juandiz/SCARMOV_1.0/docs/Imagenes/desarrollo/componentes/fsr.jpg

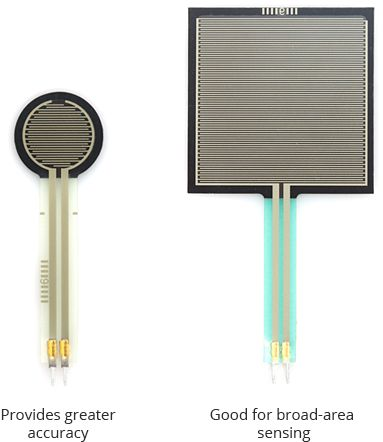
docs/Imagenes/desarrollo/componentes/fsr.jpg
