juandiz/SCARMOV_1.0/code/ArduinoControl_TFG/README.md

# SCARMOV
 Código del robot SCARA

 Este codigo ha sido redactado por: Juan Manuel Astorga Diz
 Es una adaptación a la plataforma de arduino del codigo escrito
 para un TFG anterior.

 La finalidad de este código es la de ser capaz de controlar el 
 robot SCARA a través de un socket que recibe paqueted UDP desde una GUI
 cliente que realiza los comandos de control con un paqute JSON.
