juandiz/SCARMOV_1.0/docs/Referencies/DC brushles motors.docx

DC brushles motors

https://www.youtube.com/watch?v=gNpoTPzEkco
