juandiz/SCARMOV_1.0/docs/Referencies/modelado.pdf

## Modelado de un motorDC

Félix Monasterio-Huelin & Alvaro Gutiérrez ´

29 de enero de 2021

## Índice

Índice | 1
Índice de Figuras | 2
1. Introduccion | 3
2. Modelado analítico de un motor DC | 3
2.2. Simplificación de las ecuaciones del Motor DC por el método de eliminación de la
2.3. Simplificación de las ecuaciones del Motor DC por el método de eliminación del polo
3. Modelado experimental de un motor DC | 9
3.2. Algoritmo para la obtención experimental del modelo simplificado (K, p) del motor . | 11
3.2.1. Primera Fase: Obtención del valor medio de velocidades angulares del régi-
3.2.4. Cuarta Fase: Identificación de la función no lineal del modelo del motor
3.4. Ejemplo de diseño de un controlador no lineal de posición angular de un motor DC
A. Etapa de potencia | 31
B. Tipos de PWM | 33
C. Modelo CVS de fricción de un motor DC | 36
D. Modelo de carga de un motor DC de un grado de libertad | 38
E. Obtención analítica del polo del motor con una entrada escalón bajo condiciones
iniciales nulas | 40
F. Obtención analítica del polo del motor con una entrada nula bajo condiciones iniciales
no nulas | 41
G. Obtención analítica del polo del motor con una señal de entrada cuadrada | 43

H. Discretización del polo del motor obtenido con una entrada escalón bajo condiciones
iniciales nulas | | 44
I. Discretización del polo del motor obtenido con una entrada nula bajo condiciones
iniciales no nulas | | 45
J. Discretización del polo del motor obtenido con una señal de entrada cuadrada | 46

## Índice de Figuras

2.1. MotorDC | | 3
2.2. Eje, Reductora y Carga del MotorDC | | 3
3.1. Esquema general para el modelado de un motor DC | | 9
3.2. Modelo no lineal de un motor DC | | 10
3.3. Sistema de control realimentado no lineal con controlador P-D | | 10
3.4. Modelo no lineal de motor DC | | 11
3.5. Número de pulsos en el eje de un motor DC real | | 11
3.6. Velocidad angular en el eje de un motor DC real | | 12
3.7. Velocidad angular en el eje de un motor DC real | | 20
3.8. Varianza y polo medio pSj en cada intervalo de tiempo | | 20
3.9. Valores de p y K obtenidos en las tres primeras fases | | 21
3.10. Respuestas del motor (explicación en el texto) | | 22
3.11. Polinomio de interpolación impar de grado (a) 17 y (b) 23 | | 22
3.12. Sistema de control realimentado no lineal con controlador proporcional | | | 23
3.13. Polinomio de interpolación (a) f

−1
y (b) f

−1
extendido | | 25
A.1. Puente en H | | 31
A.2. Zona Z
+ | 31
A.3. Zona Z
− | | 32
B.1. Ejemplo de señal PWM unipolar ideal | | 33
B.2. Ejemplo de señal PWM unipolar ideal | | 34
B.3. Ejemplo de señal PWM bipolar ideal | | 34
B.4. Secuencia lógica del puente en H con PWM bipolar ideal | | 35
C.1. Par de fricción dado por C.5 en función de ˙θm | | 36

## 1. Introduccion

El objetivo principal de este documento es obtener un modelo de un motor de corriente continua (motor DC) que sea útil para realizar el diseño e implementación de un sistema de control realimentado.
En la Sección 2 se describe el procedimiento para modelar un motor DC mediante las especificaciones del fabricante, en el caso en el que estén disponibles. Se estudian las ecuaciones electromecánicas de un motor DC hasta la obtención de su función de transferencia y su simplificación a un sistema dinámico de primer orden, y orden relativo la unidad. Al finalizar la sección, se mostrará un ejemplo de modelado de un motor DC comercial, a partir de las características que ofrece el fabricante.
En la Sección 3 se describe un procedimiento de modelado experimental de un motor DC, ya sea porque el fabricante no proporciona las especificaciones del motor, o porque se requiera comprobar el modelado analítico con respecto al funcionamiento en el laboratorio.
En el Apéndice A se hace una introducción a una etapa de potencia, basada en la técnica de Modulación de Anchura de Pulso (PWM, de sus siglas en inglés) (ver Apéndice B), necesaria para acondicionar la señal de control obtenida con un controlador digital a la señal de entrada física del motor DC.

## 2. Modelado analítico de un motor DC

### 2.1. Motor DC

En las Figuras 2.1 y 2.2 se representan esquemáticamente un motor DC, la Reductora y la Carga del motor.

Rm | Lm

Jm

Bm

um(t) | i(t) | eb(t)

θṁ(t)

τm(t)

Figura 2.1: MotorDC

Jm | Bm

r, η
JL
mL
τm | θṁ | τl

τL

θ˙L

Figura 2.2: Eje, Reductora y Carga del MotorDC

La ecuación eléctrica del motor tiene la forma,

um(t) = Rmi(t) + Lm

di(t)
dt + eb(t) | (2.1)

donde um(t) representa la tensión de entrada al motor, i(t) la corriente eléctrica del motor, eb(t) la fuerza contraelectromotriz, Rm la resistencia terminal y Lm la inductancia del rotor.
La ecuación mecánica del motor es

τm(t) = Jm

¨θm(t) + τl(t) + τf (t) | (2.2)

donde τm(t) representa el par motor, ¨θm(t) la aceleración angular del motor, Jm la inercia del rotor, τl(t) el par de la carga visto desde el eje del motor y τf (t) el par de fricción.
En el Apéndice C se presenta un modelo de fricción, que nos permite escribir la ecuación mecánica en la forma
τm(t) = Jm

¨θm(t) + Bm

˙θm(t) + τc(t) | (2.3)

donde ˙θm(t) es la velocidad angular del motor, Bm

˙θm(t) el par de fricción viscosa con Bm la constante de fricción viscosa (damping viscous constant),y τc(t) el par que incorpora la carga y la fricción, a excepción del par de fricción viscosa.
En lo que sigue consideraremos un motor DC que satisface las siguientes relaciones de acoplo electromecánico:

eb = kb

˙θm(t) | (2.4a)
τm = kmi(t) | (2.4b)

donde kb y km son constantes del motor, constante de la fuerza contraelectromotriz (back-EMF constant) y constante de par (torque constant) respectivamente. Cuando se expresan en el mismo sistema de unidades, kb = km.
Con estas ecuaciones y relaciones pueden obtenerse diversas funciones de transferencia del motor sin carga. Las más importantes son las que relacionan la velocidad angular ˙θm(t), la posición angular θm(t) y la corriente eléctrica i(t) con la tensión de entrada um(t). Las escribiremos como GΘ˙ m (s),
GΘm(s) y GI (s) respectivamente.
Para ello consideraremos las ecuaciones que solo incorporen la fricción viscosa,

um(t) = Rmi(t) + Lm

di(t)
dt + kb
˙θm(t) | (2.5a)

kmi(t) = Jm

¨θm(t) + Bm

˙θm(t) | (2.5b)

Puesto que ˙θm(t) = dθm(t) dt se cumple, bajo condiciones iniciales nulas, que

GΘ˙ m

(s) = sGΘm(s) | (2.6)

Aplicando la transformada de Laplace a las ecuaciones del motor bajo condiciones iniciales nulas, y eliminando la variable de la corriente eléctrica I(s) se obtiene la función de transferencia del motor:

GΘ˙ m

(s) = | km (Jms + Bm)(Lms + Rm) + kbkm
(2.7)

Se define la constante de velocidad del motor kn como la ganancia a bajas frecuencias del motor. Utilizando la expresión 2.8,

kn = GΘ˙ m

(0) = | km
BmRm + kbkm

(2.8)

No obstante, es habitual definir kn despreciando la constante de fricción viscosa, es decir, mediante

la relación kn =

1
kb

Para obtener GI (s) puede hacerse lo siguiente. Primero aplicar la Transformada de Laplace, bajo condiciones iniciales nulas, a la ecuación mecánica dada por 2.5b,

kmI(s) = (Jms + Bm)

˙θm(s) | (2.9)

donde ˙θm(s) = L−

{
˙θm(t)

}

Como ˙θm(s) = GΘ˙ m
(s)Um(s) e I(s) = GI (s)Um(s), se obtiene que
GI (s) = | Jms + Bm
(Jms + Bm)(Lms + Rm) + kbkm

(2.10)

A la corriente en régimen permanente, cuando la entrada al motor carga es la tensión nominal um(t) = UN (nominal voltage), se la denomina corriente del motor sin carga I0 (no-load current). Esta puede obtenerse aplicando el teorema del valor final a I(s) = GI (s)Um(s),

I0 = lim
s→0

sGI (s)

UN
s

= UN GI (0) = BmUN
BmRm + kbkm

(2.11)

Hay que tener en cuenta que se han despreciado todos los pares de fricción a excepción de la fricción viscosa, por lo que relación 2.11 es una expresión aproximada de I0.
Podemos comprobar que se cumple que

kmI0 = Bm

˙θmN | (2.12)

donde ˙θmN es la velocidad angular nominal del motor sin carga (no-load speed), que, normalmente, se escribe como n0. Este valor puede obtenerse aplicando el teorema del valor final a GΘ˙ m

(s)
dado por 2.8, cuando la entrada es la tensión nominal um(t) = UN ,

˙θmN = lim
s→0

sGΘ˙ m

(s)

UN
s

= UN GΘ˙ m

(0) = kmUN
BmRm + kbkm

(2.13)

Se denomina constante de tiempo eléctrica te (cuya unidad en el sistema internacional es de segundos s), a la siguiente relación:

te =

Lm
Rm

(2.14)

Esta relación se obtiene de eliminar el acoplo mecánico (kb = 0) en la ecuación eléctrica del motor dada por 2.5a. Entonces GI (s) dado por 2.10 tiene la forma 1
Lms + Rm

cuyo polo es −1/te.

Se denomina constante de tiempo mecánica tm, a la constante de tiempo obtenida suponiendo que la constante de tiempo eléctrica es despreciable, es decir, haciendo Lm = 0. Más adelante, en la subsección 2.2, se demuestra que queda definida por la siguiente expresión:

tm =

RmJm
RmBm + kbkm

(2.15)

Puede comprobarse que la función de transferencia de velocidad angular dada por 2.8 tiene dos polos reales (cuyas unidades en el sistema internacional son s

−1
) dados por la relación siguiente:

p1,2 = −

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
kmkb
JmLm

(2.16)

donde t

′
m =

Jm
Bm

, que algunos autores también denominan constante de tiempo mecánica, puesto que

se obtiene eliminando el acoplo eléctrico en las ecuaciones del motor. En este escrito se utilizará la definición dada por la relación 2.15 ya que es la que suelen utilizar los fabricantes.
Podemos entonces escribir la función de transferencia en la forma

GΘ˙ m

(s) = | K′ m
(s − p1)(s − p2)

(2.17)

donde p1 y p2 son los polos dados por la relación 2.16, y

K′ m = | km JmLm
(2.18)

Normalmente los motores DC cumplen que te ≪ tm, además de que p1 ≪ p2. Estos hechos sugieren dos métodos distintos de simplificación de las ecuaciones del motor: eliminar la constante de tiempo eléctrica te (dando lugar a la definición de constante de tiempo mecánica) (subsección 2.2) o eliminar el polo no dominante p1 (subsección 2.3). Los resultados serán distintos, aunque similares, pero ambos métodos reducen el orden de las funciones de transferencia del motor a la forma:

GΘ˙ m

(s) = K
s + p

(2.19)

donde K y p son constantes.
La ecuación diferencial simplificada que representa al motor será por lo tanto de segundo orden en θ(t) y de primer orden en ˙θ(t),

¨θm(t) + p

˙θm(t) = Kum(t) | (2.20)

Las constantes de tiempo eléctrica y mecánica definidas anteriormente son, aproximadamente la inversa de los polos exactos: te ≈ 1/|p1| y tm ≈ 1/|p2|, siendo p2 el polo dominante.
Por otro lado, siempre que se hace alguna simplificación de los modelos matemáticos debe impo-nerse la restricción de que la ganancia a bajas frecuencias coincida con la del modelo no simplificado, lo que permite calcular el parámetro K de la expresión 2.19.
Aplicando la transformada de Laplace inversa a la anterior función de transferencia 2.19, teniendo en cuenta condiciones iniciales nulas y una entrada escalón de amplitud A se obtiene la salida de velocidad angular del motor:
˙θm(t) = AK
p

(
1 − e

−pt)
, t ≥ 0 | (2.21)

Si las condiciones iniciales no son nulas sino [

˙θ(0−)], entonces para una entrada escalón de amplitud A,
˙θm(t) = AK
p

(
1 − e

−pt)
+ ˙θ(0−)e
−pt, t ≥ 0 | (2.22)

Si la entrada al motor es nula y las condiciones iniciales no son nulas se obtiene una salida que decae con el tiempo según la ecuación

˙θm(t) = ˙θ(0−)e

−pt, t ≥ 0 | (2.23)

La relación 2.23 permite obtener experimentalmente el polo dominante del motor. Y con este valor, puede obtenerse K experimentalmente a partir de la ecuación 2.21 o 2.22 si se conocen las condiciones iniciales.

### 2.2. Simplificación de las ecuaciones del Motor DC por el método de eliminación

de la constante eléctrica del motor

Las ecuaciones del motor DC pueden simplificarse teniendo en cuenta que la constante eléctrica del motor es mucho menor que la constante mecánica, lo que se traduce en despreciar el factor de la inductancia Lm en la ecuación eléctrica.
Siguiendo este método de simplificación la ecuación eléctrica dada por 2.5a quedaría en la forma:

um(t) = Rmi(t) + kb

˙θm(t) | (2.24)

Despejando la corriente eléctrica i(t) de la ecuación mecánica 2.5b y substituyendo en la ecuación anterior 2.24, se tiene

um(t) = RmJm
km

¨θm(t) + (
RmBm
km

+ kb

)
˙θm(t) | (2.25)

La ecuación del motor simplificada dada por 2.25 representa una ecuación diferencial de primer orden para la variable de velocidad angular y de segundo orden para la variable de posición angular. Aplicando la transformada de Laplace a esta ecuación se obtiene la función de transferencia de velocidad angular en relación a la entrada del motor:

GΘ˙ m

(s) = Θ˙ m(s)

Um(s)

=

km
RmJms + RmBm + kbkm

(2.26)

Podemos escribir la función de transferencia de velocidad angular en la forma siguiente:

GΘ˙ m

(s) = Km
s + pm

(2.27)

La ganancia a bajas frecuencias del motor es:

GΘ˙ m

(0) = | km RmBm + kbkm
(2.28)

Puede comprobarse que esta constante coincide con la del motor sin simplificar. Puede verse también que

Km = pmGΘ˙ m

(0) (2.29)

La función de transferencia del motor, simplificada por este método, tiene un polo de valor

s = −pm = −

RmBm + kbkm
| RmJm

= −

1
tm

(2.30)

donde tm es, por definición, la constante de tiempo mecánica.

### 2.3. Simplificación de las ecuaciones del Motor DC por el método de eliminación

del polo no dominante

La función de transferencia de velocidad angular del motor puede expresarse en la forma siguiente:

GΘ˙ m

(s) = | K′ m
(s + |p1|)(s + |p2|)

(2.31)

donde p1 y p2 son los polos dados por la relación 2.16. La ganancia a bajas frecuencias del motor es,

GΘ˙ m

(0) = K′
m
p1p2

(2.32)

Normalmente p1 ≪ p2 por lo que puede simplificarse el modelo matemático despreciando el polo no dominante. Siguiendo este método, la anterior función de transferencia quedará en la forma

GΘ˙ m

(s) = Km s + |p2|
(2.33)

Puesto que se debe cumplir la restricción de ganancia a bajas frecuencias,

Km = |p2|GΘ˙ m

(0) = K′
m
|p1|

(2.34)

Teniendo en cuenta la relación 2.18 se cumple que,
Km = | km
JmLm|p1|

(2.35)

El polo de la función de transferencia de velocidad angular simplificada por este método será, por diseño, el polo dominante −p2.

### 2.4. Estimación del coeficiente de fricción viscosa Bm

Los fabricantes no suelen dar la constante de fricción viscosa Bm, pero sí otras características que permiten estimarla.
Esto puede hacerse de dos formas, según se disponga de una u otra información,
1. Utilizando la ecuación de la constante de tiempo mecánica, tm, dada por 2.15,

Bm =

Jm
tm

−

| kbkm
Rm

(2.36)

2. Utilizando la ecuación de la corriente del motor sin carga, I0, dada por 2.12,
Bm = | kmI0 ˙θmN
(2.37)

Ambos métodos son aproximados, ya que en el estudio teórico solo se ha tenido en cuenta, del par de fricción, la fricción viscosa.

### 2.5. Ejemplo de modelado analítico de un motor DC

La Tabla 2.1 recoge las características de un motor comercial¹

Parámetro | Valor | Unidades
UN | 12 | V
Rm | 5, 3 | Ω
Lm | 580 | µH
Jm | 14 | g cm²
tm | 15 | ms
kb | 2, 3 | mV /rpm
km | 22 | mNm/A
I0 | 0,05 | A
n0 | 5100 | rpm

Tabla 2.1: Características del fabricante.

Con esta información puede calcularse la constante eléctrica del motor te utilizando la relación 2.14, obteniendo te = 109, 43µs. Como vemos te ≪ tm .
Será necesario expresar todos estos parámetros en las mismas unidades. Utilizaremos el SI de unidades como se muestra en la Tabla 2.2.
Parámetro | Valor | Unidades
Rm | 5, 3 | Ω
Lm | 5, 8 × 10−4 | H
Jm | 1, 4 × 10−6 | kg m²
tm | 1, 5 × 10−2 | s
te | 1, 1 × 10−4 | s
kb | 2, 2 × 10−2 | V s/rad
km | 2, 2 × 10−2 | Nm/A
I0 | 0,05 | A
n0 | 534,071 | rad/s

Tabla 2.2: Características de un motor DC en el Sistema Internacional de unidades.

Podemos observar que las constantes del par y de la fuerza contraelectromotriz coinciden, km = kb, cuando se expresan en el mismo sistema de unidades.
Puede ahora estimarse el coeficiente de fricción viscosa, Bm, con cualquiera de los métodos descritos en la Sección 2.4. Con el método de la constante de tiempo mecánica se obtiene el valor Bm = 2, 01×10−6 Nms, y con el método de la corriente del motor sin carga Bm = 2,06×10−6Nms. Puede comprobarse con las expresión 2.16, que los polos del motor, utilizando el valor de Bm obtenido por el método de la corriente del motor sin carga, son

p1 = −9025
p2 = −67, 53

El polo dominante es p2 que además cumple que |p2| ≪ |p1|.
Calculando Km con la expresión dada por 2.18, el modelo del motor con los dos polos tiene la forma

GΘ˙ m

(s) = | 27093596, 06
(s + 9025)(s + 67, 53) | (2.38)

Utilizando el método de simplificación de eliminación de la constante eléctrica del motor, se obtiene pm = −66, 67 utilizando la expresión 1/tm dada en 2.30.

1Se trata del motor 2842 − 012C de Minimotor.

Ambos modelos simplificados deberán cumplir la condición de que la ganancia a bajas frecuencias sea la misma. En ambos casos se obtendrá un modelo de la forma

GΘ˙ m

(s) = Km
s + pm

(2.39)

1. Modelo simplificado del motor por el método de eliminación de la constante de tiempo eléctrica.

GΘ˙ m

(s) = 2963, 8
s + 66, 67

(2.40)

2. Modelo simplificado del motor por el método de eliminación del polo no dominante.

GΘ˙ m

(s) = 3002, 1
s + 67, 53

(2.41)

## 3. Modelado experimental de un motor DC

### 3.1. Introducción al modelado experimental de un motor DC

Los motores DC suelen tener un comportamiento lineal en un rango predefinido de tensiones de entrada. Sin embargo, a bajas velocidades angulares la fricción produce no linealidades, además de que el motor sufre perturbaciones a su entrada y ruido a su salida, normalmente debidas, las primeras al efecto de la carga y la segunda al ruido en la medida de los sensores. También sufre el motor variaciones no lineales cuando se utiliza de forma continua, debido a efectos térmicos produciendo variaciones en la resistencia de la bobina. A tensiones elevadas puede haber una desmagnetización del hierro, lo que supone variaciones en las constantes del motor.
Por otro lado, si se realiza un control digital aparecen errores debidos a la longitud de palabra finita, es decir, errores en los conversores A/D (sensor de posición angular, por ejemplo) y errores numéricos en el cálculo de las señales de control. Además, la conversión D/A de la señal de control y de la señal continua de entrada al motor nunca puede ser una reconstrucción exacta de una señal muestreada, ya que requeriría un filtro paso bajo ideal, el cual no es realizable físicamente. Y por último, la etapa de potencia, es decir, la electrónica que acondiciona la señal de baja potencia de un microcontrolador a la potencia eléctrica del motor, suele añadir ruido a su salida. Si se utiliza como etapa de potencia un puente en H para la generación de una señal PWM puede ocurrir que la tensión de referencia no sea suficientemente estable, debido al conversor AC/DC. Como consecuencia,la tensión de entrada al motor no sería la deseada, sino que estaría afectada por un ruido difícil de modelar.
µC | D/A | ZOH | PWM | Motor DC | Encoder
V (t) | θṁ(t) | Nm(tk)

Figura 3.1: Esquema general para el modelado de un motor DC

Todos estos factores hacen difícil un modelado exacto de un motor DC. En lo que sigue llamaremos modelado del motor a lo que realmente sería un modelado del motor que incluya toda la electrónica que será utilizada en un sistema de control realimentado. En la Figura 3.1 se muestra un esquema de bloques con los elementos fundamentales de actuación de un motor DC. En ella, Nm(tk) representa el número de pulsos medido en el instante de tiempo tk en el eje del motor, que permitiría obtener la posición angular en radianes,

θm(tk) = 2πNm(tk)
q

(3.1)

donde q es el número de pulsos por vuelta (CPR, Cycles Per Revolution) del encoder incremental.

En esta sección se simplifica enormemente el problema de modelado. En primer lugar, se im-pondrá que el modelo matemático deseado se corresponda con el de un sistema lineal de primer orden en velocidad angular, de tal manera que el objetivo se reduzca a estimar dos parámetros del motor, K y p, donde K/p sea la ganancia a bajas frecuencias y p represente el único polo de un sistema de primer orden.
Para ello se harán medidas experimentales de la salida del motor Nj , para diferentes tensiones de entrada Vj , y en dos situaciones distintas: bajo condiciones iniciales nulas y bajo condiciones iniciales no nulas. La primera de ellas utilizando una señal de entrada escalón y la segunda con una señal nula a la entrada.
En los Apéndices E y F se realiza un estudio teórico para ambas situaciones y en los Apéndices H y I, se obtiene una discretización aproximada del polo, suponiendo que las señales de entrada al motor se generan mediante un microcontrolador y que la salida de posición angular se mide con un encoder incremental situado en el eje del motor. Estos estudios tienen como finalidad obtener expresiones del polo p reduciendo al mínimo los errores numéricos debidos a la longitud de palabra finita de un microcontrolador.
En la Sección 3.2 se propone un algoritmo de modelado sencillo, que da lugar al modelo lineal deseado junto con un elemento no lineal de ajuste de la señal de entrada. Este elemento no lineal puede no estar presente en el resultado del modelado si el motor se comporta de manera suficientemente lineal. Pero esto no siempre es así, como se verá en la Sección 3.3 con un ejemplo sobre un motor real.

f

K
s + p
V (t) | Veq(t) | θṁ(t)

Figura 3.2: Modelo no lineal de un motor DC

En la Figura 3.2 se muestra el esquema de bloques del modelo no lineal, donde V (t) representa la señal de entrada al motor, y Veq(t) la señal de entrada a la parte lineal del motor, de tal manera que Veq(t) = f(V (t)) siendo f la función no lineal resultante del modelado. En el algoritmo que se propone se identifica esta función no lineal f como un polinomio en V (t) realizando una interpolación polinómica de las medidas experimentales realizadas.
La idea del algoritmo de modelado es que permita diseñar controladores lineales suponiendo que el motor es lineal, y que se comporta como un sistema de primer orden en velocidad angular. Una vez hecho el diseño del controlador lineal, se implementaría introduciendo la corrección no lineal de la señal de control generada por el controlador.

+

⁻ | KP | f⁻¹ | f

K
s(s + p)
r(t) | e(t) | u(t) | ue(t) | u(t) | y(t)

Figura 3.3: Sistema de control realimentado no lineal con controlador P-D

En la Figura 3.3 se muestra un sistema de control realimentado no lineal con un controlador P-D de posición angular del motor (y(t) = θm(t)). La parte no lineal del controlador es la inversa de la parte no lineal del motor de tal manera que, si la cancelación es exacta, el motor se comporte como si fuese lineal. O dicho de otra forma, se ha linealizado el motor mediante la función inversa de la no linealidad del motor. En la Sección 3.4 se explica cómo obtener f

−1
, que satisfaga que
ue(t) = f

−1
(u(t)), y donde u(t) = Veq(t) y ue(t) = V (t), de acuerdo con la notación de la Figura 3.2.

### 3.2. Algoritmo para la obtención experimental del modelo simplificado (K, p) del

motor

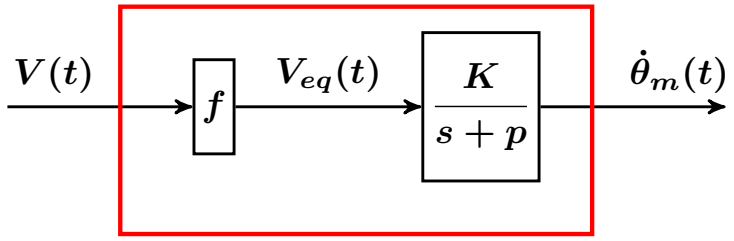
[picture p29: figure]
Veq(t)

Figura 3.4: Modelo no lineal de motor DC

Se propone, en esta Sección, un algoritmo para la obtención experimental del modelo simplificado de un motor. El objetivo es obtener los parámetros únicos (p, K) de la parte lineal del modelo, y la función no lineal f, como se muestra en la Figura 3.4.
En primer lugar, debe realizarse un conjunto de P ∗ Q experimentos: P repeticiones de Q experimentos con valores de entrada un escalón de diferente amplitud.
Las P repeticiones pueden realizarse como un único experimento con una señal de entrada cuadrada periódica, con un periodo cuya duración sea suficientemente larga como para que se haya alcanzado la velocidad angular de régimen permanente.

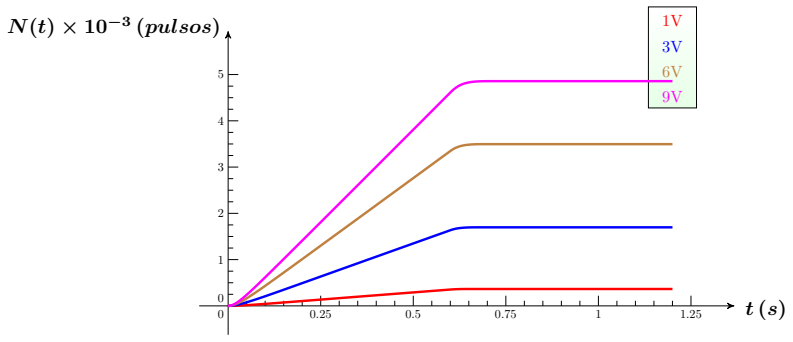
[picture p30: figure]
(pulsos)

Figura 3.5: Número de pulsos en el eje de un motor DC real

Lo primero que puede hacerse es obtener una única respuesta al escalón de amplitud Vj con j = 1, 2, · · · , Q, promediando, en cada instante de tiempo, las P repeticiones para cada Vj . De esta manera se realizaría un primer filtrado paso bajo de la respuesta del motor a una entrada cuadrada, suavizando el comportamiento del motor. Para poder hacer este promedio temporal se está suponiendo que todos los experimentos se han realizado con un periodo de muestreo idéntico. En la Figura 3.5 se muestran las curvas del número de pulsos Nj (t) promediadas de un motor DC real de P = 10 repeticiones, para cuatro valores distintos de tensión de entrada expresados en voltios, V ∈ {1, 3, 6, 9}, obtenidos con un encoder cuya resolución es q = 12, es decir, que tiene una precisión de ±30o
, y con un periodo de muestreo T = 1ms. La señal cuadrada está formada por un escalón de amplitud Vj y de duración 0,6s, y una bajada de duración 0,6s que comienza tras finalizar el escalón de subida.

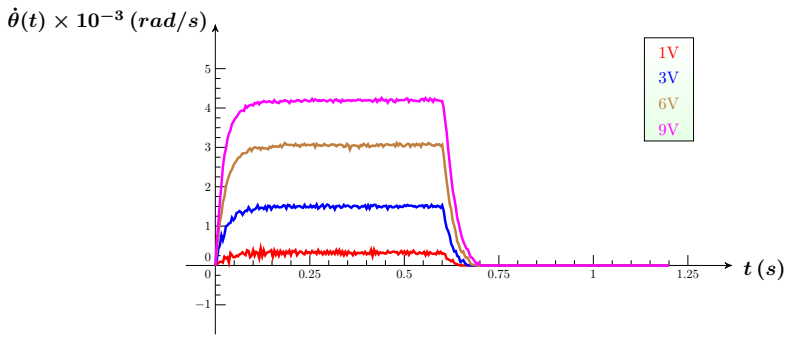
[picture p31: figure]
(rad/s)

Figura 3.6: Velocidad angular en el eje de un motor DC real

En la Figura 3.6 se muestran las curvas de velocidad angular ˙θj (t) promediadas de un motor DC real para los cuatro valores de tensión de entrada de la Figura 3.5. La velocidad angular se ha obtenido utilizando la primera aproximación de Euler de la derivada,

˙θj (tk) = 2π (Nj (tk) − Nj (tk−1)) qT

(3.2)

donde q es el número de pulsos por vuelta (CPR, Cycles Per Revolution) de un encoder incremental, T es el periodo de muestreo expresado en segundos, y Nj (tk) es el número de pulsos obtenidos con el encoder. Puesto que las condiciones iniciales de cada una de las P repeticiones han sido nulas, ˙θj (0) = 0.
Hecho esto, se tendrán Q ficheros de datos asociados a un conjunto de valores de entrada,
V ∈ {V1, V2, · · · , VQ} | (3.3)

El algoritmo que se propone consta de cuatro fases que se describen detalladamente en las siguientes subsecciones:

Primera Fase. Obtención del valor medio de velocidades angulares del régimen permanente.

En la Subsección 3.2.1 se calcula, con los datos experimentales, un conjunto de valores medios de velocidad angular,
{
˙θ1(∞),

˙θ2(∞), · · · ,

˙θQ(∞)

}
(3.4)

Segunda Fase. Cálculo del polo medio de varianza mínima.

En la Subsección 3.2.2 se calcula, con los datos experimentales, un conjunto de valores medios de los polos,
{p1, p2, · · · , pQ} | (3.5)

Tercera Fase. Cálculo de K y de la tensión de entrada equivalente.

En la Subsección 3.2.3 se calcula el conjunto de valores Kj a partir de los vectores 3.4 y 3.5,

{K1, K2, · · · , KQ} | (3.6)

Puesto que lo que interesa es obtener un modelo del motor cuya parte lineal tenga los parámetros (K, p) únicos, es necesario obtener la tensión de entrada equivalente que satisfaga las relaciones de proporcionalidad de la ganancia a bajas frecuencias,

˙θj (∞)

Veq,j

=

˙θk(∞)

Veq,k

(3.7)

para cualquier j, k ∈ {1, 2, · · · , Q}.

En la Figura 3.6 puede apreciarse a simple vista que la proporción entre velocidades angulares del régimen permanente y tensiones no es exacta. Esto significa que el motor DC no se comporta de manera lineal en cuanto a la ganancia a bajas frecuencias K/p.

Se obtendría en esta fase un vector de tensiones de entrada equivalentes,

{Veq,1, Veq,2, · · · , Veq,Q} | (3.8)

En la Subsección 3.2.3 se obtiene una expresión de K/p utilizando la técnica de optimización del error cuadrático, donde el error viene dado por ej = Veq,j − Vj . A partir de este valor se propone una fórmula para el cálculo del polo único p, y del valor único de K.

Cuarta Fase. Identificación de la función no lineal del modelo del motor mediante la técnica de interpolación polinómica.

En la Subsección 3.2.4 se obtiene la parte no lineal f del modelo del motor DC, de tal manera que tenga la siguiente forma polinómica,

Veq(t) = a1V (t) + a3V

3
(t) + · · · + a2Q−1V

2Q−1
(t) (3.9)
3.2.1. Primera Fase: Obtención del valor medio de velocidades angulares del régimen permanente

Sobre el experimento promedio se obtendría un valor medio de las últimas muestras de las que pueda garantizarse que el motor se encuentra en su régimen permanente.
Si se supone que la discretización del tiempo es uniforme, T, y el escalón del experimento promedio tuviese una duración Tf = (Nf − 1)T, se escogerían los valores de las últimas N muestras. Esta media sería ˙θ(∞),

˙θ(∞) =

∑

N

i=1

˙θNf −N+i

N

(3.10)

Por lo tanto, en esta Primera Fase deberá seleccionarse un valor de N adecuado.
Esto mismo se haría para los Q valores de la entrada escalón V ∈ {V1, V2, · · · , VQ}. Se obtendrá entonces, un conjunto de valores medios de velocidad angular,
{
˙θ1(∞),

˙θ2(∞), · · · ,

˙θQ(∞)

}
(3.11)

Si el motor se comportase linealmente, los valores ˙θj (∞), con j = 1, 2, · · · , Q, serían proporcio-nales, en el sentido de que
˙θj (∞)
˙θk(∞)

=

Vj
Vk

(3.12)

para cualquier j, k ∈ {1, 2, · · · , Q}.

### 3.2.2. Segunda Fase: Cálculo del polo medio de varianza mínima

Mientras que para el cálculo de ˙θ(∞) se utilizan los valores finales de respuesta del motor a una entrada escalón, para el cálculo del polo deberá estudiarse el comportamiento del motor en el régimen transitorio.

Esta fase se realiza para cada uno de los Q experimentos utilizando el valor ˙θj (∞) obtenido en la Primera Fase. De esta forma se obtiene un vector de Q polos,

{p1, p2, · · · , pQ} | (3.13)

La expresión del polo que puede utilizarse para el transitorio de subida de una señal cuadrada es la expresión dada por H.3 obtenida en el Apéndice H bajo condiciones iniciales nulas,

pSj (k) = Nj (k) − Nj (k − 1)

T

(
q

˙θj (∞)

2π

kT − Nj (k)

) | (3.14)

donde Nj (k) representa el número de pulsos medido en el instante de tiempo tk = kT en el eje del motor y q es el número de pulsos por vuelta (CPR, Cycles Per Revolution) del encoder incremental. El estudio de todo el régimen transitorio del tramo de subida conduciría a errores debido a que el comportamiento del motor a bajas velocidades está muy condicionado por los pares de fricción que no se están considerando en el modelo matemático. Por lo tanto, debe descubrirse el intervalo de tiempo que permita obtener un valor del polo que más se ajuste a los datos experimentales.
El método que se propone para el tramo de subida utilizando la expresión 3.14, es calcular el polo medio para un conjunto de intervalos de tiempo [tI , tF ], cuyo instante inicial tI y anchura tF − tI sean variables, y elegir el valor del polo medio cuya varianza sea la menor de las varianzas de cada intervalo seleccionado. De esta manera se obtendría pSj . Posteriormente se indica un método sencillo para la creación de los intervalos.
Por otro lado, la expresión del polo que puede utilizarse para el transitorio de bajada de una señal cuadrada es la dada por la expresión de valores extremos J.6 del Apéndice J,

pBj =

q

˙θj (∞)

2π
Nj (kf ) − Nj (k0)

(3.15)

donde kfT es cualquier instante de tiempo en el cual el motor se encuentra parado.
También puede utilizarse la expresión dada por I.2 obtenida en el Apéndice I bajo condiciones iniciales no nulas, aunque es más complicada que la de valores extremos. Sin embargo, la utilización de la expresión J.1 del Apéndice J es problemática, debido a que exige que ˙θj (∞)t0 = θ(∞), lo cual puede no ocurrir en un estudio experimental, dando lugar a errores innecesarios.
Una vez calculados pSj y pBj se obtendrá un único valor pj como una combinación lineal de los anteriores,
pj = α pSj + (1 − α)pBj | (3.16)

donde α ∈ [0, 1].

Creación de intervalos El método que se propone para el tramo de subida utilizando la expresión 3.14, es calcular el polo medio para un conjunto de intervalos de tiempo,

[tI , tF ] | (3.17)

cuyo instante inicial tI y anchura tF −tI sean variables, y elegir el valor del polo medio cuya varianza sea la menor de las varianzas de cada intervalo seleccionado.
Para que este método tenga sentido debe elegirse una anchura de intervalo mínima ∆t, es decir que tF ≥ tI + ∆t.
Una forma sencilla de crear los intervalos consiste en elegir cuatro valores, tI mínimo y máximo y tF mínimo y máximo. Es decir,
tI ∈ [tIm, tIM ] | (3.18a)
tF ∈ [tFm, tFM ] | (3.18b)

Si se supone que la discretización del tiempo es uniforme, el algoritmo puede programarse utilizando dos bucles para la creación del intervalo [tI , tF ], y otro bucle más para el cálculo del polo medio y de la varianza asociada a este intervalo. Conviene, en este caso, expresar los intervalos en función de un índice temporal tal que t = kT, entonces el intervalo será [kI , kF ].
Una posible selección de kFM puede ser asignándole el valor Nr = Nf −N utilizado en la Primera Fase para calcular ˙θ(∞). Puede reducirse el número de intervalos que se inspeccionarán si se hace la siguiente elección:
kIM = Nr − n∆k | (3.19a)
kFm = kI + ∆k | (3.19b)
kFM = kI + n∆k | (3.19c)

donde n es un número entero positivo y kI ∈ {kIm, kIm + 1, · · · , kIM }. El número de intervalos inspeccionados será

NInterv = ((n − 1)∆k + 1) (Nr − kIm − n∆k + 1) | (3.20)

Esta expresión se obtiene del siguiente razonamiento. El primer bucle, el de kI , tiene una longitud fija NI y el segundo bucle, el de kF , tiene una longitud fija NF dados por,

NI = kIM − kIm + 1 = Nr − kIm − n∆k + 1 | (3.21a)
NF = kFM − kFm + 1 = (n − 1)∆k + 1 | (3.21b)

Por lo tanto NInterv =

∑

NI

i=1

NF . Teniendo en cuenta que ∑

NI

i=1

1 = NI se obtiene la expresión 3.20.

Por otro lado, una vez concluido el proceso de optimización, se tendrá un vector de polos medios y varianzas para cada intervalo y se buscará el valor mínimo. Puede interesar conocer el intervalo óptimo o intervalo de varianza mínima. Si este intervalo ocupa la posición q-ésima en el vector de varianzas, el intervalo óptimo será [kI (q), kF (q)],

kI (q) = kIm + NI (q) − 1 | (3.22a)

kF (q) = kI (q) + ∆k − 2 + q −

NI∑

(q)−1

i=1

NF | (3.22b)

donde el valor de NI (q) debe cumplir la condición de que

NI∑

(q)−1

i=1

NF < q ≤

N

∑I (q)

i=1

NF | (3.23)

Puesto que

N

∑I (q)

i=1

NF = ((n − 1)∆k + 1) NI (q) y

NI∑

(q)−1

i=1

NF = ((n − 1)∆k + 1) (NI (q) − 1),

entonces

NI (q) − 1 <

q
(n − 1)∆k + 1
≤ NI (q) | (3.24)

Teniendo en cuenta que NI (q) debe ser un número entero positivo, se deberá cumplir que NI (q) = ⌈(
q

(n − 1)∆k + 1)⌉

(3.25)

donde ⌈x⌉ es la función techo de x, es decir, el primer número entero mayor o igual que x.

### 3.2.3. Tercera Fase: cálculo de K y de la tensión de entrada equivalente

El cálculo de K para cada experimento se realiza con la fórmula

Kj =

pj

˙θj (∞)

Vj

j ∈ {1, 2, · · · , Q} | (3.26)

obteniendo el vector
{K1, K2, · · · , KQ} | (3.27)

El problema que surge con (Kj , pj ) es que existiría un modelo de motor para cada entrada al motor.
El objetivo de esta fase es obtener un único modelo lineal junto con una corrección no lineal de la entrada al motor, de tal forma que se conserven las proporciones dadas por 3.12.
Para ello se selecciona, en primer lugar, un polo común a cualquier entrada al motor. Sea p este polo, entonces,

Kej =

p

˙θj (∞)

Vj

j ∈ {1, 2, · · · , Q} | (3.28)

Los valores de Kej serán, en general, distintos para cada j, obteniéndose un vector
{
Ke1, Ke2, · · · , KeQ

}
| (3.29)

A partir de este vector puede obtenerse un valor K común a todas las entradas. La consecuencia es que aparecerá una discrepancia en el valor de ˙θj (∞), si el comportamiento del motor no fuese suficientemente lineal,

˙θj (∞) ̸=

KVj
p
j ∈ {1, 2, · · · , Q} | (3.30)

Para corregir esta discrepancia es suficiente obtener una entrada equivalente de valor

Veq,j =

KejVj

K

j ∈ {1, 2, · · · , Q} | (3.31)

y por lo tanto un vector

{Veq,1, Veq,2, · · · , Veq,Q} | (3.32)

Entonces
˙θj (∞)

Veq,j

=

K
p
j ∈ {1, 2, · · · , Q} | (3.33)

Con esta nueva entrada Veq,j se conservarían las proporciones dadas por 3.12 para el mismo valor de p y K. Sustituyendo 3.26 y 3.28 en 3.31, Veq,j puede escribirse en la forma,

Veq,j =

KjVj
pj

p
K

(3.34)

Posteriormente se propone un método de optimización para el cálculo de K y p.
Con esta idea puede hacerse un diseño de controladores lineales suponiendo que el modelo del motor es (K, p). Y una vez implementado el controlador, la señal de control u(t) = Veq(t) generada por el controlador deberá ser corregida a la señal de entrada al motor ue(t) = V (t).
En la Cuarta Fase final del algoritmo se obtendrá una única función f tal que Veq(t) = f(V (t)) que satisfaga la condición de que Veq,j = f(Vj ) para todo j ∈ {1, 2, · · · , Q}. En la Sección 3.4, se detalla cómo obtener la relación no lineal u(t) versus ue(t). Concretamente, se obtiene la función inversa de f, es decir, ue(t) = f
(u(t)).

Propuesta para la estimación de los parámetros p y K del motor supuestos en la Tercera Fase En la Tercera Fase se ha supuesto la elección de p y K únicos, pero no se ha dicho cómo hacerlo. Un cálculo óptimo sería aquél para el cual las tensiones equivalentes Veq,j se encuentren lo más cerca posible de las tensiones Vj , ya que de esta forma la influencia de la parte no lineal sería mínima.
Por lo tanto, debe minimizarse el error ej = Veq,j − Vj para todo j ∈ {1, 2, · · · , Q},

ej =

KjVj
pj

p
K

− Vj =

(
Kj
pj

p
K

− 1

)
Vj | (3.35)

Este error será mínimo si es mínima la diferencia entre ganancias a bajas frecuencias.
Una solución a este problema de optimización consiste en minimizar el error cuadrático, definido como

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
(3.36)

Escribiremos ej en la forma siguiente,

ej = αj

p
K
− Vj | (3.37)

donde

αj =

KjVj
pj
= ˙θj (∞) | (3.38)

Derivando J con respecto a p/K, se obtiene

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
− Vj

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
αjVj | (3.39)

Igualando a cero esta derivada, despejando K/p y teniendo en cuenta que αj = ˙θj (∞), se obtiene la expresión,

K
p

=

∑

Q

j=1

(
˙θj (∞)

)2
∑

Q

j=1

˙θj (∞)Vj

=

∑

Q

j=1

˙θj (∞)Vj

Kj
pj
∑

Q

j=1

˙θj (∞)Vj

(3.40)

Se propone calcular 1/p suponiendo que el motor es lineal, es decir, haciendo Kj = K en la relación dada por 3.40, por lo que se obtiene la siguiente expresión:

1
p

=

∑

Q

j=1

˙θj (∞)Vj

1
pj
∑

Q

j=1

˙θj (∞)Vj

(3.41)

De esta manera K quedaría en la forma

K =

∑

Q

j=1

(
˙θj (∞)

)2
∑

Q

j=1

˙θj (∞)Vj

pj

=

∑

Q

j=1

˙θj (∞)Vj

pj

Kj
∑

Q

j=1

˙θj (∞)Vj

pj

(3.42)

que también se puede escribir como,

1
K

=

∑

Q

j=1

(
˙θj (∞)

)2 1

Kj
∑

Q

j=1

(
˙θj (∞)

)2

(3.43)

Como puede observarse, los valores de K o 1/K, 1/p y K/p son medias ponderadas de los vectores {Kj} o {1/Kj}, {1/pj} y {Kj/pj} respectivamente. El valor de K o de p puede obtenerse de cualquier otra forma a partir del vector {Kj} o {pj} respectivamente, dando resultados similares. No haremos aquí un estudio que permita optimizar esta selección de K o p.

3.2.4. Cuarta Fase: Identificación de la función no lineal del modelo del motor mediante la técnica de interpolación polinómica

La parte no lineal del modelo del motor será una función no lineal, f, tal que

Veq(t) = f(V (t)) | (3.44)

Aquí se propone que la función no lineal f sea un polinomio de grado N = 2Q,

f(x) = a1x + a2x

2 + · · · + aN x

N | (3.45)

donde ai con i = 1, 2, · · · , N, son N constantes del modelo que deben ser identificadas.
Si la no linealidad del motor es independiente del signo de su entrada, el polinomio f(x) será simétrico con respecto al origen, es decir, que f(−x) = −f(x). Este hecho permite reducir el grado del polinomio a N − 1, y el número de coeficientes a N/2, de tal manera que el polinomio tendría la forma,

f(x) = a1x + a3x

3 + a5x

5 + · · · + a2Q−1x | 2Q−1 (3.46)

Para la identificación de los parámetros constantes ai

, se utilizarán los Q experimentos realizados, de tal manera que se cumpla la relación dada por 3.33 para cada uno de ellos. Es decir, que f(Vj ) = Veq,j para todo j ∈ {1, 2, · · · , Q}, o lo que es lo mismo, se va a aplicar un método de interpolación polinómica. Por lo tanto se obtendrían Q ecuaciones lineales con N = 2Q incógnitas,

Veq,j = a1Vj + a2V

2
j + · · · + aN V
N j | (3.47)

Si se impone la condición de simetría, se tendrían otras Q ecuaciones lineales de la forma,

−Veq,j = −a1Vj + a2V

2
j − a3V

3
j + · · · − aN−1V

N−1
j | + aN V N
| j (3.48)

De esta manera, se tendrían 2Q ecuaciones lineales con 2Q incógnitas. Este sistema de ecuaciones lineales puede representarse en forma matricial, donde la matriz de la relación es una matriz de Vandermonde, por lo que es invertible.
No obstante, puede demostrarse que debido a la simetría en el origen, este sistema de ecuaciones lineales puede reducirse a otro de Q ecuaciones lineales con Q incógnitas, donde el polinomio resultante sería de grado 2Q − 1, con la forma dada por 3.46. La demostración es sencilla, ya que si se suman para cada j las ecuaciones 3.47 y 3.48, se obtendría un sistema de ecuaciones lineales de coeficientes pares igualados a cero, y puesto que los coeficientes ai deben ser únicos, la única solución posible es que sean nulos, es decir, a2 = a4 = · · · = a2Q = 0.
Ahora, restando las ecuaciones 3.47 y 3.48 y dividiendo por dos, se obtendría un sistema de Q ecuaciones lineales con Q incógnitas,

Veq,j = a1Vj + a3V

j + · · · + a2Q−1V

2Q−1 j | (3.49)

Este sistema de ecuaciones puede ser representado en forma matricial

Veq = Va | (3.50)

donde

Veq =

Veq,1

Veq,2

Veq,Q

(3.51a)

a =

a1
a3

a2Q−1

(3.51b)

V =

V1 V

3
1
- · · V

2Q−1
1
V2 V

3
2
- · · V

2Q−1
2
VQ V

3
Q · · · V

2Q−1
Q

(3.51c)

El vector de parámetros a se obtendría invirtiendo la matriz V,

a = V

−1Veq | (3.52)

Teniendo en cuenta la expresión de Veq,j dada por 3.31, se obtiene el valor de Kej ,

Kej = K

(
a1 + a3V

2
j + · · · + a2Q−1V

2Q−2
j

)
(3.53)

Esta expresión indica claramente que el valor de K del motor depende de la entrada Vj si el comportamiento del motor no es suficientemente lineal. Podemos definir, entonces, un valor de Keq(t), de la siguiente forma,

Keq(t) = K

(
a1 + a3V

2
(t) + · · · + a2Q−1V

2Q−2
(t)

)
(3.54)

cumpliéndose que
Veq(t) = Keq(t)
K
V (t) | (3.55)

El problema de utilizar esta técnica de interpolación es que se produce el llamado fenómeno de Runge, que consiste en que para valores elevados de Q el polinomio puede oscilar mucho entre puntos de datos consecutivos. En la práctica conviene evitar este problema utilizando otras técnicas de interpolación, como por ejemplo, obteniendo polinomios por partes (curvas “spline”).

### 3.3. Ejemplo de modelado experimental de un motor DC

En esta Sección se obtiene el modelo de un motor real aplicando el algoritmo detallado en la Sección 3.2.
Los experimentos realizados han consistido en la obtención del número de pulsos proporcionado por un encoder situado en el eje del motor de q = 12 pulsos/vuelta, cuando la entrada es una señal cuadrada periódica de P = 10 y Q = 9 experimentos. La duración del escalón de subida de tensión Vj con j = 1, · · · , Q, ha sido de 0,6s y la del escalón nulo también de 0,6s. El periodo de muestreo ha sido de T = 1ms.
Las tensiones de entrada Vj voltios han sido las siguientes:
V ∈ {1, 2, 3, 4, 5, 6, 7, 8, 9} | (3.56)

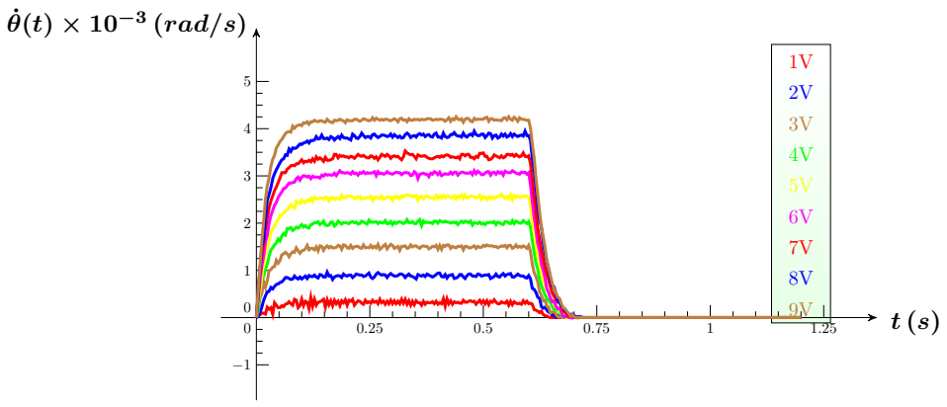
[picture p32: figure]
(rad/s)

Figura 3.7: Velocidad angular en el eje de un motor DC real

En primer lugar se ha obtenido el promedio temporal de los P experimentos, obteniendo Q ficheros de datos. En la Figura 3.7 se muestran las curvas de velocidad angular ˙θj (tk) con tk ∈ {0, 10−3

, · · · , 1200 × 10−3}, calculados a partir de los datos medidos promediados utilizando la expresión 3.2.
Para el cálculo de la velocidad angular en régimen permanente, ˙θj (∞) se ha aplicado la fórmula dada por 3.10, donde Nf = 601 y N = 200 que se corresponde con tf = 0,6s y tr = 0,4s (Nr = Nf − N = 401). Es decir, se ha calculado el valor medio de los últimos 0,2s del escalón. Para el cálculo de pSj en el transitorio de subida se ha utilizado la fórmula dada por 3.14 con intervalos variables, como se describe en la Subsección 3.2.2, con kIm = 2 (tIm = 0,001s), ∆k = 60 y n = 2. Se ha escogido el valor pSj del intervalo de varianza mínima.

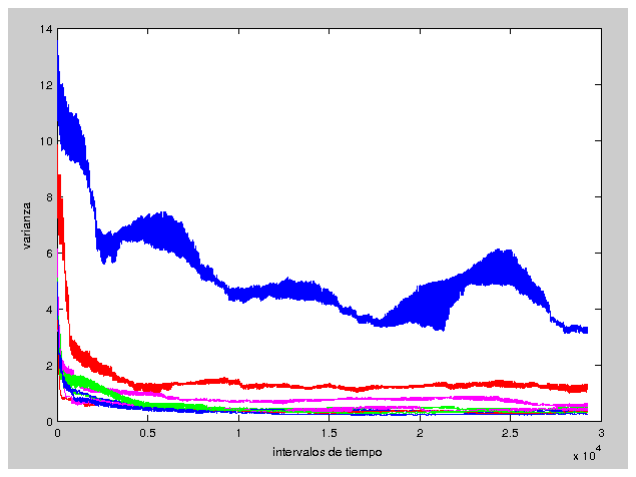
[picture p33: figure]
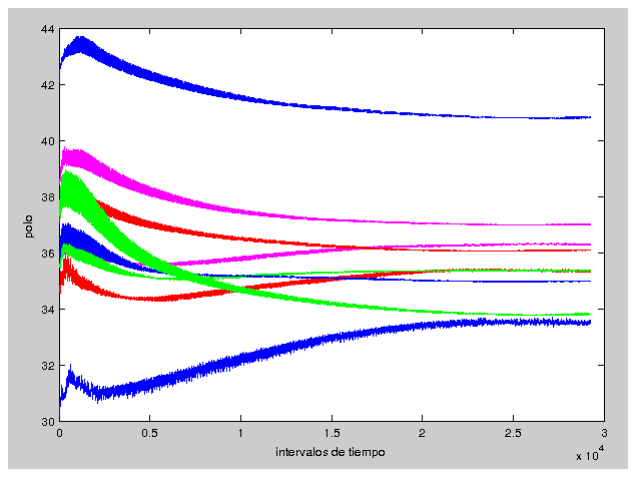
[picture p34: figure]

(a) Varianza | (b) Polo

Figura 3.8: Varianza y polo medio pSj en cada intervalo de tiempo

En la Figura 3.8 se representan las curvas de varianza y del polo medio en función del intervalo [kI , kF ] (eje de abcisas), donde la numeración de los intervalos se ha obtenido de manera consecutiva mediante dos bucles,

kIM=Nr-n*Deltak;
for kI=kIm:kIM
kFm=kI+Deltak;
kFM=kI+n*Deltak;
for kF=kFm:kFM
end

end

Las curvas de la Figura 3.8 pretenden ser simplemente indicativas por lo que no se ha puesto leyenda.
Para el cálculo de pBj en el transitorio de bajada se ha utilizado la fórmula dada por 3.15 donde kf = 1201 y k0 = 601.
Finalmente, se ha obtenido pj como una media de pSj y pBj , es decir, utilizando la fórmula 3.16 con α = 0,5.
A partir de este valor de pj se obtiene Kj aplicando la fórmula dada por 3.26.
Para el cálculo de p y K se ha seguido el método descrito en la Subsección 3.2.3, lo que permite también obtener la tensión equivalente V eqj utilizando la fórmula 3.34. El error cuadrático dado por 3.36 ha sido J = 0,2297. En la Tablas 3.1 y 3.2 y en la Figura 3.9 se muestran los valores obtenidos.
Vj | V eqj
1 | 0,66687
2 | 1,8264
3 | 3,0756
4 | 4,1367
5 | 5,2546
6 | 6,2972
7 | 7,015
8 | 7,9544
9 | 8,6279

Tabla 3.1: Valores de V eqj obtenidos en la tercera fase

p | 35,9154
K | 17461

Tabla 3.2: Valores de p y K obtenidos en la tercera fase

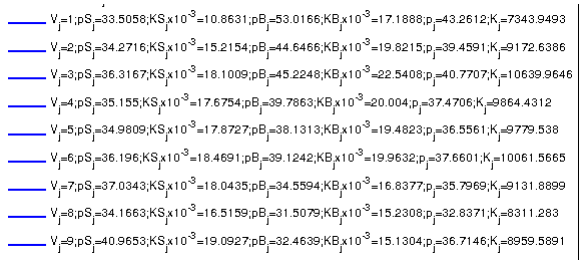
[picture p35: figure]

Figura 3.9: Valores de p y K obtenidos en las tres primeras fases

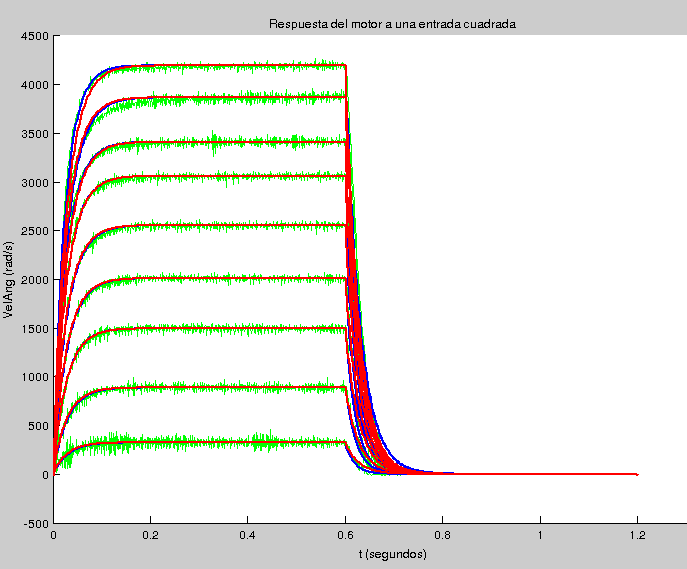
[picture p36: figure]

Figura 3.10: Respuestas del motor (explicación en el texto)

En la Figura 3.10 se representan en azul las respuestas de la parte lineal del motor a las señales de entrada cuadrada, donde se ha utilizado pSj para el escalón de subida, y pBj para el escalón de bajada. Las respuestas a las señales de entrada cuadrada con p = 35,9154 y K = 17461 se representan en color rojo. Todas ellas están superpuestas a las velocidades angulares medidas (color verde), que están representadas también en la Figura 3.7.

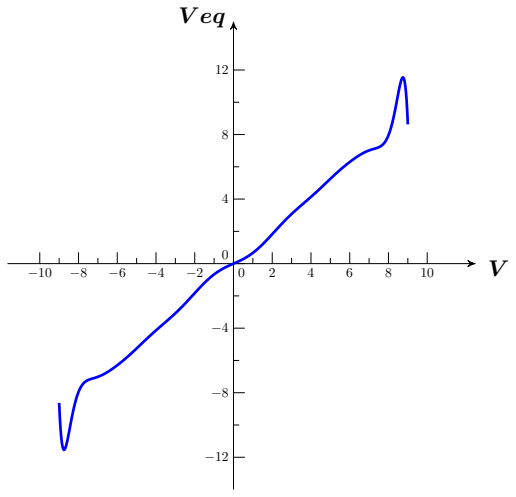
[picture p37: figure]
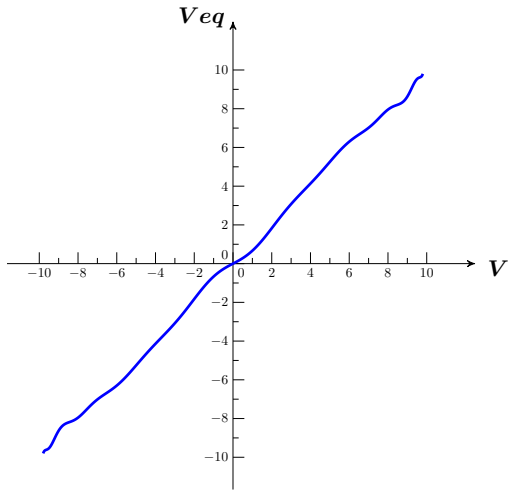
[picture p38: figure]

(a) (b)

Figura 3.11: Polinomio de interpolación impar de grado (a) 17 y (b) 23.

En la Figura 3.11a se muestra la curva de interpolación polinómica Veq-V siguiendo el método explicado en la Subsección 3.2.4, obteniendo los valores de los coeficientes del polinomio impar de grado 2Q − 1 siguientes,

a =

a1
a3

a2Q−1

= 10−20

52597393240172765184,000000 16027040554921168896,000000 −2073926822836621056,000000 142493094320705376,000000
−5684644001475050,000000
136226263708353,671875
−1933315989656,758789
14934202272,293077
−48181879,170126

(3.57)

En la Ecuación 3.57 los coeficientes del polinomio están multiplicados por 10²⁰ porque la precisión de estos valores es muy importante para evitar errores numéricos en la interpolación.
Puede apreciarse que para valores entre 8 y 9 voltios la curva oscila excesivamente. Para suavizar el polinomio se ha hecho un estudio empírico, que consiste en añadir puntos Vj > 9 que satisfagan la condición de que Vj = V eqj . De esta manera la función de error cuadrático J de la tercera fase no se ve alterada, permitiendo mantener los mismos valores de p y K obtenidos en la tercera fase. En la Figura 3.11b se muestra la curva de interpolación extendida, añadiendo los puntos {9,4; 9,6; 9,8}, cuyos coeficientes son

a =

a1
a3

a2Q′−1

= 10−20

52350607024243171328,000000 16410636174885726208,000000 −2238536983581650944,000000 173117348095936288,000000
−8670950267083310,000000
304718139112955,312500
−7736148426674,490234
139933770581,362793
−1731851185,361269
13761981,282901
−62750,253940
124,193751

(3.58)

donde Q′ = Q + 3.

### 3.4. Ejemplo de diseño de un controlador no lineal de posición angular de un motor

DC mediante linealización por inversión de la entrada equivalente

En esta Sección se explica una técnica de cómo se puede abordar el diseño de un controlador cuando se conoce el modelo no lineal del sistema que se quiere controlar. La idea es invertir la parte no lineal del modelo, como se muestra en la Figura 3.12 para el ejemplo del motor modelado en la Sección 3.3.

+− | KP | f⁻¹ | f

K
s(s + p)
r(t) | e(t) | u(t) | ue(t) | u(t) | y(t)

Figura 3.12: Sistema de control realimentado no lineal con controlador proporcional

Para el cálculo de f

−1
se seguirá el mismo procedimiento que el seguido en la Cuarta Fase del algoritmo de modelado de la Sección 3.2, es decir, se hará una interpolación polinómica con los datos experimentales. La única diferencia es que ahora la entrada debe ser Veq,j y la salida debe ser Vj . Con los datos experimentales se tendrá un sistema de Q ecuaciones lineales con Q incógnitas,

Vj = b1Veq,j + b2V

3
eq,j + · · · + bQV

2Q−1
eq,j | (3.59)

Este sistema de ecuaciones puede ser representado en forma matricial

V = Veqb | (3.60)

donde

V =

V1
V2
VQ

(3.61a)

b =

b1
b2
bQ

(3.61b)

Veq =

Veq,1 V

3
eq,1
- · · V

2Q−1
eq,1
Veq,2 V

3
eq,2
- · · V

2Q−1
eq,2

Veq,Q V

3
eq,Q · · · V

2Q−1
eq,Q

(3.61c)

El vector de parámetros b se obtendría invirtiendo la matriz Veq,

b = V

−1
eq V | (3.62)

Utilizando la notación de la Figura 3.12,

ue(t) = b1u(t) + b2u

3
(t) + · · · + bQu

2Q−1
(t) (3.63)

Para el cálculo de b se utilizarán los datos del motor estudiado en la Sección 3.3, donde se obtuvo la relación entre V y V eq necesarias, recogida en la Tabla 3.1.
Los valores de los parámetros del polinomio f

−1
son los siguientes,

b =

b1
b2
bQ

= 10−20

160847196028152414208,000000 −26347922032274841600,000000 4322322265093997568,000000 −363554628276008320,000000 17239993144634128,000000
−477930909965441,125000
7651637860447,907227
−65284920745,084717
229031063,402778

(3.64)

En la Figura 3.13a se muestra la curva del polinomio invertido f

−1
. Puede observarse que para valores elevados de V eq = u se produce una oscilación excesiva, como ocurre con la curva de f de la Figura 3.11a.

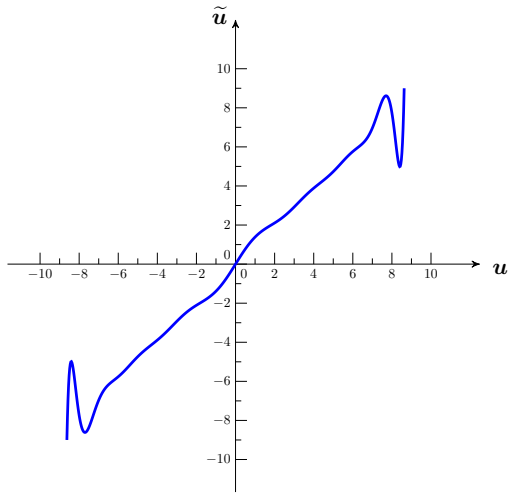
[picture p39: figure]
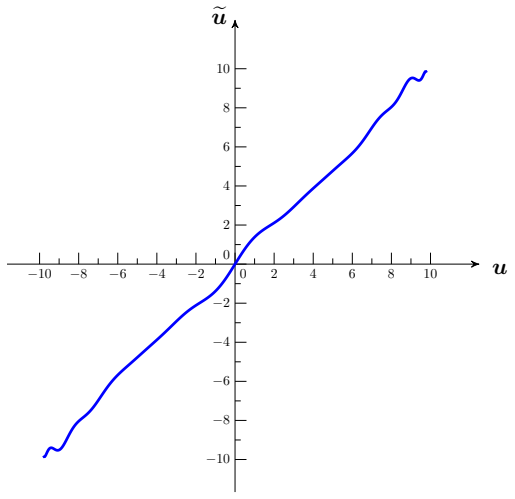
[picture p40: figure]

(a) (b)

Figura 3.13: Polinomio de interpolación (a) f

−1
y (b) f

−1
extendido

Para suavizar f

−1 puede ampliarse el polinomio, como se hizo en la sección de modelado, obteniendo el vector b siguiente,

b =

b1
b2
bQ′

= 10−20

161420208519579402240,000000 −27972980731616759808,000000 5147272154662284288,000000 −523422280457548608,000000 32724482599262236,000000
−1328367048308069,750000
35901555312352,882812
−649115490056,463867
7733802412,063457
−58137308,617381
249474,432325
−465,230157

(3.65)

donde Q′ = Q + 3.
En la Figura 3.13b se muestra la curva resultante de f

−1
extendido.

### 3.5. Programas Matlab para el modelado de un motor DC

En esta sección se explican los programas Matlab del algoritmo de modelado de un motor DC descrito en la Sección 3.2. A este documento se adjunta el código de cada programa en el fichero comprimido simulaboModeladoEjemploAlumnos.tgz. Este documento debe leerse en compañía de cada uno de los programas mencionados aquí, ya que se hace constante referencia a ellos. Cada programa tiene unos comentarios iniciales que explican el significado de las variables principales de entrada y salida, y sin estos comentarios, lo que se dice en este documento estaría incompleto.
En lo que sigue se supone que se han obtenido datos experimentales de la salida de un motor DC real cuando la entrada es una señal cuadrada de amplitud Vj , j ∈ {1, 2, · · · , Q}, y que estos datos están almacenados en Q ficheros de texto de dos columnas: la primera representa el número de muestra k, y la segunda el número de pulsos Nj (k) obtenido con un encoder situado en el eje del motor. La primera fila de cada fichero representa la condición inicial, con el número de muestra k = 0, y puesto que se supone que la condición inicial es nula, el número de pulsos Nj (0) = 0. Para interpretar correctamente estos ficheros es necesario saber cuál es el periodo de muestreo uniforme T en segundos utilizado en los experimentos, la resolución del encoder, CP R, en pulsos/vuelta y los parámetros de la señal cuadrada: la duración del escalón de subida t1 en segundos, la duración del escalón de bajada t2 en segundos y la amplitud del escalón de subida Vj en voltios.

Por ejemplo, si t1 = t2 = 0,6 segundos y T = 1 milisegundo, cada fichero tendrá 1201 datos. El valor de CP R es necesario para calcular la posición angular θj (k) en radianes del motor y la velocidad angular del motor, ˙θj (k) en rad/s, a partir del número de pulsos. Puesto que se supone que las condiciones iniciales son nulas, θj (0) = ˙θj (0) = 0.
El cálculo en radianes de θj (k) se realiza con la siguiente expresión,

θj (k) = 2πNj (k)
q
, | k ≥ 0 | (3.66)

donde q = CP R.
En los programas desarrollados se calcula la velocidad angular ˙θj (k) en rad/s utilizando la primera aproximación de Euler de la derivada,

˙θj (k) = 2π (Nj (k) − Nj (k − 1)) q

, | k ≥ 1 | (3.67)

### 3.5.1. ModeladoMotorDCVelAngPoloBucleB.m

El programa ModeladoMotorDCVelAngPoloBucleB.m es el programa principal, cuya función es ejecutar todos los programas necesarios para realizar el modelado experimental del motor DC. Estos programas se encuentran en el fichero comprimido simulaboModeladoEjemploAlumnos.tgz.
En primer lugar deben definirse las constantes necesarias, así como los nombres de los ficheros que deberán escribirse y leerse a lo largo de todo el proceso. Esto debe hacerse manualmente como se explica a continuación. Una vez hecho, puede ejecutarse el programa ModeladoMotorDCVelAngPoloBucleB.m en el entorno de Matlab. Su cabecera es la siguiente:

[pM, KM, Gzero,J,VeqV, a,b]=ModeladoMotorDCVelAngPoloBucleB

donde V eqV es el vector de tensiones equivalentes (Sección 3.2.3), J es el valor de la función de error que permite obtener la ganancia a bajas frecuencias óptima, a, b son los vectores de parámetros del polinomio de interpolación de la función no lineal f y f

−1
respectivamente, y

G(s) = KM
s + pM

(3.68a)

Gzero = G(0) = KM
pM

(3.68b)

es decir, pM y KM son los parámetros estimados de la función de transferencia de la parte lineal del modelo del motor DC.
Los ejemplos que se citen en esta sección, se corresponden con el ejemplo de modelado de la Sección 3.3.
Los programas requieren que se definan algunas constantes cuyos nombres de las variables deben respetarse. Por ejemplo:

%%%%%%%%%%%%%%%%%%%%%%%
TensionVector=[1 2 3 4 5 6 7 8 9]; TensionVectorL=length(TensionVector); DuracionSubida=0.6;% segundos
Periodo=0.001;% en segundos
CPR=12;% pulsos/vuelta
z1=0.5;% ponderación de los polos de subida y bajada
opCurvas=[1 1 1];% se explica en ModeladoMotorDCCurvasB.m

A su vez, deben definirse los nombres y ubicaciones de algunos ficheros. Debe haber cuatro tipos de ficheros. En el ejemplo que se pone a continuación tienen extensiones distintas: “.mean”, “.resumen”, “.polo” y “.poli”. A continuación se explica cada uno de ellos.

Lo que debe respetarse son los nombres de las variables de cada uno de ellos: ”NomFicheroLecturaMean”, “NomFicheroEscrituraResumen”, “NomFicheroEscrituraPolo” y “NomFicheroEscritura-Poli”. Las variables ”NomFicheroLecturaMean” y “NomFicheroEscrituraPolo” tienen la estructura de un vector de celdas (“cell array”) ya que hay Q ficheros de nombres distintos.

%%%%%%%%%%%%%%%%%%%%%%%%%%%%%%%%%%%%%%%%%%%%%%%%%%%%%%%%%%
%%% ejemplo NOMBRE DE FICHEROS:
%% - con extensiones .mean, .resumen, .polo y .poli,
que se leen o se escriben en el subdirectorio ./PololuModeladoDat (que se encuentra en el fichero: simulaboModeladoMotorDC.tar.gz) %% - ficheros de datos:
% ./PololuModeladoDat/trapXV_0ms600ms600ms_T1ms_ST.mean,
donde X es la tensión en {1,2,...,9} %% - restantes ficheros:
% ./PololuModeladoDat/MotorDCPololu.V_0ms600ms600ms_T1ms_ST.XV.polo, donde X es la tensión en {1,2,...,9} % ./PololuModeladoDat/MotorDCPololu.V_0ms600ms600ms_T1ms_ST.resumen % ./PololuModeladoDat/MotorDCPololu.V_0ms600ms600ms_T1ms_ST.poli %%%%%%%%%%%%%%%%%%%%%%%%%%%%%%%%%%%%%%%%%%%%%%%%%%%%%%%%% PrefNomMeanA=’./PololuModeladoDat/trap’; PrefNomMeanB=’0ms600ms600ms_T1ms_ST.mean’; PrefNomFicheroEscritura=’./PololuModeladoDat/MotorDCPololu’; PrefNomFichero2=strcat(PrefNomFicheroEscritura,’.’,PrefNomMeanB); NomFicheroEscrituraResumen=strcat(PrefNomFichero2,’.resumen’); NomFicheroEscrituraPoli=strcat(PrefNomFichero2,’.poli’); NomFicheroLecturaResumen=NomFicheroEscrituraResumen;
for i=1:TensionVectorL
Tension=TensionVector(i);
NTension=num2str(Tension); NomFicheroEscrituraPolo{i}=strcat(PrefNomFichero2,’.’,NTension,’V.polo’); NomFicheroLecturaMean{i}=strcat(PrefNomMeanA,NTension,’V_’,PrefNomMeanB); end
NomFicheroLecturaPolo=NomFicheroEscrituraPolo;

El Programa principal ModeladoMotorDCVelAngPoloBucleB.m ejecuta los siguientes programas, y en el orden indicado. Todos los programas tienen un comentario inicial que explica su funcionamiento. Solo el programa ModeladoMotorDCVelAngPoloB.m requiere que se introduzcan manualmente valores numéricos para el cálculo de los polos de subida y de bajada.

1. Función LecturaExperimentoMultiV.m Lee, en un bucle de longitud TensionVectorL=Q, cada uno de los ficheros de datos de los experimentos asociados a la variable de tipo celda (“cell array”) “NomFicheroLecturaMean”, creando el vector “Tiempo” (número de pulso, índice temporal k) y el vector de celdas (“cell array”) “Pulsos” (valor del pulso, N(k)). Se supone que el vector “Tiempo” es el mismo para los Q ficheros de datos, por lo que no es necesario que sea un vector de celdas.

[Tiempo,Pulsos{i}]=LecturaExperimentoMultiV(TensionVector(i), NomFicheroLecturaMean{i},Periodo);

2. Programa ModeladoMotorDCVelAngPoloB.m. Este programa se ejecuta en un bucle de longitud TensionVectorL=Q.

ModeladoMotorDCVelAngPoloB(i,TensionVector(i),CPR,Periodo,Tiempo,Pulsos{i}, NomFicheroEscrituraResumen,NomFicheroEscrituraPolo{i});

El programa ModeladoMotorDCVelAngPoloB.m requiere que se introduzcan manualmente los valores extremos de los intervalos temporales para el cálculo del polo de varianza mínima de subida, y para el cálculo del polo de bajada, tal y como se describe en la Sección 3.2.2. Un ejemplo es el siguiente:

%%%%%%%%%%%%%%%%%%%%%%%%%%%%%%%%%%
IniS=1;% inicial subida
InfS=601;% final subida
InfB=1201;% subida + bajada
kTs=401;% frontera régimen permanente subida DeltatS=60;
DnS=2;%>=2
%%%%%%%%%%%%%%%%%%%%%%%%%%%%%%%%%%

Al ejecutar en un bucle el programa ModeladoMotorDCVelAngPoloB.m se crea y actualiza el fichero asociado a la variable “NomFicheroEscrituraResumen” y Q ficheros asociados a la variable de tipo celda “NomFicheroEscrituraPolo”. El formato de cada uno de estos ficheros se explica en los comentarios iniciales de este programa.

El programa principal ModeladoMotorDCVelAngPoloBucleB.m lee el fichero asociado a la variable “NomFicheroLecturaResumen” (que normalmente coincidirá con el fichero asociado a la variable “NomFicheroEscrituraResumen”) ya que utiliza la información creada en el bucle del programa ModeladoMotorDCVelAngPoloB.m para calcular los valores de “pM”,“KM”, “Gzero”, “J” y “VeqV”.

3. Función InterpolacionPolinomioSimetrico.m. Calcula el vector de parámetros, a, del polinomio de interpolación f de la tensión equivalente y de la tensión experimental, tal y como se explica en la Sección 3.2.4. Permite también obtener el vector de los parámetros, b, de la función inversa f

−1
, necesarios para la implementación del controlador, según se explica en la Sección 3.3.

Para obtener los vectores de parámetros “a” y “b” se ejecutarían las siguientes instrucciones:

[a,aR]=InterpolacionPolinomioSimetrico(VeqVP,TensionVectorP);%f [b,bR]=InterpolacionPolinomioSimetrico(TensionVectorP,VeqVP);%f^{-1}

Los vectores “VeqVP” y “TensionVectorP” deben coincidir con los los vectores “VeqV” y “TensionVector” salvo que se pretenda obtener un polinomio de interpolación extendido, como se ha hecho en el ejemplo de modelado de la sección 3 y de diseño del controlador de la Sección 3.3. Por ejemplo, deben definirse los vectores “VeqVP” y “TensionVectorP” antes de ejecutar la función InterpolacionPolinomioSimetrico.m:

%%%%%%%%%%%%%%%%%%%%%%%%%%%%%%
TensionVectorP=TensionVector;
VeqVP=VeqV;
%%%%%%%%%%%%%%%
%% Si se hace con un polinomio extendido: por ejemplo, %V9=[9.4 9.6 9.8]
%TensionVectorP=[TensionVectorP V9];
%VeqVP=[VeqVP V9];

Los resultados de la función InterpolacionPolinomioSimetrico.m se guardan en el fichero “NomFicheroEscrituraPoli”, operación que se realiza en el mismo programa principal ModeladoMotorDCVelAngPoloBucleB.m. El formato de este fichero se explica en los comentarios iniciales de este programa.

4. Programa ModeladoMotorDCCurvasB.m. Crea, como máximo, tres tipos de figuras, según se indique en la variable “opCurvas”. Por ejemplo, si “opCurvas=[1 0 1]” solo se crearán las figuras de tipo “a” y de tipo “c”. En los comentarios iniciales del programa ModeladoMotorDCCurvasB.m se explica cada uno de estos tipos.

El programa ModeladoMotorDCCurvasB.m tiene la siguiente cabecera:

ModeladoMotorDCCurvasB(opCurvas,DuracionSubida,TensionVector, NomFicheroLecturaPolo,Tiempo,PulsosRad,PS,PB,KS,KB, PSB,KSB,VeqV,pM,KM,a,b,TensionVectorP,VeqVP)

Este programa tiene una primera instrucción, que puede comentarse si se considera conveniente, que cierra todas las figuras abiertas,

delete(findall(0,’Type’,’figure’)) % cierra todas las figuras

El programa ModeladoMotorDCCurvasB.m ejecuta, como máximo, tres programas, depen-diendo del valor de “opCurvas”: ModeladoMotorDCCurvasPolo.m, ModeladoMotorDC-CurvasVelAng.m y ModeladoMotorDCCurvasPoli.m. El primero de ellos lee datos del conjunto de ficheros asociado a la variable de tipo celda “NomFicheroLecturaPolo”, que normalmente coincidirá con el conjunto de ficheros asociados a la variable de tipo celda “NomFicheroEscrituraPolo”.

La cabecera del programa ModeladoMotorDCCurvasPolo.m es la siguiente:

ModeladoMotorDCCurvasPolo(TensionVector,NomFicheroLecturaPolo)

La cabecera del programa ModeladoMotorDCCurvasVelAng.m es la siguiente:

ModeladoMotorDCCurvasVelAng(DuracionSubida,TensionVector,Tiempo, PulsosRad,PS,PB,KS,KB,PSB,KSB,VeqV,pM,KM)

La cabecera del programa ModeladoMotorDCCurvasPoli.m es la siguiente:

ModeladoMotorDCCurvasPoli(a,b,TensionVectorP,VeqVP)

# Apéndices

## A. Etapa de potencia

En la Figura A.1 se representa un esquema de la etapa de potencia de un motor DC cuyo objetivo es la generación de una señal modulada en anchura de pulso (señal PWM en lo sucesivo, um(t)) que se corrresponda con la señal de control discreta uk generada por un sistema de control digital.

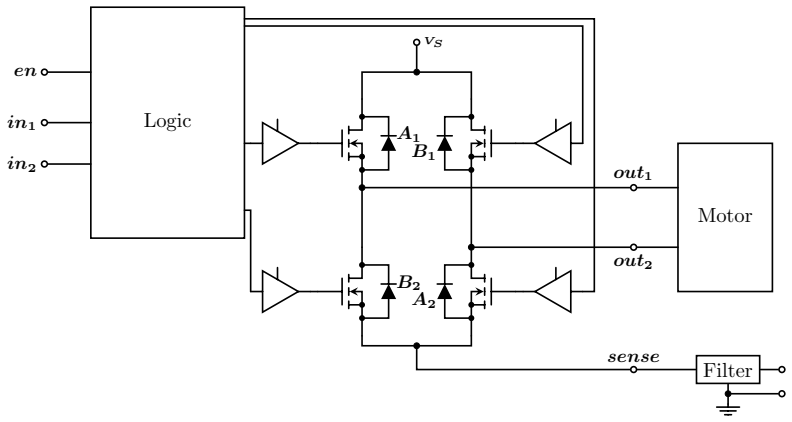
[picture p41: figure]
Filter; Logic; Motor; out1; out2; sense

Figura A.1: Puente en H

La implementación hardware consiste en un puente en H de dispositivos MOSFET.
El puente en H tiene dos cargas importantes: la del motor DC cuyas ecuaciones se recogen en la Sección 2.1 y la de un filtro paso bajo cuya finalidad es servir de sensor de la corriente eléctrica en el motor. En este escrito no se estudia este filtro. La carga del motor es fundamentalmente inductiva. Llamaremos Zona Z⁺ al periodo de tiempo en que los MOSFET,s A1 y A2 se encuentren en su región óhmica y los MOSFET,s B1 y B2 se encuentren en su región de corte, y Zona Z− al periodo de tiempo en que los MOSFET,s B1 y B2 se encuentren en su región óhmica y los MOSFET,s A1 y A2 se encuentren en su región de corte.
En las Figuras A.2 y A.3 se representan las corrientes que circulan por el puente en H cuando los

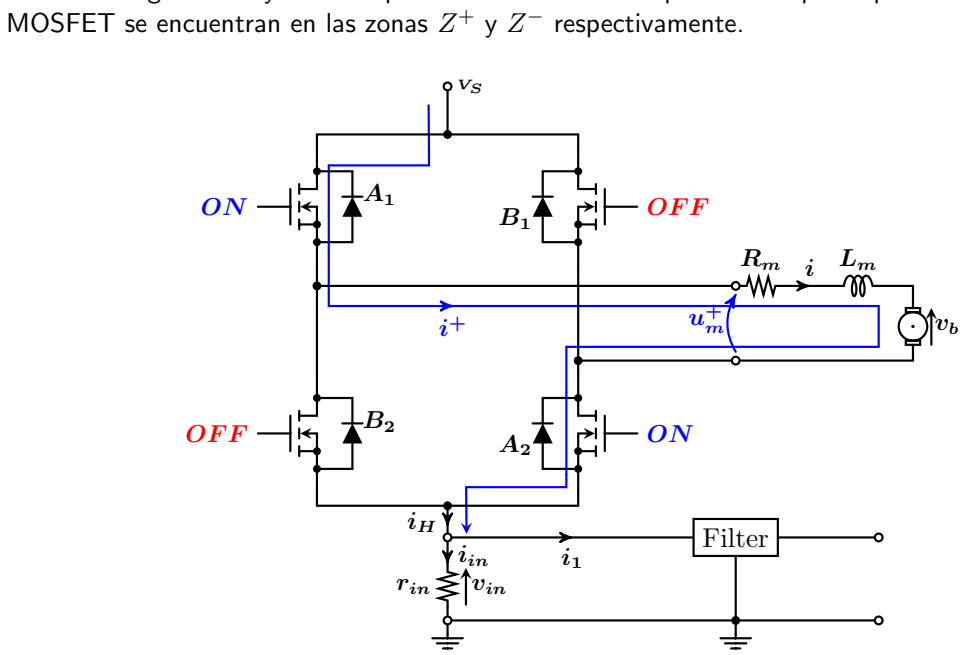
[picture p42: figure]
MOSFET se encuentran en las zonas Z; − respectivamente.; Filter; iin; rin; vin

Figura A.2: Zona Z

+

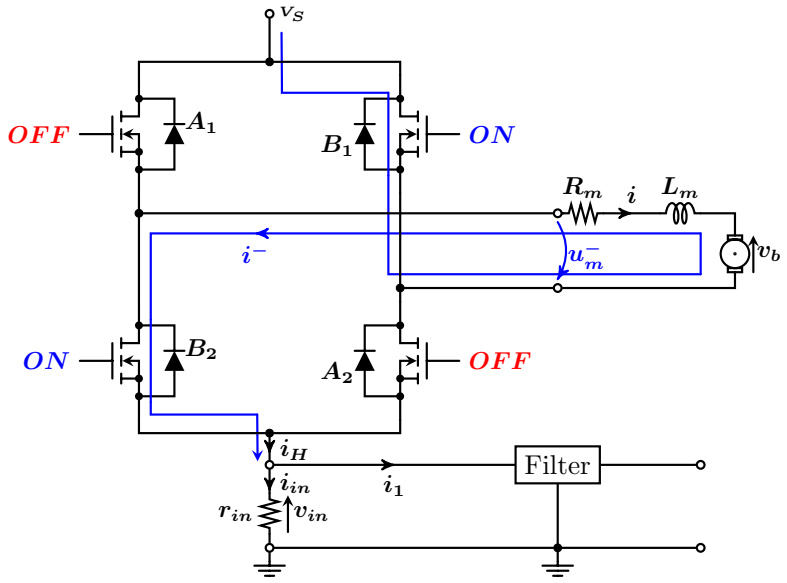
[picture p43: figure]
Filter; iin; rin; vin

Figura A.3: Zona Z

−

Llamaremos Zona Z1 al periodo de tiempo en que los MOSFET,s A1 y B1 se encuentren en su región óhmica y los MOSFET,s A2 y B2 se encuentren en su región de corte, y Zona Z2 al periodo de tiempo en que los MOSFET,s A2 y B2 se encuentren en su región óhmica y los MOSFET,s A1 y B1 se encuentren en su región de corte.
La zona Z1 es preferible a la zona Z2 cuando haya una resistencia para la medida de la corriente, ya que se reducen las pérdidas en ella. No obstante, en ambos casos se logra un cortocircuito entre las bornas del motor, ya que ellas se encuentran, idealmente, a la misma tensión. Hay que tener en cuenta que aunque la tensión sea nula a la entrada del motor, puede circular corriente eléctrica, ya que se trata de un sistema dinámico con condiciones iniciales no nulas.
Lo que nunca se debe hacer es cortocircuitar la fuente de alimentación. Esto puede ocurrir cuando todos los MOSFET,s estén simultáneamente en la región óhmica. Como consecuencia, si se realiza una PWM que exija conmutar de las zonas Z⁺ a Z− o al revés, se corre el riesgo de que se produzca esta situación. En este caso debe introducirse un tiempo muerto intermedio, definido como la situación en que todos los MOSFET,s se encuentren en corte. Este tiempo muerto debe ser lo más pequeño posible para que no produzca un excesivo rizado en la corriente eléctrica. Por esta razón llamaremos Zona Z0 al periodo de tiempo en que todos los MOSFET,s se encuentren en corte. La PWM que consideraremos en este escrito, consiste en la conmutación periódica entre algunas de estas zonas. En la Sección siguiente se verán dos tipos de PWM con formas de conmutación distintas.
La parte lógica del puente en H se encarga de generar las señales adecuadas a los MOSFET con el fin de que se encuentren en la región óhmica o en la región de corte, o lo que es lo mismo, de la lógica de conmutación entre zonas. Sus entradas principales son dos señales in1 e in2 que repesentan las señales PWM de baja potencia generadas, normalmente, por un microcontrolador.

## B. Tipos de PWM

Para la generación de la señal PWM es necesario conocer el periodo de modulación constante Tm y la anchura del pulso γkTm, donde γk ∈ [0, 1]. La anchura del pulso se calcula a partir de la señal generada por el controlador uk, de tal manera que la entrada al motor o señal PWM, um(t), satisfaga ciertas condiciones. En lo que sigue solo se contempla el caso en que el promedio temporal de la señal um(t) coincida con la señal de control uk en cada periodo de modulación, es decir, que se satisfaga la relación siguiente:

uk =

1
Tm

∫ (k+1)Tm

kTm

| um(t)dt | (B.1)

Aplicando este criterio se obtiene la anchura del pulso γkTm en cada periodo de modulación Tm. Este criterio solamente garantiza que las señales um(t) y uk coinciden a bajas frecuencias, es decir, en el régimen permanente. Normalmente, en la práctica, la señal de control uk se mantendrá constante durante un periodo de muestreo T, donde T = NTm, siendo N una constante. Por lo tanto, se producirá una secuencia de N pulsos idénticos en la señal um(t). Si N es suficientemente elevado el criterio del promedio, dado por B.1, será una buena aproximación de la reconstrucción analógica de la señal muestreada uk, ya que la señal PWM será aproximadamente una señal periódica de periodo Tm, y la PWM funcionará como una aproximación causal de un filtro paso bajo ideal.
Para cualquier tipo de modulación PWM que se considere se producirá una señal discontinua en los instantes de tiempo kTm, y un paso por cero en los instantes de tiempo Tk excepto en los casos en que γk = 0 o γk = 1,
Tk = (γk + k)Tm, | k ∈ {0, 1, 2, · · · } | (B.2)

La anchura del pulso en cada periodo de modulación es γkTm = Tk − kTm.
En este documento se van a considerar dos tipos de PWM, según sea la forma de generar la señal PWM, um(t).
1. PWM de tres niveles o PWM unipolar.

En la Figura B.1 se muestra un ejemplo de señal PWM, um(t), con PWM unipolar, donde la señal generada por el controlador es uk. Esta clase de PWM es de tres niveles {Um, 0, −Um}. La señal um(t) es positiva o nula cuando uk ≥ 0, y es negativa o nula cuando uk ≤ 0.

Aplicando la expresión dada por B.1 se obtiene la ecuación que permite obtener la anchura del pulso γkTm,

|uk| = γkUm | (B.3)

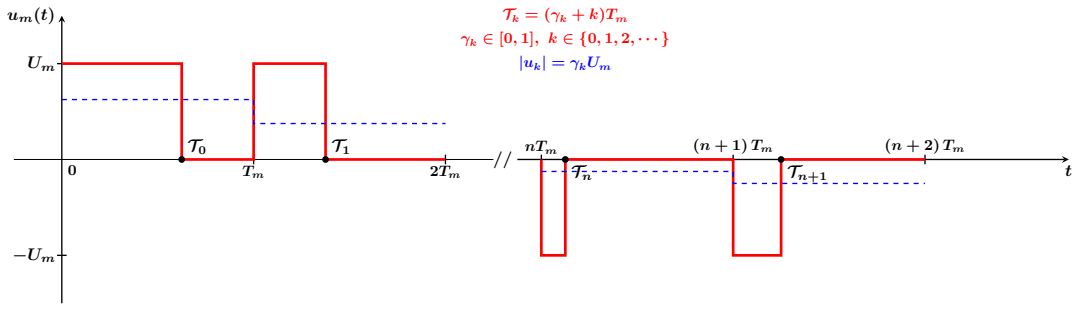
[picture p44: figure]
nTm; |uk| = γkUm

Figura B.1: Ejemplo de señal PWM unipolar ideal

En la Figura B.2 se muestra la secuencia lógica de conmutación de este tipo de PWM ideal. Las zonas Z1 y Z2 se han subdividido cada una de ellas en dos zonas, zonas Z

+
1

y Z

−
1

según
que se haya dado inmediatamente antes la situación de las zonas Z⁺ y Z−, respectivamente, y zonas Z

+
2

y Z

−
2

según que se haya dado inmediatamente antes la situación de las zonas Z⁺

y Z−, respectivamente. La zona Z

+
2

solo opera cuando se realiza una conmutación de Z⁺ a Z−, y la zona Z

−
2

solo opera cuando se realiza una conmutación de Z− a Z⁺.

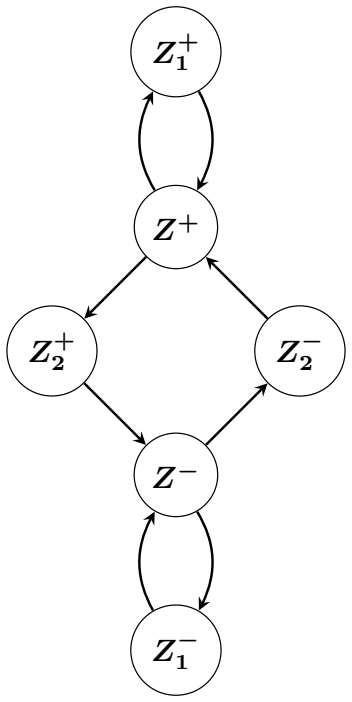
[picture p45: figure]

Figura B.2: Ejemplo de señal PWM unipolar ideal

2. PWM de dos niveles o PWM bipolar.

En la Figura B.3 se muestra un ejemplo de señal PWM con PWM bipolar, donde la señal generada por el controlador es uk. Esta clase de PWM es de dos niveles {Um, −Um}.

Aplicando la expresión dada por B.1 se obtiene la ecuación que permite obtener la anchura del pulso γkTm,

uk = (2γk − 1)Um | (B.4)

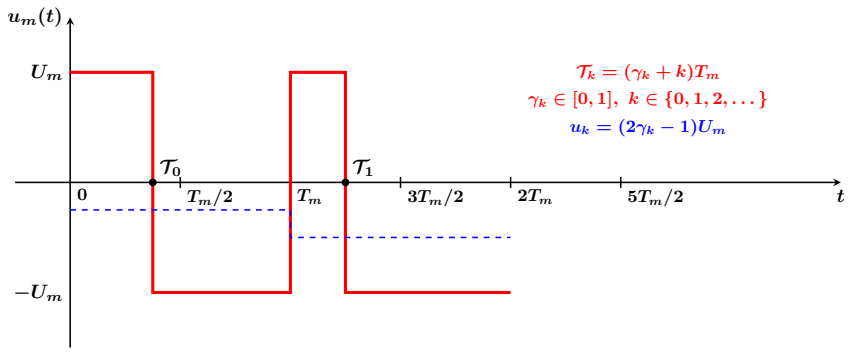
[picture p46: figure]

Figura B.3: Ejemplo de señal PWM bipolar ideal

En la Figura B.4 se muestra la secuencia lógica de conmutación de este tipo de PWM ideal.

Z⁺ | Z⁻

Figura B.4: Secuencia lógica del puente en H con PWM bipolar ideal

## C. Modelo CVS de fricción de un motor DC

El modelo clásico de fricción o modelo CVS (Coulomb plus Viscous plus Static friction) consta de tres componentes, el par de fricción seca o fricción de Coulomb τfC, el par de fricción viscosa τfV y el par de fricción estática τfS (stiction o static friction),

τf (t) = τfC(t) + τfV (t) + τfS(t) | (C.1)

donde

τfV (t) = Bm

˙θm(t) | (C.2a)
τfC(t) = τC sgn ( ˙θm(t)) | (C.2b)

τfS(t) =

kmi(t) − τl(t), | km|i(t)| ≤ τS,

˙θm(t) = ¨θm(t) = 0
τS sgn (i(t)) − τl(t) − Jm | ¨θm(t), km|i(t)| > τS,

˙θm(t) = 0,

¨θm(t) ̸= 0
0, | ˙θm(t) ̸= 0

(C.2c)

Los parámetros (B, τC, τS) representan las constantes de fricción viscosa, de Coulomb y estática respectivamente.
La función signo, sgn x, para cualquier función x, se define como

sgn x =

1, | x > 0
0, | x = 0
−1, x < 0

(C.3)

Cuando x ̸= 0, la función signo puede escribirse en la forma

sgn x =

x
|x|

(C.4)

Un modelo de fricción, también clásico, incluye el efecto de Stribeck que se produce a velocidades angulares cercanas al cero. Incluyendo este efecto, el par de fricción τf (t) suele representarse en la forma,

τf (t) = τfC(t) + τfV (t) + ( τ

′
fS(t) − τfC(t)

)
e

−

˙θm(t)

˙θSt

δSt

(C.5)

donde ahora τ

′
fS(t) = τS sgn (i(t)) − τl(t) − Jm

¨θm(t), y donde ˙θSt es la velocidad angular de Stribeck y δSt la constante de Stribeck. El factor exponencial de la derecha es despreciable cuando las velocidades angulares superan un cierto valor pequeño.

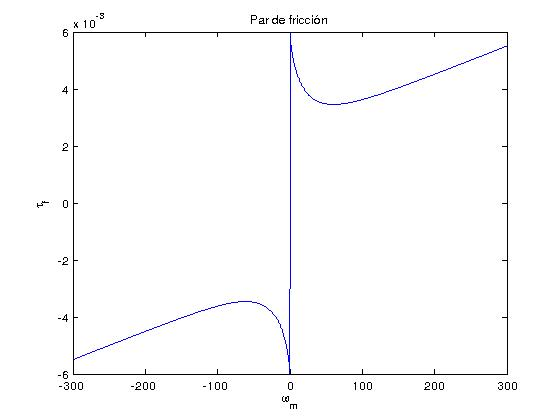
[picture p47: figure]

Figura C.1: Par de fricción dado por C.5 en función de ˙θm

En la Figura C.1 se muestra la curva del par de fricción τf en función de ˙θm, dado por la función C.5. Esta curva se ha obtenido con valores arbitrarios, concretamente con τS = 0,006; Bm = 0,00001; τC = 0,0025; ˙θSt = 20rpm; δSt = 0,75. Se ha supuesto también que τl = ¨θm = 0 y que sgn (i) = sgn ( ˙θm). Puede observarse que se ha elegido τS > τC como suele ser el caso en los motores reales.
El modelo CVS, es decir, sin considerar el efecto de Stribeck, puede simularse aproximadamente con la ecuación,
τf (t) = τfC(t) + τfV (t) + ( τ

′
fS(t) − τfC(t)

)
e

−α|

˙θm(t)|
(C.6)

donde α sea un valor muy elevado.
El par de fricción estática actúa cuando el eje del motor está inmóvil o cuando hay un cambio en el sentido de giro del eje del motor (cuando la aceleración angular ¨θm(t) ̸= 0). Como vemos, lo que hace el par de fricción estática τfS en la situación de arranque del motor, es impedir el movimiento del eje del motor hasta que la corriente eléctrica supere un valor constante. La variación temporal se debe a la variación de la corriente eléctrica i(t), es decir que en el arranque, i(t) ̸= 0, y puede calcularse a partir de la ecuación eléctrica del motor.
En esta situación de fricción estática la ecuación eléctrica toma la forma

um(t) = Rmi(t) + Lm

di(t)
dt | | (C.7)

Si se hace um(t) = Ua, donde Ua es una constante, la corriente eléctrica tenderá en régimen permanente a un valor Ua/Rm. Si este valor es menor que τS/km el motor permanecerá inmóvil. Esto significa que habrá una tensión de arranque (break-away voltage o starting voltage) a partir de la cual el motor comenzará a moverse, pero permanecerá inmóvil por debajo de ella. Este fenómeno puede apreciarse introduciendo al motor una tensión en forma de rampa de pequeña pendiente. Se producirá entonces un retardo temporal en la velocidad angular del motor, que durará hasta que la corriente eléctrica alcance un determinado valor.
Llamaremos τc(t) a
τc(t) = τfS(t) + τfC(t) + τl(t) | (C.8)

Con esta definición la ecuación mecánica del motor queda representada en la forma

kmi(t) = Jm

d

2
θm(t)
dt²

+ Bm

dθm(t)
dt | + τc(t) | (C.9)

## D. Modelo de carga de un motor DC de un grado de libertad

Consideremos que la carga está unida al eje del motor a través de un mecanismo reductor de factor de reducción r ∈ (0, 1) y rendimiento η ∈ (0, 1) (o expresado en tanto por ciento). Entonces la velocidad angular θL(t) y el par de la carga τL(t) a la salida del reductor estarán relacionados con θm(t) y τl(t) en el eje del motor (o entrada del reductor) según las siguientes expresiones:

θL(t) = rθm(t) | (D.1a)
τL(t) = η
r
τl(t) | (D.1b)

Consideremos que la carga es un cuerpo rígido cuya ecuación dinámica puede ser expresada en la forma

τL(t) = JL

d

2
θL(t)
dt²
+ τg(t) | (D.2)

donde JL es el momento de inercia de la carga y τg(t) es una función no lineal dependiente de la posición angular θL(t) que representa los efectos gravitacionales²
Podemos expresar esta ecuación en términos de θm(t) y τl(t),

τl(t) = r

2JL
η

d

2
θm(t)
dt²

+

r
η
τg(t) | (D.3)

Introduciendo esta ecuación en la ecuación mecánica del motor dada por 2.2

kmi(t) = Jef f

d

2
θm(t)
dt²

+ Bm

dθm(t)
dt + τ

′
c
(t) (D.4)

donde Jef f se denomina momento de inercia eficaz,

Jef f = Jm +

r

2JL
η

(D.5a)

τ

′
c
(t) = τfS + τfC +

r
η
τg(t) | (D.5b)

A partir de estas expresiones puede rehacerse el modelado del motor sin carga. La constante de tiempo mecánica del motor con carga se modificará con respecto al motor sin carga, pero los parámetros Rm, Lm, Jm, kb, km, Bm, I0, n0, te seguirán siendo los mismos.
Podemos observar que el momento de inercia del motor se refleja a la entrada del reductor con un coeficiente que será tanto más pequeño cuanto menor sea el factor de reducción. Por ejemplo, un reductor que se adapta al motor estudiado en el ejemplo de la Sección 2.5, tiene un factor de

reducción r =

1
18, 2

con un rendimiento η = 73 % y una masa mr = 71×10−3kg. Puede comprobarse

que

r
η

= 0, 07527 y

r

2
η

= 0, 00414 por lo que el efecto inercial y gravitatorio de la carga visto desde

el eje del motor se reducen mucho. No obstante no debe despreciarse ninguno de ellos si se desea una gran precisión, además de que normalmente el momento de inercia del motor Jm suele ser muy pequeño.
Para el cálculo de JL puede hacerse la suposición aproximada de que la masa del reductor forma parte de ella. Por ejemplo, si la carga es un disco plano, el momento de inercia respecto de su eje

central viene dado por la ecuación I0 =

1
8

md²
, siendo d su diámetro y m su masa. Por lo tanto, puede hacerse la aproximación

JL =

1
8

(mdisco + mreductor)d

2

donde mreductor debe ser la masa de la parte rotatoria del reductor, es decir que no coincide con mr que es la masa total del reductor.

2En un sistema mecánico pueden aparecer también términos de Coriolis dependedientes de la velocidad angular. Si la carga es un sistema mecánico de varios grados de libertad el momento de inercia no será constante sino que dependerá de la posición angular.

En la práctica el cálculo de los parámetros de la carga no es sencillo y en muchas ocasiones no se dispone de los valores necesarios. Este hecho sugiere la necesidad de realizar estudios experimentales para el cálculo de los polos del motor con carga.
Una consecuencia de este estudio es que si se realizase un experimento para obtener el polo dominante podría estimarse el valor de Jef f , y de aquí, si se conociese el diámetro del disco, podría obtenerse una estimación de su masa, lo que puede resultar conveniente para conocer aproximadamente el valor del par debido a los efectos gravitacionales. Si el centro de masas de la carga se situase en el eje de rotación del motor, el efecto gravitacional será nulo. En la práctica esto no es así, pero puede suponerse en una primera aproximación nulo cuando la carga sea un disco o un cuerpo con simetría de revolución cuyo centro de masas cae en el eje del motor.
En el ejemplo de la Sección 2.5, con el reductor seleccionado anteriormente, se obtiene un valor de Jef f = 1,47 × 10−6Kg/m²
. Estos calculos se han realizado suponiendo que la carga es un disco de aluminio de anchura a = 1, 5mm y diámetro d = 7,5cm, y se ha calculado de manera arbitraria mreductor = 0,1mr ya que no se dispone de información. La densidad del aluminio es ρ = 2700Kg/m³
. La constante de tiempo mecánica eficaz es tmef f = 0,0158s, por lo que el polo del modelo simplificado con el método de eliminación de la constante eléctrica es pef f = −63, 38. Para el cálculo de tmef f se ha aplicado la expresión 2.15

tmef f =

RmJef f
RmBm + kbkm

(D.6)

## E. Obtención analítica del polo del motor con una entrada escalón bajo condiciones iniciales nulas

De acuerdo con el modelo simplificado del motor,

¨θm(t) + p

˙θm(t) = Ku(t) | (E.1)

donde θm(t) representa la posición angular del motor. La función de transferencia de posición angular es,

Gθm(s) = K
s(s + p)

(E.2)

Por lo tanto, la transformada de Laplace de la posición angular bajo condiciones iniciales nulas es,

Θm(s) = Gθm(s)U(s) | (E.3)

Supongamos que se hace un experiemento que consiste en aplicar al motor una tensión constante U, entonces

Θm(s) = KU
s

2(s + p)

(E.4)

Descomponiendo en fracciones simples,

Θm(s) = α1
s

+

α2
s

2

+

α3
s + p

(E.5)

donde

α1 = −

KU
p

2

(E.6a)

α2 =

KU
p

(E.6b)

α3 = −α1 | (E.6c)

Aplicando la transformada de Laplace inversa, podemos escribir θm(t) en la forma

θm(t) = KU
p

(
t −

1
p

(
1 − e

−pt)

)
(E.7)

Derivando con respecto al tiempo esta expresión se obtiene la velocidad angular,

˙θm(t) = KU
p

(
1 − e

−pt)
(E.8)

Podemos comprobar que el valor final de la velocidad angular es,

˙θm(∞) = KU
p

(E.9)

Sustituyendo E.8 y E.9 en E.7,

θm(t) = ˙θm(∞)t −

˙θm(t)

p

(E.10)

Despejando p de la relación E.10,

p =

˙θm(t)
˙θm(∞)t − θm(t)
, | t > 0 | (E.11)

## F. Obtención analítica del polo del motor con una entrada nula bajo condiciones iniciales no nulas

De acuerdo con el modelo simplificado del motor,

¨θm(t) + p

˙θm(t) = Ku(t) | (F.1)

La función de transferencia de posición angular es,

Gθm(s) = K
s(s + p)

(F.2)

Por lo tanto, la transformada de Laplace de la posición angular bajo condiciones iniciales no nulas es,

Θm(s) = Gθm(s)U(s) + θm(0−)s + ˙θm(0−) + pθm(0−)

s(s + p)

(F.3)

Supongamos que se hace un experimento que consiste en “apagar” bruscamente el motor cuando éste se encuentre con unas condiciones iniciales (θm(0−),

˙θm(0−)), entonces

Θm(s) = θm(0−)s + ˙θm(0−) + pθm(0−)

s(s + p)

(F.4)

Descomponiendo en fracciones simples,

Θm(s) = α1
s

+

α2
s + p

(F.5)

donde

α1 = θm(0−) +

˙θm(0−)

p

(F.6a)

α2 = −

˙θm(0−)

p

(F.6b)

Aplicando la transformada de Laplace inversa, podemos escribir θm(t) en la forma

θm(t) = θm(0−) +

˙θm(0−)

p

(
1 − e

−pt)
(F.7)

Derivando con respecto al tiempo esta expresión se obtiene la velocidad angular,

˙θm(t) = ˙θm(0−)e

−pt | (F.8)

Podemos comprobar que, si la condición inicial es el valor final de otro experimento, es decir, ˙θm(0−) = ˙θm,∞ =

KU
p

, se cumple, utilizando la expresión E.8, que ˙θm,∞ − ˙θm(t) coincide con la

relación F.8,

˙θm,∞ − ˙θm(t) = KU
p

e

−pt = ˙θm,∞e

−pt | (F.9)

Lo que esto significa, es que idealmente, las curvas de subida y de bajada de una señal cuadrada dan los mismos resultados. Sin embargo, debido a que los errores que se comenten en uno u otro experimento son distintos, ya que la subida se ve a afectada al comienzo por la fricción, y la bajada es al final, puede ocurrir que, en la práctica, el comportamiento sea distinto en una y otra situación. También podemos comprobar que el valor inical de la velocidad angular coincide con la condición inicial, y que el valor final es nulo,

˙θm(0⁺) = ˙θm(0−)

˙θm(∞) = 0

(F.10a)

(F.10b)

Este resultado es el esperado, ya que el motor es un sistema continuo que, al “apagarlo”, se termina deteniendo.
Sustituyendo F.8 en F.7,

θm(t) = θm(0−) + 1
p

(
˙θm(0−) − ˙θm(t)

)
(F.11)

Despejando p de la relación F.11,

p =

˙θm(0−) − ˙θm(t)
θm(t) − θm(0−)
, | t > 0
− | (F.12)

## G. Obtención analítica del polo del motor con una señal de entrada cuadrada

Supongamos que el experimento se ha realizado de tal manera que la condición inicial se haya obtenido aplicando una señal de entrada escalón al motor bajo condiciones iniciales nulas de duración suficiente como para que se haya alcanzado el régimen permanente, y que en el instante de tiempo t0 se “apaga” bruscamente el motor. Es decir, que se ha realizado un experimento con una señal cuadrada. Entonces se cumplirá la relación E.11 donde ˙θm(t0) = ˙θm,∞ siendo ˙θm,∞ el valor de la velocidad angular en el régimen permanente cuando la entrada ha sido una señal escalón. De aquí que las igualdades E.11 y F.12 deban coincidir en el caso ideal,

p =

˙θm,∞

˙θm,∞t0 − θm(t0)

=

˙θm,∞ − ˙θm(t)
θm(t) − θm(t0)

(G.1)

De la igualdad de la izquierda de G.1, se obtiene que

θm(t0) = ˙θm,∞t0 −

˙θm,∞

p

(G.2)

Sustituyendo esta relación en la expresión de la derecha de G.1, y simplificando, se obtiene que,

1 =

˙θm,∞ − ˙θm(t)

p

(
θm(t) − ˙θm,∞t0

)
+ ˙θm,∞

(G.3)

Despejando p de G.3,

p =

˙θm(t)

˙θm,∞t0 − θm(t)

, | t ≥ t0 | (G.4)

Sabemos que el motor se detiene cuando t → ∞, es decir que ˙θm(∞) = 0. Puesto que el polo debe tener un valor finito, necesariamente ˙θm,∞t0 − θm(∞) = 0. Como consecuencia, la posición angular final del motor vendrá dada por la expresión,

θm(∞) = ˙θm,∞t0 | (G.5)

Teniendo en cuenta la expresión G.4, se deberá cumplir que en t = t0,

˙θm(t0) = ˙θm,∞ y

p =

˙θm,∞

˙θm,∞t0 − θm(t0)

(G.6)

La expresión G.6 puede escribirse en la forma,

1
p

= t0 −

θm(t0)

˙θm,∞

=

(
1 −

θm(t0)
θm(∞)

)
t0 | (G.7)

donde se ha tenido en cuenta la relación G.5.
Supongamos que el motor se detiene en t ≥ tp, entonces θm(∞) = θm(tp). De aquí que la relación G.7 también pueda escribirse en la forma,

1
p

=

θm(tp) − θm(t0)

˙θm,∞

(G.8)

donde se ha tenido en cuenta la relación G.5.

## H. Discretización del polo del motor obtenido con una entrada escalón bajo condiciones iniciales nulas

Al realizar un experimento con un microcontrolador se obtiene una secuencia de valores discretos de la salida del motor, por lo que la aplicación de la relación E.11 puede dar lugar a valores del polo dependientes del tiempo discreto. Es decir, haciendo t = tk en la relación E.11,

p(tk) =

˙θm(tk)
˙θm(∞)tk − θm(tk)

(H.1)

donde k ∈ {0, 1, · · · } representa un índice temporal.
En general, los instantes de tiempo en los que se realizan las medidas no están uniformemente separados, pero si las medidas se hiciesen uniformemente en el tiempo con un periodo de muestreo constante T, entonces tk = kT.
Por otro lado, si solo se han realizado medidas de posición, no se conoce la velocidad angular, por lo que deberá hacerse alguna aproximación sobre su valor. Supongamos que se utiliza la primera aproximación de Euler de la derivada, es decir,

˙θm(tk) ≈

θm(tk) − θm(tk−1)

tk − tk−1

(H.2)

Hay que tener en cuenta que, para k = 0, no es posible obtener la velocidad angular a partir de esta expresión. Pero puesto que el experimento se está haciendo bajo condiciones iniciales nulas, ˙θm(t0) = ˙θm(0) = 0.
Supongamos también que las medidas de la posición angular no vienen dadas en radianes, sino por el número de pulsos de un encoder incremental situado en el eje del motor. Entonces, para k > 0,

p(tk) ≈

Nm(tk) − Nm(tk−1)

(tk − tk−1)

(
q

˙θm(∞)

2π

tk − Nm(tk)

) | (H.3)

donde Nm(tk) representa el número de pulsos medido en el instante de tiempo tk en el eje del motor y q es el número de pulsos por vuelta (CPR, Cycles Per Revolution) del encoder incremental.

## I. Discretización del polo del motor obtenido con una entrada nula bajo condiciones iniciales no nulas

En esta Sección se seguirá el mismo procedimiento que en la Sección H, pero para el caso estudiado en la Sección F donde el polo viene dado por la expresión F.12.
La aplicación de la relación F.12, haciendo t = tk, es

p(tk) =

˙θm(0−) − ˙θm(tk)
θm(tk) − θm(0−)

(I.1)

donde k ∈ {0, 1, · · · } representa un índice temporal.
Supongamos que solo se han realizado medidas con un encoder incremental situado en el eje del motor y que la velocidad angular se aproxima por la primera aproximación de Euler de la derivada. Entonces,

p(tk) ≈

q

˙θm(0)

2π

(tk − tk−1) − Nm(tk) + Nm(tk−1)
(tk − tk−1) (Nm(tk) − Nm(0)) | (I.2)

donde Nm(tk) representa el número de pulsos medido en el instante de tiempo tk en el eje del motor y q es el número de pulsos por vuelta (CPR, Cycles Per Revolution) del encoder incremental.
Si el valor de la velocidad angular inicial ˙θm(0) no se ha podido obtener como una medida sino como un cálculo a partir de la medida de posición angular de un encoder incremental, entonces se puede utilizar la primera aproximación de Euler de la derivada, pero será necesario conocer el valor θm(t−1). Este valor no será, en general, nulo, y dependerá de cómo se haya alcanzado el estado inicial.

## J. Discretización del polo del motor obtenido con una señal de entrada cuadrada

La expresión de p(tk) bajo el supuesto de que la señal de entrada es una señal cuadrada, es decir, a partir de la relación dada por G.4, viene dada por

p(tk) =

˙θm(tk)

˙θm,∞t0 − θm(tk)

, | tk ≥ t0 | (J.1)

Suponiendo que se realizan medidas con un encoder incremental, y se aproxima la velocidad angular por la primera aproximación de Euler de la derivada,

p(tk) = | Nm(tk) − Nm(tk−1)

(tk − tk−1)

(
q

˙θm,∞t0

2π

− Nm(tk)

) | tk ≥ t0 | (J.2)

donde q es el número de pulsos por vuelta (CPR, Cycles Per Revolution) del encoder incremental. Por último, la relación G.8 permite obtener un valor del polo con valores extremos de la respuesta a una señal cuadrada.
El promedio temporal de la velocidad angular de toda la trayectoria de bajada, utilizando la aproximación de Euler de la derivada, viene dado por

˙θ =

∑

kp

j=k0+1

(θ(j) − θ(j − 1))

T (kp − k0)

(J.3)

donde se ha hecho tp = kpT y t0 = k0T siendo tp el instante de tiempo en que el motor se detiene. Puesto que
∑

kp

j=k0+1

(θ(j) − θ(j − 1)) = θ(kp) − θ(k0) | (J.4)

la relación G.8 puede escribirse en la forma,

1
p

=

T (kp − k0)

˙θ

˙θm,∞

(J.5)

Si kf ≥ kp con el motor parado, conviene escribir la expresión J.5 en la forma

1
p

=

θ(kf ) − θ(k0)

˙θm,∞

(J.6)
