juandiz/SCARMOV_1.0/diseño_cad/boddy/acercamiento_tornillos.PNG

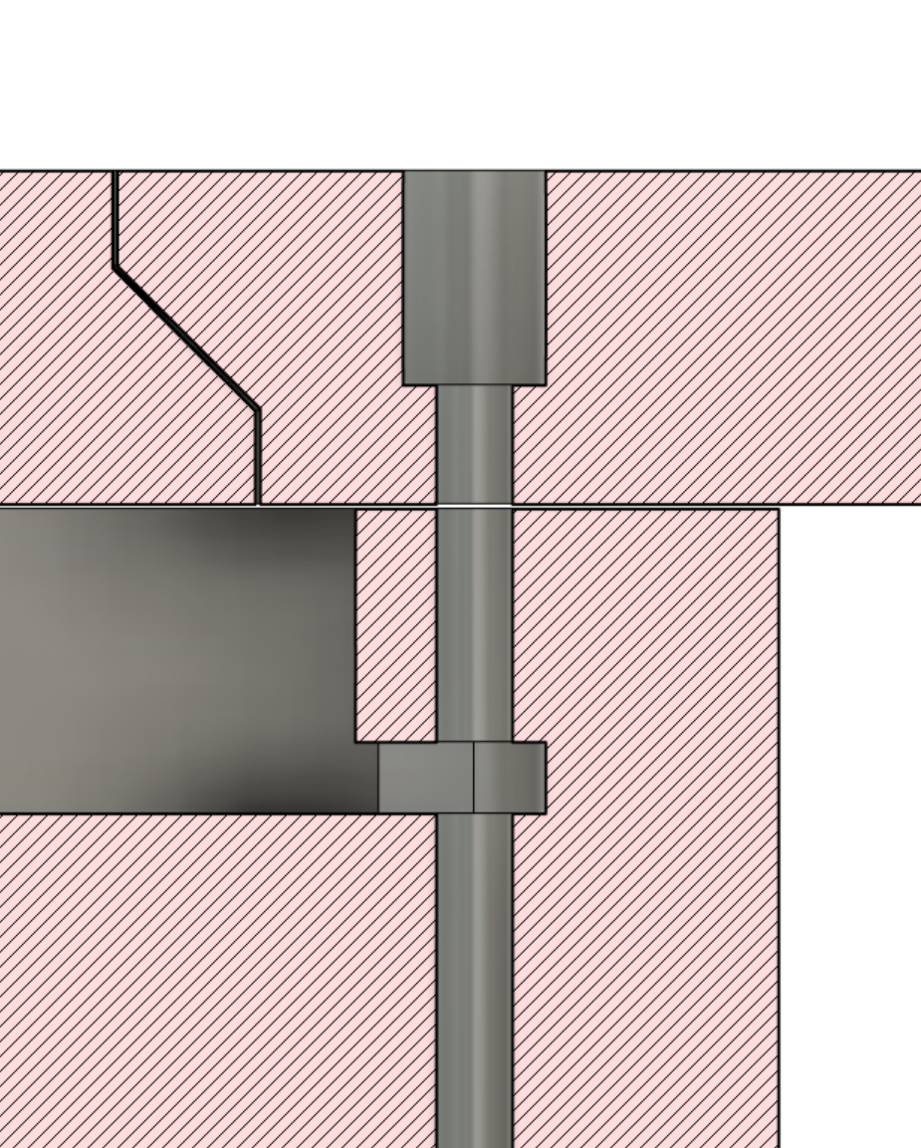
diseño_cad/boddy/acercamiento_tornillos.PNG
