juandiz/SCARMOV_1.0/diseño_cad/boddy/anexo versiones.PNG

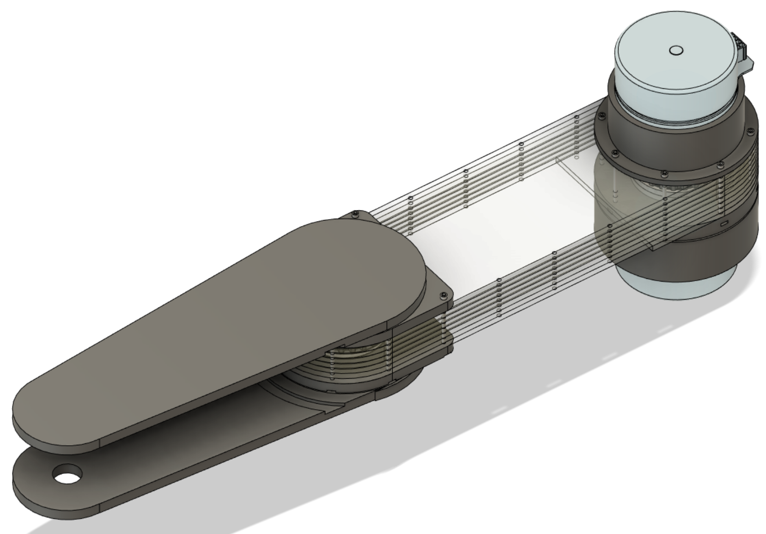
diseño_cad/boddy/anexo versiones.PNG
