juandiz/SCARMOV_1.0/diseño_cad/boddy/Anexo_v_corte_top.PNG

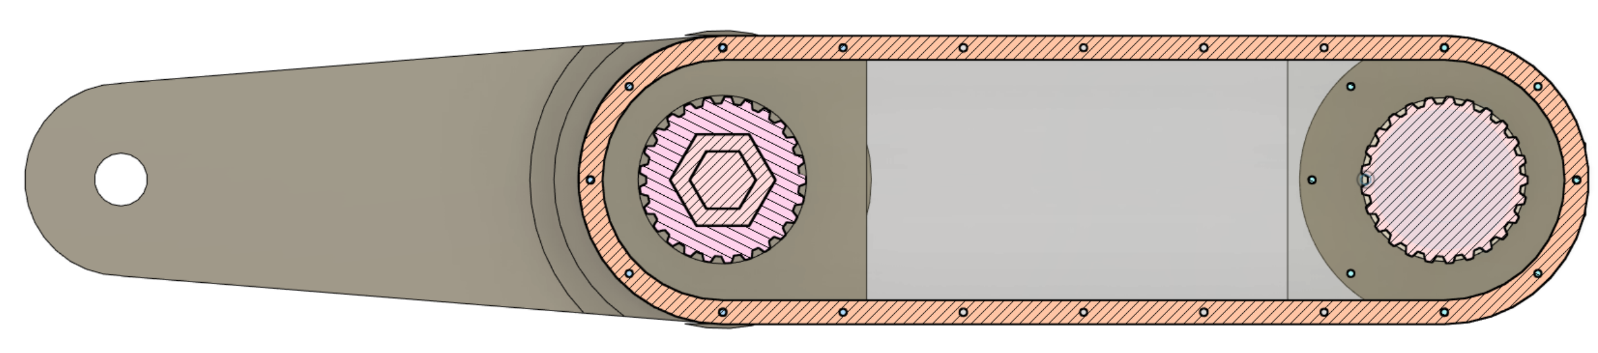
diseño_cad/boddy/Anexo_v_corte_top.PNG
