juandiz/SCARMOV_1.0/diseño_cad/boddy/corte V5.PNG

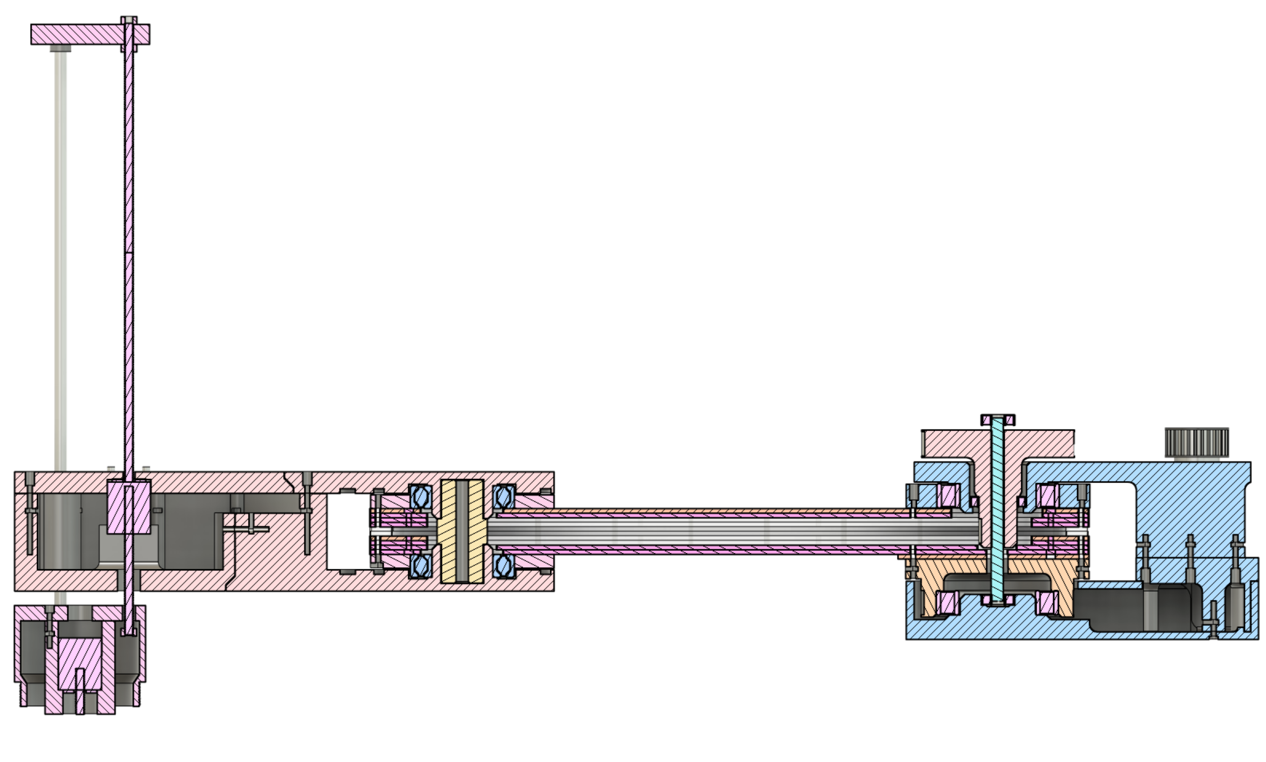
diseño_cad/boddy/corte V5.PNG
