juandiz/SCARMOV_1.0/diseño_cad/boddy/eslabon2_recorte_sistemaM3.png

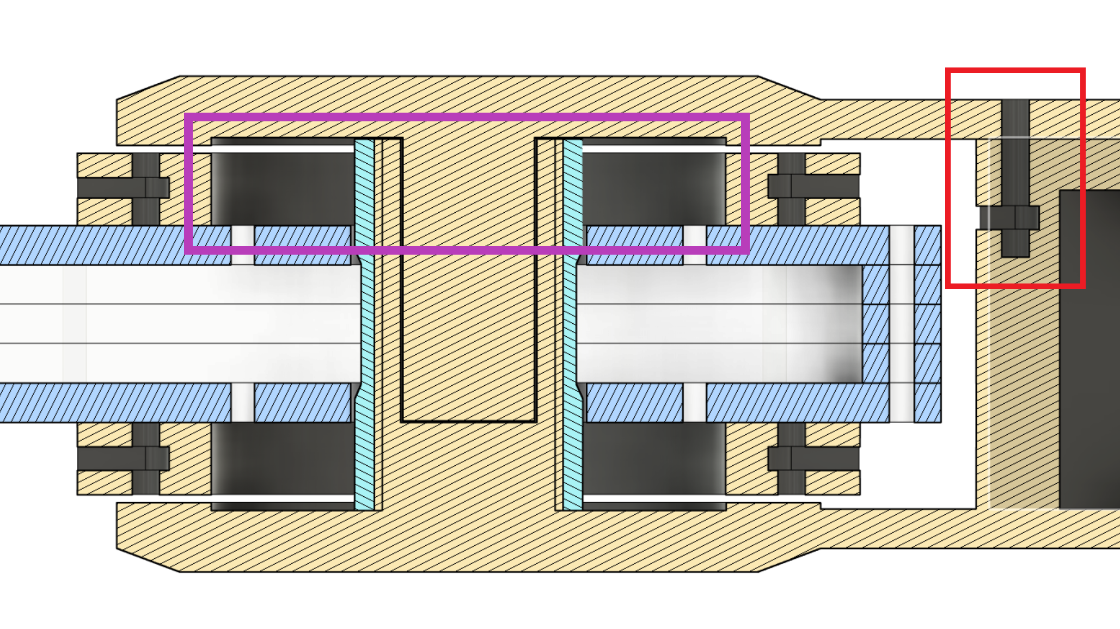
diseño_cad/boddy/eslabon2_recorte_sistemaM3.png
