juandiz/SCARMOV_1.0/diseño_cad/boddy/eslabon 2_V2.PNG

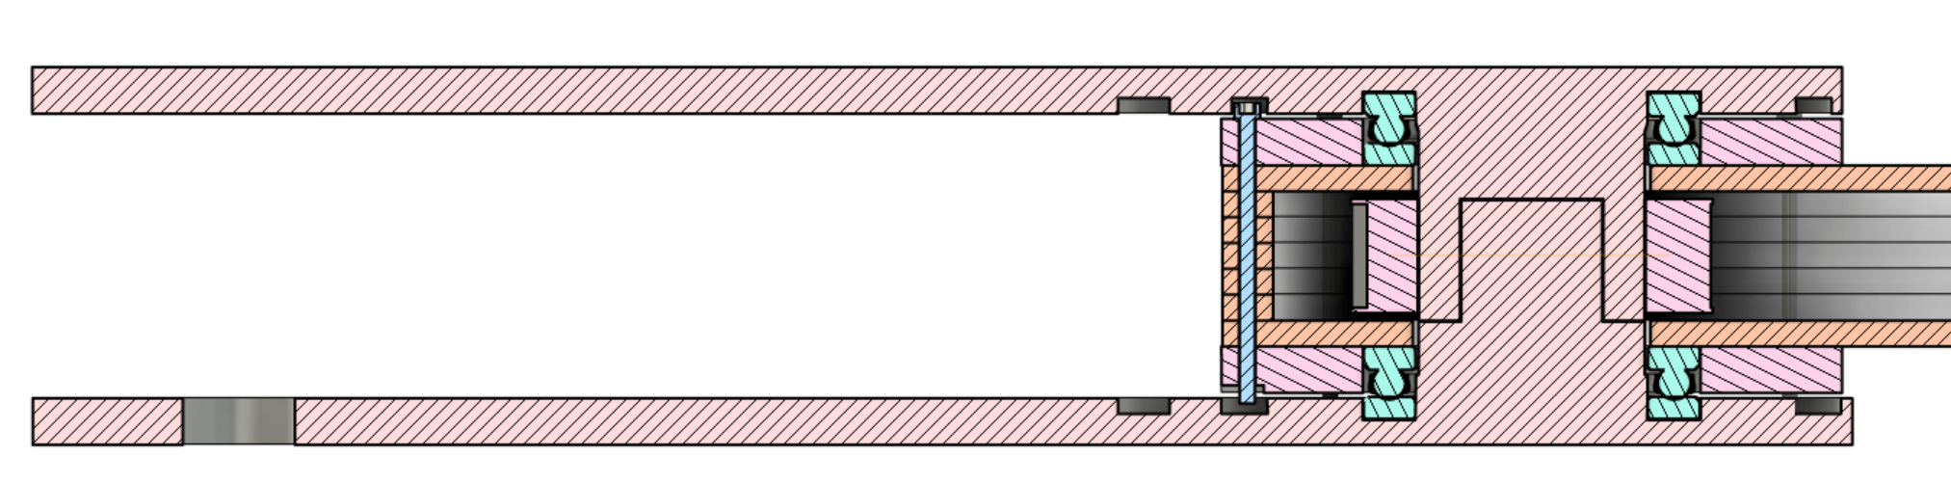
diseño_cad/boddy/eslabon 2_V2.PNG
