juandiz/SCARMOV_1.0/diseño_cad/boddy/tempsnip.png

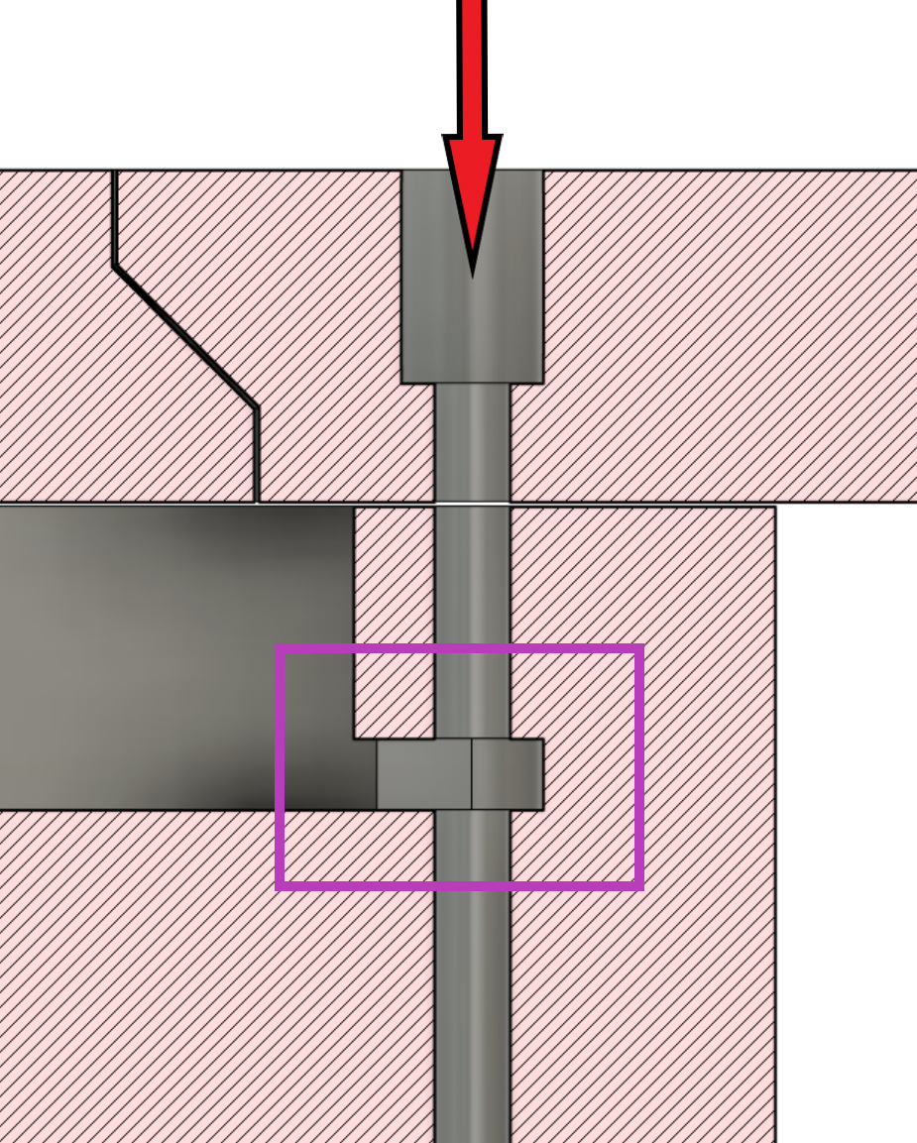
diseño_cad/boddy/tempsnip.png
