juandiz/SCARMOV_1.0/diseño_cad/boddy/v5.PNG

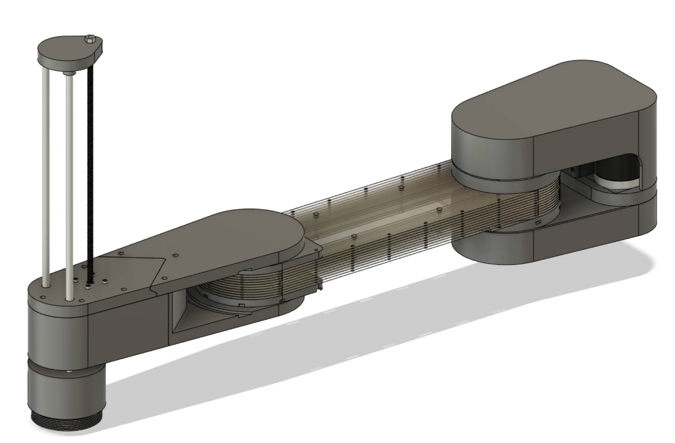
diseño_cad/boddy/v5.PNG
