juandiz/SCARMOV_1.0/diseño_cad/boddy/v5_CUT.PNG

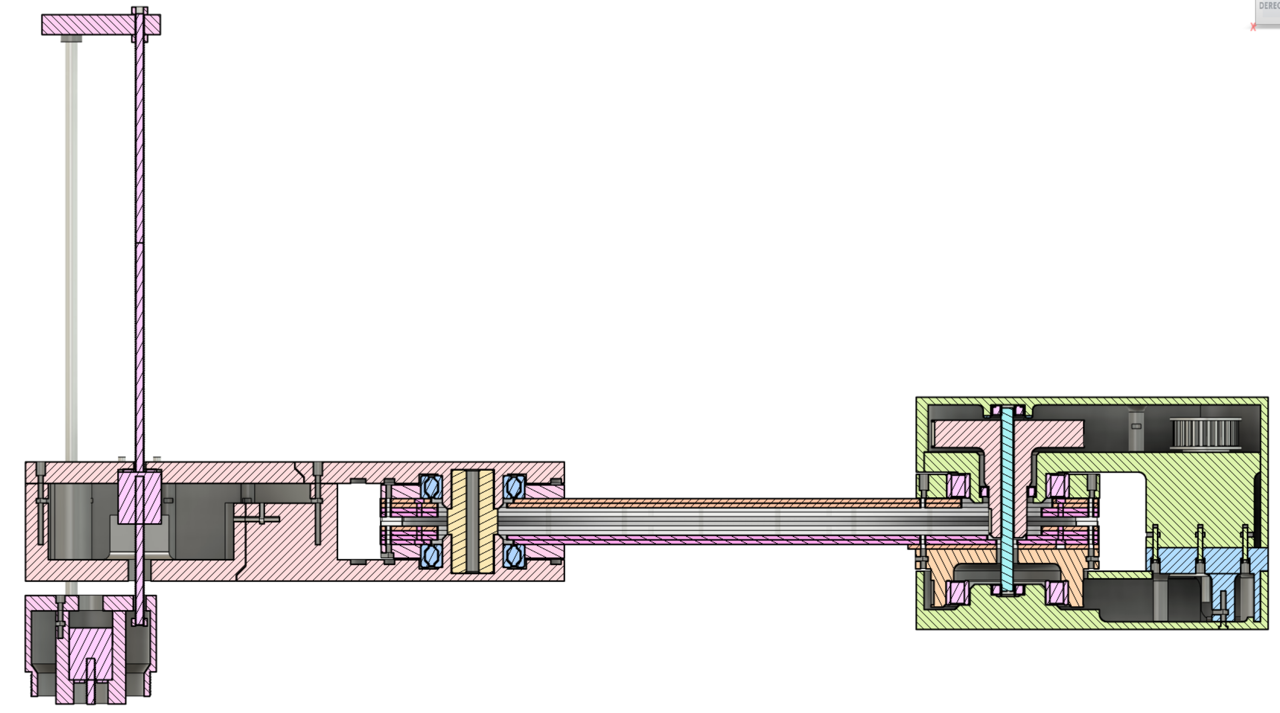
diseño_cad/boddy/v5_CUT.PNG
