juandiz/SCARMOV_1.0/diseño_cad/boddy/v5_IN1.PNG

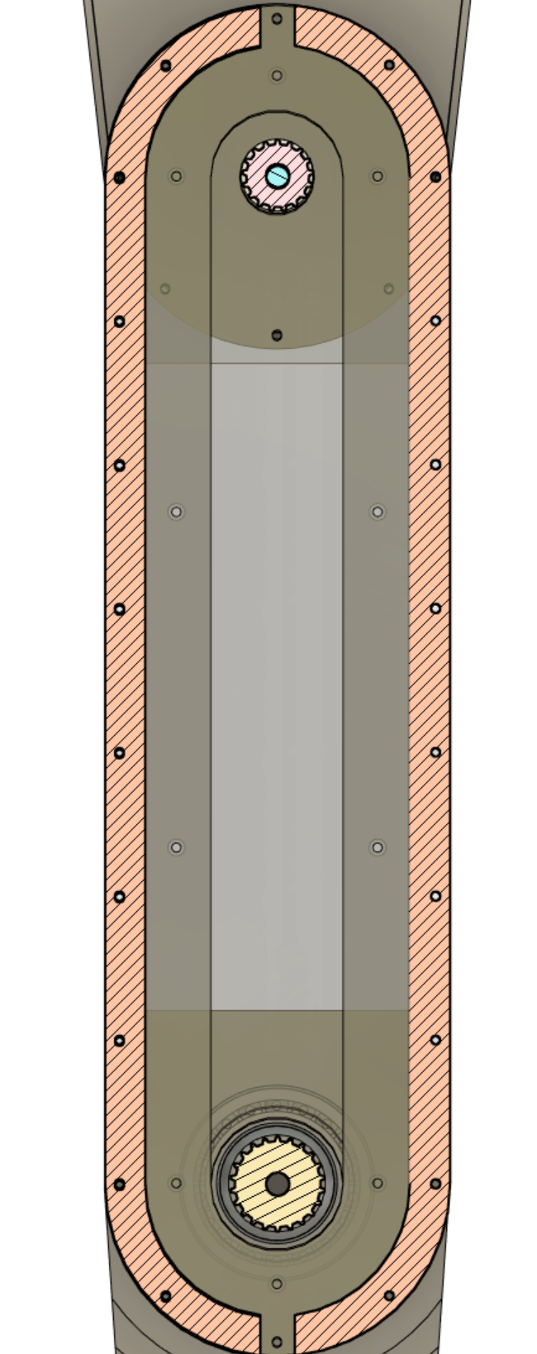
diseño_cad/boddy/v5_IN1.PNG
