juandiz/SCARMOV_1.0/diseño_cad/Complete_design/Base.png

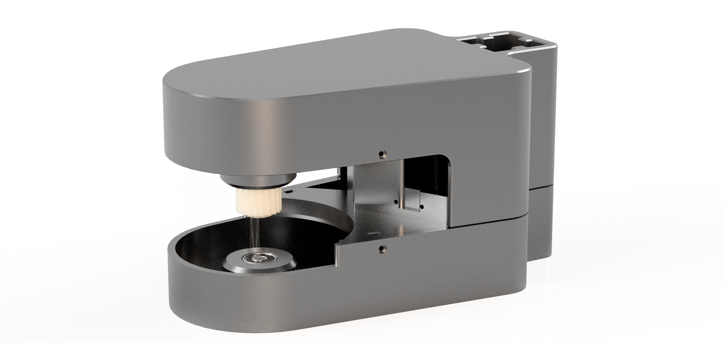
diseño_cad/Complete_design/Base.png
