juandiz/SCARMOV_1.0/diseño_cad/Complete_design/base/base_P1.png

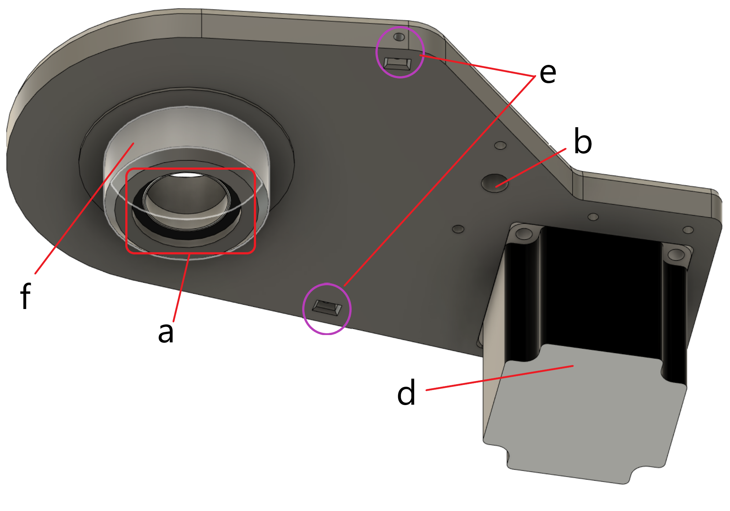
diseño_cad/Complete_design/base/base_P1.png
