juandiz/SCARMOV_1.0/diseño_cad/Complete_design/base/bot.png

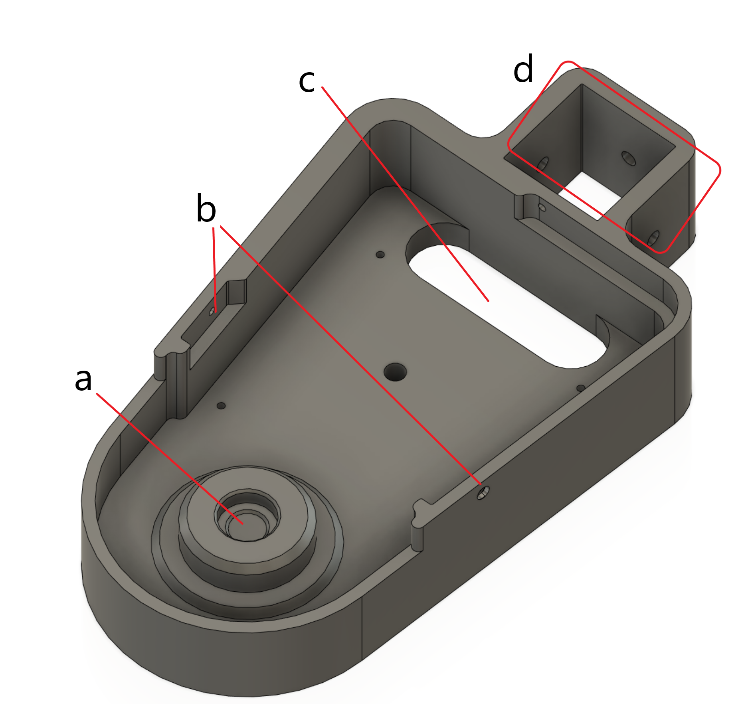
diseño_cad/Complete_design/base/bot.png
