juandiz/SCARMOV_1.0/diseño_cad/Complete_design/base/coste interno sistema pol2.PNG

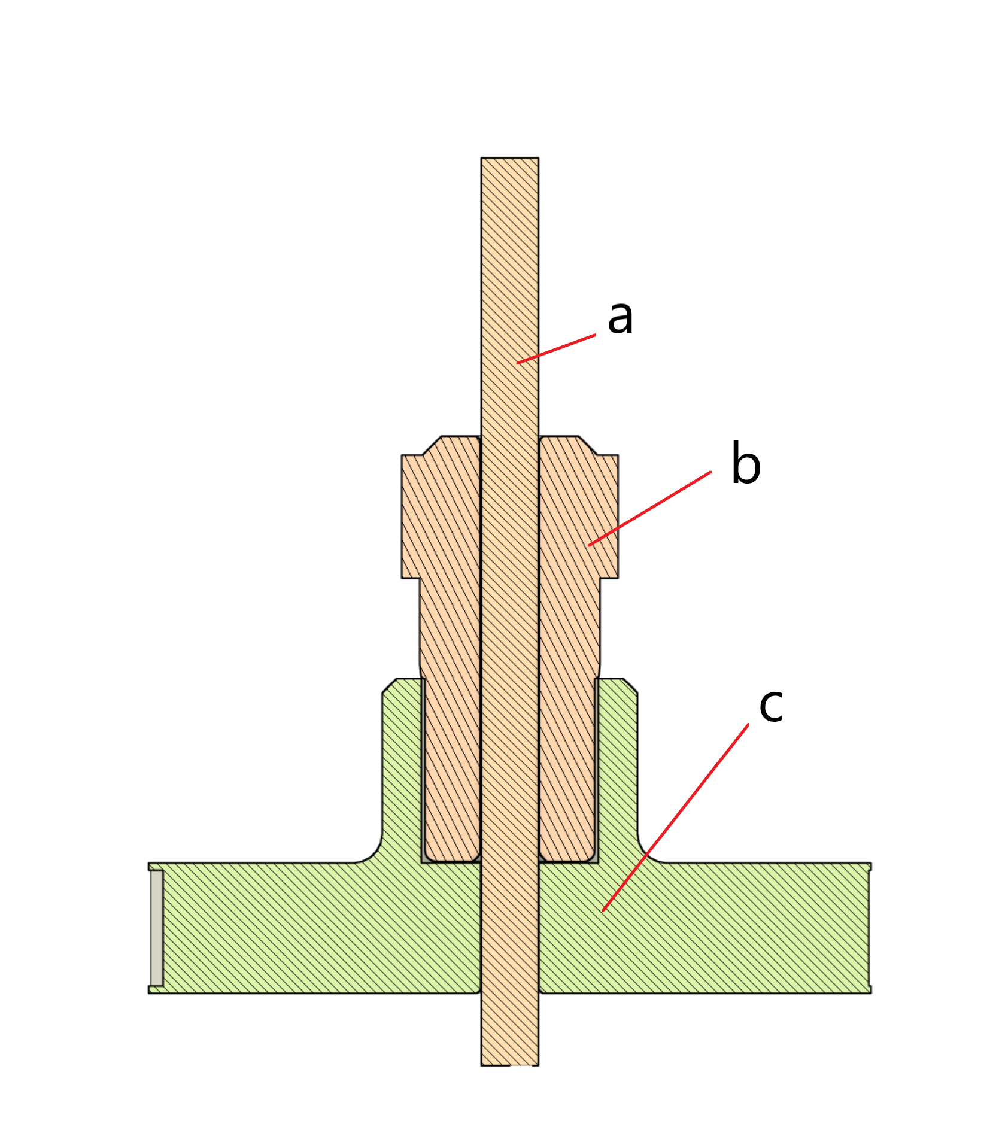
diseño_cad/Complete_design/base/coste interno sistema pol2.PNG
