juandiz/SCARMOV_1.0/diseño_cad/Complete_design/base/pulley_cut__.png

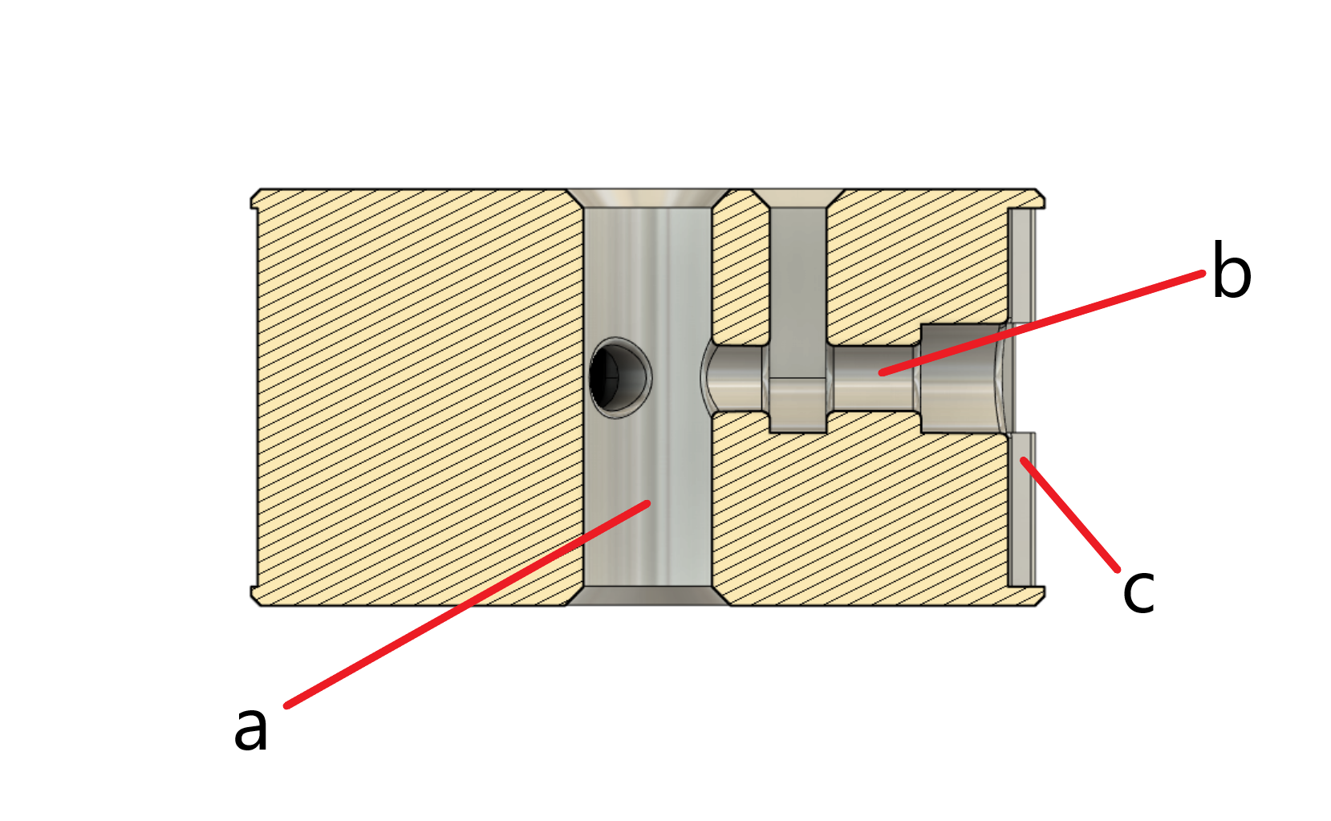
diseño_cad/Complete_design/base/pulley_cut__.png
