juandiz/SCARMOV_1.0/diseño_cad/Complete_design/base/pulley_top.png

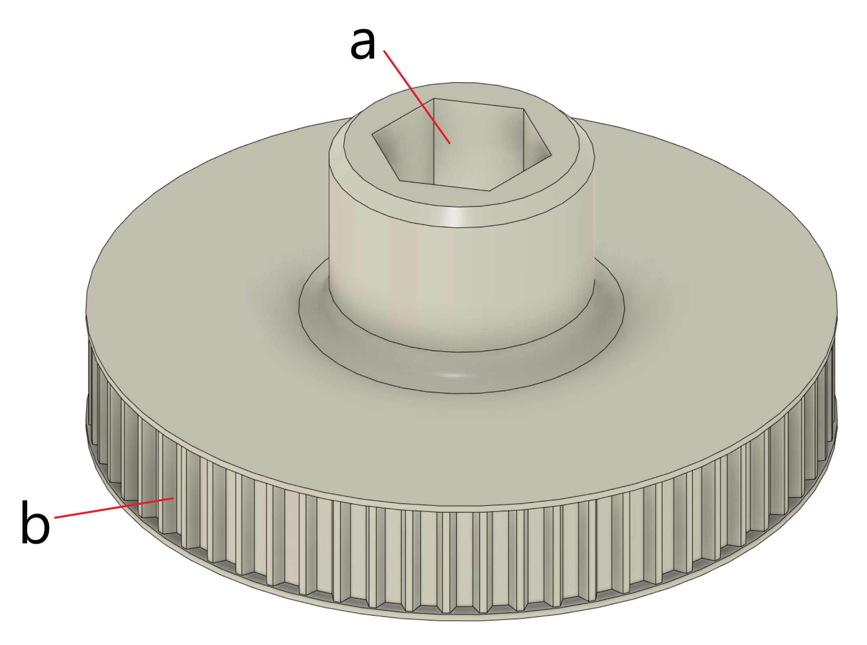
diseño_cad/Complete_design/base/pulley_top.png
