juandiz/SCARMOV_1.0/diseño_cad/Complete_design/base/sujecion_m1.png

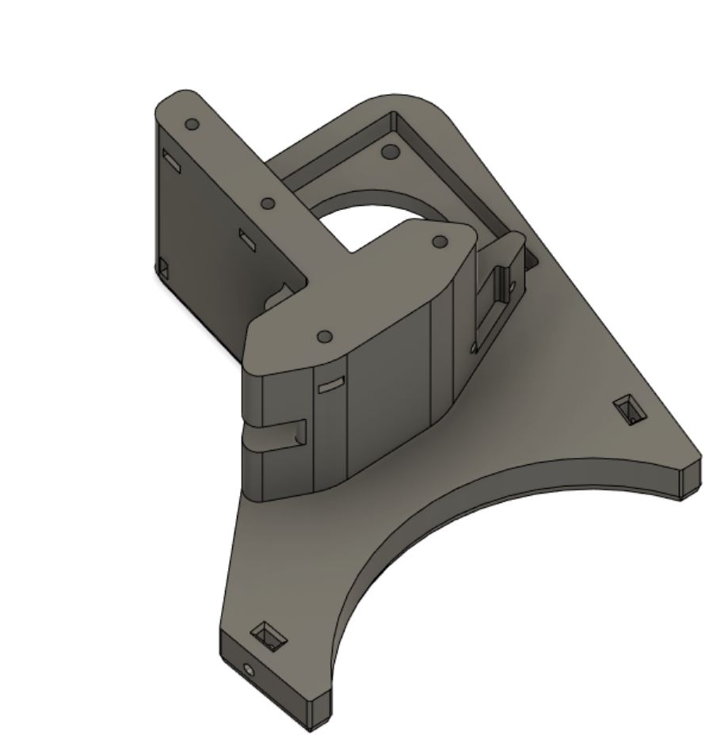
diseño_cad/Complete_design/base/sujecion_m1.png
