juandiz/SCARMOV_1.0/diseño_cad/Complete_design/base/tensor2cut.PNG

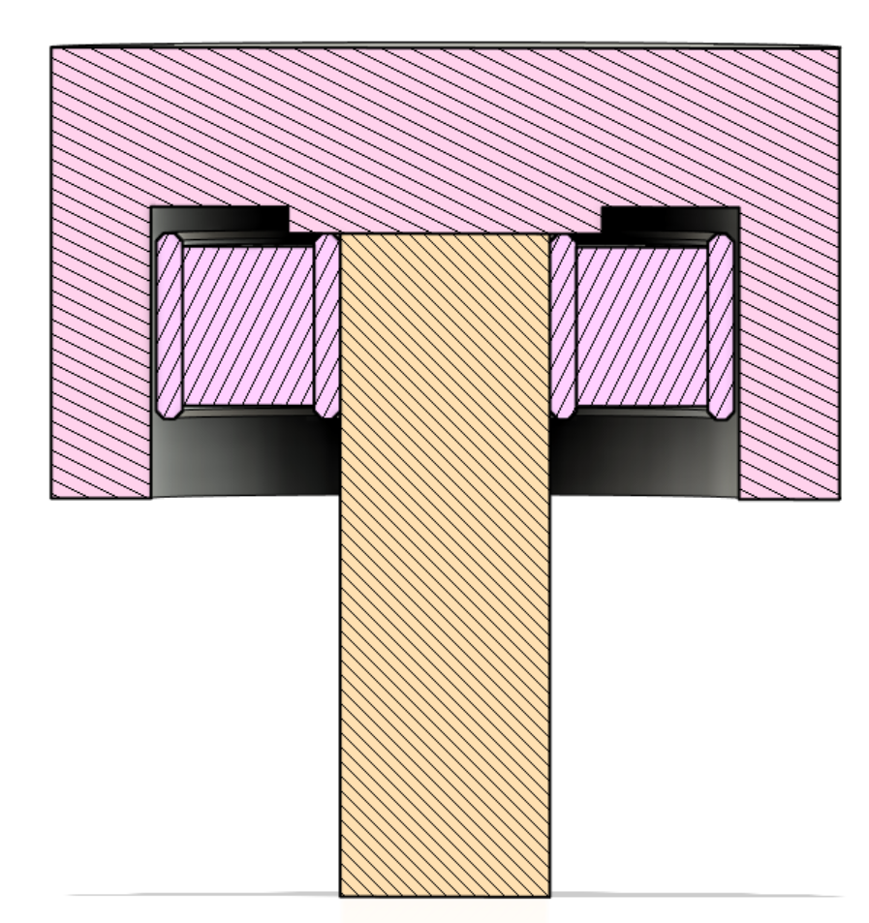
diseño_cad/Complete_design/base/tensor2cut.PNG
