juandiz/SCARMOV_1.0/diseño_cad/Complete_design/base/Top_bas2.PNG

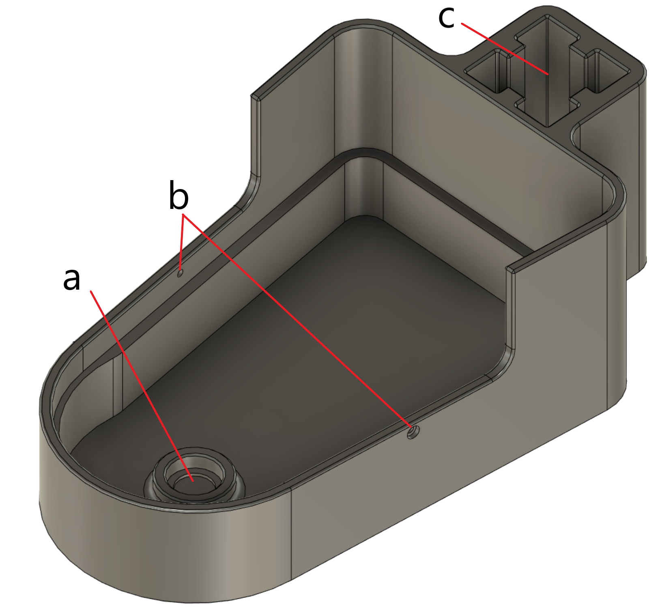
diseño_cad/Complete_design/base/Top_bas2.PNG
