juandiz/SCARMOV_1.0/diseño_cad/Complete_design/esb1/cuerpo2.PNG

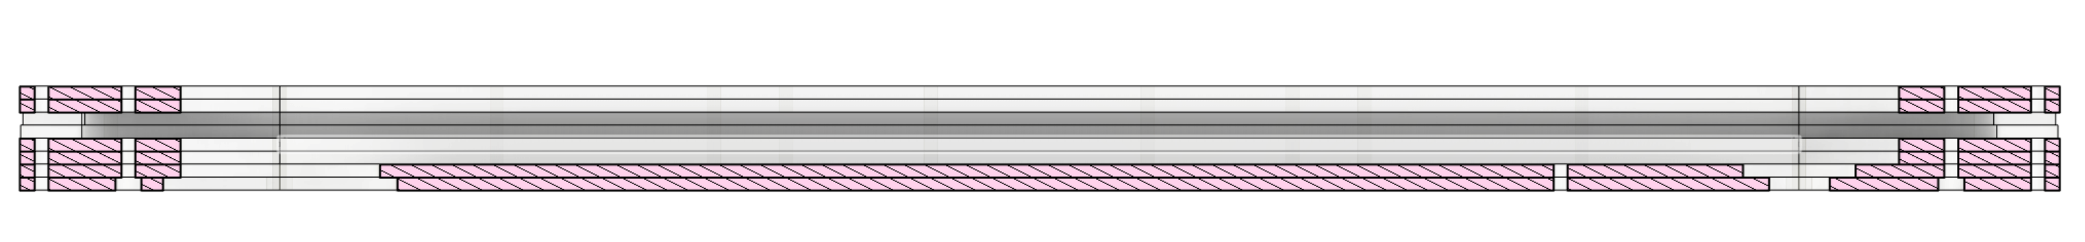
diseño_cad/Complete_design/esb1/cuerpo2.PNG
