juandiz/SCARMOV_1.0/diseño_cad/Complete_design/esb1/cuerpo_bot.PNG

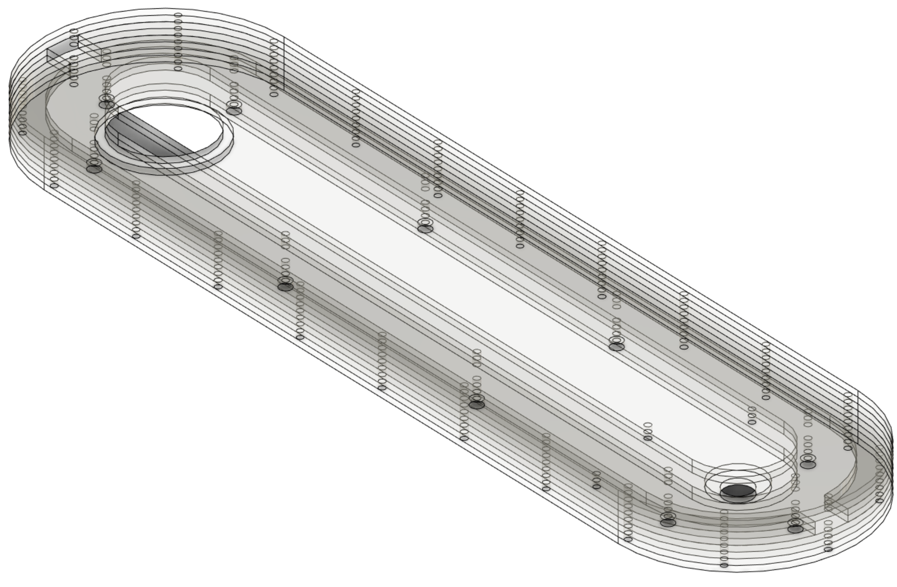
diseño_cad/Complete_design/esb1/cuerpo_bot.PNG
