juandiz/SCARMOV_1.0/diseño_cad/Complete_design/esb1/cuerpo_top2.PNG

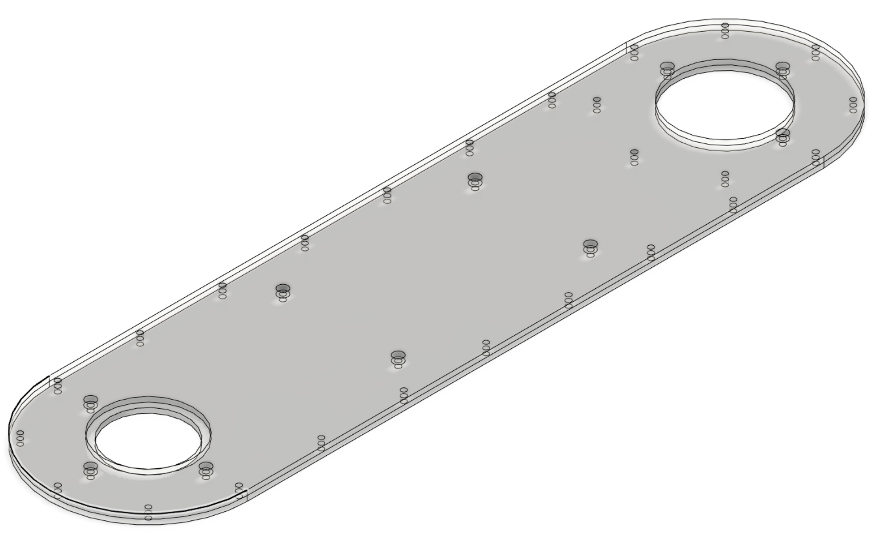
diseño_cad/Complete_design/esb1/cuerpo_top2.PNG
