juandiz/SCARMOV_1.0/diseño_cad/Complete_design/esb1/sujecion1_base_inf4.PNG

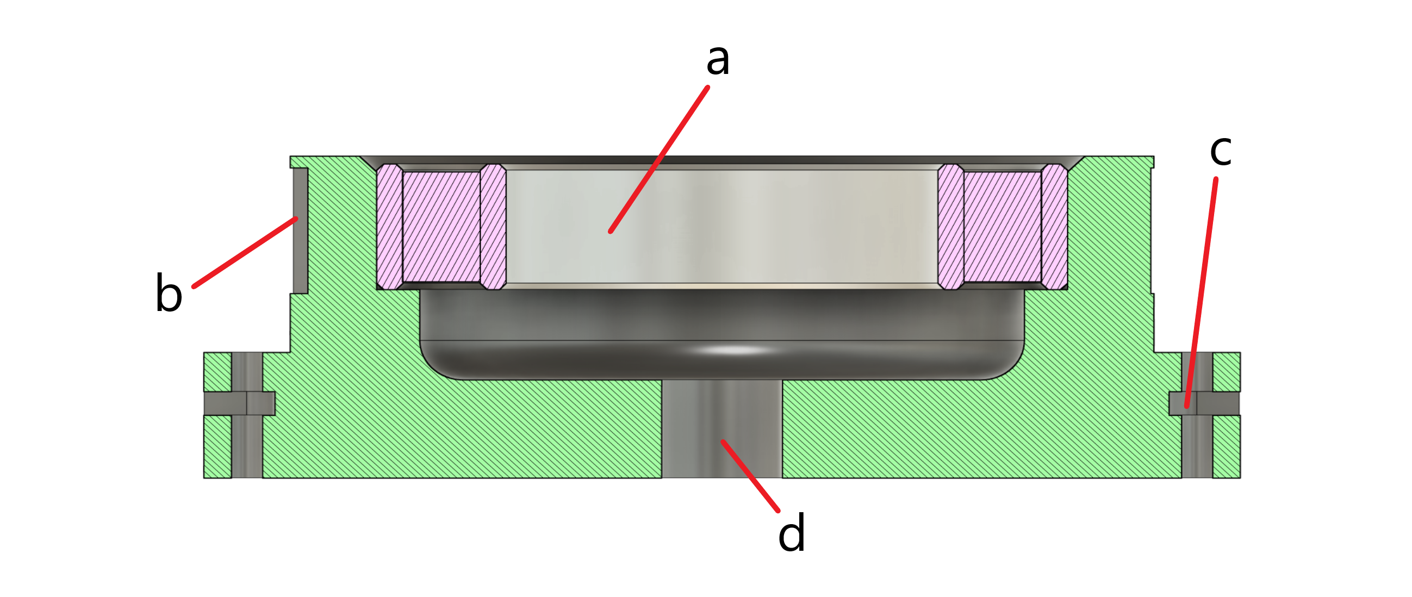
diseño_cad/Complete_design/esb1/sujecion1_base_inf4.PNG
