juandiz/SCARMOV_1.0/diseño_cad/Complete_design/esb1/sujecion2_cut.PNG

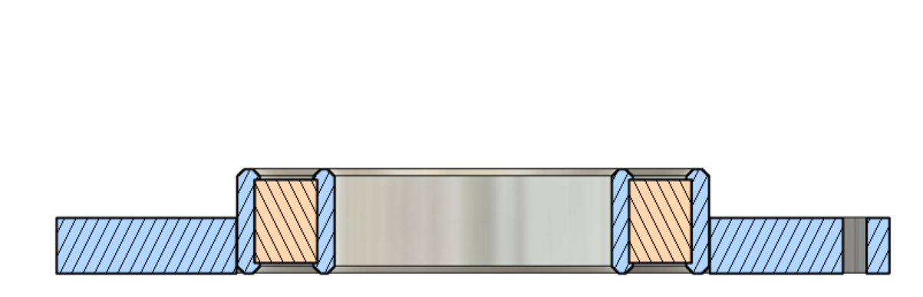
diseño_cad/Complete_design/esb1/sujecion2_cut.PNG
