juandiz/SCARMOV_1.0/diseño_cad/Complete_design/esb1/sujecion3_2.PNG

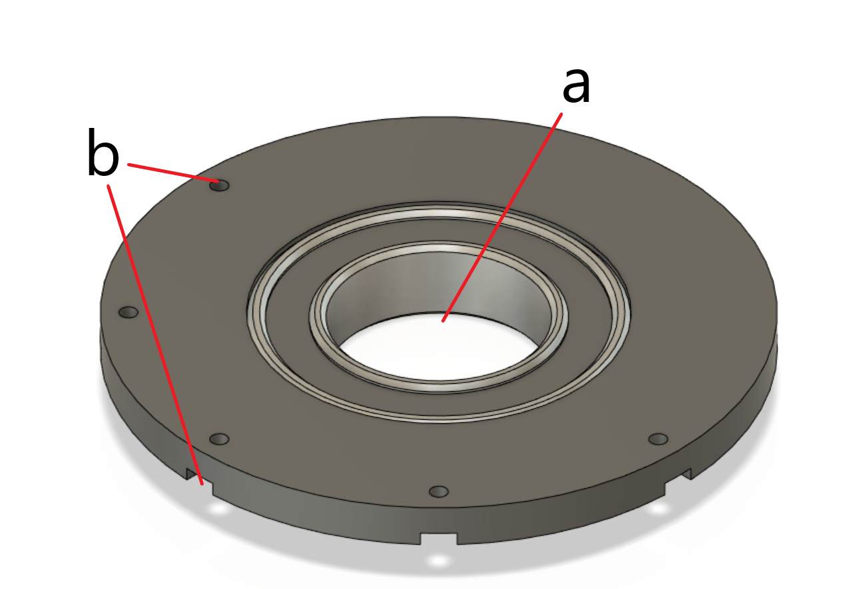
diseño_cad/Complete_design/esb1/sujecion3_2.PNG
