juandiz/SCARMOV_1.0/diseño_cad/Complete_design/esb1/sujecion3_cut.PNG

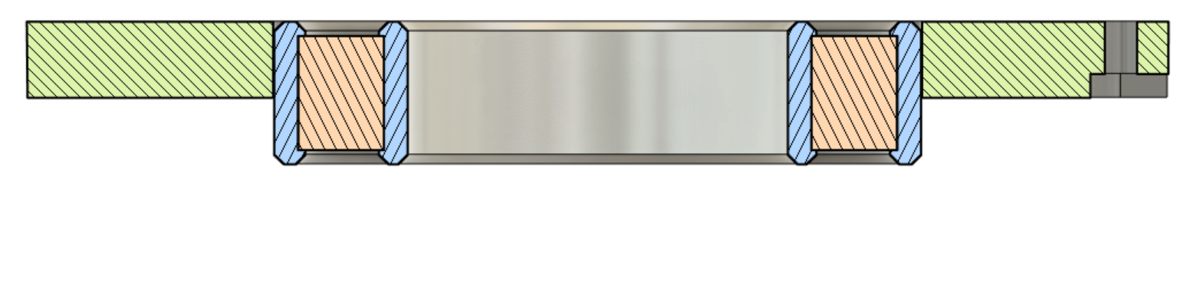
diseño_cad/Complete_design/esb1/sujecion3_cut.PNG
