juandiz/SCARMOV_1.0/diseño_cad/Complete_design/esb1/sujeción_1_base2.PNG

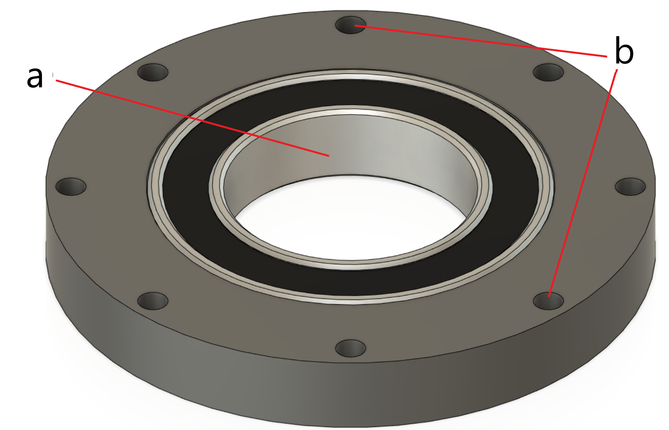
diseño_cad/Complete_design/esb1/sujeción_1_base2.PNG
