juandiz/SCARMOV_1.0/diseño_cad/Complete_design/esb1/sujeción_1_basec2.PNG

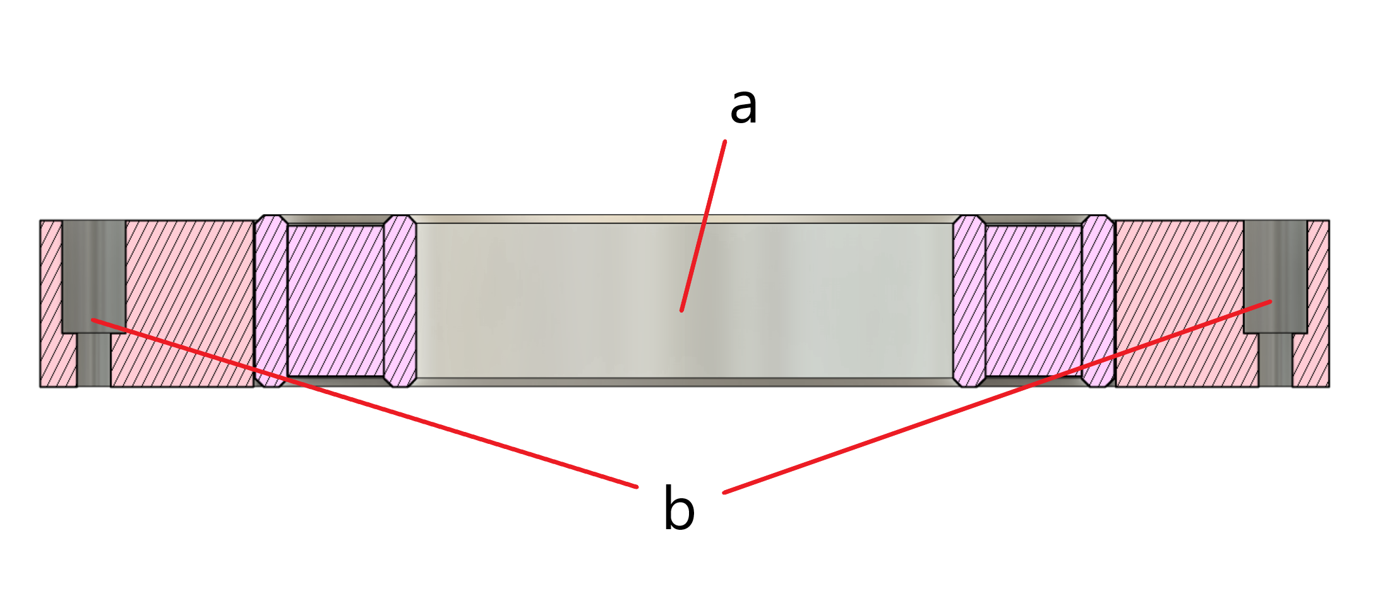
diseño_cad/Complete_design/esb1/sujeción_1_basec2.PNG
