juandiz/SCARMOV_1.0/diseño_cad/Complete_design/esb2/bot1_cut__.PNG

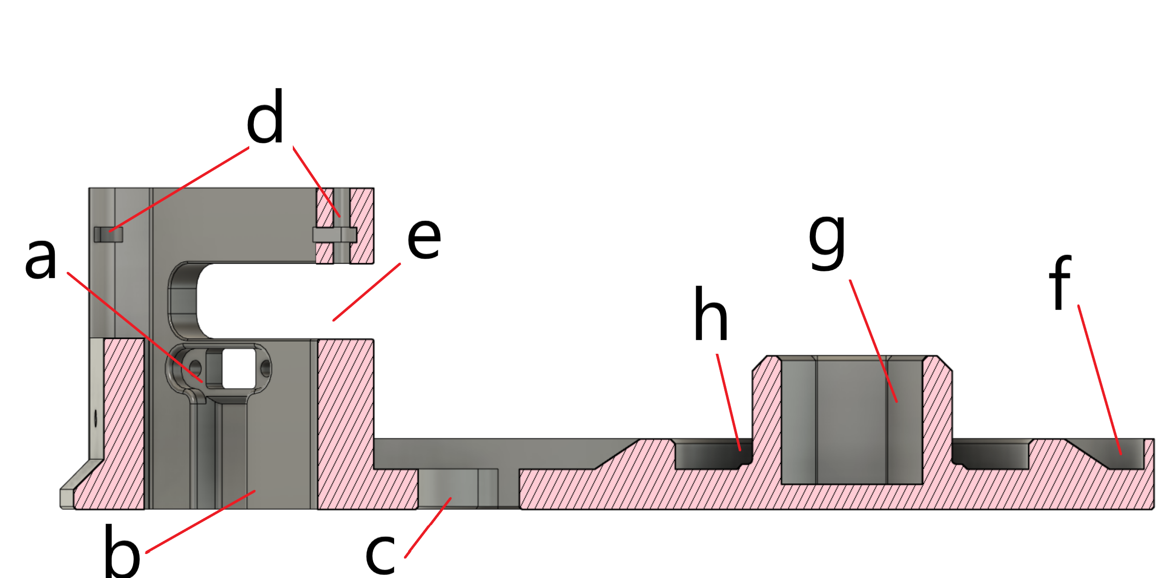
diseño_cad/Complete_design/esb2/bot1_cut__.PNG
