juandiz/SCARMOV_1.0/diseño_cad/Complete_design/esb2/Final_V10 v46.png

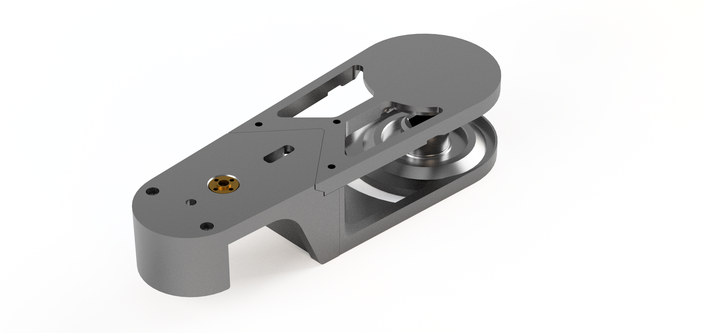
diseño_cad/Complete_design/esb2/Final_V10 v46.png
