juandiz/SCARMOV_1.0/diseño_cad/Complete_design/esb2/pull21cut.PNG

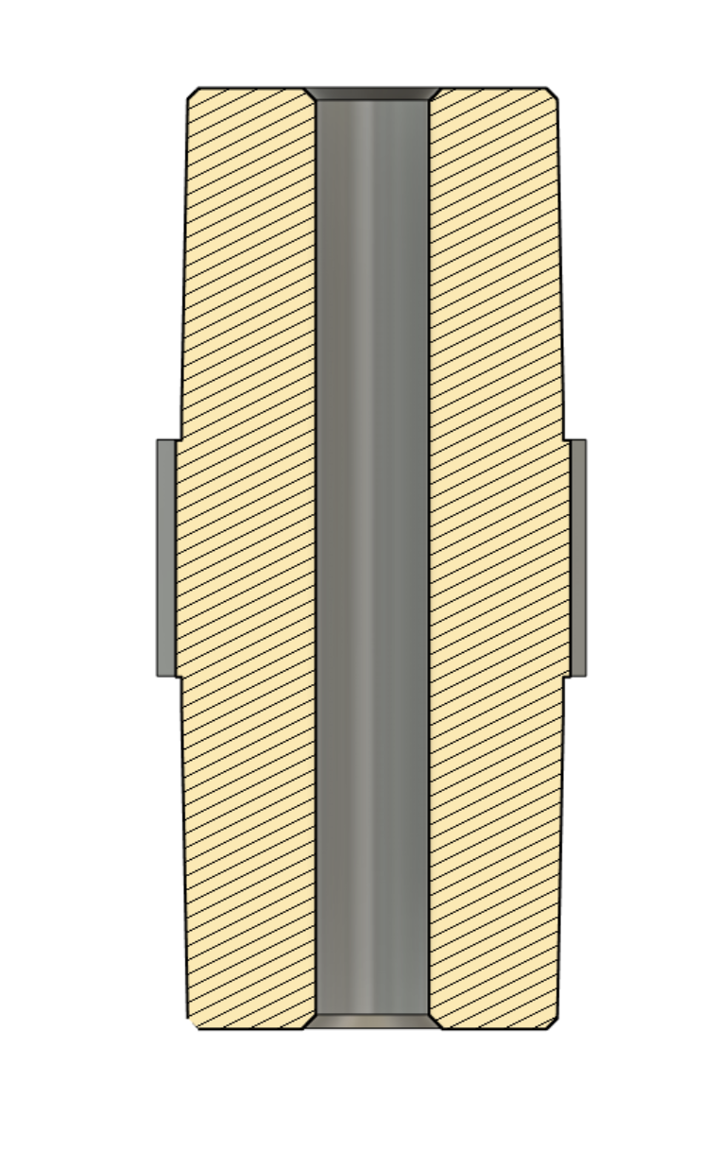
diseño_cad/Complete_design/esb2/pull21cut.PNG
