juandiz/SCARMOV_1.0/diseño_cad/Complete_design/esb2/sj3.PNG

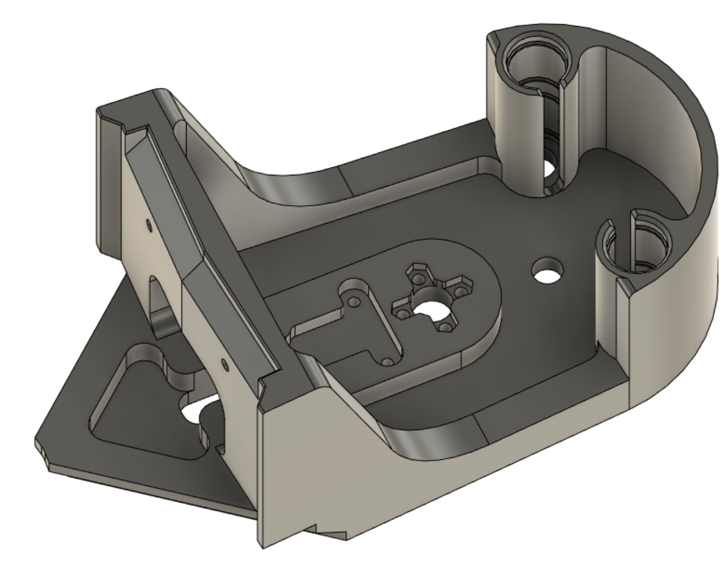
diseño_cad/Complete_design/esb2/sj3.PNG
