juandiz/SCARMOV_1.0/diseño_cad/Complete_design/esb2/top_cut_.PNG

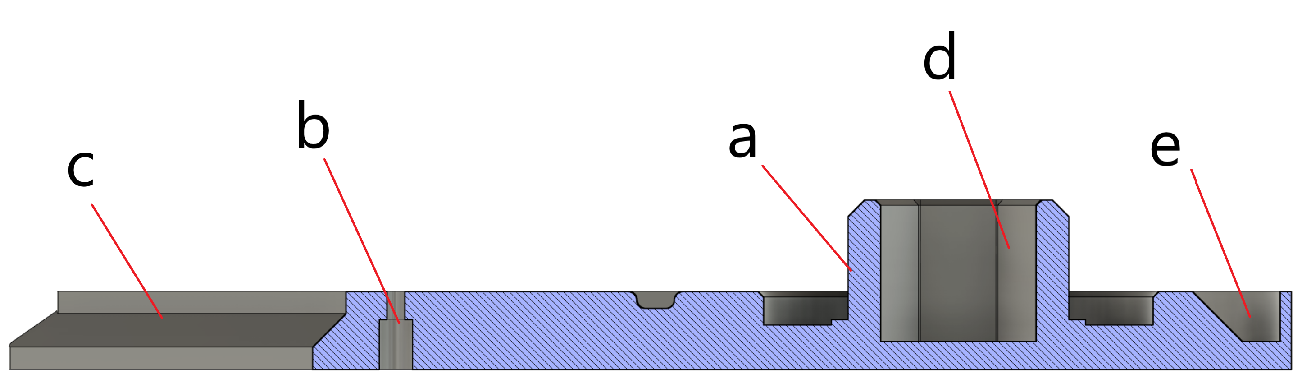
diseño_cad/Complete_design/esb2/top_cut_.PNG
