juandiz/SCARMOV_1.0/diseño_cad/Complete_design/esb3/grpr__.PNG

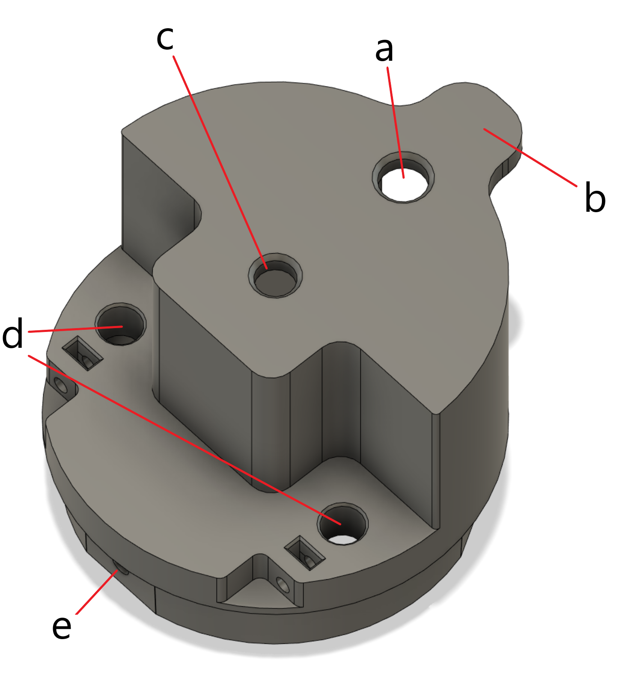
diseño_cad/Complete_design/esb3/grpr__.PNG
