juandiz/SCARMOV_1.0/diseño_cad/Complete_design/esb3/grpr_cut2.PNG

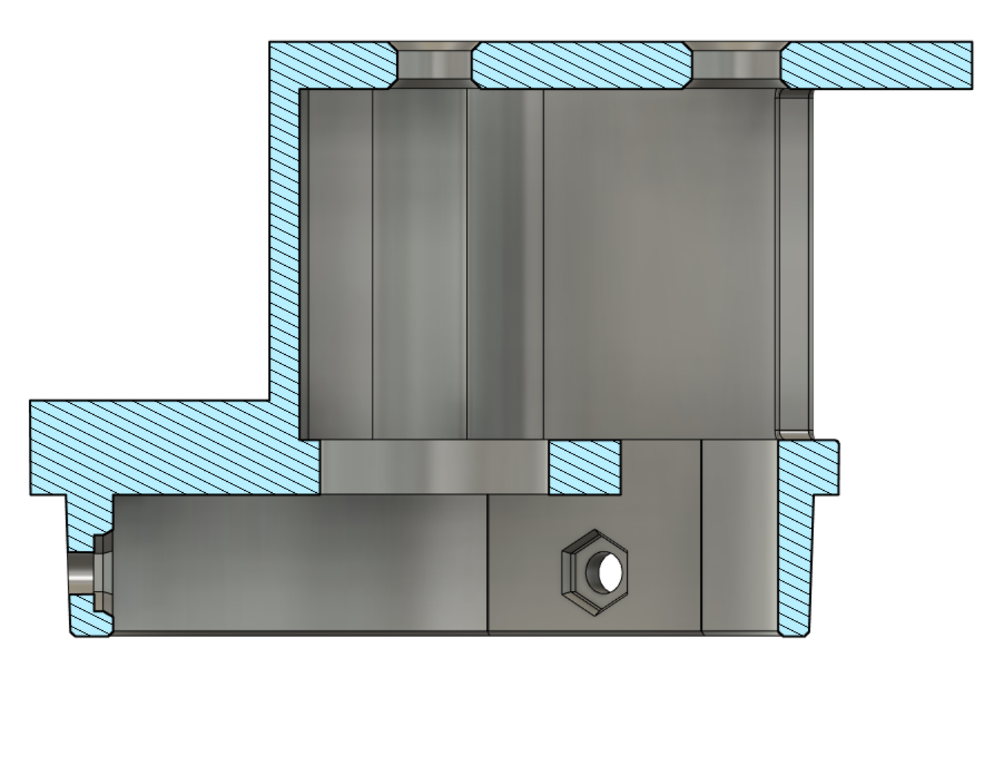
diseño_cad/Complete_design/esb3/grpr_cut2.PNG
