juandiz/SCARMOV_1.0/diseño_cad/Complete_design/esb3/top1.PNG

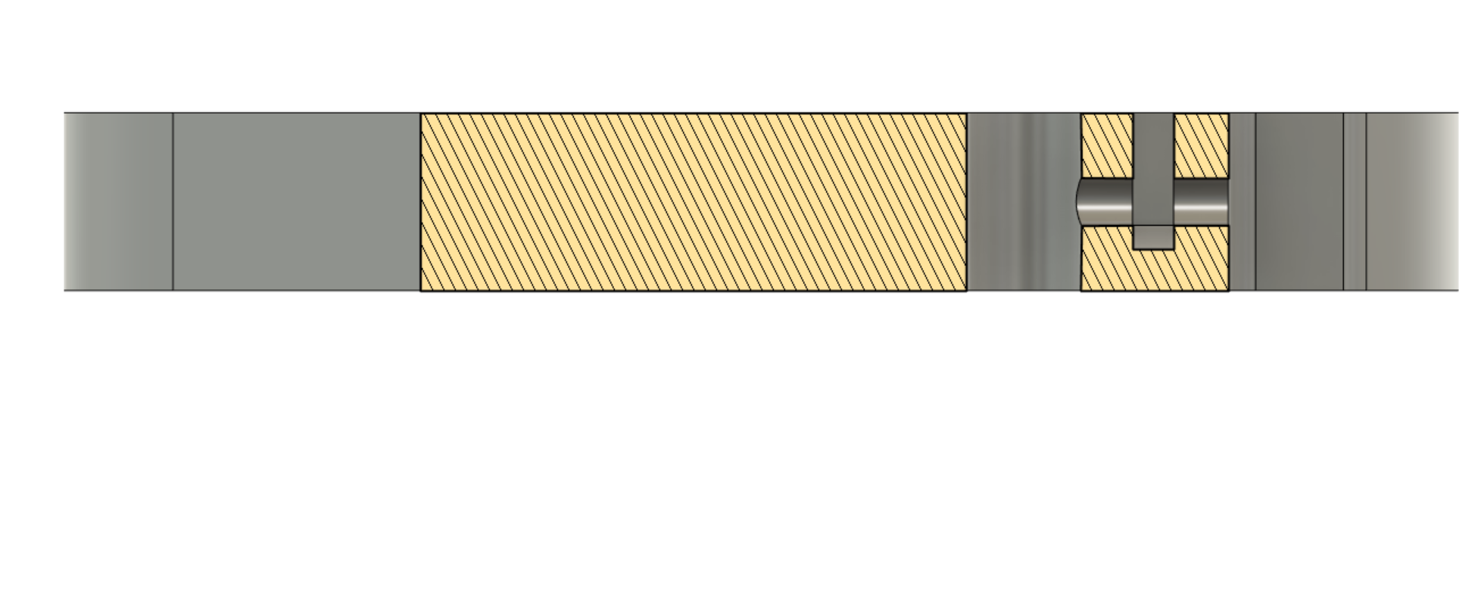
diseño_cad/Complete_design/esb3/top1.PNG
