juandiz/SCARMOV_1.0/diseño_cad/Complete_design/esb3/top2.PNG

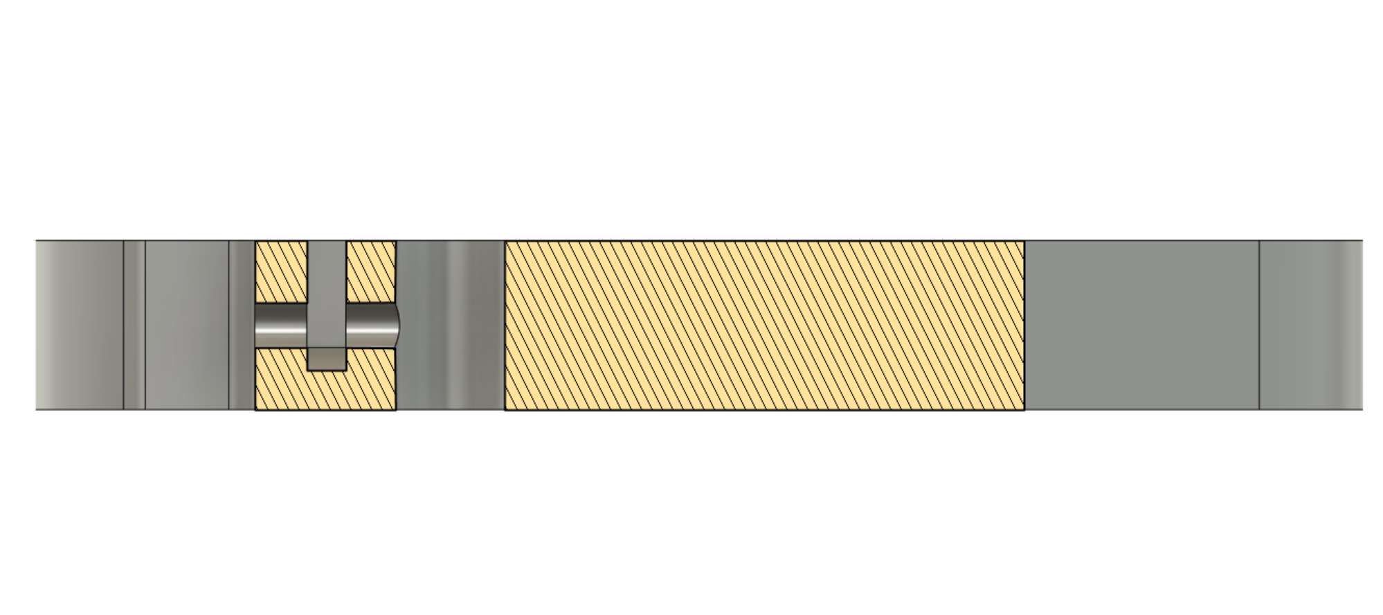
diseño_cad/Complete_design/esb3/top2.PNG
