juandiz/SCARMOV_1.0/diseño_cad/Complete_design/Final_V10__.png

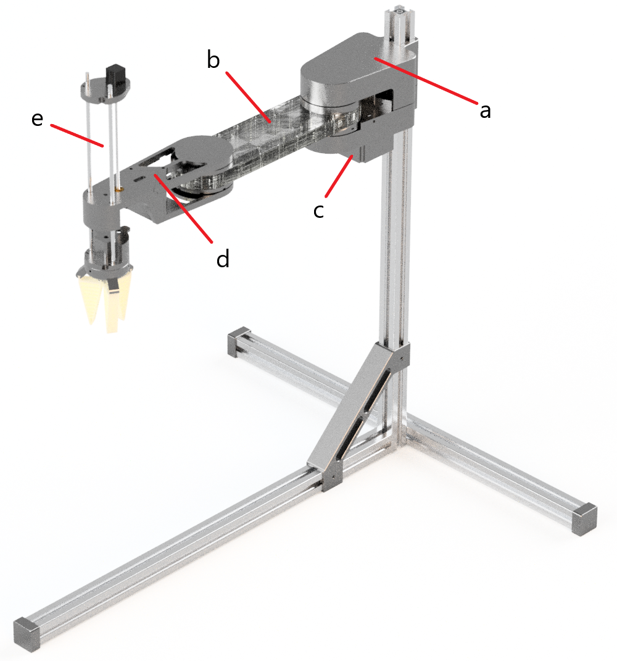
diseño_cad/Complete_design/Final_V10__.png
