juandiz/SCARMOV_1.0/diseño_cad/Complete_design/pcb/PCB_box v12.png

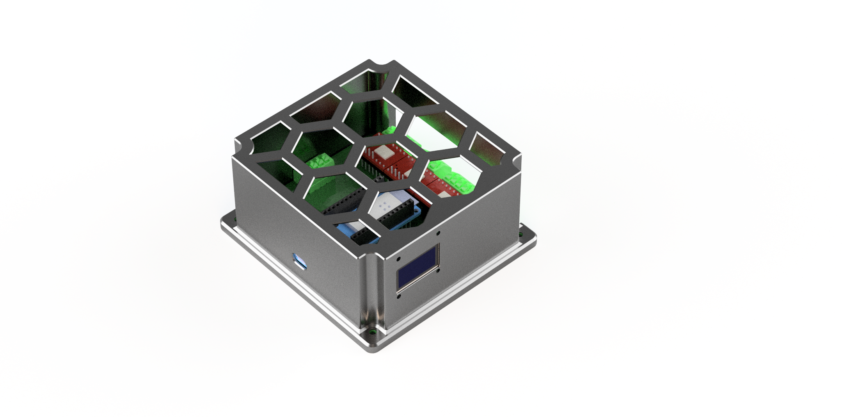
diseño_cad/Complete_design/pcb/PCB_box v12.png
