juandiz/SCARMOV_1.0/diseño_cad/complete_Impresion/1.jpeg

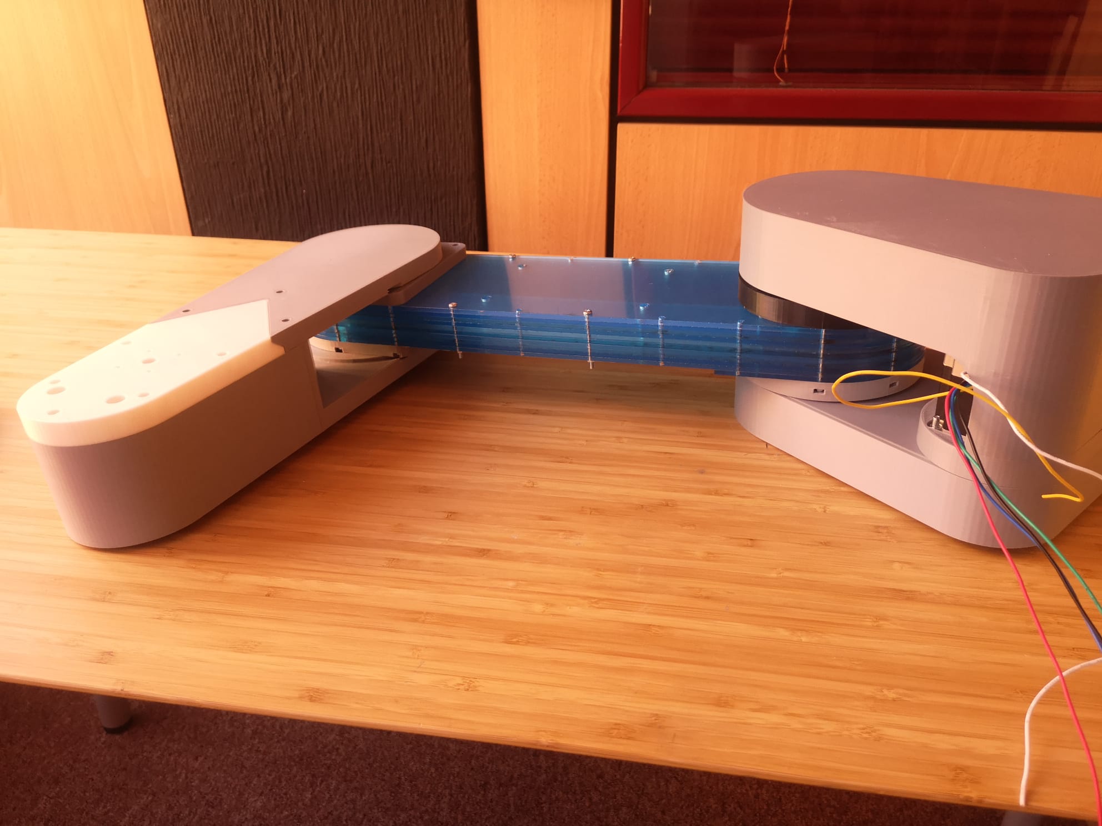
diseño_cad/complete_Impresion/1.jpeg
