juandiz/SCARMOV_1.0/diseño_cad/complete_Impresion/2.jpeg

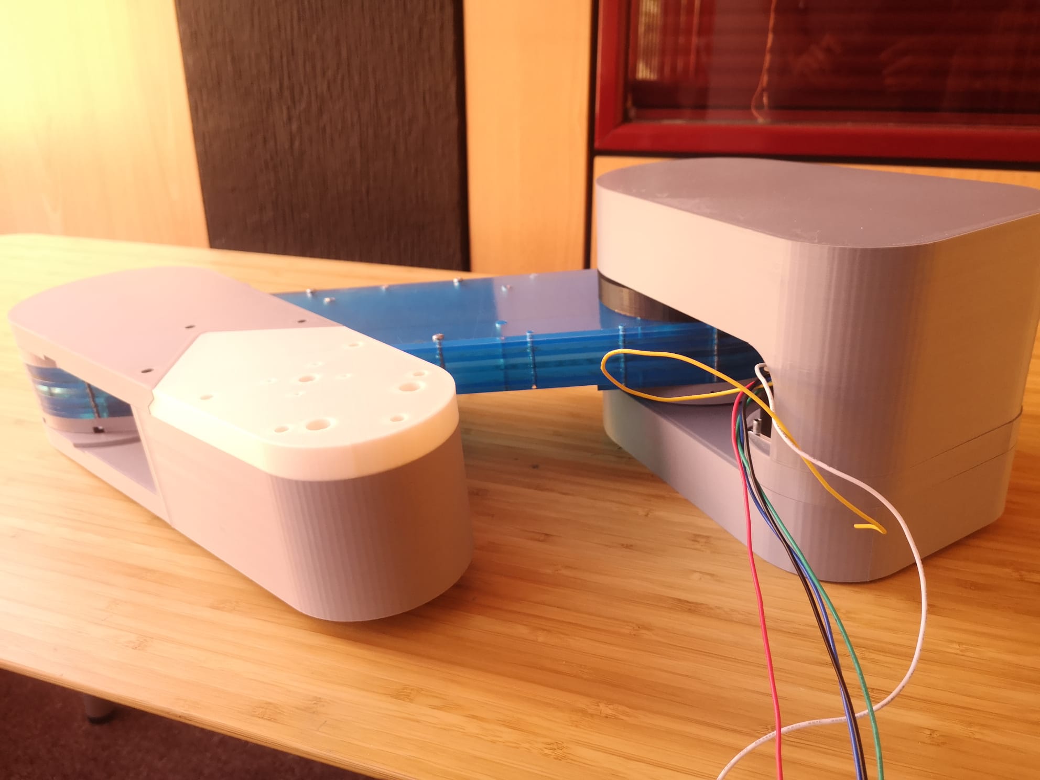
diseño_cad/complete_Impresion/2.jpeg
