juandiz/SCARMOV_1.0/diseño_cad/gripper/base_V7.PNG

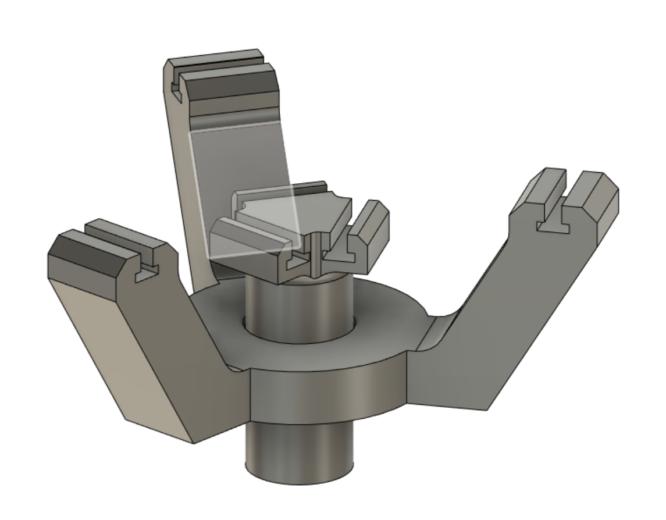
diseño_cad/gripper/base_V7.PNG
