juandiz/SCARMOV_1.0/diseño_cad/gripper/GRipper/support_motor.PNG

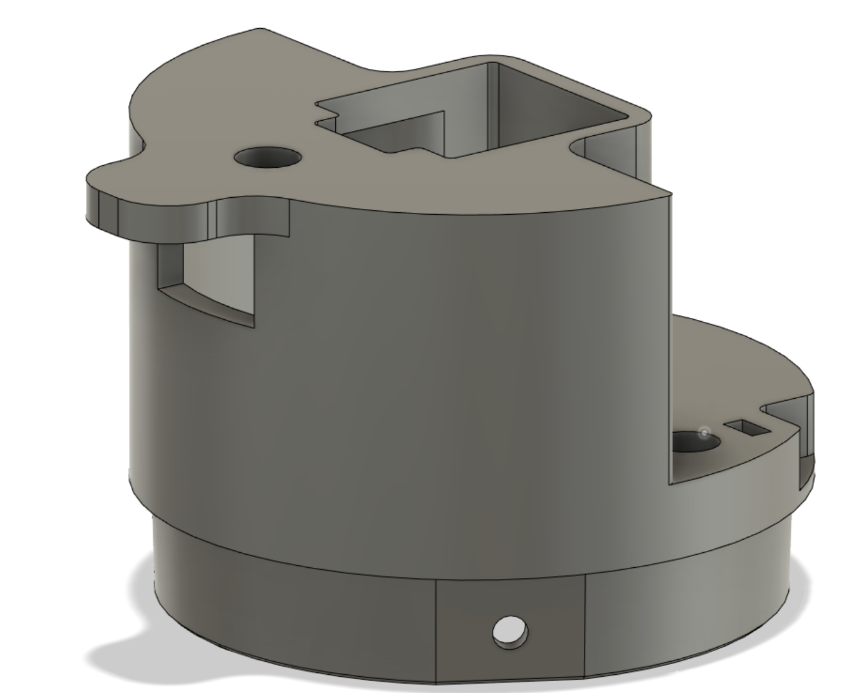
diseño_cad/gripper/GRipper/support_motor.PNG
