juandiz/SCARMOV_1.0/diseño_cad/gripper/GRipper/support_motor_Front.PNG

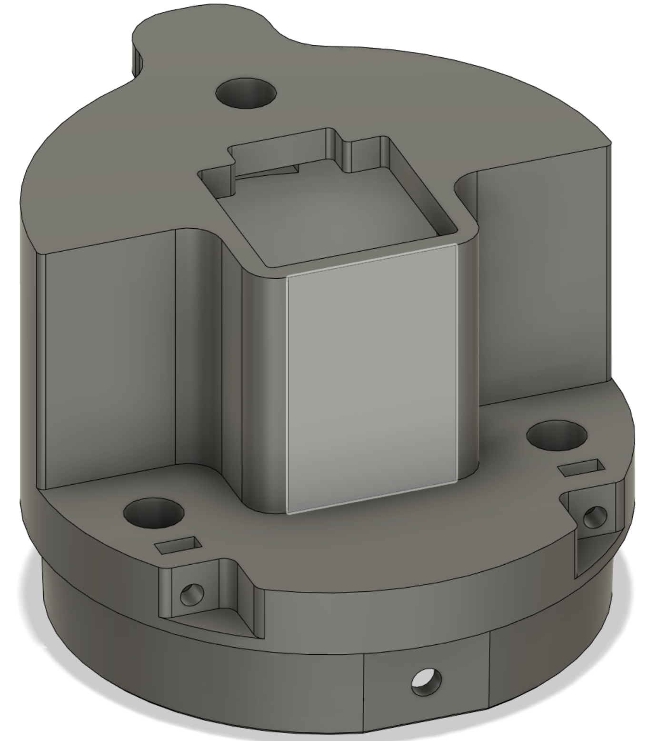
diseño_cad/gripper/GRipper/support_motor_Front.PNG
