juandiz/SCARMOV_1.0/diseño_cad/gripper/gripper_V3.PNG

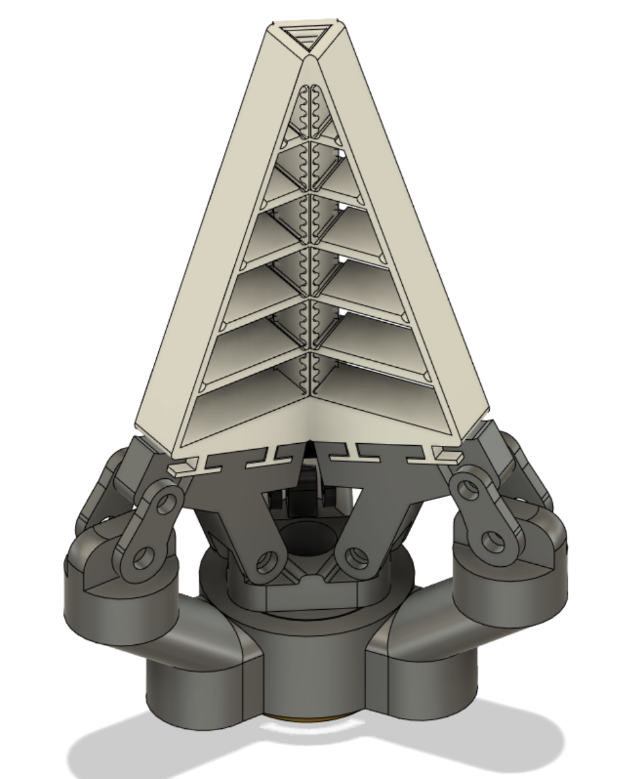
diseño_cad/gripper/gripper_V3.PNG
