juandiz/SCARMOV_1.0/diseño_cad/gripper/GripperV11/motor_suppor.PNG

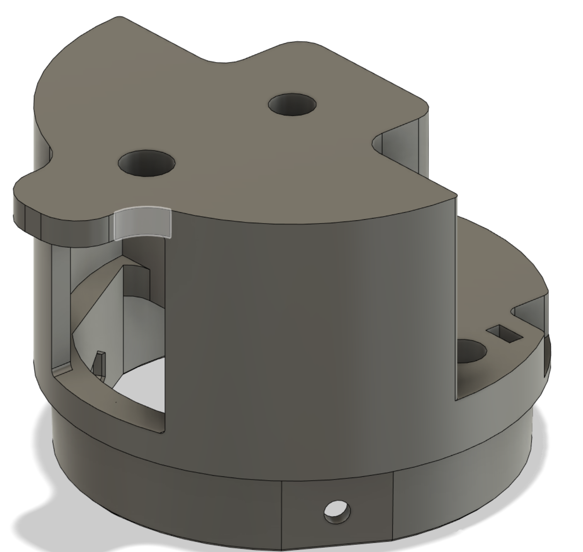
diseño_cad/gripper/GripperV11/motor_suppor.PNG
