juandiz/SCARMOV_1.0/diseño_cad/gripper/GripperV11/Picture2.png

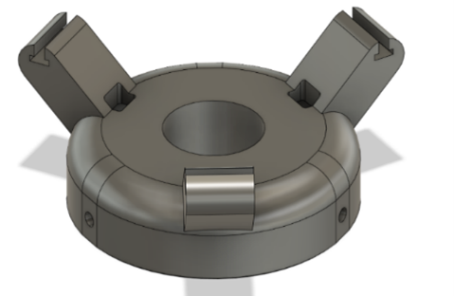
diseño_cad/gripper/GripperV11/Picture2.png
