juandiz/SCARMOV_1.0/diseño_cad/gripper/GripperV11/Picture2__.png

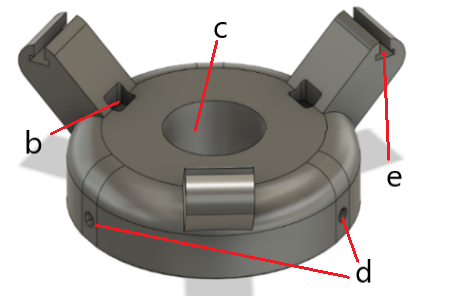
diseño_cad/gripper/GripperV11/Picture2__.png
