juandiz/SCARMOV_1.0/diseño_cad/gripper/GripperV11/pinza/cap_top.PNG

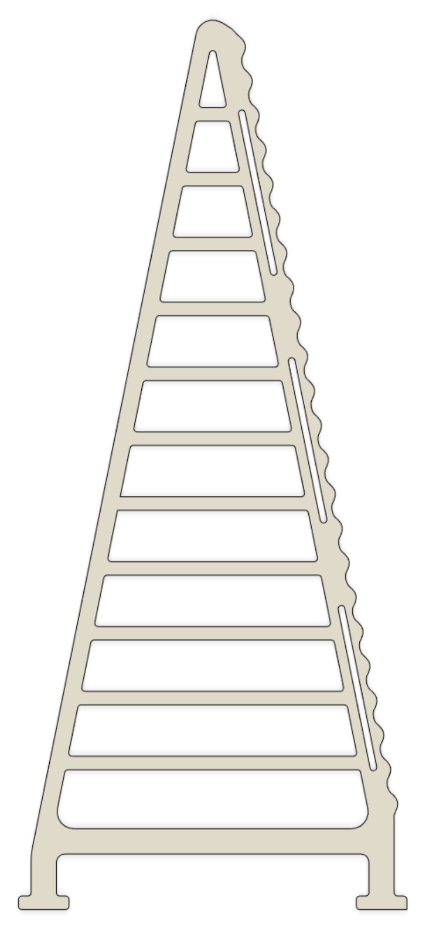
diseño_cad/gripper/GripperV11/pinza/cap_top.PNG
