juandiz/SCARMOV_1.0/diseño_cad/gripper/GripperV11/structure_.PNG

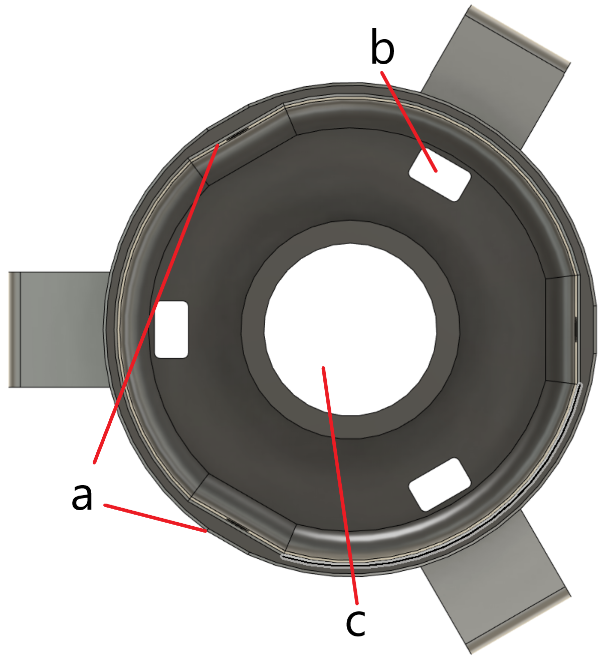
diseño_cad/gripper/GripperV11/structure_.PNG
