juandiz/SCARMOV_1.0/diseño_cad/gripper/GripperV11/structure_Top.PNG

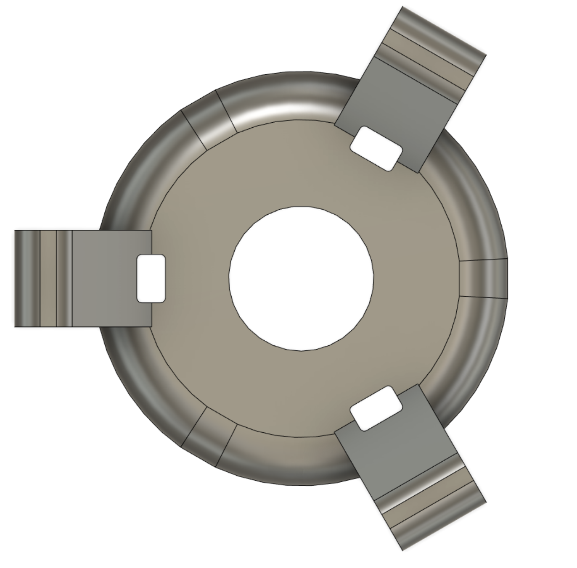
diseño_cad/gripper/GripperV11/structure_Top.PNG
