juandiz/SCARMOV_1.0/diseño_cad/gripper/pcb/Captura.PNG

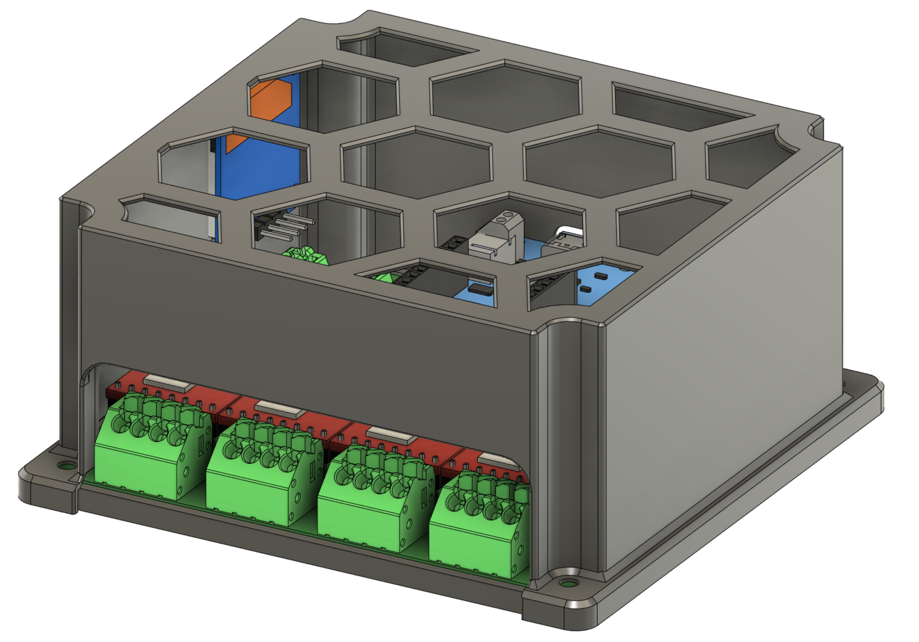
diseño_cad/gripper/pcb/Captura.PNG
