juandiz/SCARMOV_1.0/diseño_cad/gripper/pcb/PCB_BOX_DISPLAY.PNG

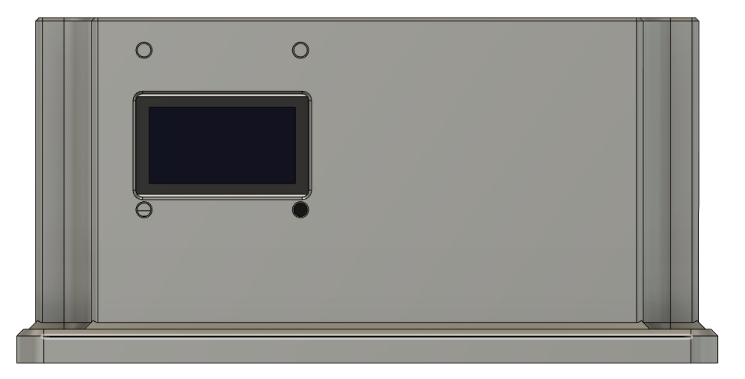
diseño_cad/gripper/pcb/PCB_BOX_DISPLAY.PNG
