juandiz/SCARMOV_1.0/diseño_cad/gripper/pcb/PCB_BOX_USB.PNG

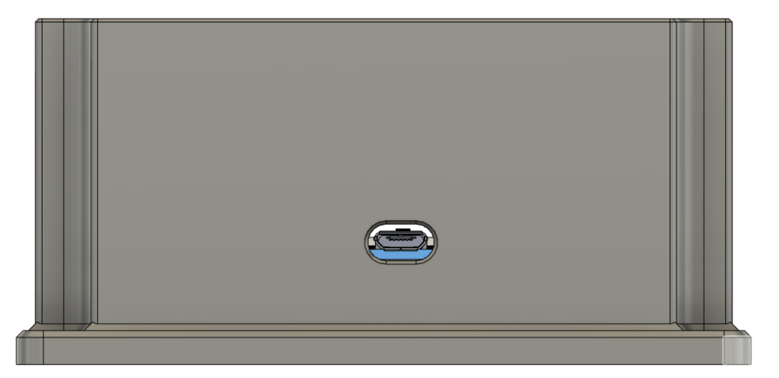
diseño_cad/gripper/pcb/PCB_BOX_USB.PNG
