juandiz/SCARMOV_1.0/diseño_cad/gripper/pcb/PCB_TOP.PNG

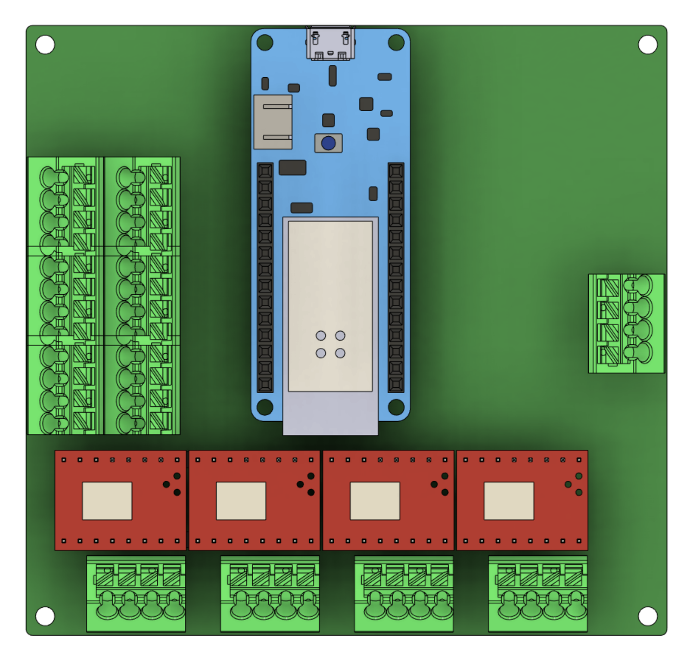
diseño_cad/gripper/pcb/PCB_TOP.PNG
