juandiz/SCARMOV_1.0/diseño_cad/gripper/pcb/PCB_VIEW.PNG

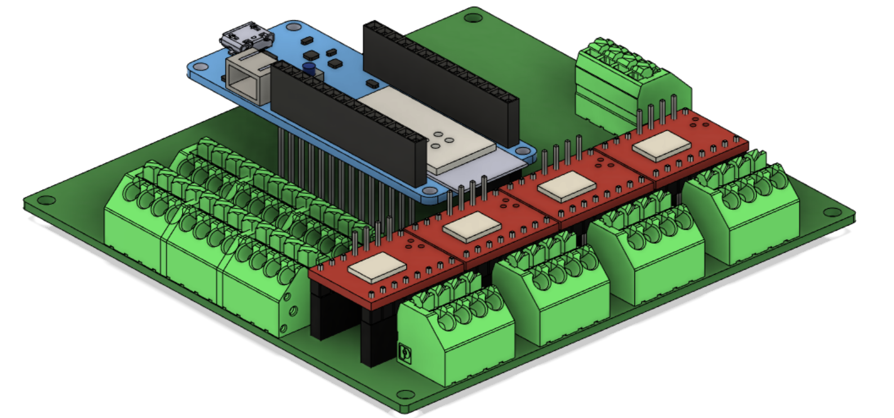
diseño_cad/gripper/pcb/PCB_VIEW.PNG
