juandiz/SCARMOV_1.0/diseño_cad/gripper/pinz_v3/2.PNG

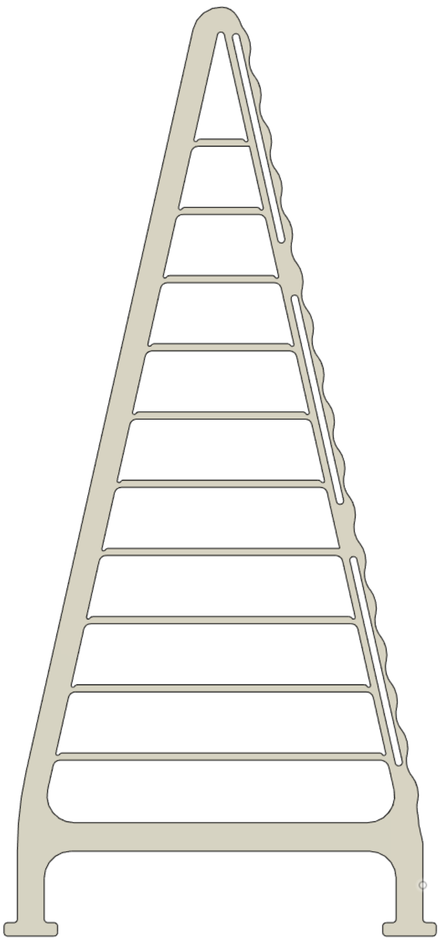
diseño_cad/gripper/pinz_v3/2.PNG
