juandiz/SCARMOV_1.0/diseño_cad/gripper/pinz_v3/cut.PNG

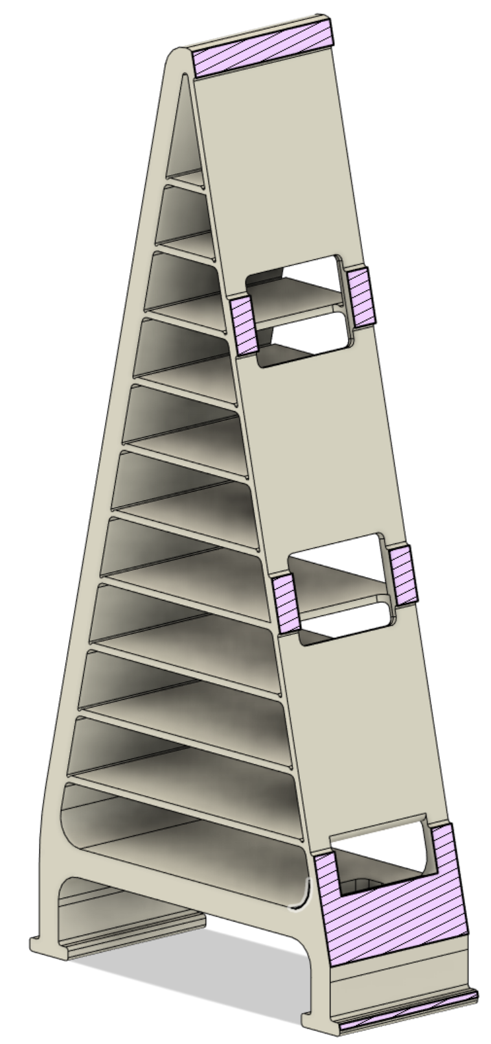
diseño_cad/gripper/pinz_v3/cut.PNG
