juandiz/SCARMOV_1.0/diseño_cad/gripper/pinza_2/2.PNG

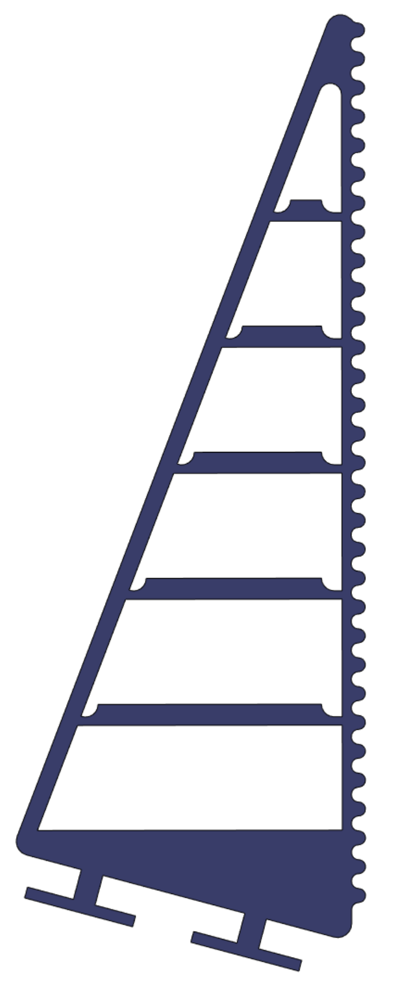
diseño_cad/gripper/pinza_2/2.PNG
