juandiz/SCARMOV_1.0/diseño_cad/gripper/pinza_2/Captura.PNG

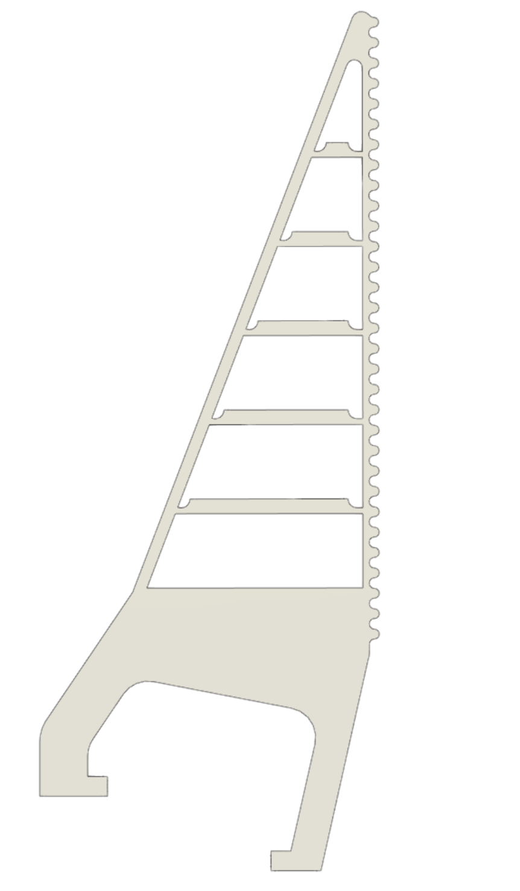
diseño_cad/gripper/pinza_2/Captura.PNG
