juandiz/SCARMOV_1.0/diseño_cad/gripper/Pinza_V1/2.PNG

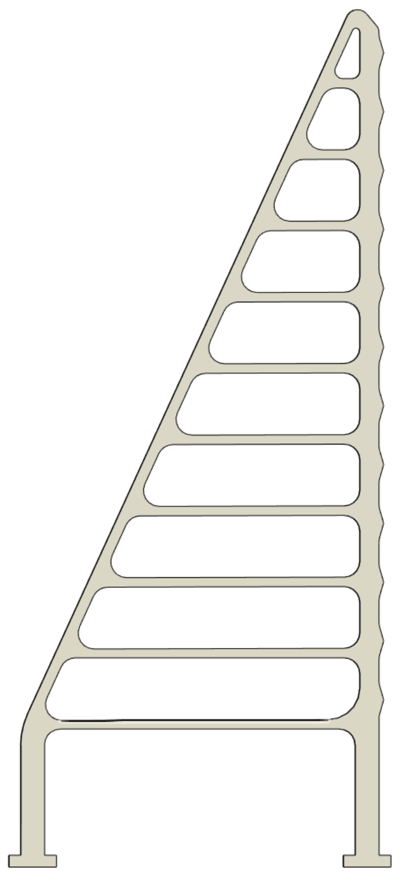
diseño_cad/gripper/Pinza_V1/2.PNG
