juandiz/SCARMOV_1.0/diseño_cad/gripper/V4.PNG

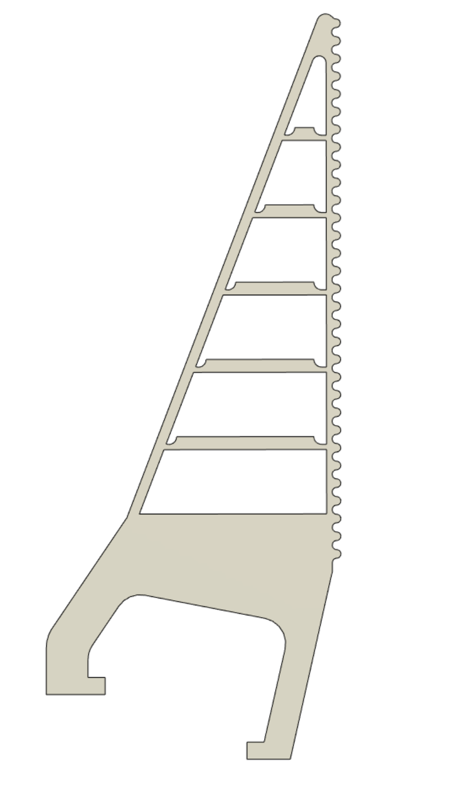
diseño_cad/gripper/V4.PNG
