juandiz/SCARMOV_1.0/diseño_cad/gripper/V8.PNG

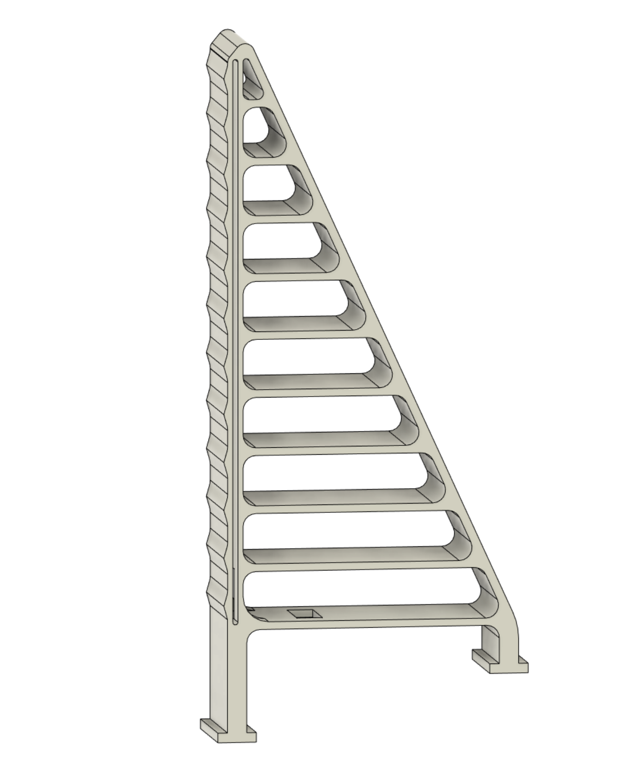
diseño_cad/gripper/V8.PNG
