juandiz/SCARMOV_1.0/diseño_cad/gripper/V9/base_V7.png

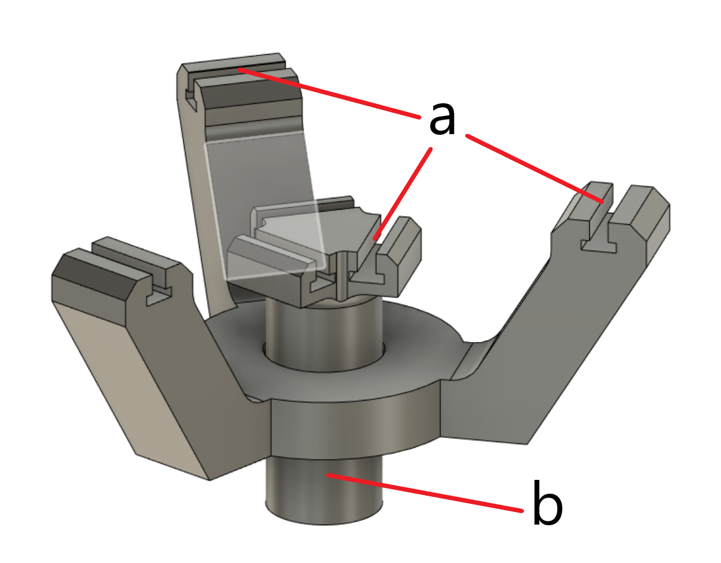
diseño_cad/gripper/V9/base_V7.png
