juandiz/SCARMOV_1.0/diseño_cad/gripper/V9/Captura.PNG

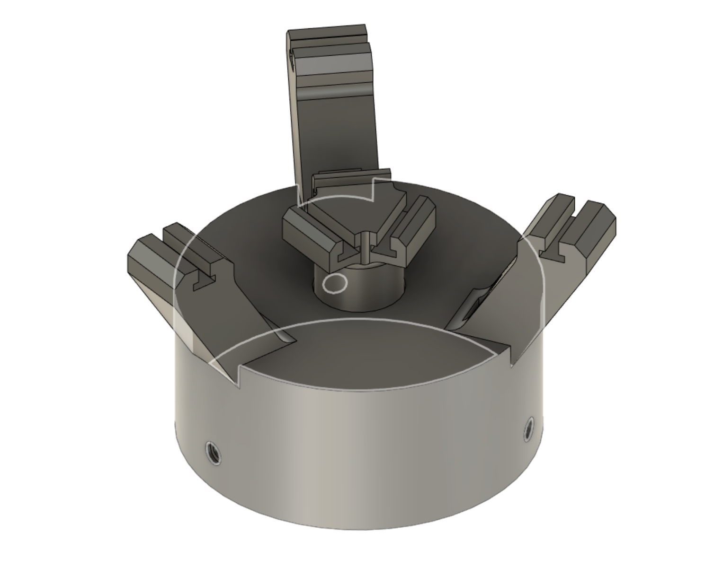
diseño_cad/gripper/V9/Captura.PNG
