juandiz/SCARMOV_1.0/diseño_cad/gripper/V_end.PNG

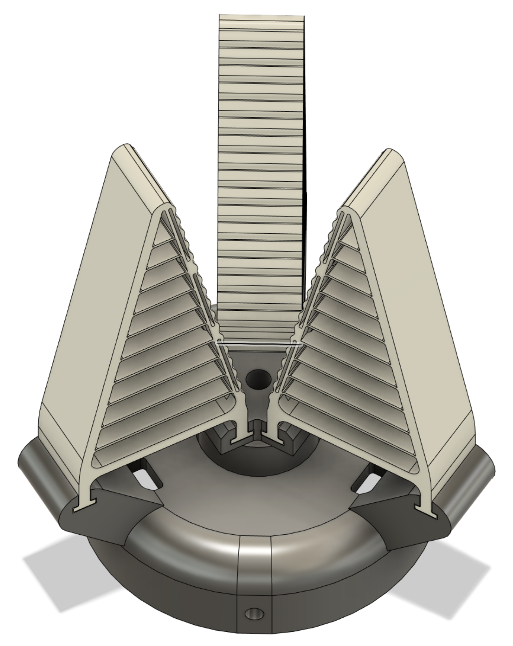
diseño_cad/gripper/V_end.PNG
