juandiz/SCARMOV_1.0/diseño_cad/V11/Complete_V12/1_base.PNG

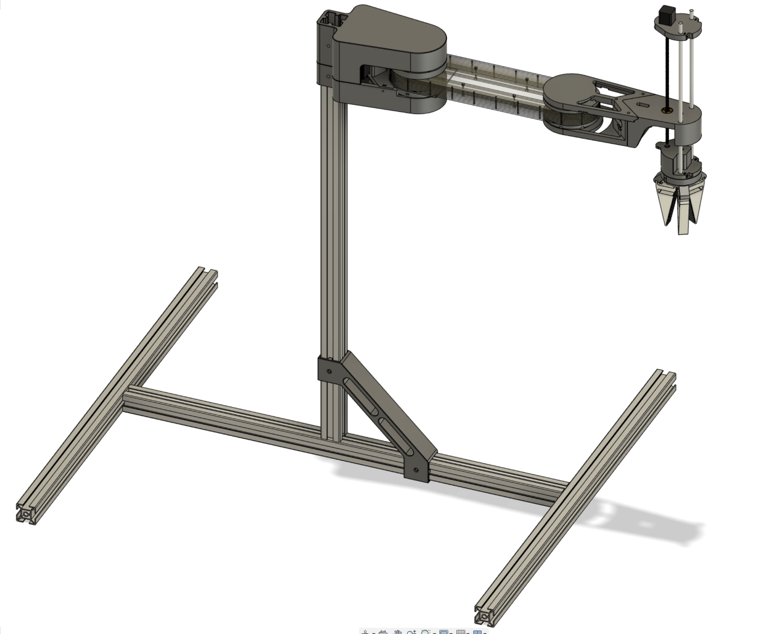
diseño_cad/V11/Complete_V12/1_base.PNG
