juandiz/SCARMOV_1.0/diseño_cad/V11/Eslb_2/Buttom_back.PNG

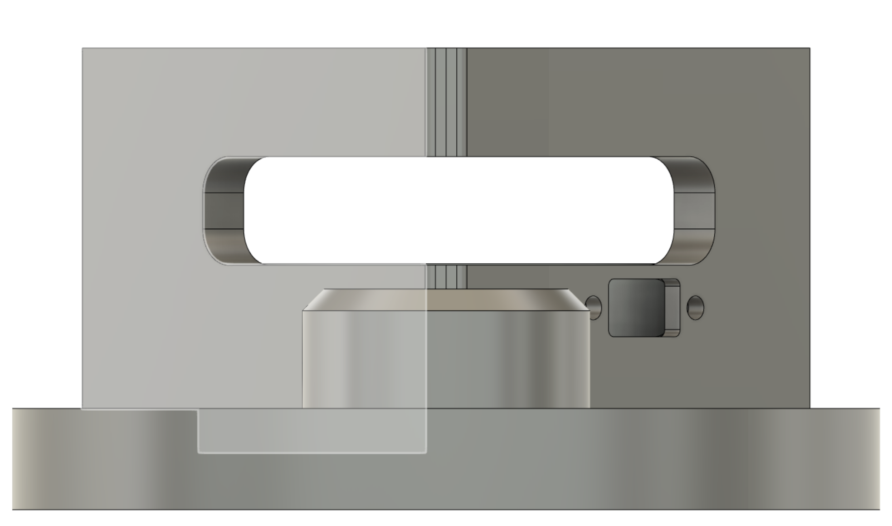
diseño_cad/V11/Eslb_2/Buttom_back.PNG
