juandiz/SCARMOV_1.0/docs/Fuentes/Critical-Points-within-a-Scalar-Field-left-3D-view-of-scalar-surface-right-overhead.png

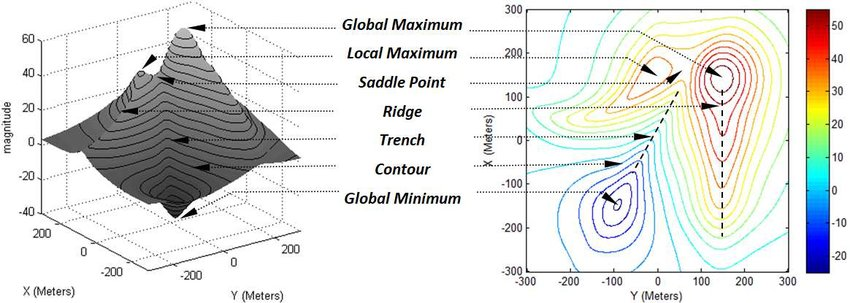
docs/Fuentes/Critical-Points-within-a-Scalar-Field-left-3D-view-of-scalar-surface-right-overhead.png
