juandiz/SCARMOV_1.0/docs/Imagenes/anexos/base.jpg

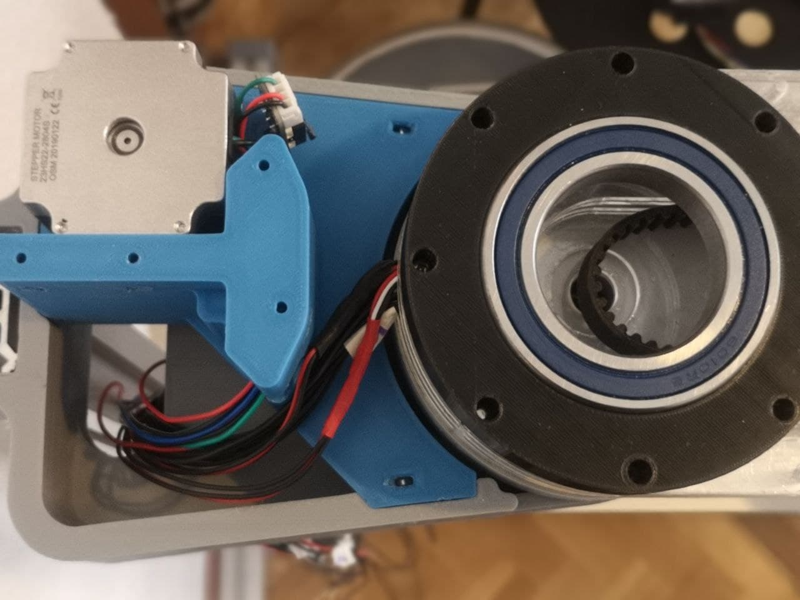
docs/Imagenes/anexos/base.jpg
