juandiz/SCARMOV_1.0/docs/Imagenes/anexos/polea1V5.jpg

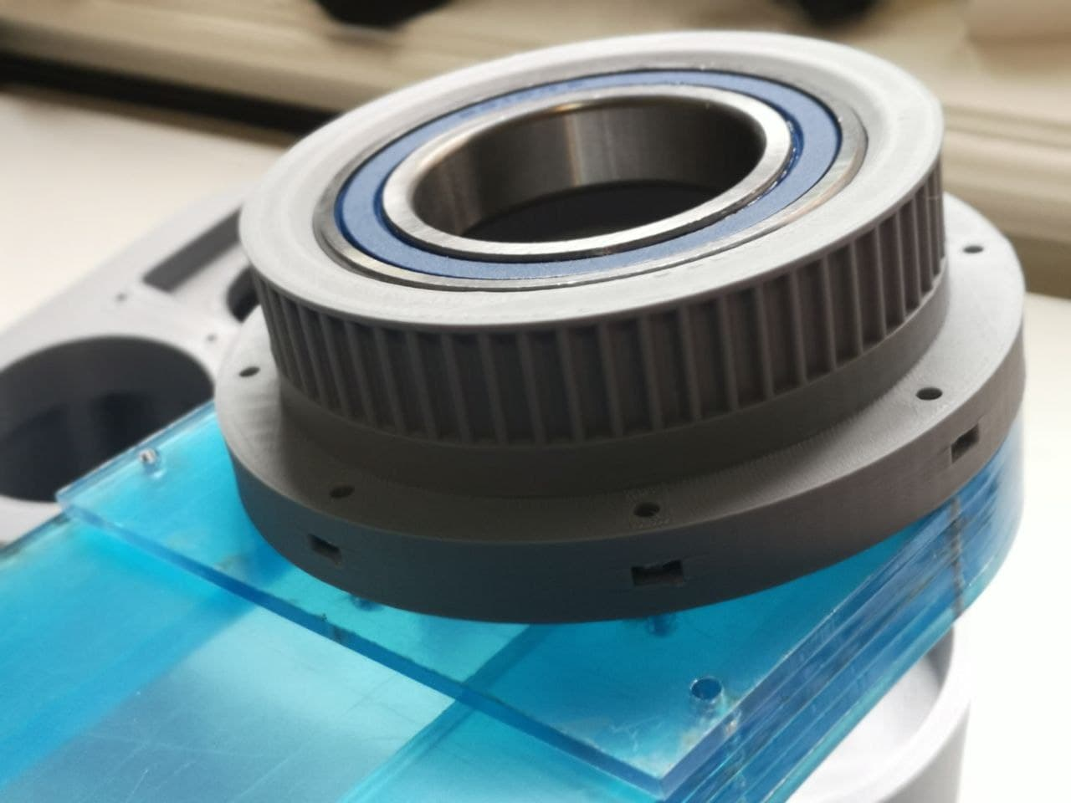
docs/Imagenes/anexos/polea1V5.jpg
