juandiz/SCARMOV_1.0/docs/Imagenes/anexos/top laser2.png

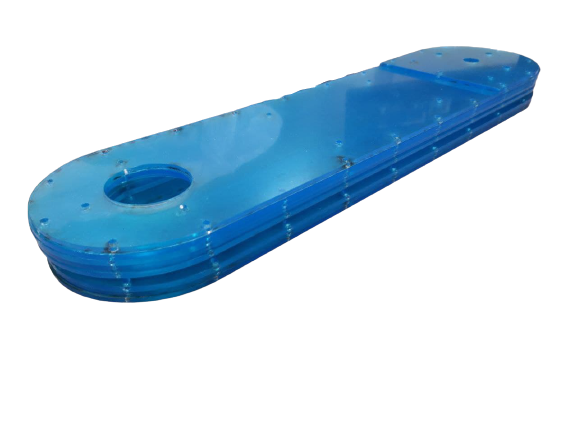
docs/Imagenes/anexos/top laser2.png
