juandiz/SCARMOV_1.0/docs/Imagenes/desarrollo/componentes/Pinout-MKRwifi1010_-.png

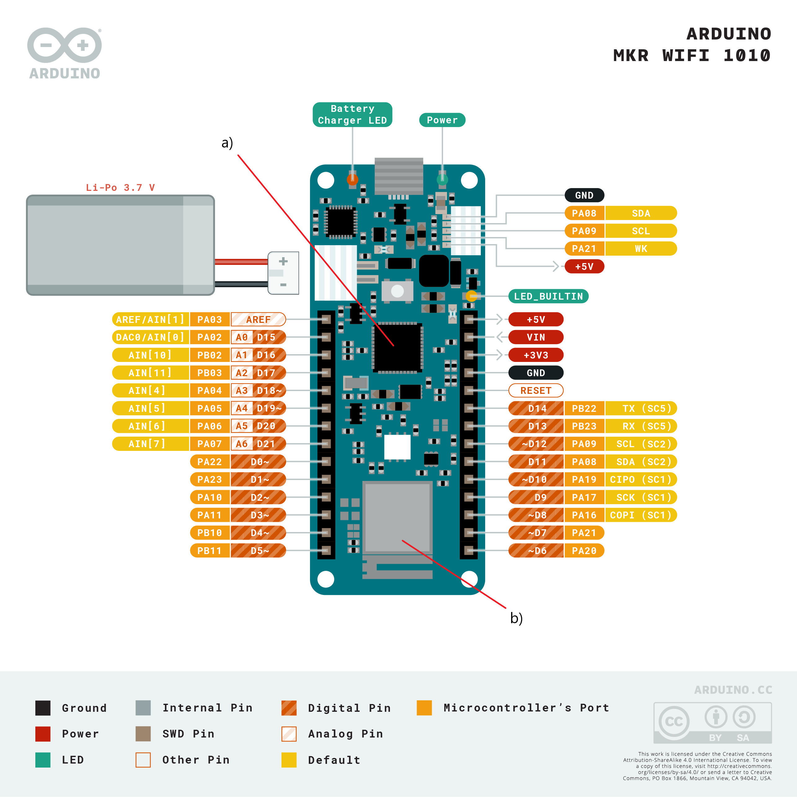
docs/Imagenes/desarrollo/componentes/Pinout-MKRwifi1010_-.png
