juandiz/SCARMOV_1.0/docs/Imagenes/desarrollo/marco teorico/Circuto LRC.PNG

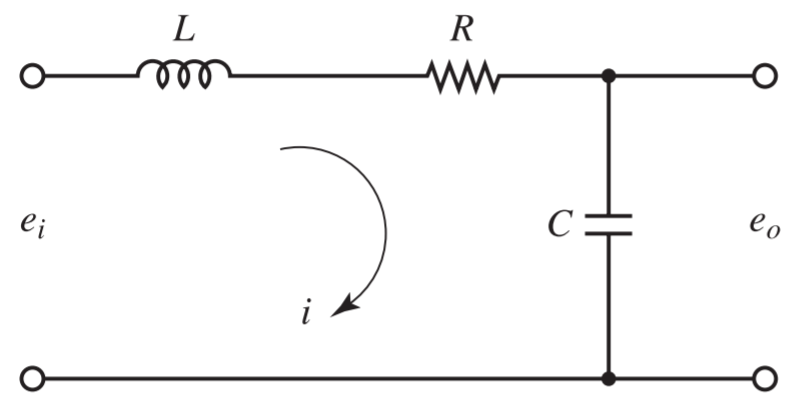
docs/Imagenes/desarrollo/marco teorico/Circuto LRC.PNG
