juandiz/SCARMOV_1.0/docs/Imagenes/desarrollo/marco teorico/current_volt.PNG

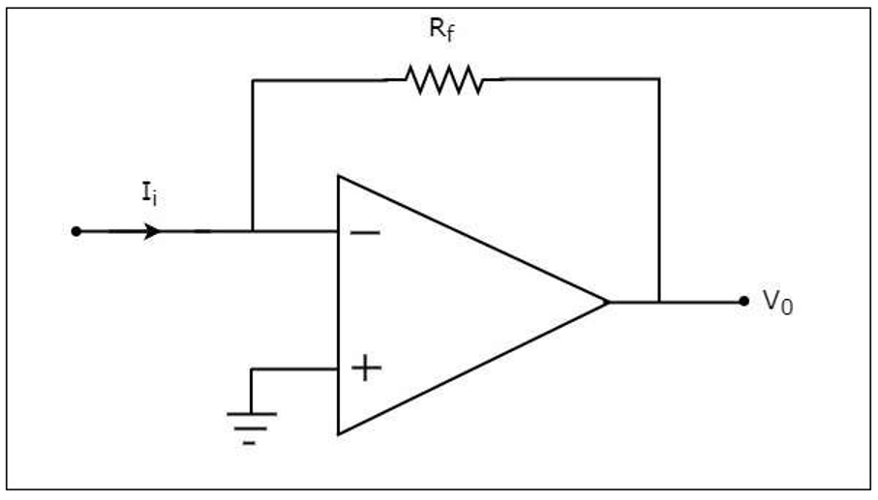
docs/Imagenes/desarrollo/marco teorico/current_volt.PNG
