juandiz/SCARMOV_1.0/docs/Imagenes/desarrollo/marco teorico/espaciosRobot.PNG

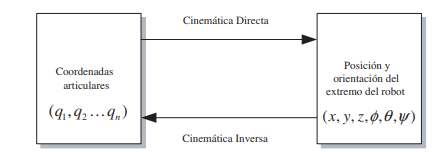
docs/Imagenes/desarrollo/marco teorico/espaciosRobot.PNG
