juandiz/SCARMOV_1.0/docs/Imagenes/desarrollo/marco teorico/FSR_modes.jpg

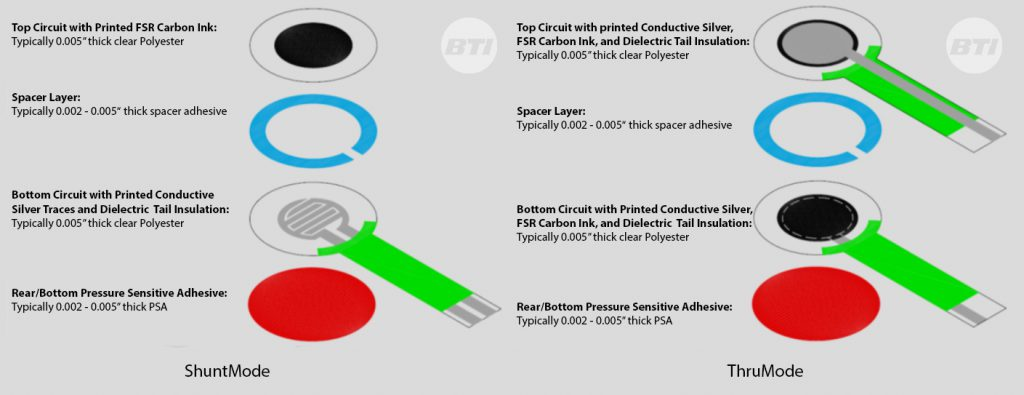
docs/Imagenes/desarrollo/marco teorico/FSR_modes.jpg
