juandiz/SCARMOV_1.0/docs/Imagenes/estado del arte/fin_ray.PNG

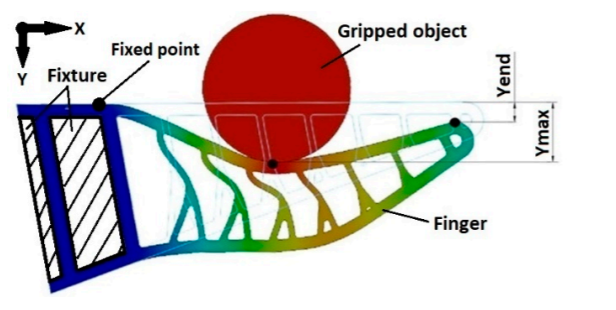
docs/Imagenes/estado del arte/fin_ray.PNG
