juandiz/SCARMOV_1.0/docs/Imagenes/results/NO_BG/tapaperfil-removebg-preview.png

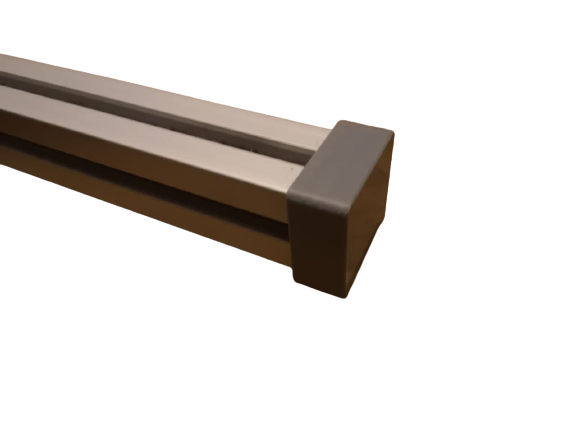
docs/Imagenes/results/NO_BG/tapaperfil-removebg-preview.png
