juandiz/SCARMOV_1.0/docs/Imagenes/results/tapaperfil.jpg

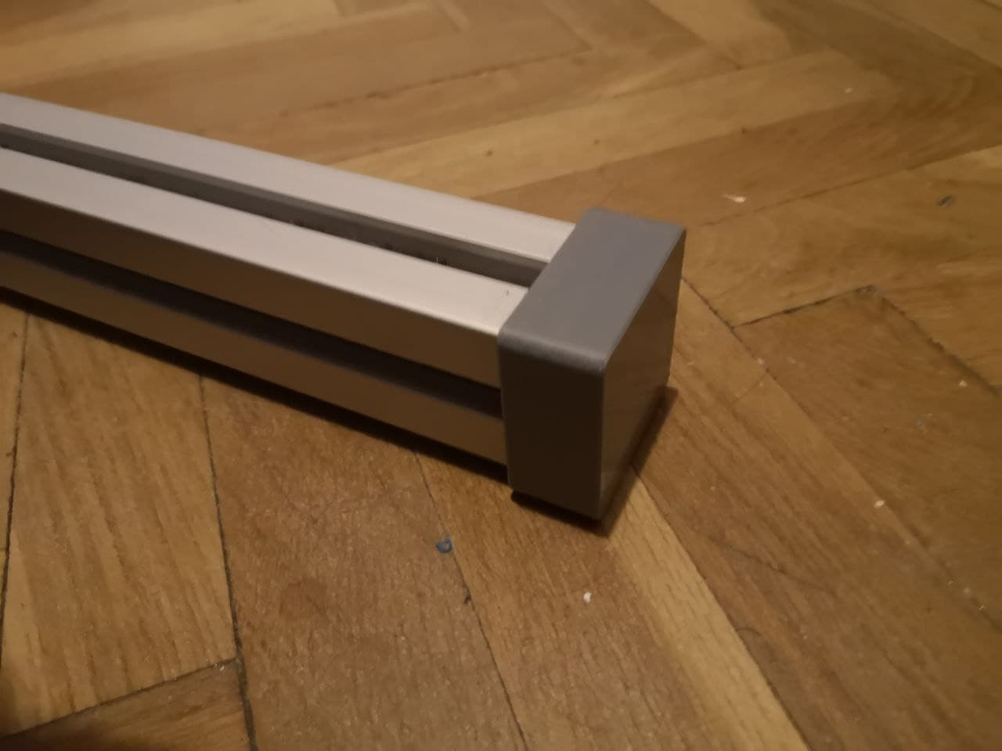
docs/Imagenes/results/tapaperfil.jpg
