juandiz/SCARMOV_1.0/docs/Imagenes/componentes/11LS13-0754N-150C-1000x1000.jpg

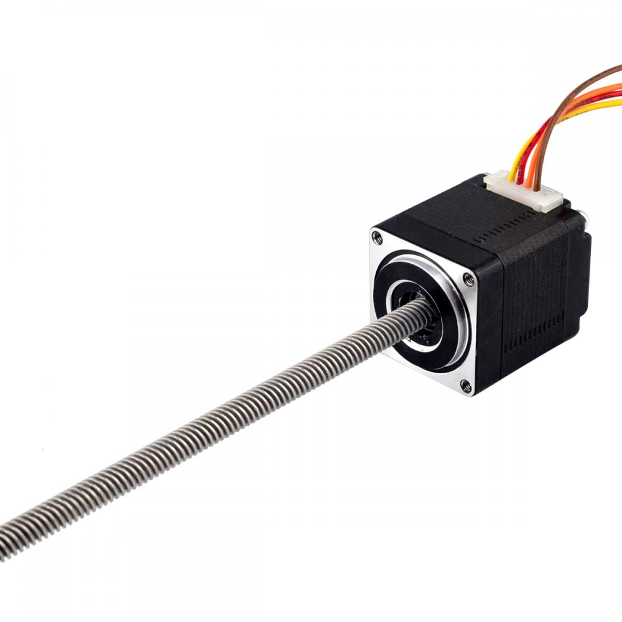
docs/Imagenes/componentes/11LS13-0754N-150C-1000x1000.jpg
