juandiz/SCARMOV_1.0/docs/Imagenes/componentes/51mauJyayAL._SL1000_.jpg

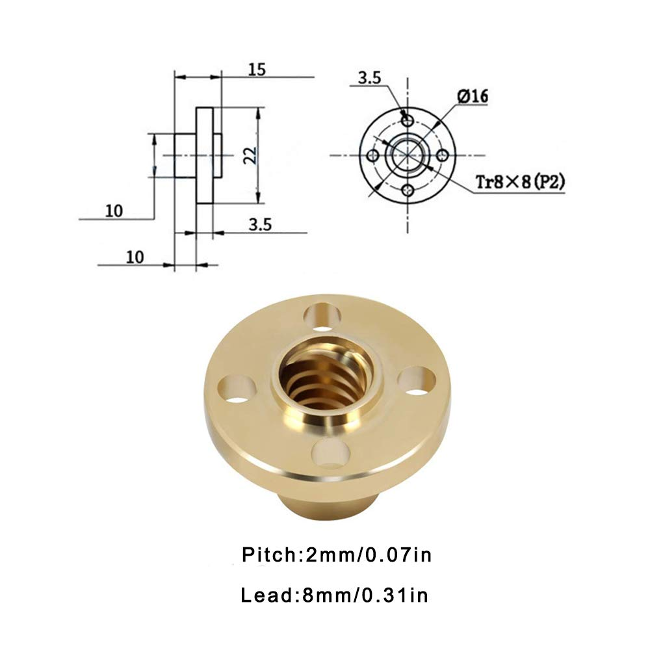
docs/Imagenes/componentes/51mauJyayAL._SL1000_.jpg
