juandiz/SCARMOV_1.0/docs/Imagenes/componentes/Captura.PNG

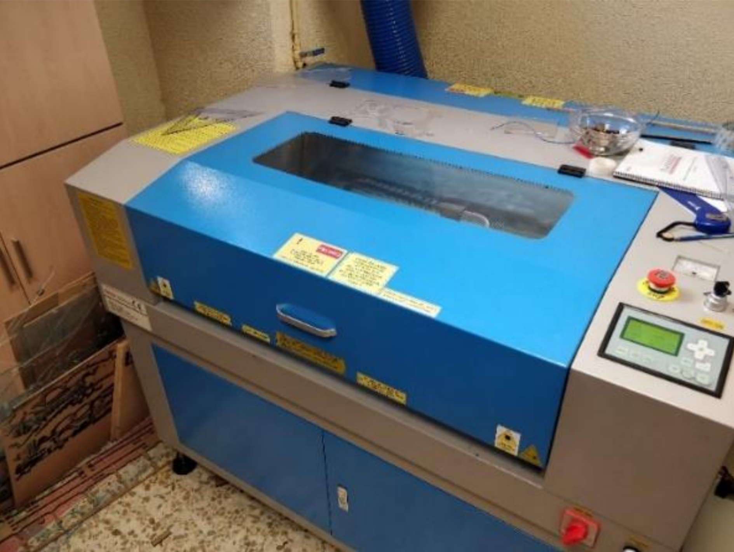
docs/Imagenes/componentes/Captura.PNG
