juandiz/SCARMOV_1.0/docs/Imagenes/componentes/cortadora laser.jpg

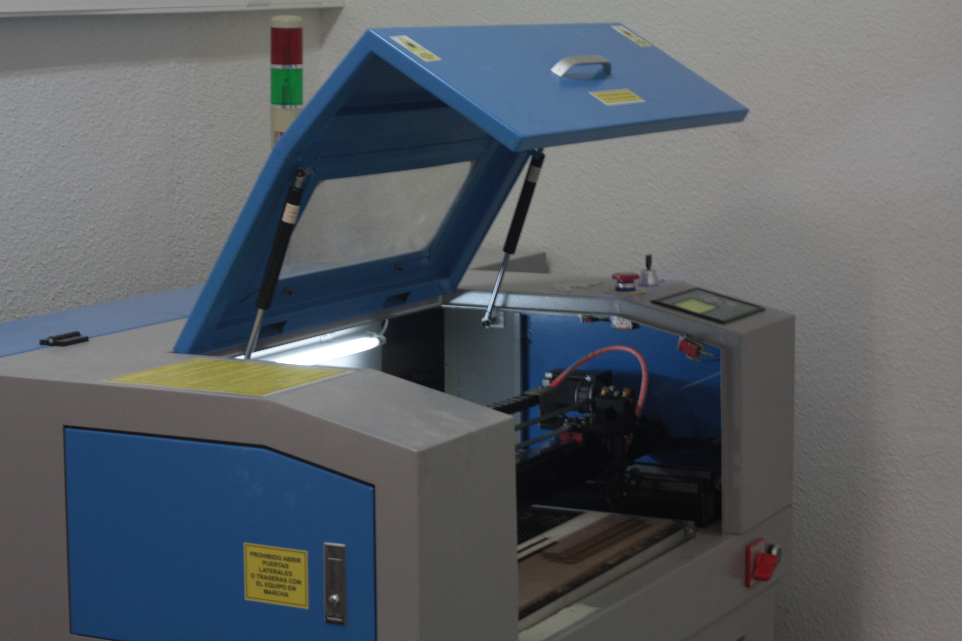
docs/Imagenes/componentes/cortadora laser.jpg
