juandiz/SCARMOV_1.0/docs/Imagenes/componentes/LI248972-02.png

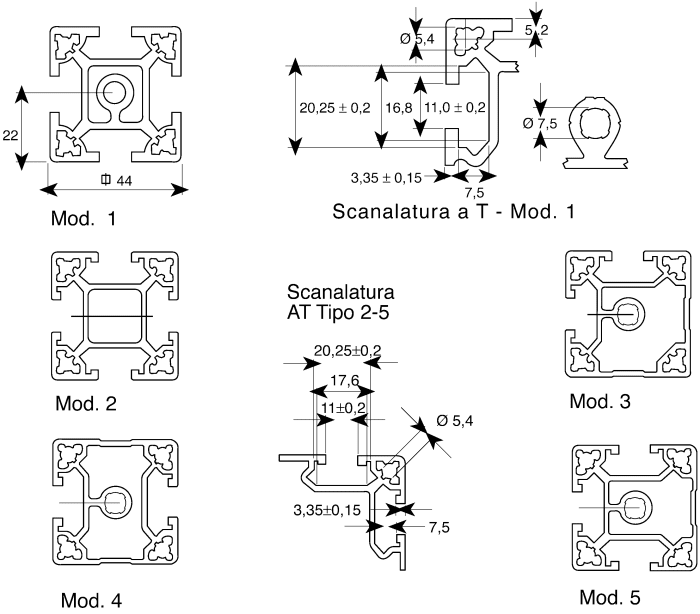
docs/Imagenes/componentes/LI248972-02.png
