juandiz/SCARMOV_1.0/docs/Imagenes/componentes/LI248972-02_perfil.jpg

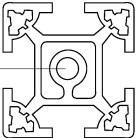
docs/Imagenes/componentes/LI248972-02_perfil.jpg
