juandiz/SCARMOV_1.0/docs/Imagenes/componentes/nema23_elec_embj.jpg

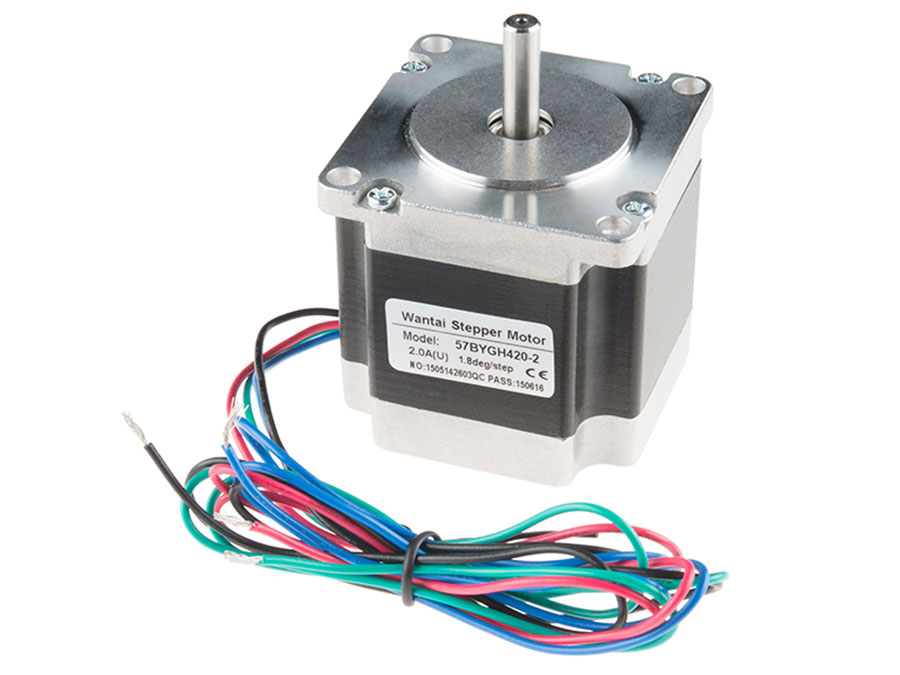
docs/Imagenes/componentes/nema23_elec_embj.jpg
