juandiz/SCARMOV_1.0/docs/Imagenes/componentes/nema-11-bipolar-18deg-95ncm-135ozin-067a-46v-28x28x45mm-4-wires-60-1000x1000.jpg

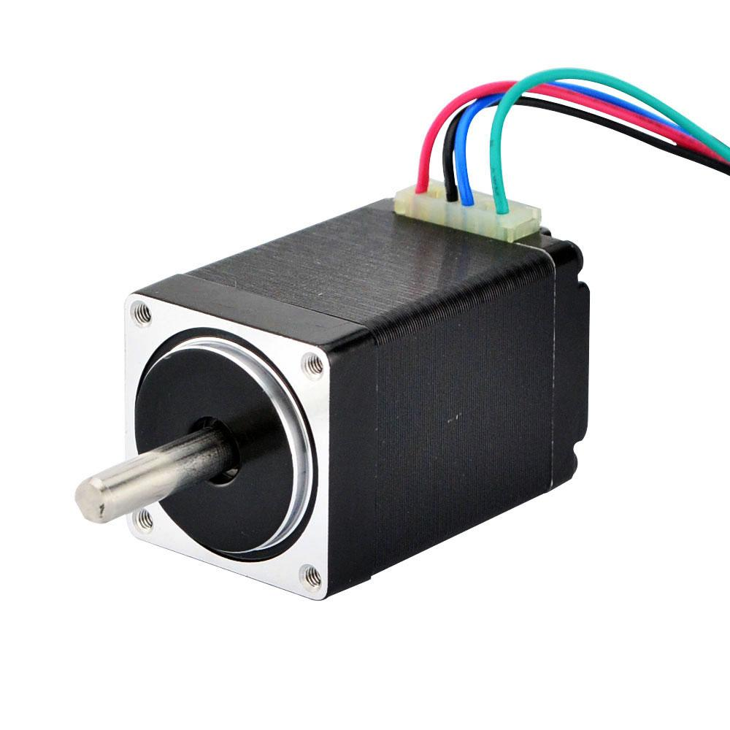
docs/Imagenes/componentes/nema-11-bipolar-18deg-95ncm-135ozin-067a-46v-28x28x45mm-4-wires-60-1000x1000.jpg
