juandiz/SCARMOV_1.0/docs/Imagenes/componentes/Picture1.png

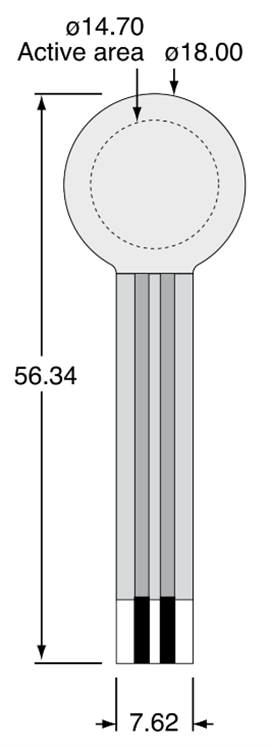
docs/Imagenes/componentes/Picture1.png
