juandiz/SCARMOV_1.0/docs/Imagenes/desarrollo/componentes/diagram_2.png

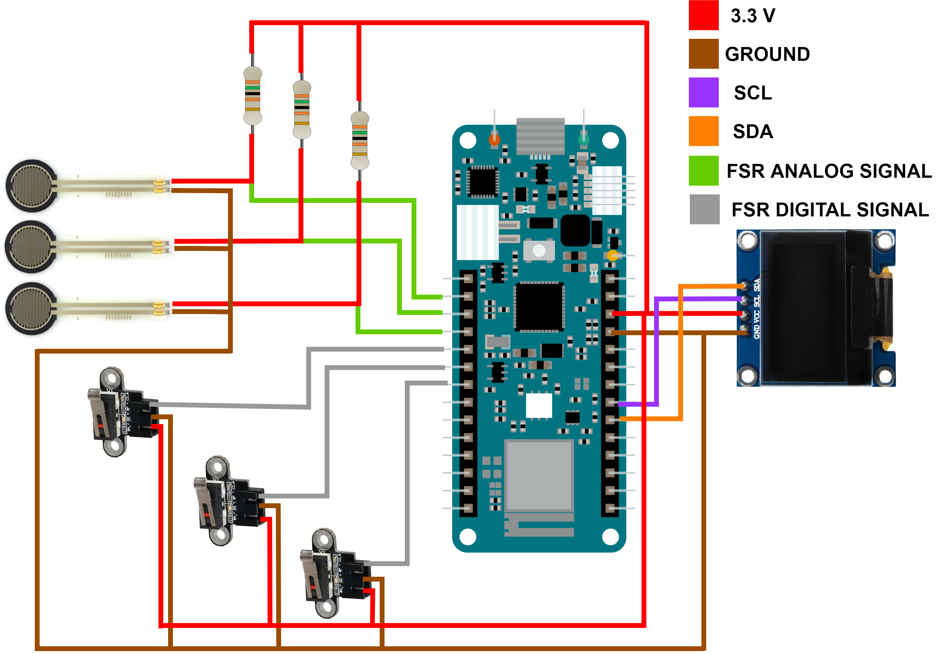
docs/Imagenes/desarrollo/componentes/diagram_2.png
