juandiz/SCARMOV_1.0/docs/Imagenes/desarrollo/componentes/esperimento_fsr.PNG

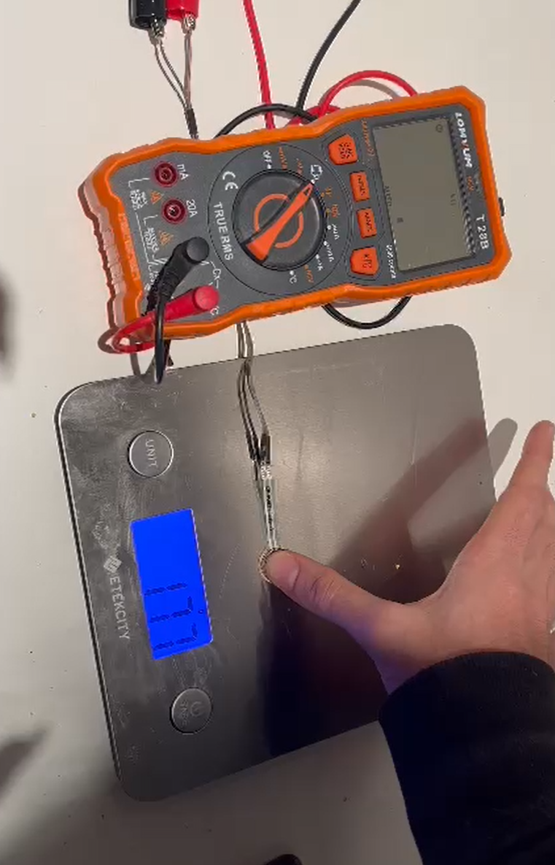
docs/Imagenes/desarrollo/componentes/esperimento_fsr.PNG
