juandiz/SCARMOV_1.0/docs/Imagenes/desarrollo/componentes/esperimento_fsr__.PNG

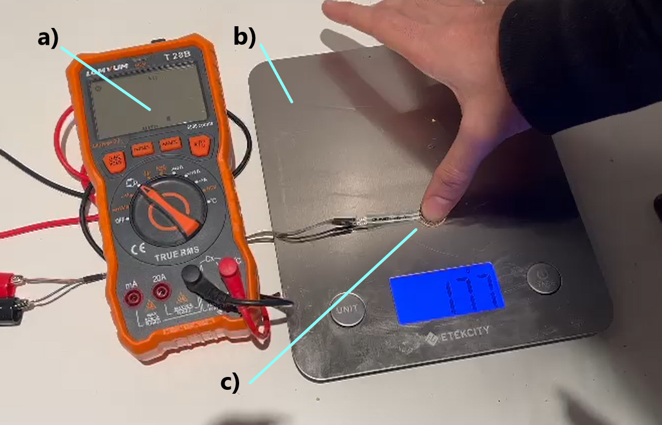
docs/Imagenes/desarrollo/componentes/esperimento_fsr__.PNG
