juandiz/SCARMOV_1.0/docs/Imagenes/desarrollo/componentes/fsr.png

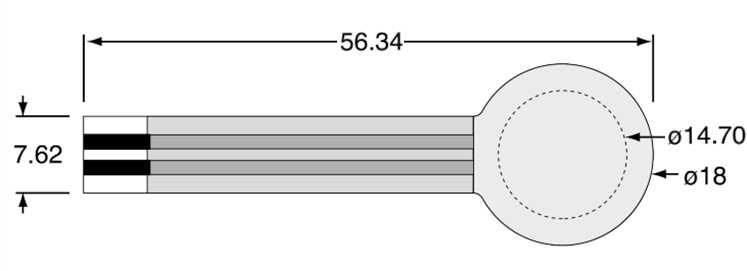
docs/Imagenes/desarrollo/componentes/fsr.png
