juandiz/SCARMOV_1.0/docs/Imagenes/desarrollo/componentes/FSR_t3.PNG

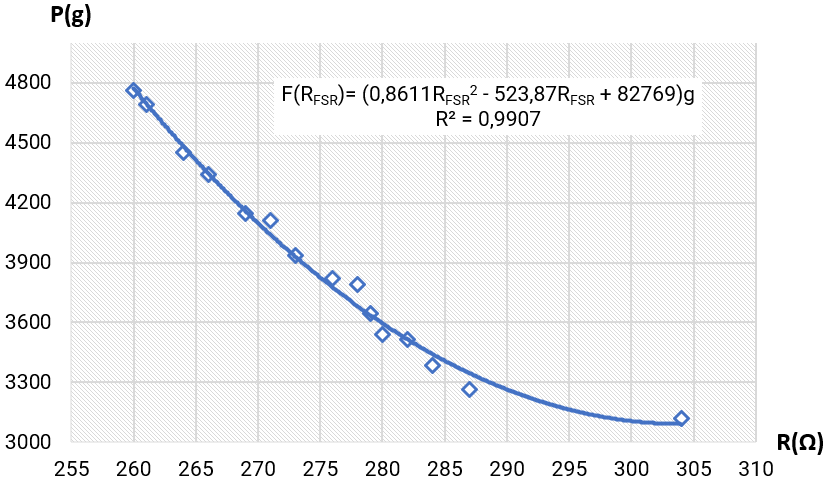
docs/Imagenes/desarrollo/componentes/FSR_t3.PNG
