juandiz/SCARMOV_1.0/docs/Imagenes/desarrollo/componentes/LS.PNG

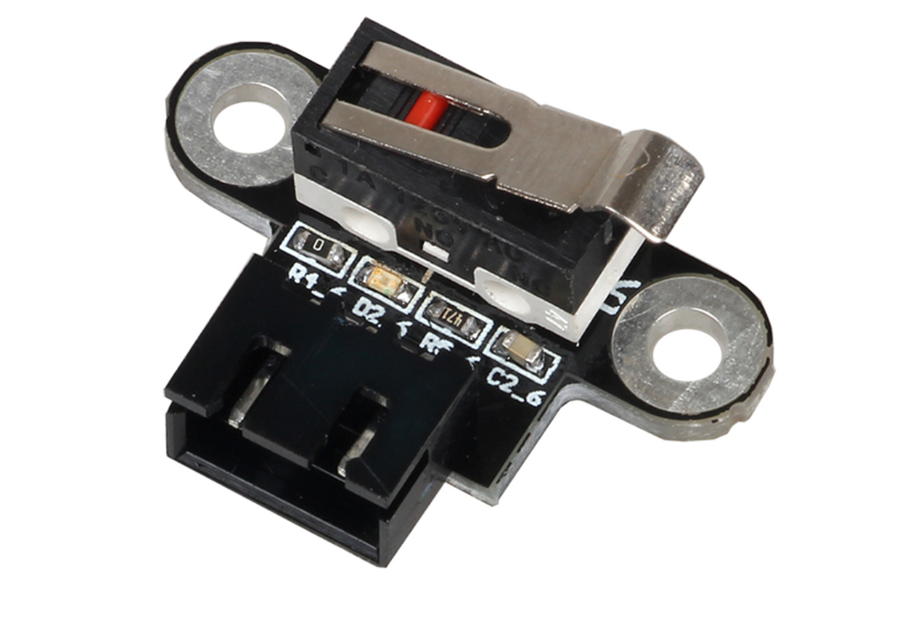
docs/Imagenes/desarrollo/componentes/LS.PNG
