juandiz/SCARMOV_1.0/docs/Imagenes/desarrollo/componentes/ls_2.PNG

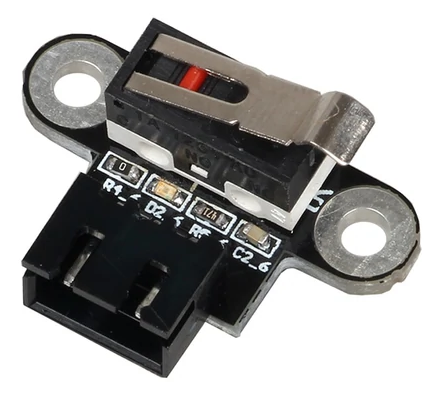
docs/Imagenes/desarrollo/componentes/ls_2.PNG
