juandiz/SCARMOV_1.0/docs/Imagenes/desarrollo/componentes/LS__.PNG

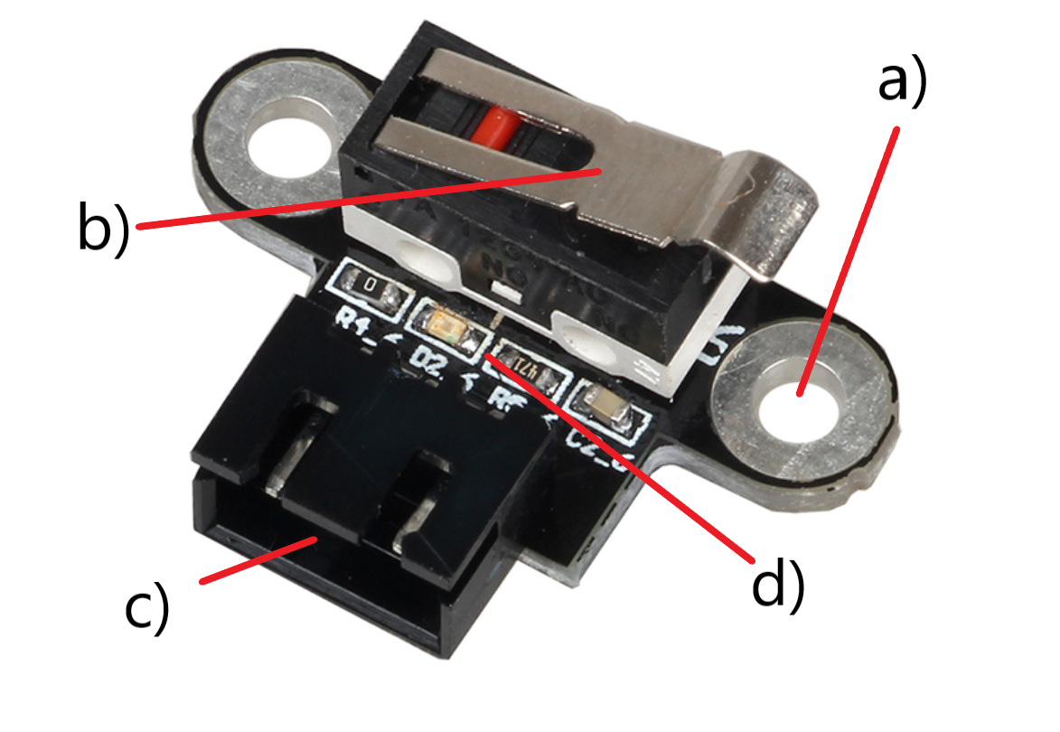
docs/Imagenes/desarrollo/componentes/LS__.PNG
