juandiz/SCARMOV_1.0/docs/Imagenes/desarrollo/componentes/nema_front.jpg

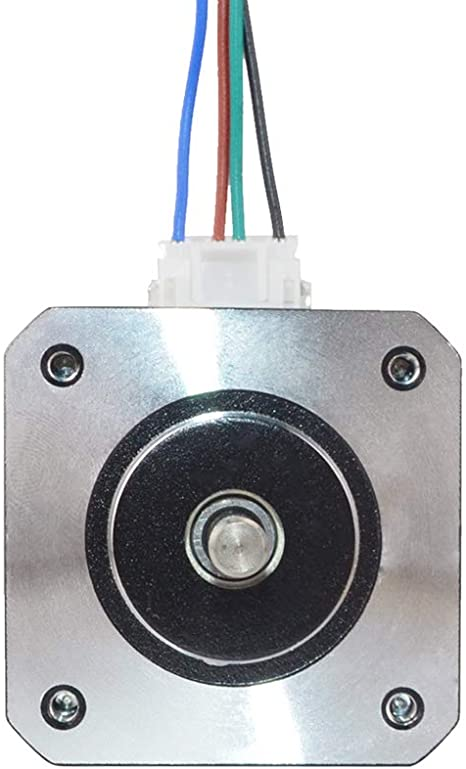
docs/Imagenes/desarrollo/componentes/nema_front.jpg
