juandiz/SCARMOV_1.0/docs/Imagenes/desarrollo/componentes/oled2.PNG

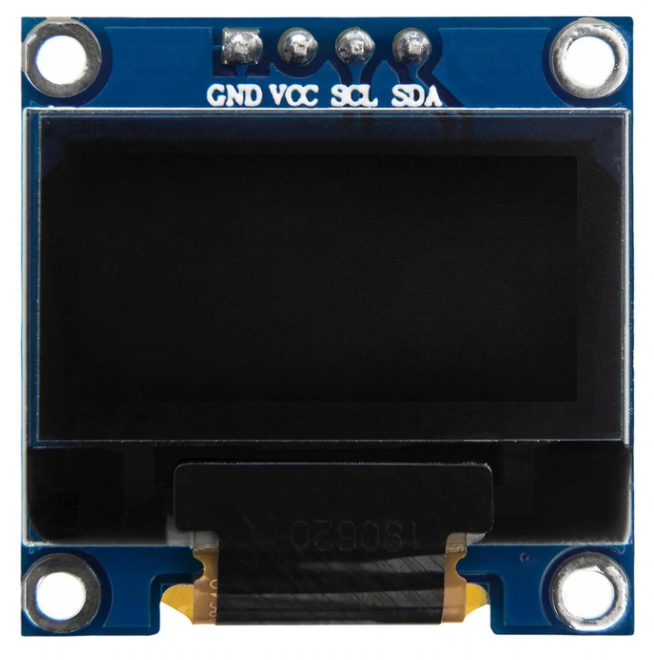
docs/Imagenes/desarrollo/componentes/oled2.PNG
