juandiz/SCARMOV_1.0/docs/Imagenes/desarrollo/componentes/oled.PNG

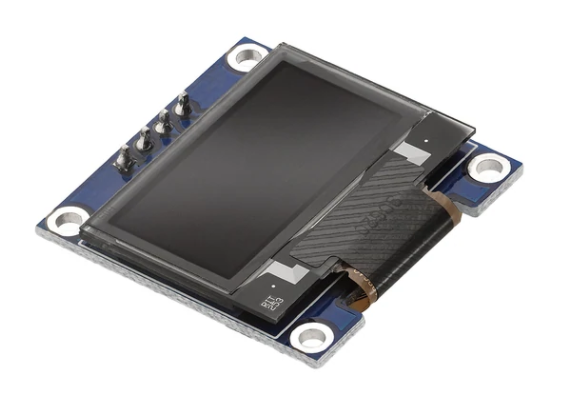
docs/Imagenes/desarrollo/componentes/oled.PNG
