juandiz/SCARMOV_1.0/docs/Imagenes/desarrollo/componentes/pcb_fusion.PNG

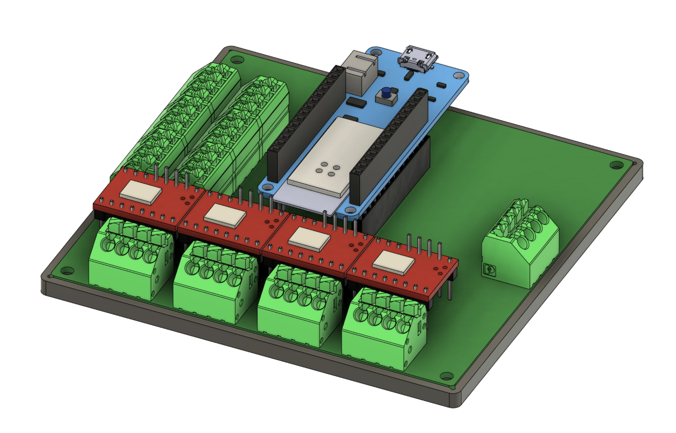
docs/Imagenes/desarrollo/componentes/pcb_fusion.PNG
