juandiz/SCARMOV_1.0/docs/Imagenes/desarrollo/componentes/r.png

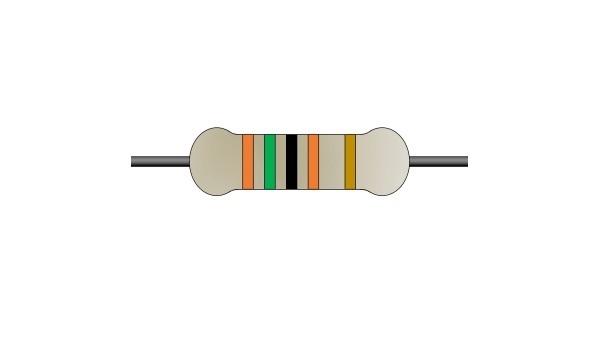
docs/Imagenes/desarrollo/componentes/r.png
