juandiz/SCARMOV_1.0/docs/Imagenes/desarrollo/componentes/ram_generator.PNG

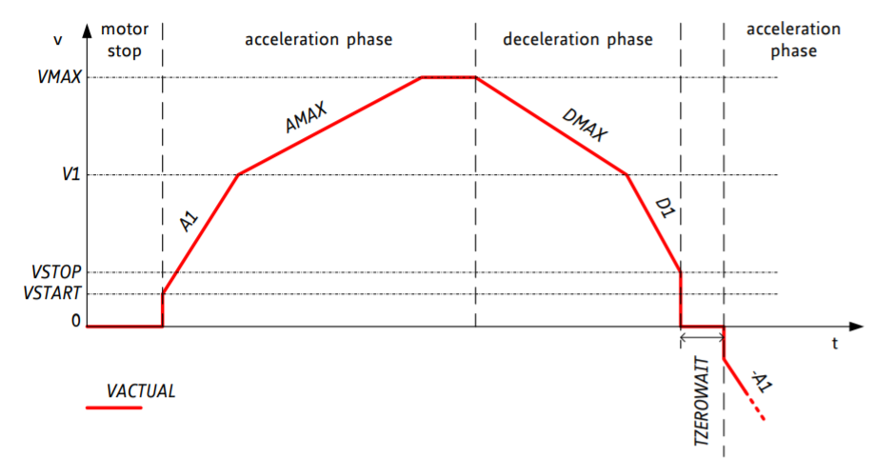
docs/Imagenes/desarrollo/componentes/ram_generator.PNG
