juandiz/SCARMOV_1.0/docs/Imagenes/desarrollo/componentes/TMC5160_silent2.png

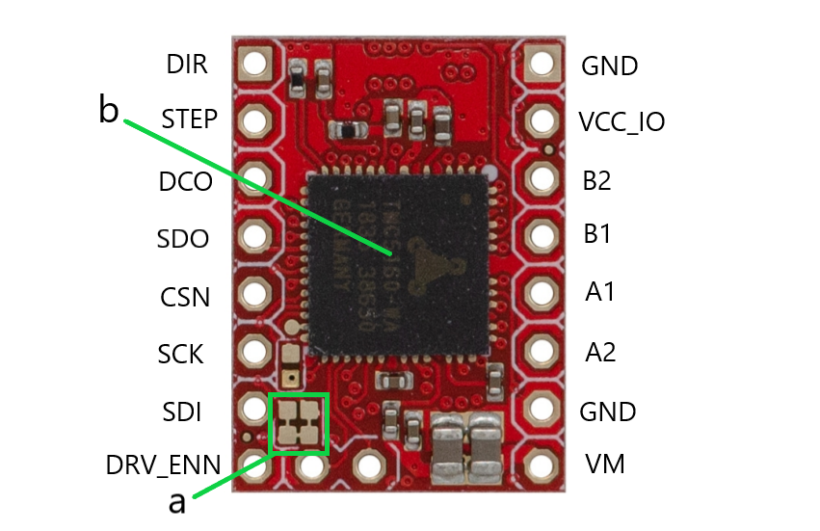
docs/Imagenes/desarrollo/componentes/TMC5160_silent2.png
