juandiz/SCARMOV_1.0/docs/Imagenes/desarrollo/componentes/TMC5160_silent2__.png

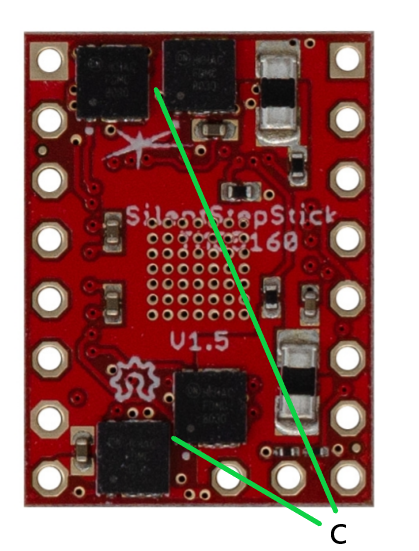
docs/Imagenes/desarrollo/componentes/TMC5160_silent2__.png
