juandiz/SCARMOV_1.0/docs/Imagenes/desarrollo/componentes/TMC5160_silent.PNG

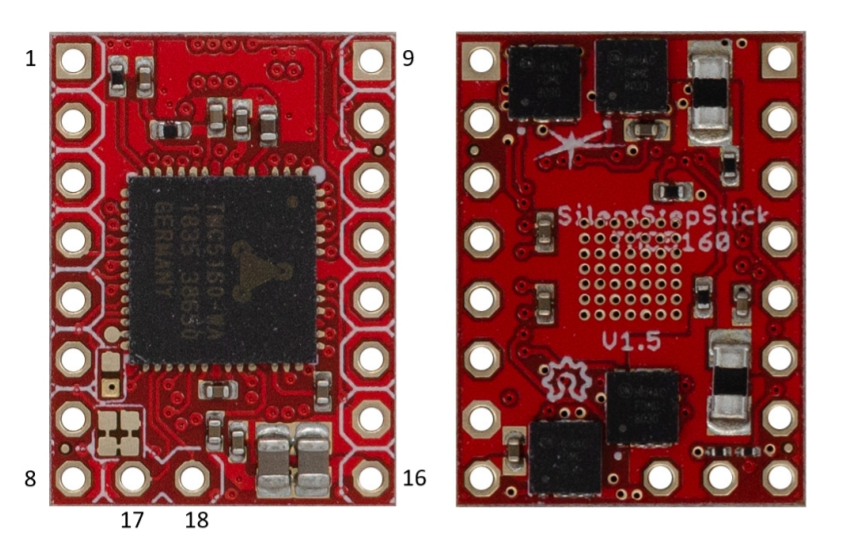
docs/Imagenes/desarrollo/componentes/TMC5160_silent.PNG
