juandiz/SCARMOV_1.0/docs/Imagenes/desarrollo/componentes/TMC5160_silent_spi.PNG

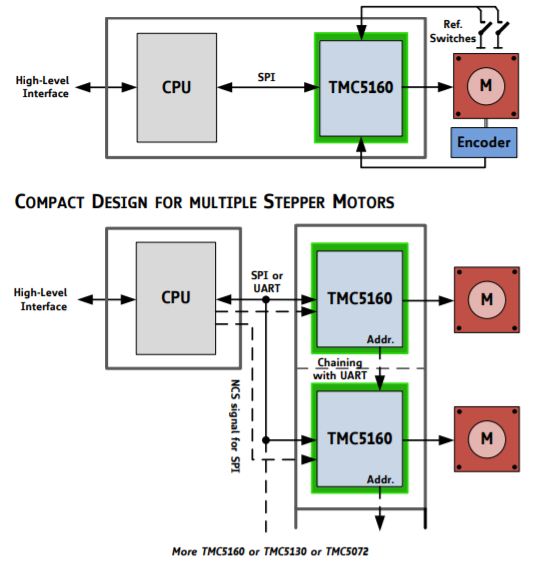
docs/Imagenes/desarrollo/componentes/TMC5160_silent_spi.PNG
