juandiz/SCARMOV_1.0/Desing/Base/Motor_bottom_support.stl

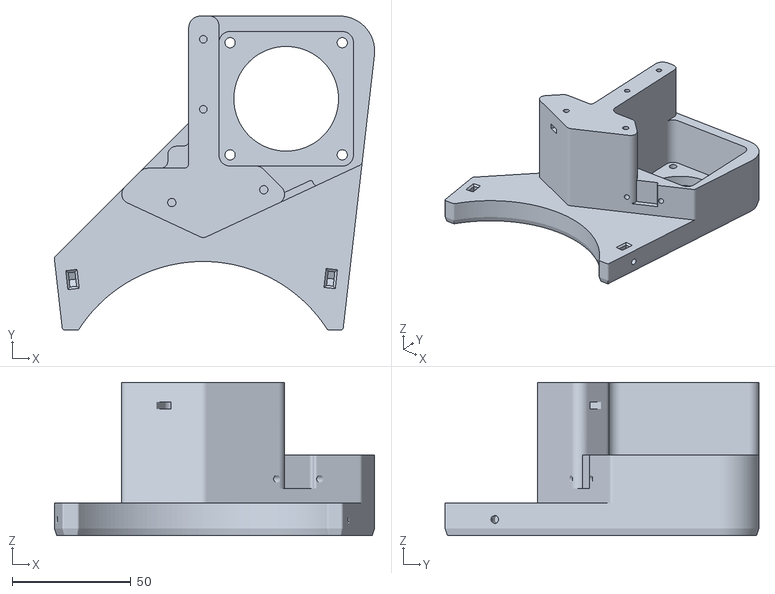
[picture p212: CAD file, 2022-04-22]
Desing/Base/Motor_bottom_support.stl
134.7 x 132.0 x 64.4
