juandiz/SCARMOV_1.0/Desing/bearing_holder/bottom.stl

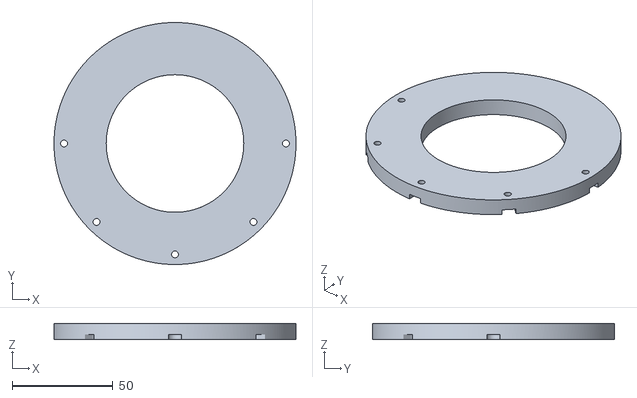
[picture p213: CAD file, 2022-04-22]
Desing/bearing_holder/bottom.stl
120.0 x 120.0 x 8.00
