juandiz/SCARMOV_1.0/Desing/BS/BS_BOT_MOT1.stl

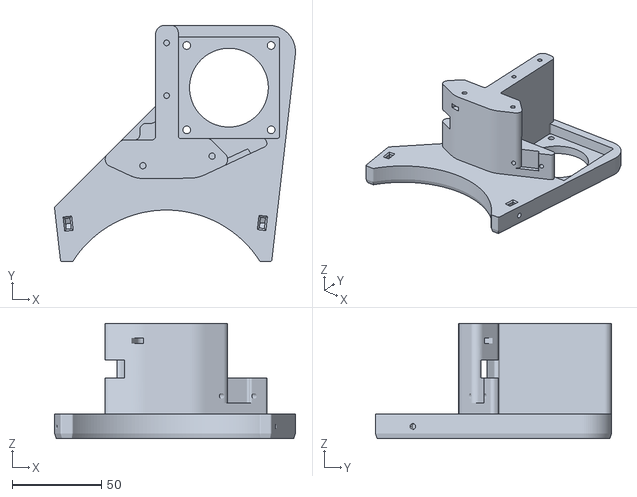
[picture p214: CAD file, 2022-04-22]
Desing/BS/BS_BOT_MOT1.stl
134.7 x 132.0 x 64.4
