juandiz/SCARMOV_1.0/Desing/Eslabon_2/TOP_pull.stl

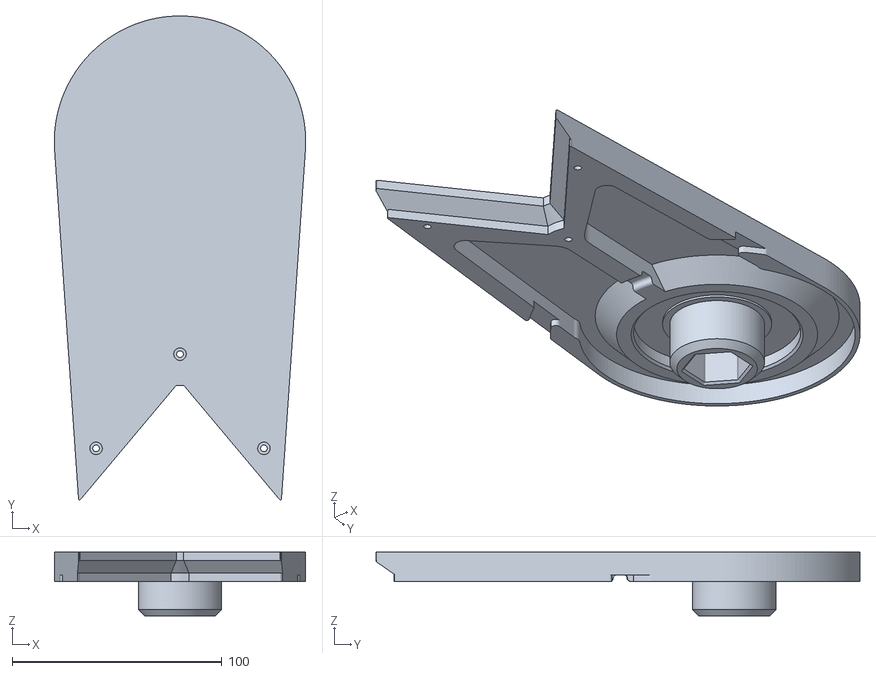
[picture p215: CAD file, 2022-04-22]
Desing/Eslabon_2/TOP_pull.stl
120.0 x 231.0 x 30.5
