juandiz/SCARMOV_1.0/Desing/Eslabon_3/Cover_Gripper.stl

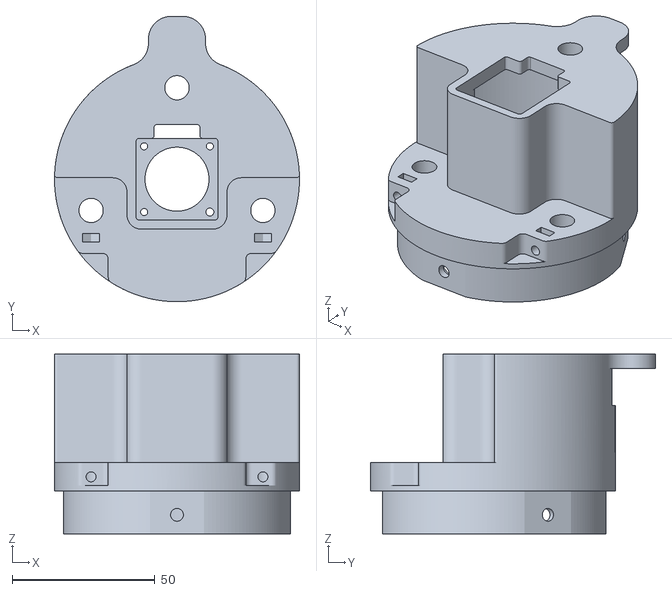
[picture p216: CAD file, 2022-04-22]
Desing/Eslabon_3/Cover_Gripper.stl
85.8 x 99.9 x 63.0
