juandiz/SCARMOV_1.0/Desing/EXTRA/LS_COVE.stl

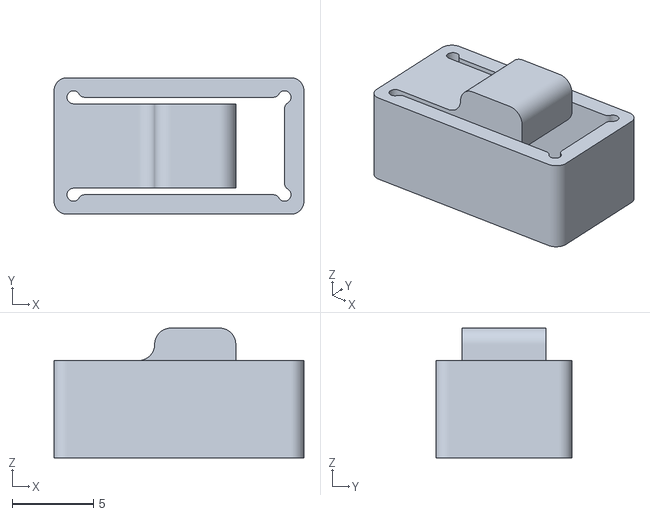
[picture p217: CAD file, 2022-04-22]
Desing/EXTRA/LS_COVE.stl
15.4 x 8.40 x 8.00
