juandiz/SCARMOV_1.0/Desing/Gripper/motor_holder.stl

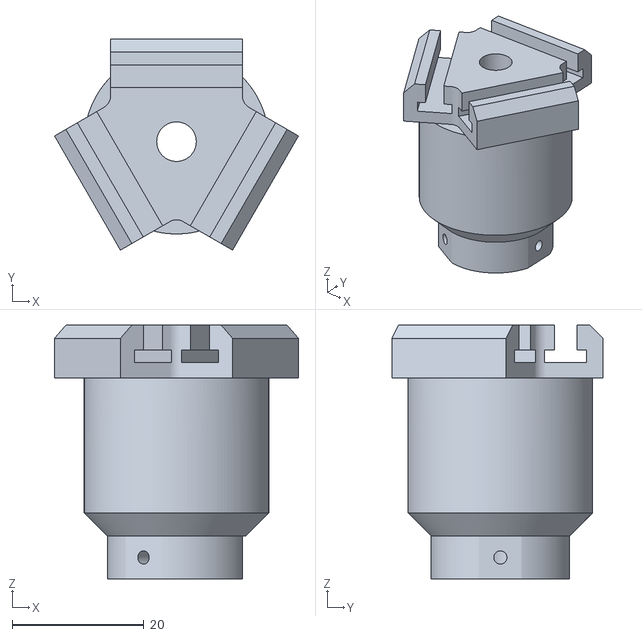
[picture p218: CAD file, 2022-04-22]
Desing/Gripper/motor_holder.stl
37.0 x 32.1 x 38.5
