juandiz/SCARMOV_1.0/Desing/PCB/step/arduino-mkr-1300-wan.step

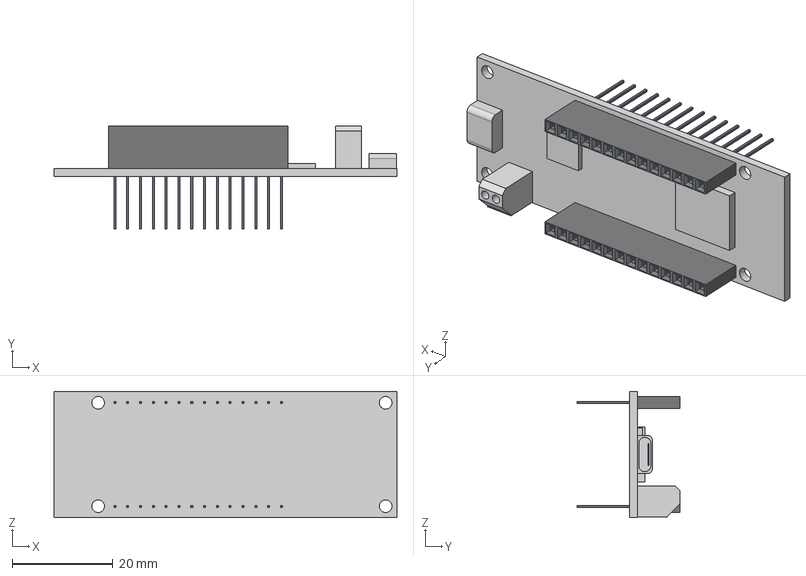
[picture p219: CAD file, 2022-04-22]
Desing/PCB/step/arduino-mkr-1300-wan.step
68.0 x 20.5 x 25.0 mm
pcb
14-pin-header x 2
