juandiz/SCARMOV_1.0/Desing/pcb_box/top.stl

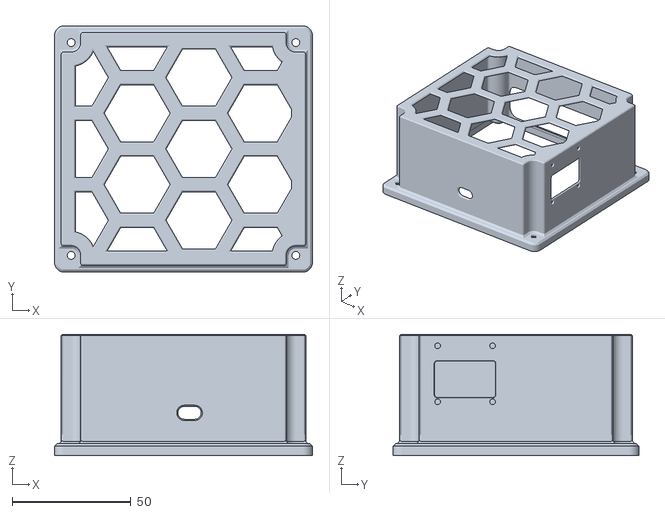
[picture p220: CAD file, 2022-04-22]
Desing/pcb_box/top.stl
108.5 x 103.5 x 51.0
