juandiz/SCARMOV_1.0/Desing/Pulleys/pulley_2.stl

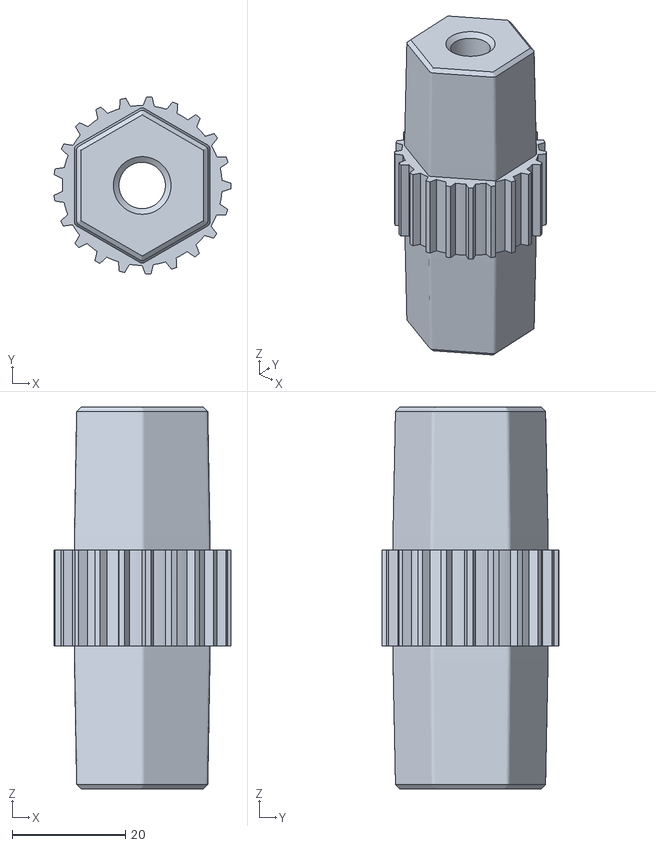
[picture p221: CAD file, 2022-04-22]
Desing/Pulleys/pulley_2.stl
31.3 x 31.4 x 67.6
