juandiz/SCARMOV_1.0/Desing/test/box.stl

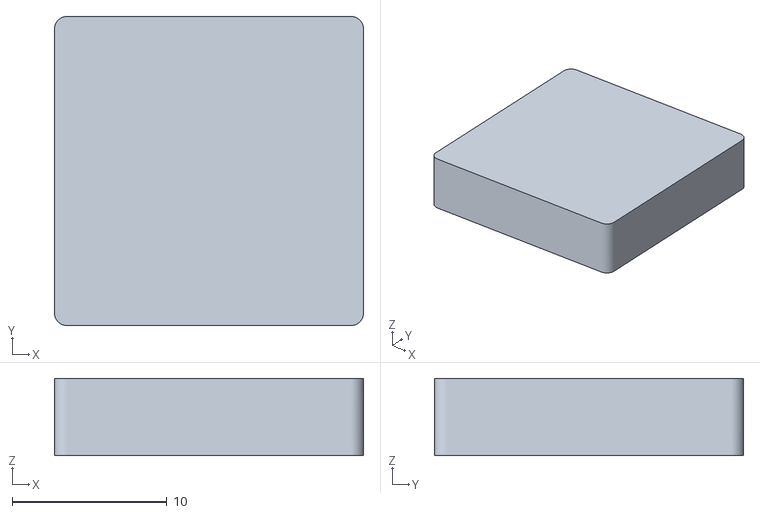
[picture p222: CAD file, 2022-04-22]
Desing/test/box.stl
20.0 x 20.0 x 5.00
