juandiz/SCARMOV_1.0/Desing/Base/escuadra_perfil_44x44.stl

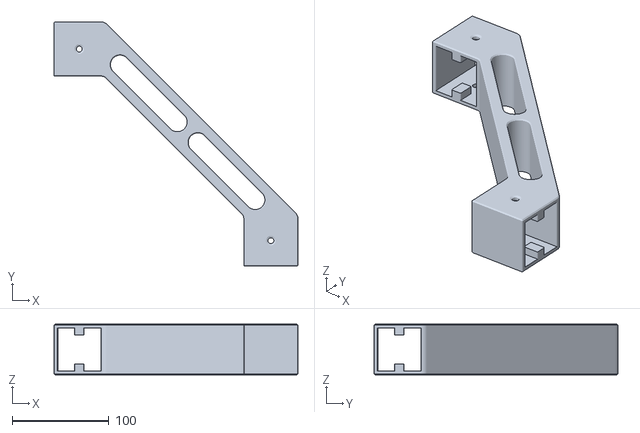
[picture p223: CAD file, 2022-04-22]
Desing/Base/escuadra_perfil_44x44.stl
252.4 x 252.4 x 52.4
