juandiz/SCARMOV_1.0/Desing/Eslabon_2/gripper_support.stl

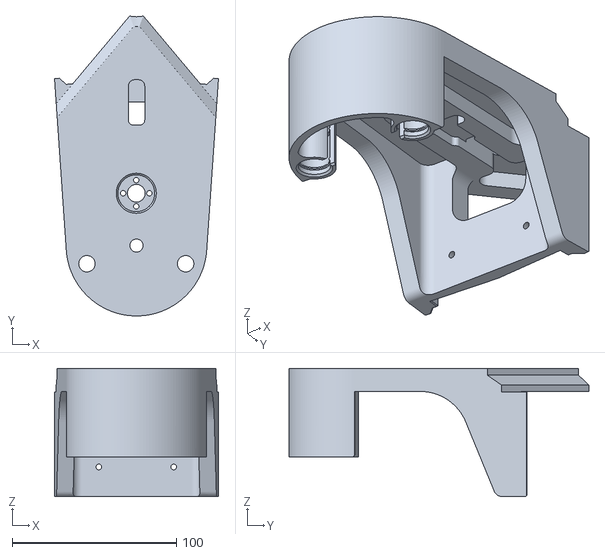
[picture p224: CAD file, 2022-04-22]
Desing/Eslabon_2/gripper_support.stl
99.9 x 182.7 x 78.0
