juandiz/SCARMOV_1.0/Desing/Gripper/gripper_structure.stl

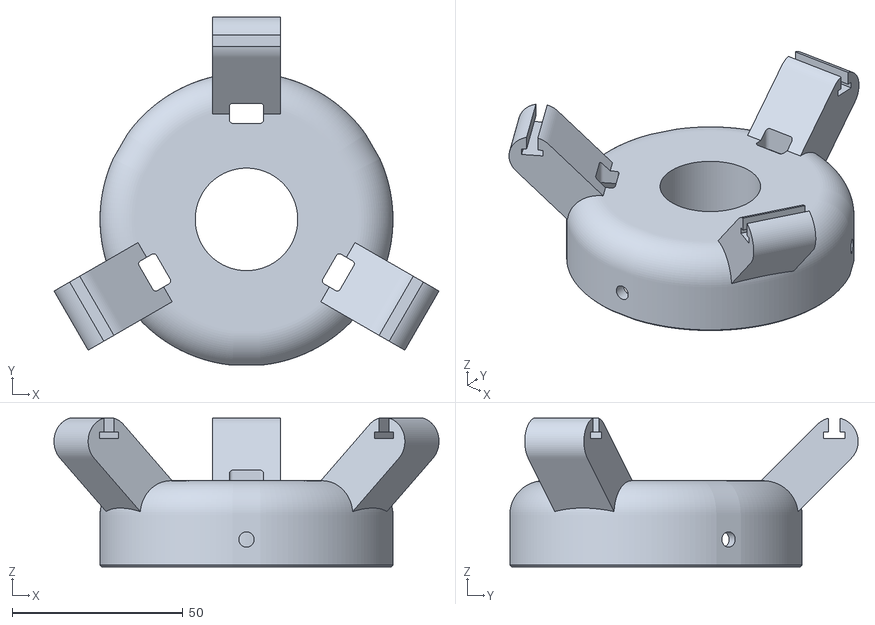
[picture p225: CAD file, 2022-04-22]
Desing/Gripper/gripper_structure.stl
112.7 x 102.0 x 43.5
