juandiz/SCARMOV_1.0/Desing/PCB/step/TMC 2130 v1.step

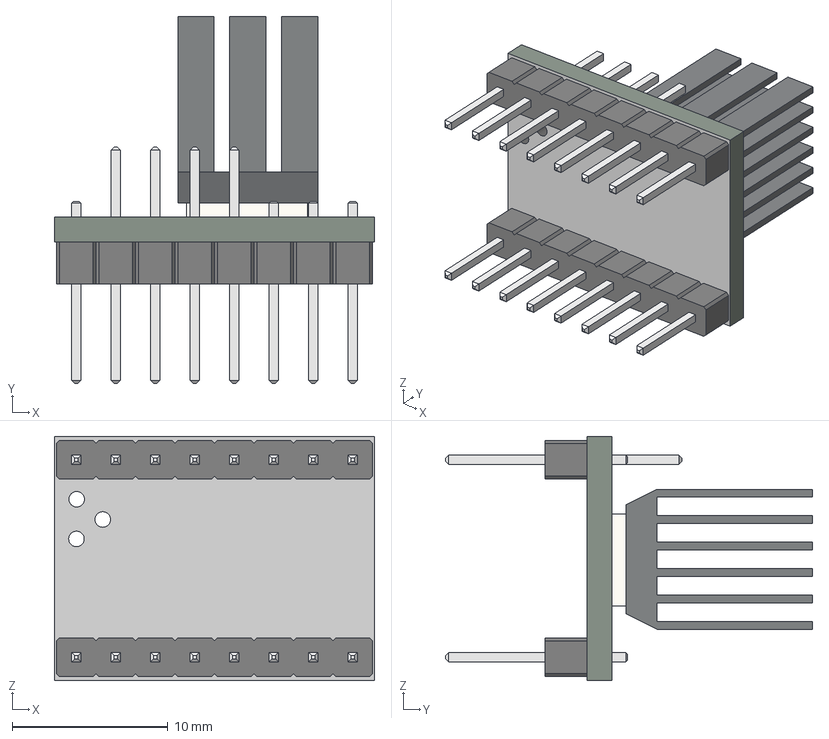
[picture p226: CAD file, 2022-04-22]
Desing/PCB/step/TMC 2130 v1.step
20.6 x 23.6 x 15.7 mm
