juandiz/SCARMOV_1.0/Desing/Pulleys/motor_pulley_M5.stl

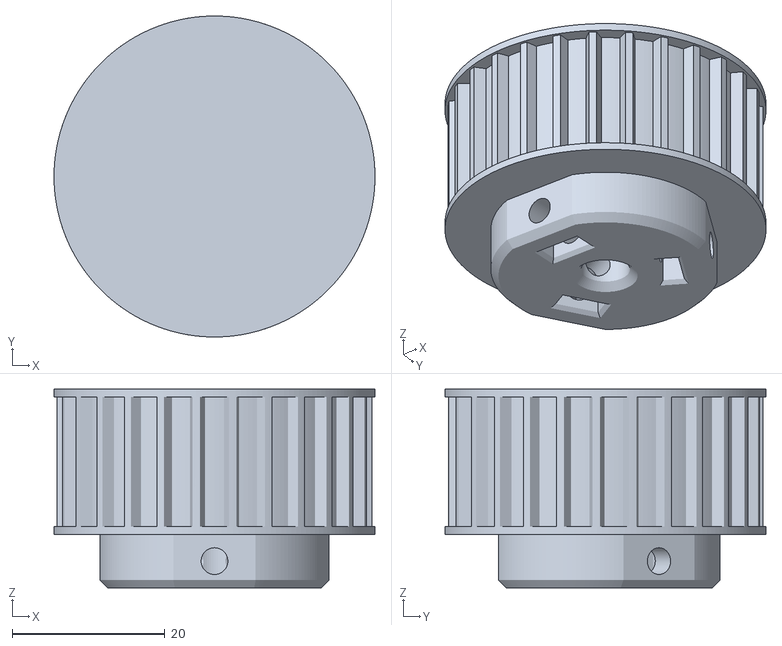
[picture p227: CAD file, 2022-04-22]
Desing/Pulleys/motor_pulley_M5.stl
42.0 x 42.0 x 26.0
