juandiz/SCARMOV_1.0/Desing/test/suppor_profile_test.stl

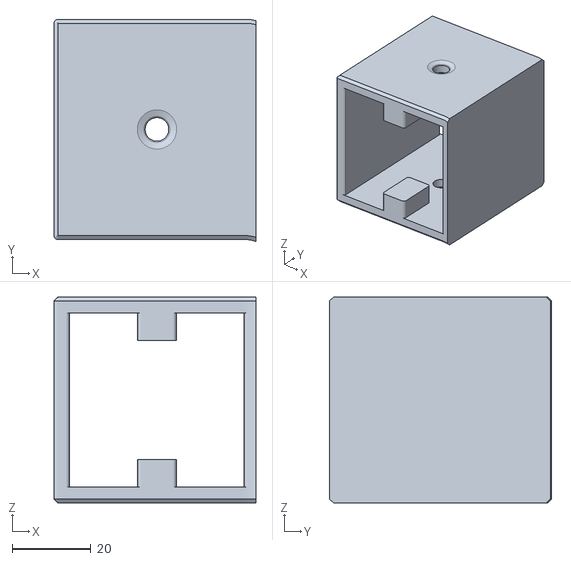
[picture p228: CAD file, 2022-04-22]
Desing/test/suppor_profile_test.stl
51.4 x 56.5 x 52.4
