juandiz/SCARMOV_1.0/Desing/Base/tapones_perfil.stl

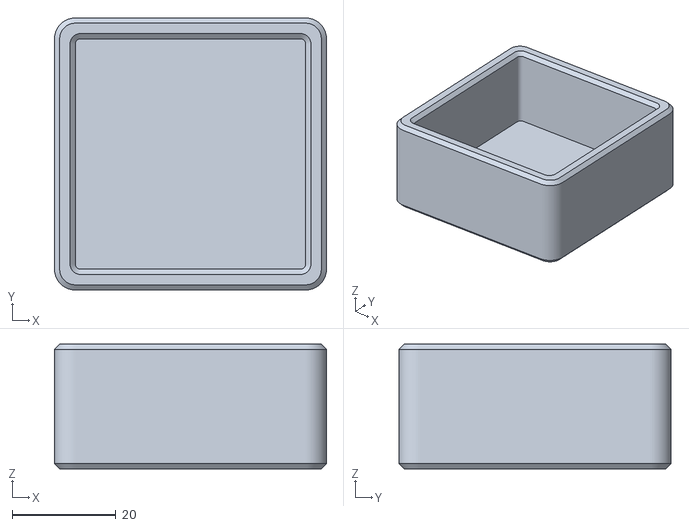
[picture p229: CAD file, 2022-04-22]
Desing/Base/tapones_perfil.stl
52.4 x 52.4 x 24.0
