juandiz/SCARMOV_1.0/Desing/Eslabon_2/BOTTOM_pull.stl

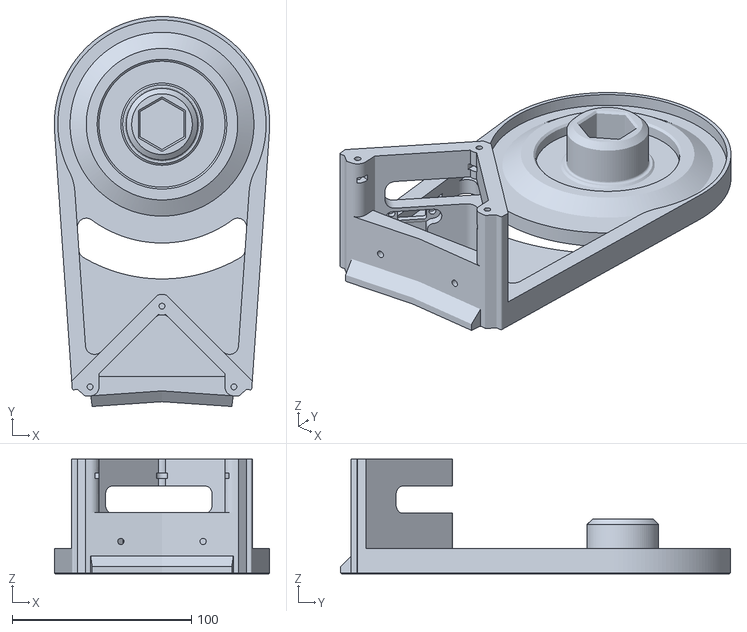
[picture p230: CAD file, 2022-04-22]
Desing/Eslabon_2/BOTTOM_pull.stl
120.0 x 217.3 x 63.8
