juandiz/SCARMOV_1.0/Desing/PCB/step/OLED 0.96_  V2.0.step

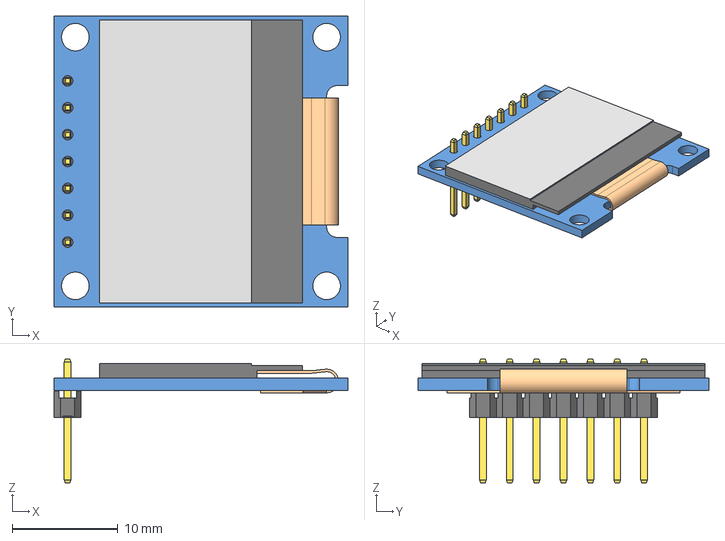
[picture p231: CAD file, 2022-04-22]
Desing/PCB/step/OLED 0.96_ V2.0.step
27.8 x 27.5 x 11.7 mm
LCD
Flex
