juandiz/SCARMOV_1.0/Desing/Base/Bottom.stl

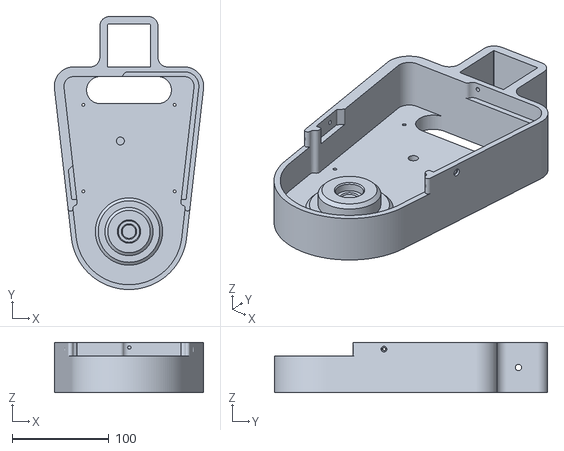
[picture p232: CAD file, 2022-04-22]
Desing/Base/Bottom.stl
154.7 x 282.6 x 52.1
