juandiz/SCARMOV_1.0/Desing/PCB/step/OLED 128x64.STP

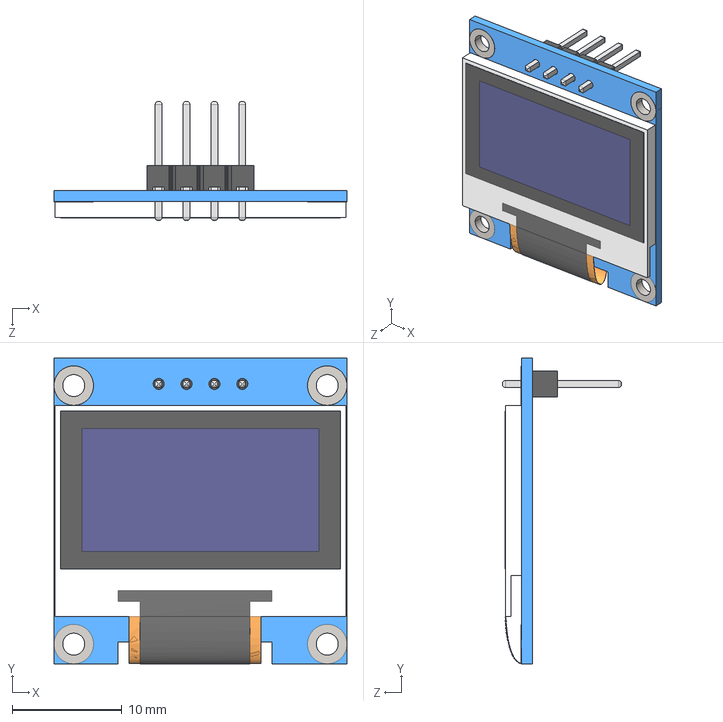
[picture p233: CAD file, 2022-04-22]
Desing/PCB/step/OLED 128x64.STP
26.7 x 27.9 x 10.8 mm
