juandiz/SCARMOV_1.0/Desing/PCB/step/Arduino MKR1000 Part.SLDPRT

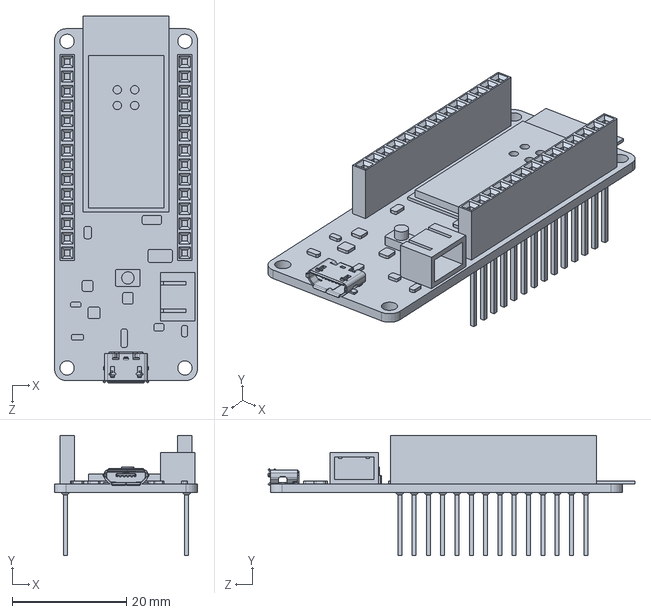
[picture p234: CAD file, 2022-04-22]
Desing/PCB/step/Arduino MKR1000 Part.SLDPRT
25.0 x 21.0 x 64.1 mm
