juandiz/SCARMOV_1.0/Desing/PCB/step/pxc_1985218_05_PTSA-1-5-4-3-5-Z_3D.stp

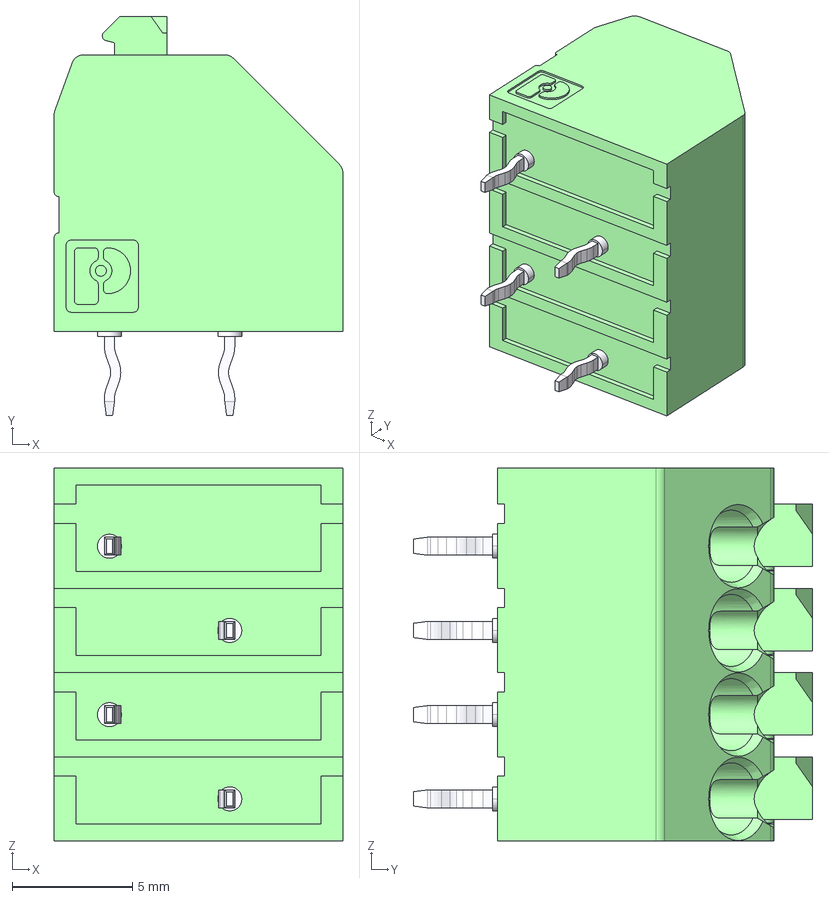
[picture p235: CAD file, 2022-04-22]
Desing/PCB/step/pxc_1985218_05_PTSA-1-5-4-3-5-Z_3D.stp
12.0 x 16.6 x 15.5 mm
