juandiz/SCARMOV_1.0/(list of files, cad)

Other CAD files:
Desing/bearing_holder/top.stl
