juandiz/SCARMOV_1.0/docs/Fuentes/Links/Inverse Kinematics_ how to move a robotic arm (and why this is harder than it seems) · Applied Go_files/lawofcosines.png

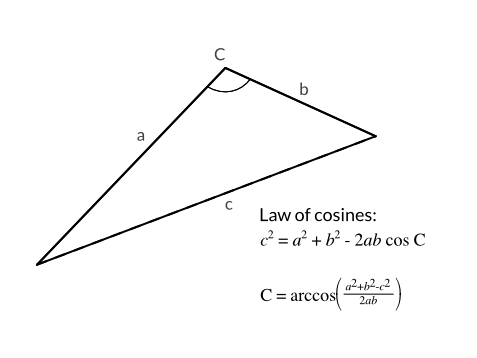
docs/Fuentes/Links/Inverse Kinematics_ how to move a robotic arm (and why this is harder than it seems) · Applied Go_files/lawofcosines.png
