juandiz/SCARMOV_1.0/docs/Imagenes/results/escuadra y montaje.jpg

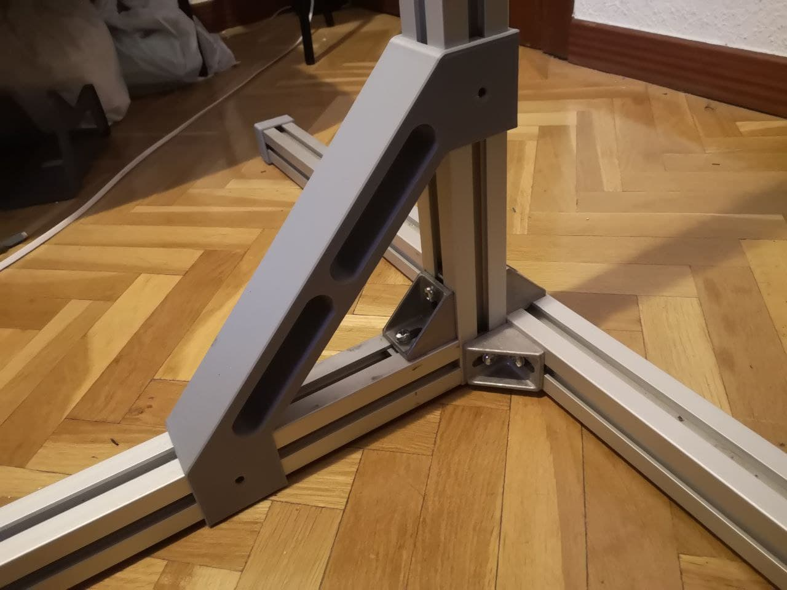
docs/Imagenes/results/escuadra y montaje.jpg
