juandiz/SCARMOV_1.0/docs/Imagenes/results/NO_BG/escuadra_y_montaje-removebg-preview.png

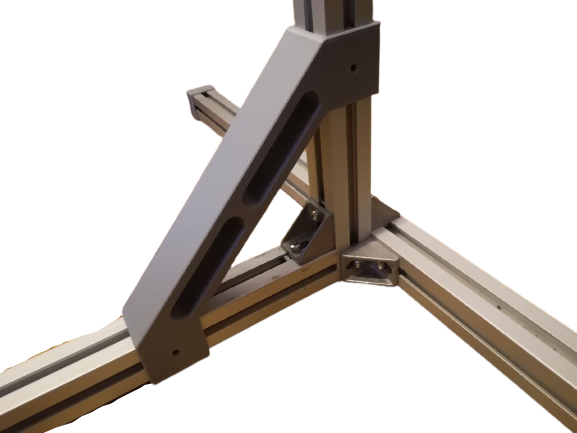
docs/Imagenes/results/NO_BG/escuadra_y_montaje-removebg-preview.png
