juandiz/SCARMOV_1.0/docs/Imagenes/desarrollo/componentes/FSR_result_exce.PNG

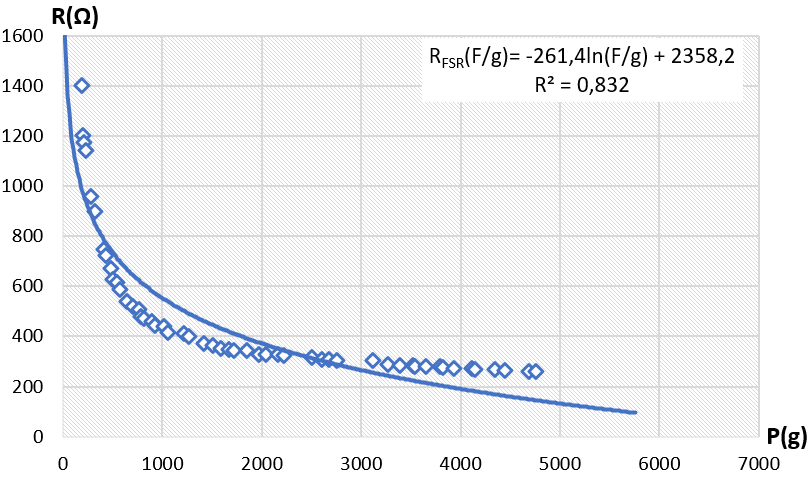
docs/Imagenes/desarrollo/componentes/FSR_result_exce.PNG
