juandiz/SCARMOV_1.0/docs/Imagenes/results/bae_bot.jpg

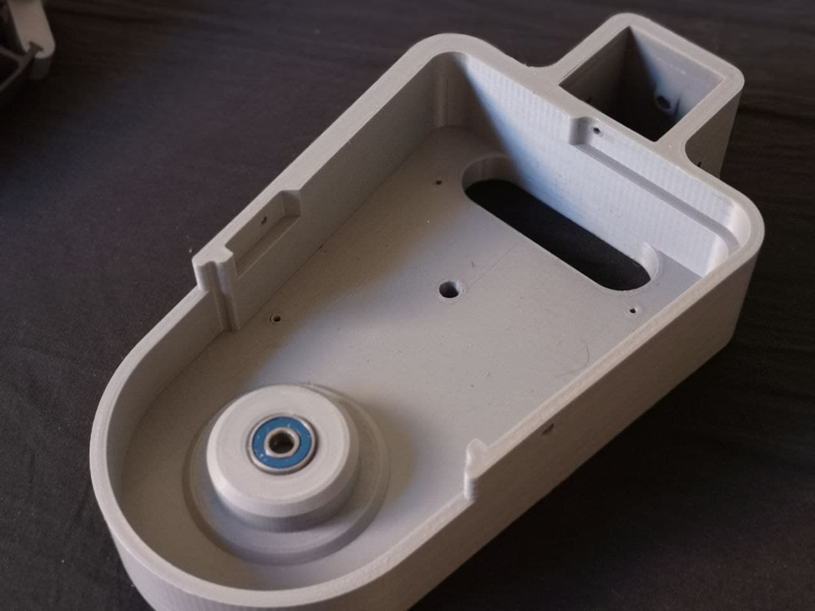
docs/Imagenes/results/bae_bot.jpg
