juandiz/SCARMOV_1.0/docs/Imagenes/results/base.jpg

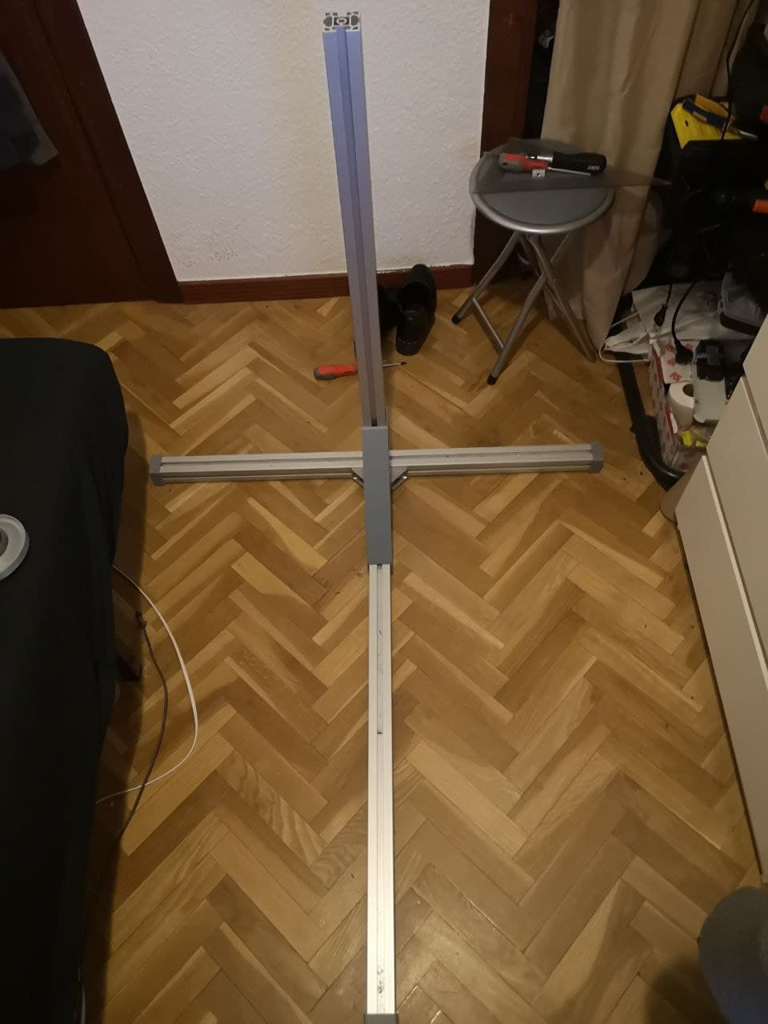
docs/Imagenes/results/base.jpg
