juandiz/SCARMOV_1.0/docs/Imagenes/results/base_top.jpg

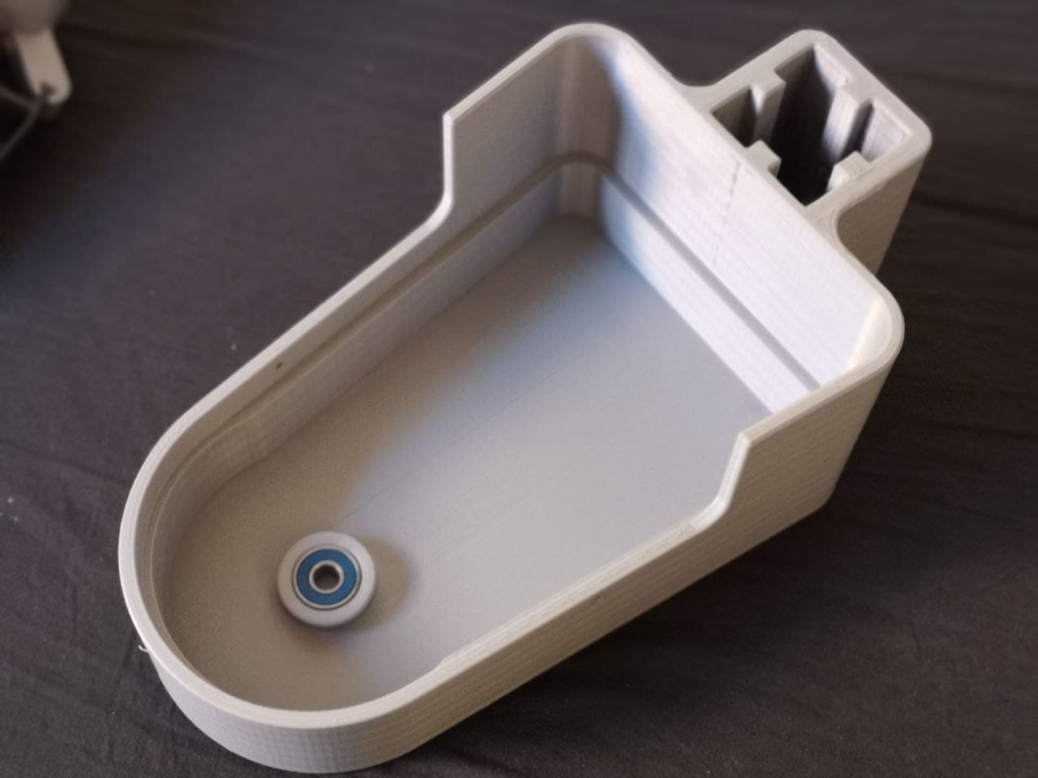
docs/Imagenes/results/base_top.jpg
