juandiz/SCARMOV_1.0/docs/Imagenes/results/base_top_motor.jpg

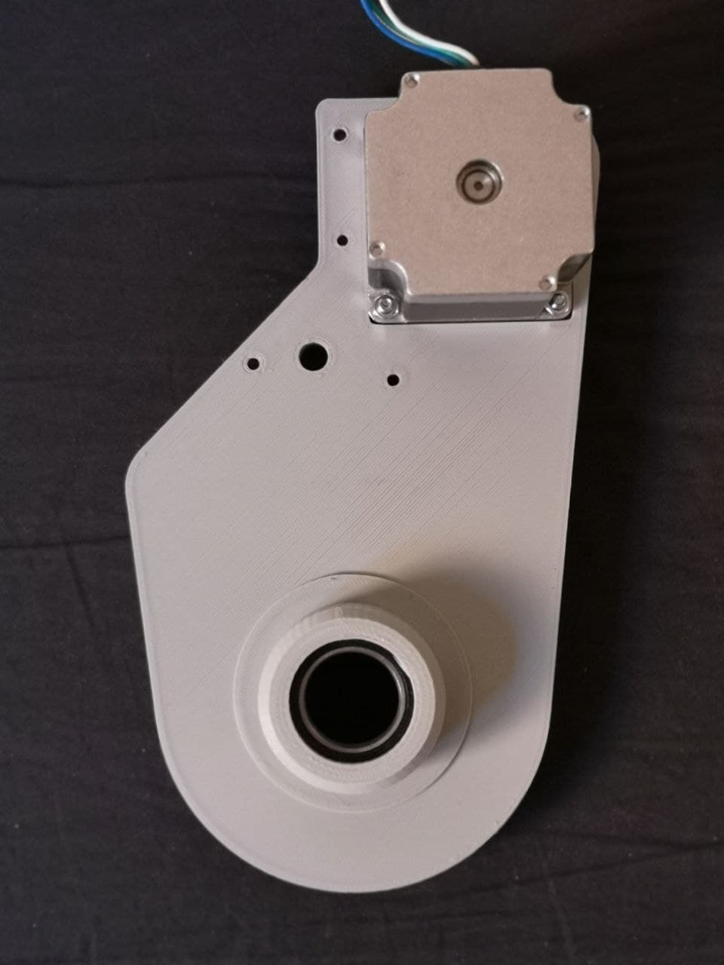
docs/Imagenes/results/base_top_motor.jpg
