juandiz/SCARMOV_1.0/docs/Imagenes/results/BS2_3.jpg

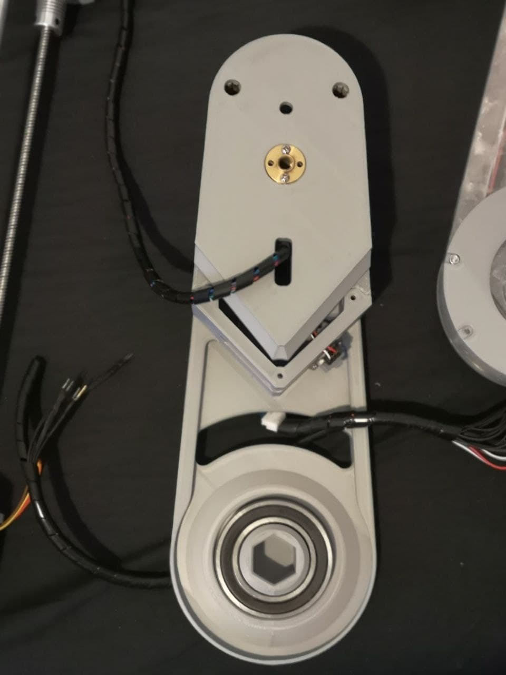
docs/Imagenes/results/BS2_3.jpg
