juandiz/SCARMOV_1.0/docs/Imagenes/results/bs_SUPPORTMOT.jpg

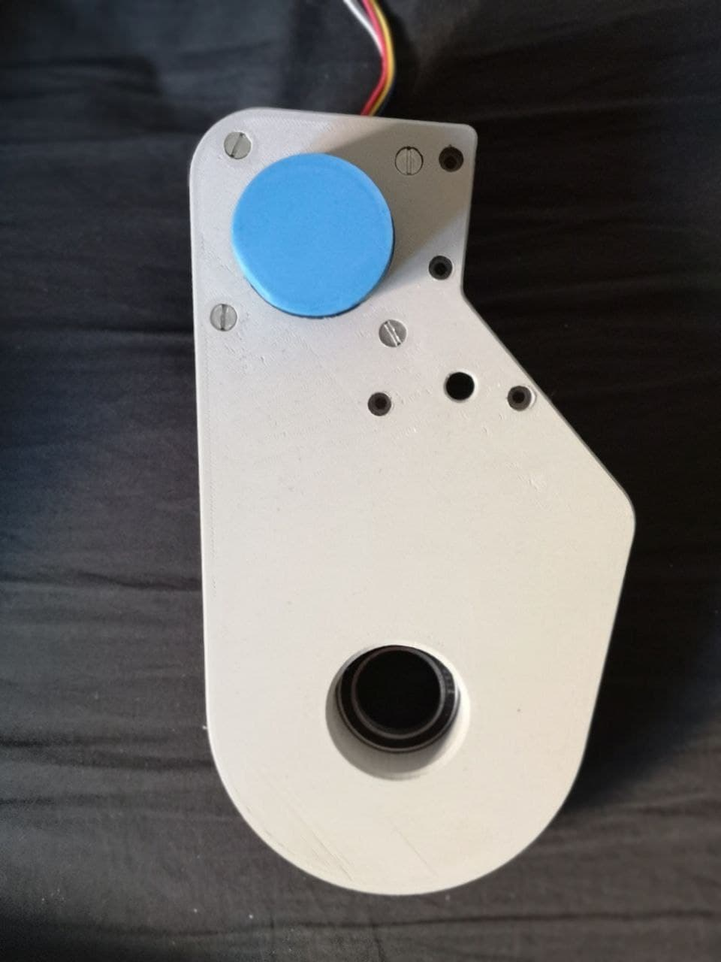
docs/Imagenes/results/bs_SUPPORTMOT.jpg
