juandiz/SCARMOV_1.0/docs/Imagenes/results/complete1.jpg

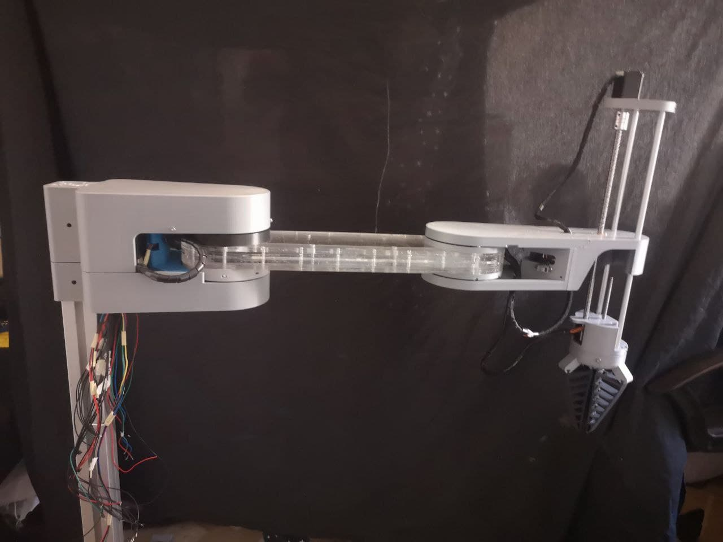
docs/Imagenes/results/complete1.jpg
