juandiz/SCARMOV_1.0/docs/Imagenes/results/complete3.jpg

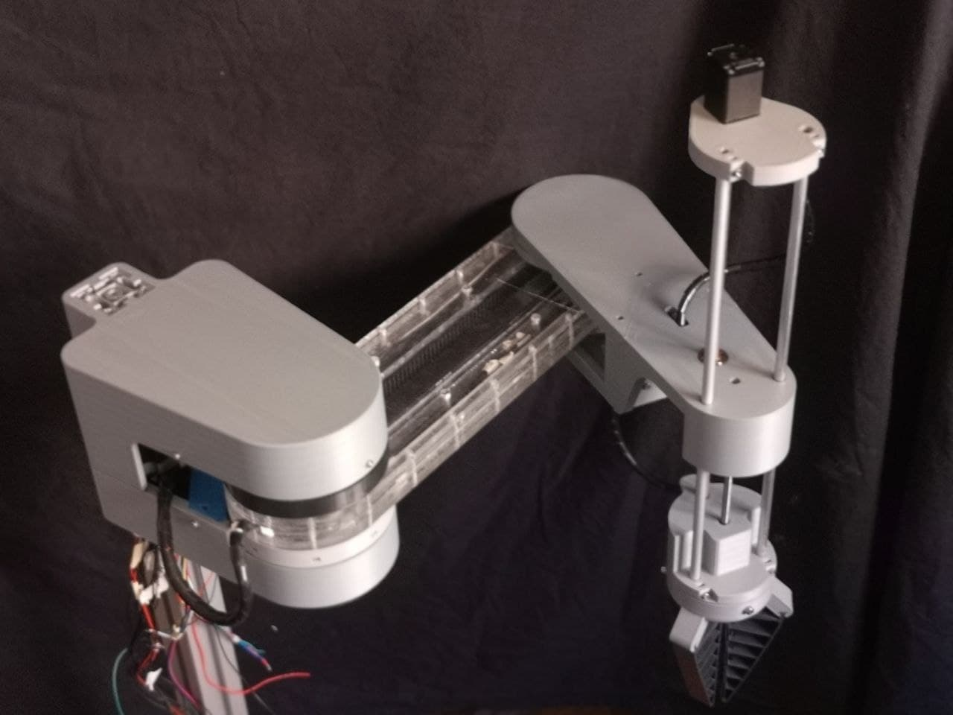
docs/Imagenes/results/complete3.jpg
