juandiz/SCARMOV_1.0/docs/Imagenes/results/conexionesSG.jpg

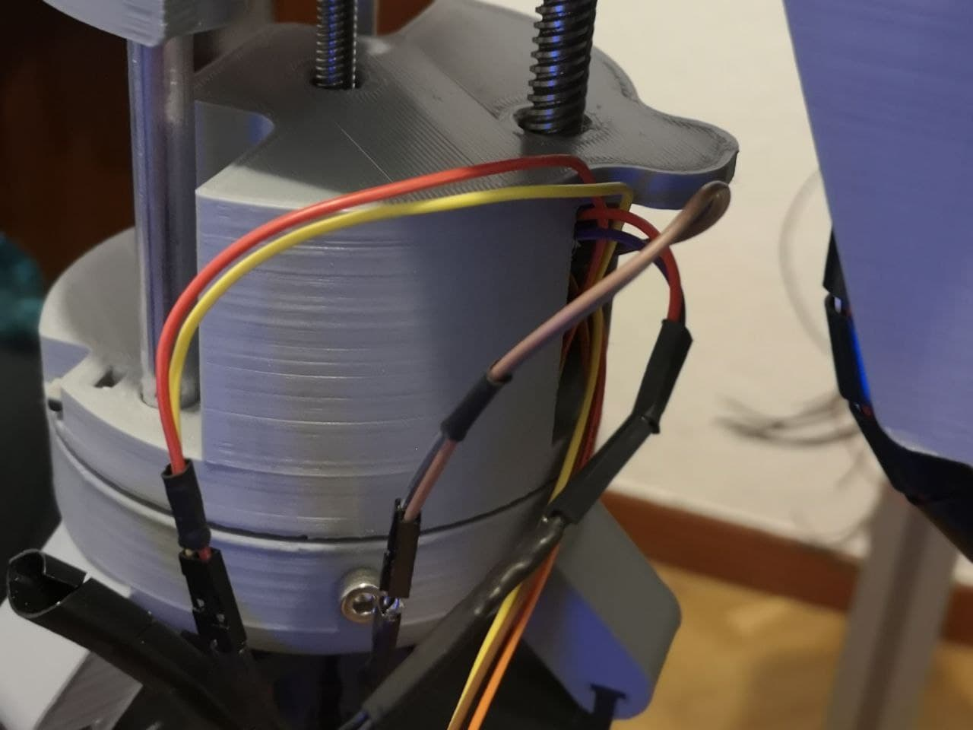
docs/Imagenes/results/conexionesSG.jpg
