juandiz/SCARMOV_1.0/docs/Imagenes/results/ESB1_2.jpg

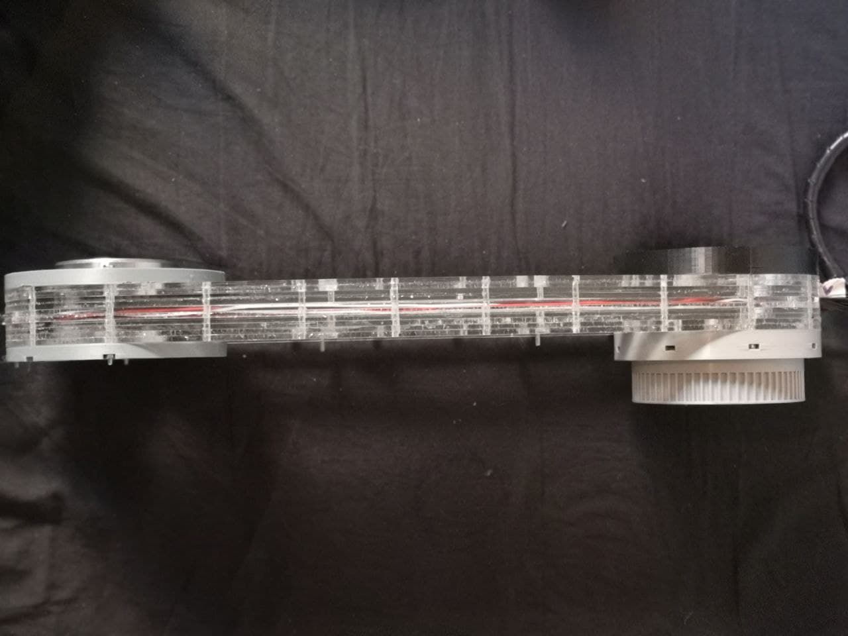
docs/Imagenes/results/ESB1_2.jpg
