juandiz/SCARMOV_1.0/docs/Imagenes/results/ESB2.jpg

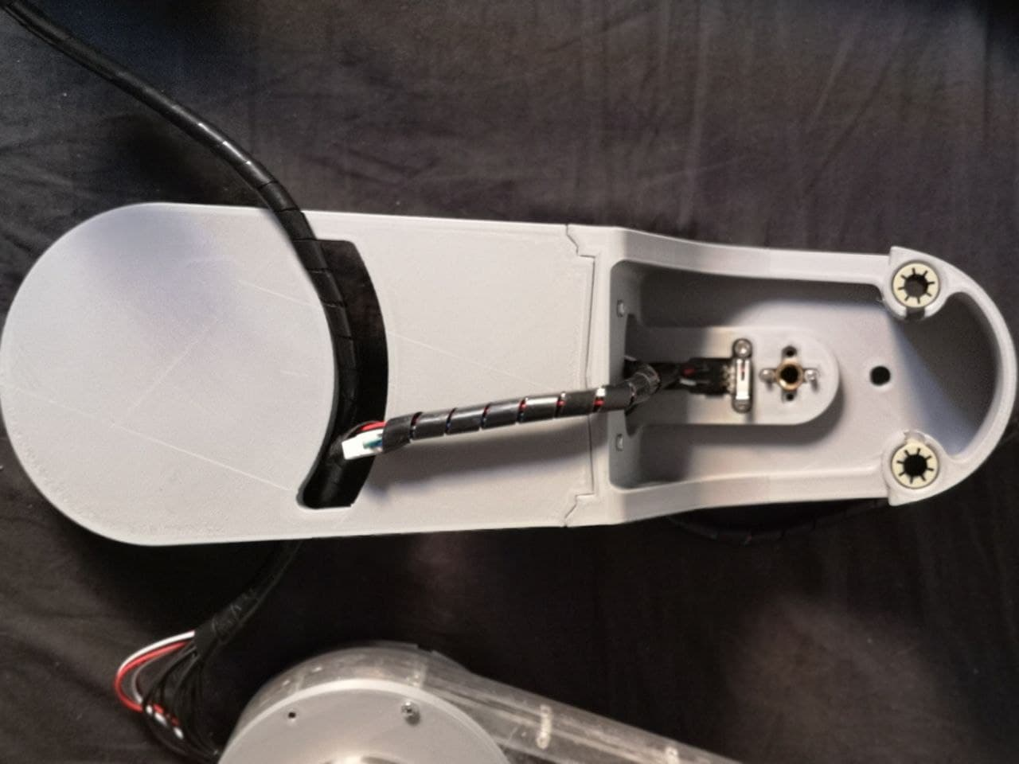
docs/Imagenes/results/ESB2.jpg
