juandiz/SCARMOV_1.0/docs/Imagenes/results/esb2_top.jpg

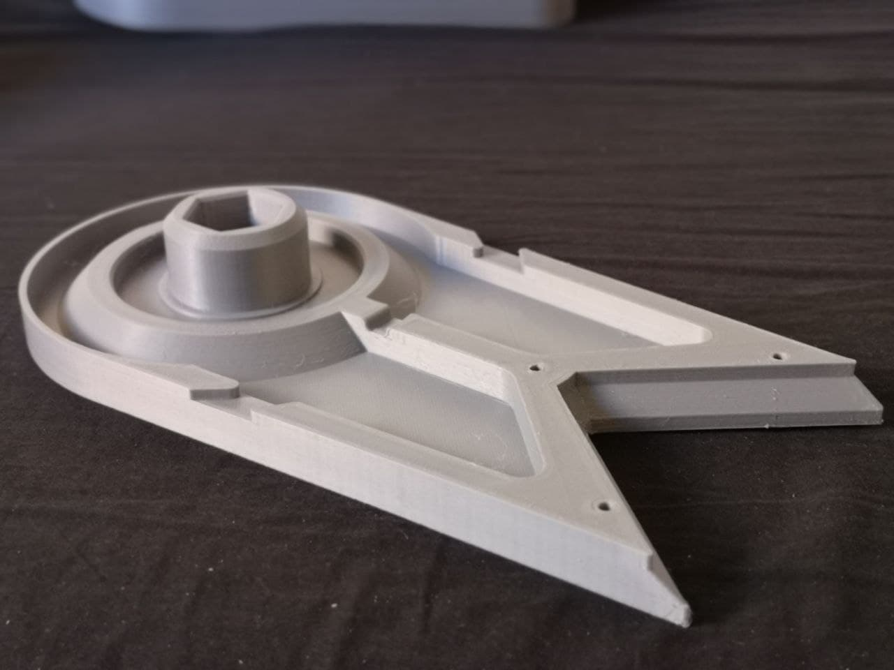
docs/Imagenes/results/esb2_top.jpg
