juandiz/SCARMOV_1.0/docs/Imagenes/results/esb3.jpg

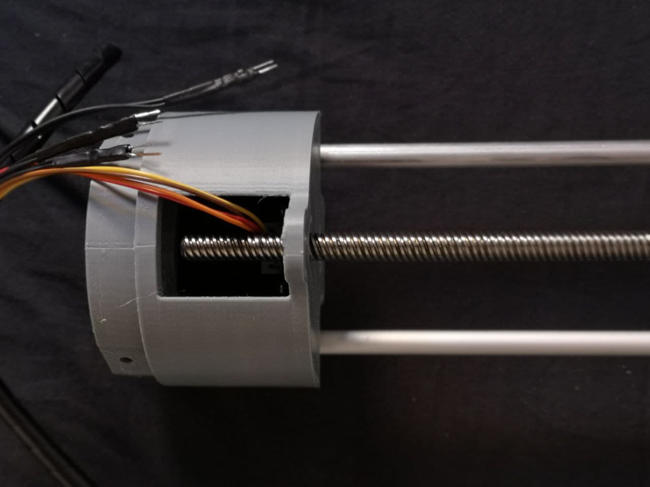
docs/Imagenes/results/esb3.jpg
