juandiz/SCARMOV_1.0/docs/Imagenes/results/esb31.jpg

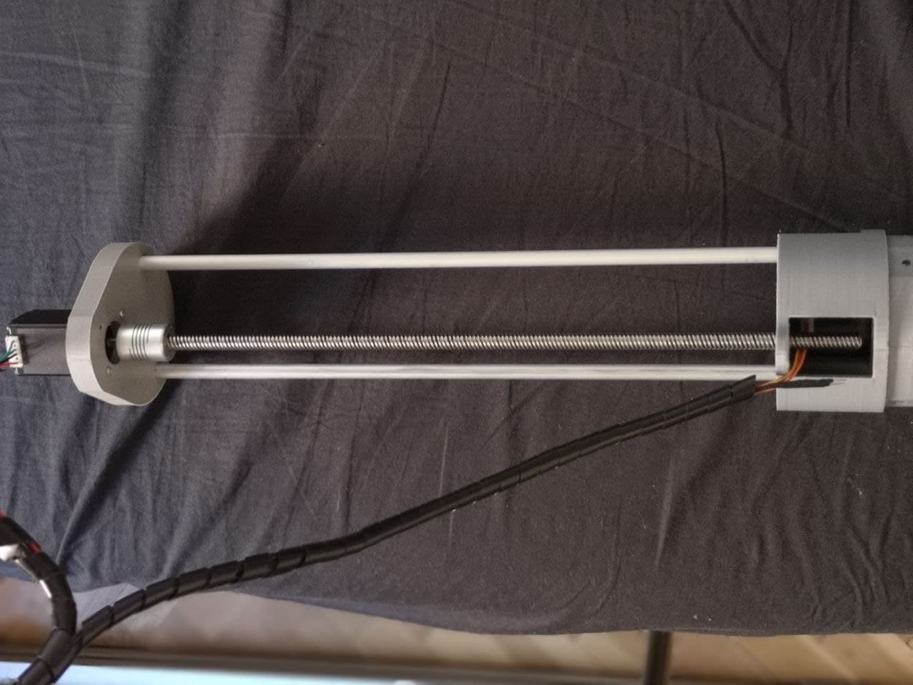
docs/Imagenes/results/esb31.jpg
