juandiz/SCARMOV_1.0/docs/Imagenes/results/esb32.jpg

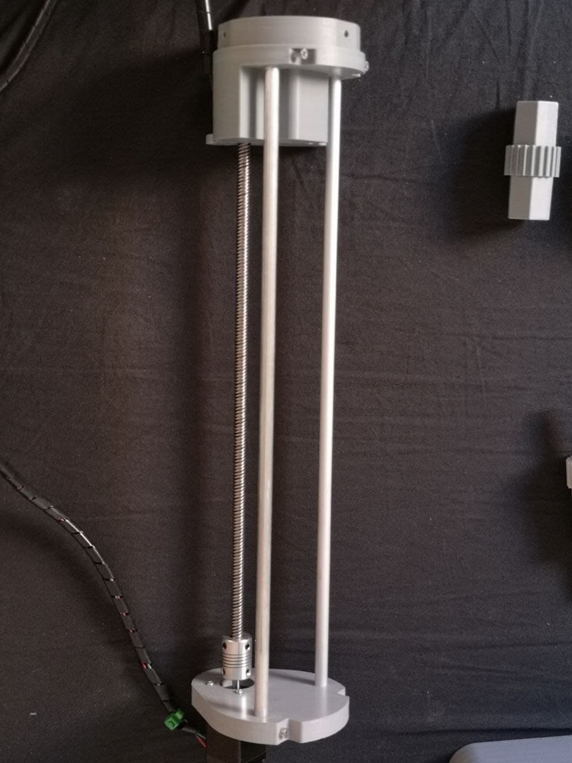
docs/Imagenes/results/esb32.jpg
