juandiz/SCARMOV_1.0/docs/Imagenes/results/ESB!_1.jpg

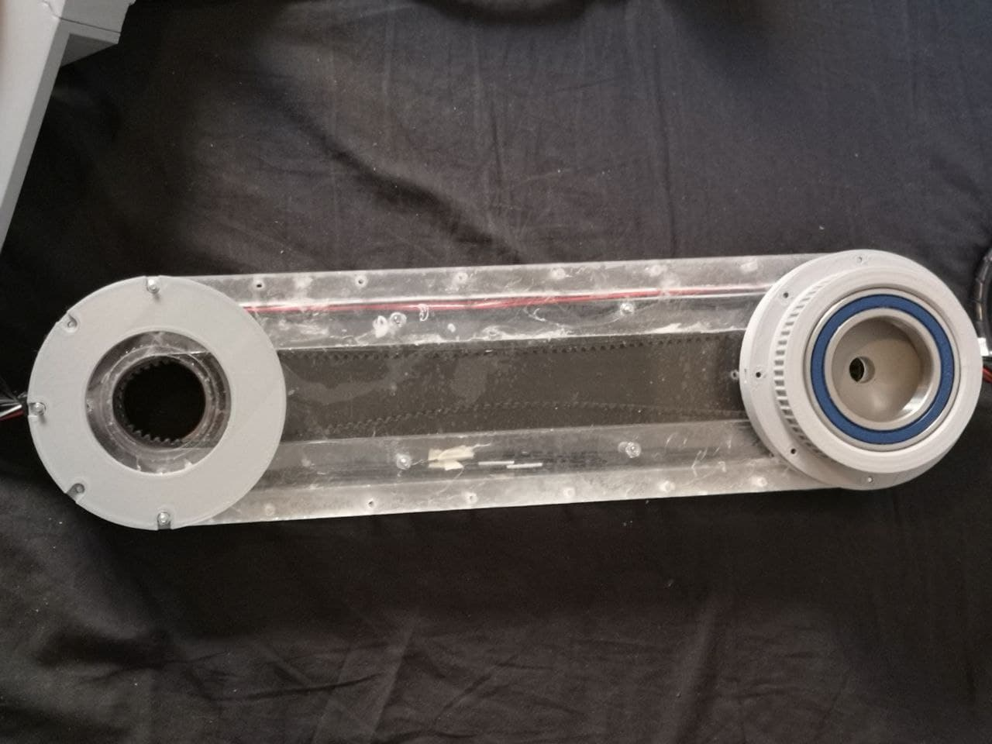
docs/Imagenes/results/ESB!_1.jpg
