juandiz/SCARMOV_1.0/docs/Imagenes/results/ESB_3.jpg

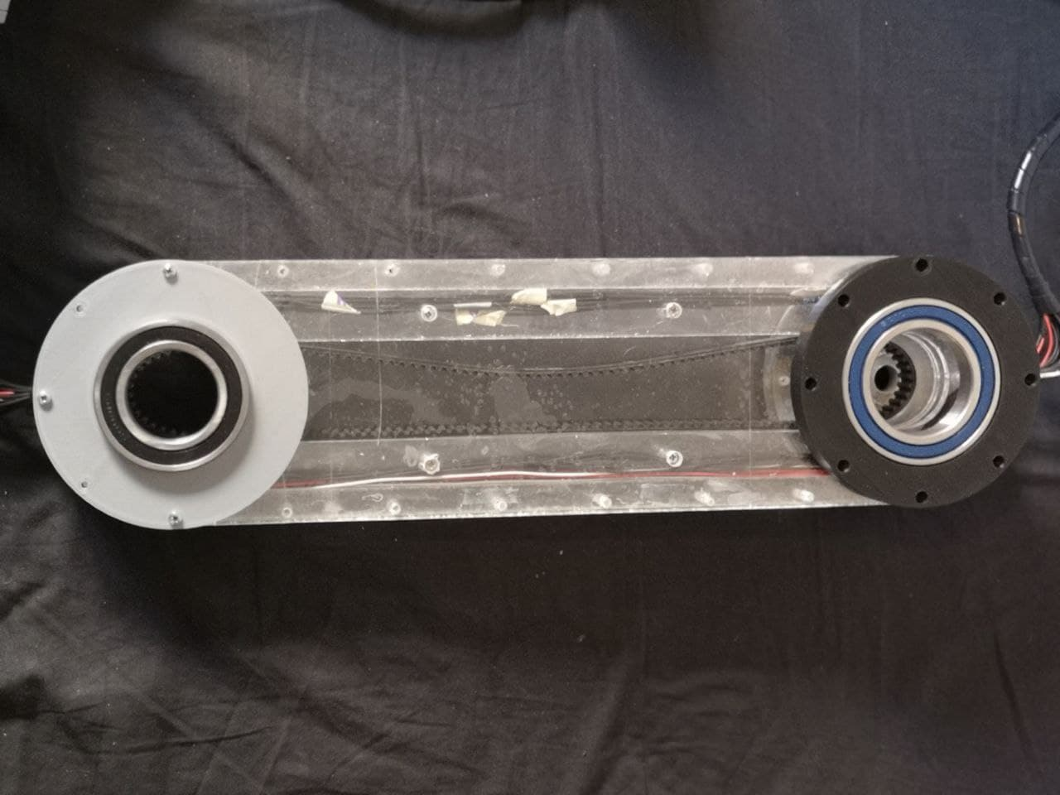
docs/Imagenes/results/ESB_3.jpg
