juandiz/SCARMOV_1.0/docs/Imagenes/results/escuadra extra2.PNG

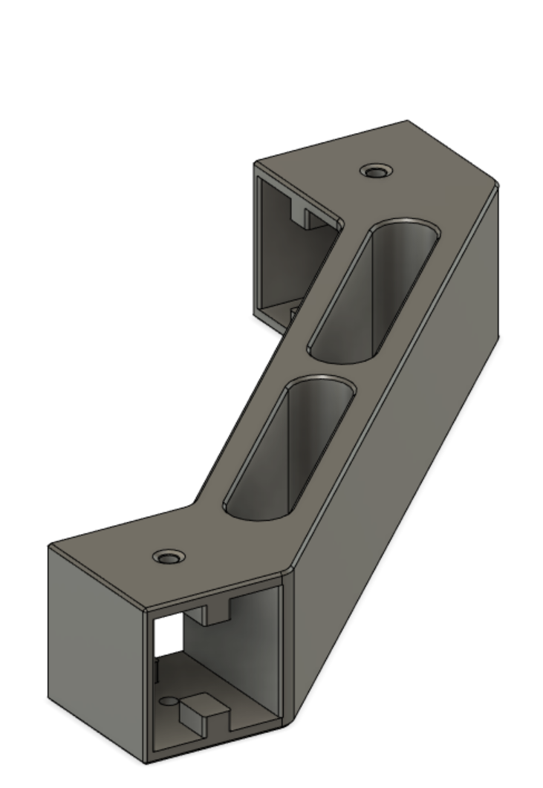
docs/Imagenes/results/escuadra extra2.PNG
