juandiz/SCARMOV_1.0/docs/Imagenes/results/escuadra extra.PNG

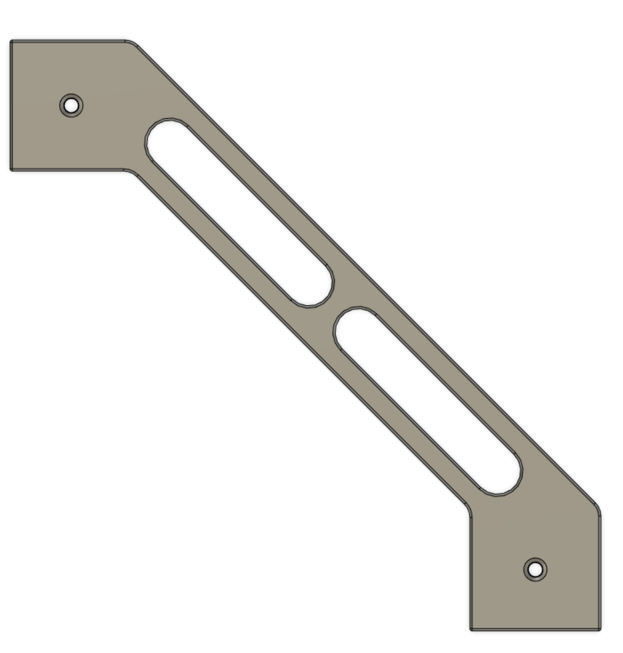
docs/Imagenes/results/escuadra extra.PNG
