juandiz/SCARMOV_1.0/docs/Imagenes/results/grippe.jpg

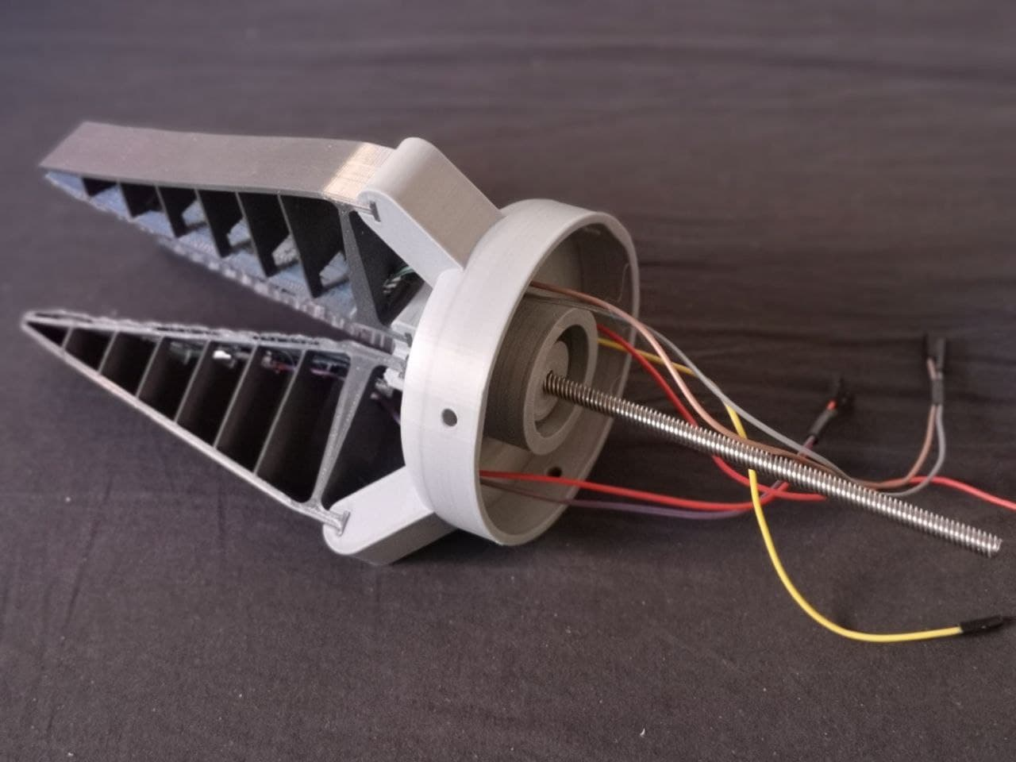
docs/Imagenes/results/grippe.jpg
