juandiz/SCARMOV_1.0/docs/Imagenes/results/gripper.jpg

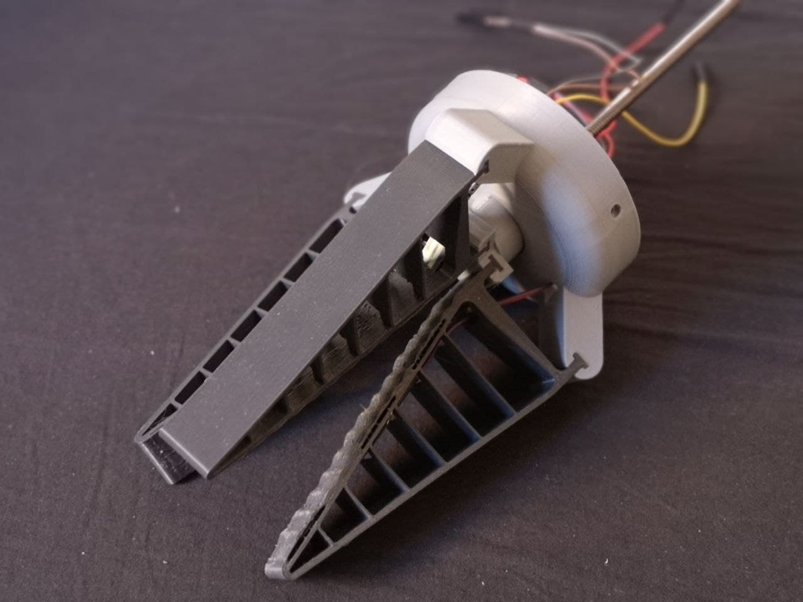
docs/Imagenes/results/gripper.jpg
