juandiz/SCARMOV_1.0/docs/Imagenes/results/I-reg.png

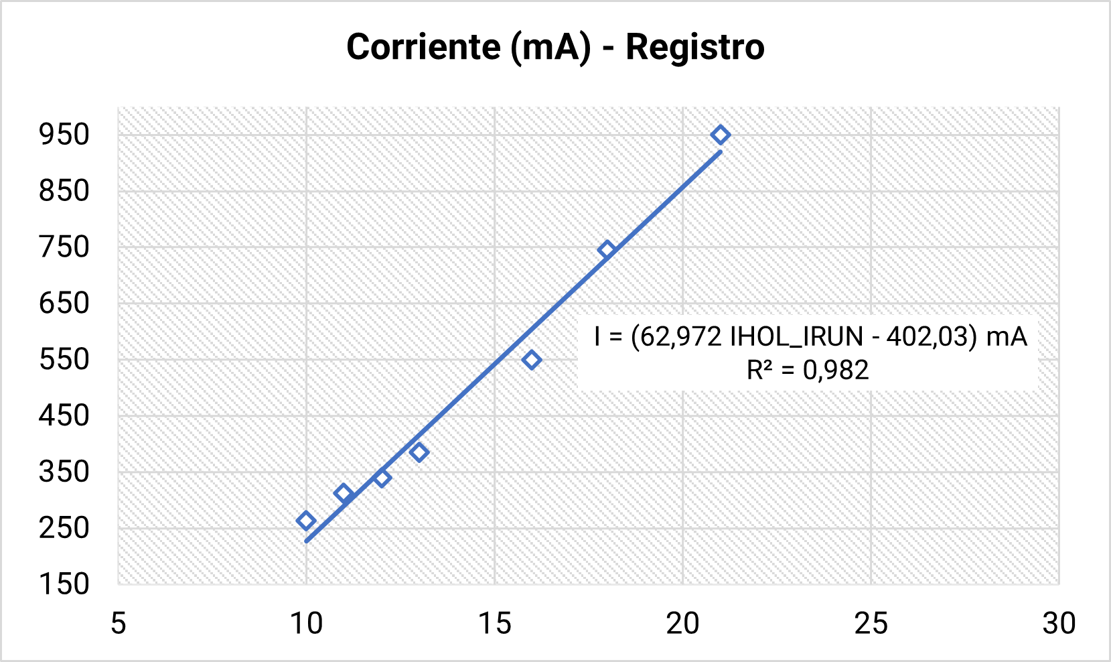
docs/Imagenes/results/I-reg.png
