juandiz/SCARMOV_1.0/docs/Imagenes/results/NO_BG/bae_bot-removebg-preview - copia.png

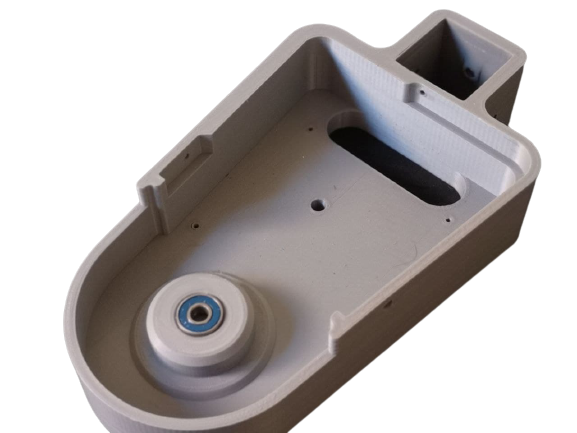
docs/Imagenes/results/NO_BG/bae_bot-removebg-preview - copia.png
