juandiz/SCARMOV_1.0/docs/Imagenes/results/NO_BG/base_in.png

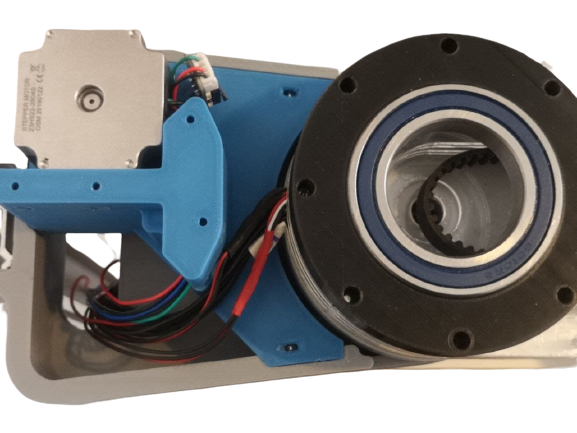
docs/Imagenes/results/NO_BG/base_in.png
