juandiz/SCARMOV_1.0/docs/Imagenes/results/NO_BG/base_top_motor-removebg-preview - copia.png

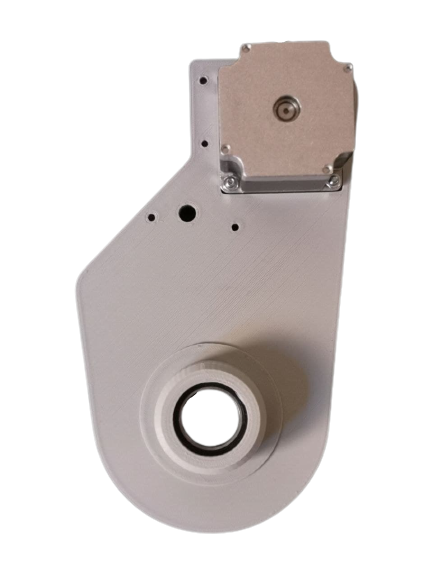
docs/Imagenes/results/NO_BG/base_top_motor-removebg-preview - copia.png
