juandiz/SCARMOV_1.0/docs/Imagenes/results/NO_BG/base_V5.png

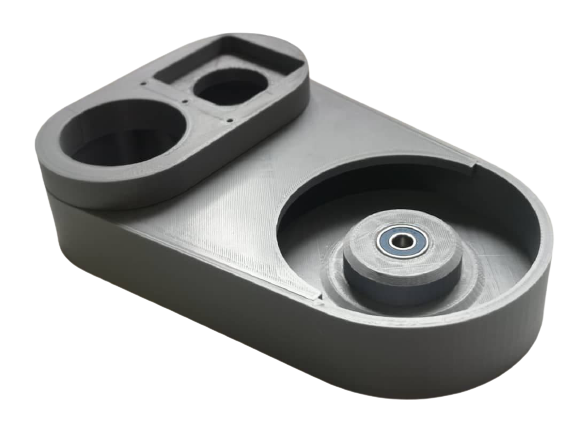
docs/Imagenes/results/NO_BG/base_V5.png
