juandiz/SCARMOV_1.0/docs/Imagenes/results/NO_BG/BS2_3-removebg-preview.png

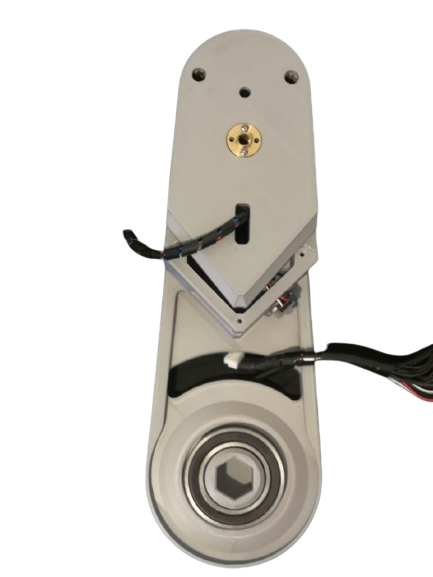
docs/Imagenes/results/NO_BG/BS2_3-removebg-preview.png
