juandiz/SCARMOV_1.0/docs/Imagenes/results/NO_BG/bs_SUPPORTMOT-removebg-preview.png

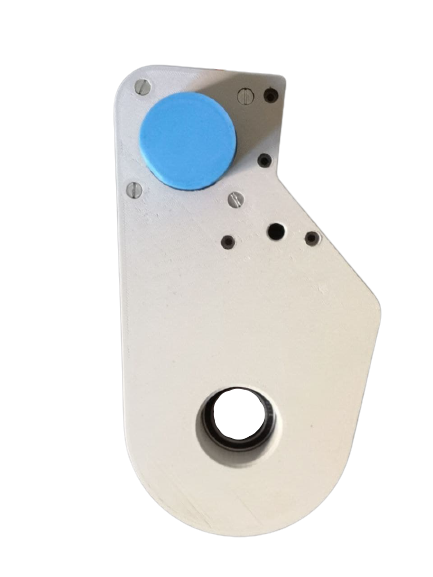
docs/Imagenes/results/NO_BG/bs_SUPPORTMOT-removebg-preview.png
