juandiz/SCARMOV_1.0/docs/Imagenes/results/NO_BG/BS_TOP_MOT2_1.png

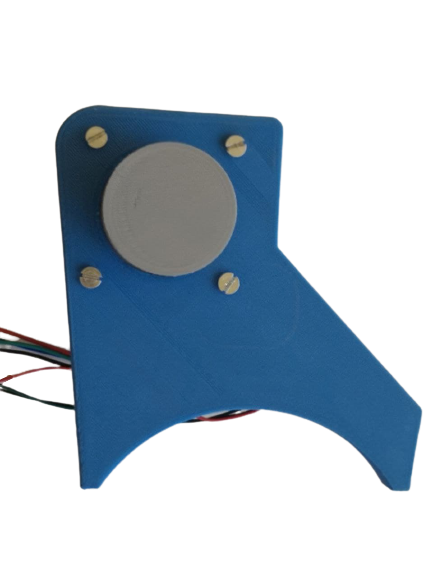
docs/Imagenes/results/NO_BG/BS_TOP_MOT2_1.png
