juandiz/SCARMOV_1.0/docs/Imagenes/results/NO_BG/conexionesSG-removebg-preview.png

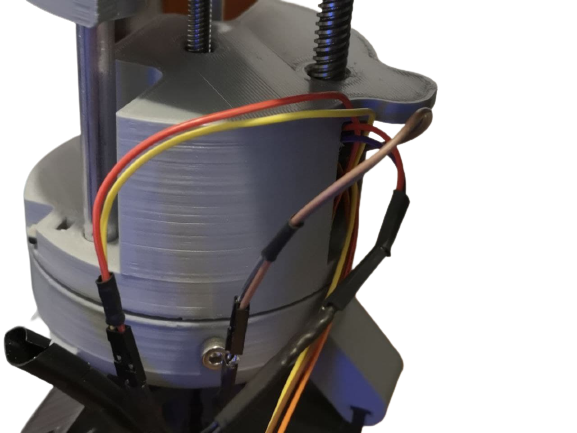
docs/Imagenes/results/NO_BG/conexionesSG-removebg-preview.png
