juandiz/SCARMOV_1.0/docs/Imagenes/results/NO_BG/esb2_top-removebg-preview.png

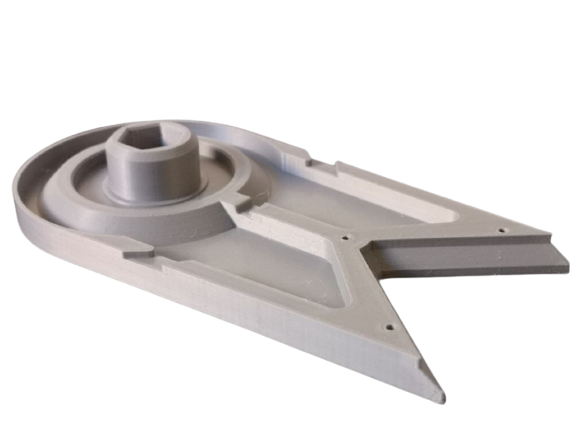
docs/Imagenes/results/NO_BG/esb2_top-removebg-preview.png
