juandiz/SCARMOV_1.0/docs/Imagenes/results/NO_BG/esb3-removebg-preview.png

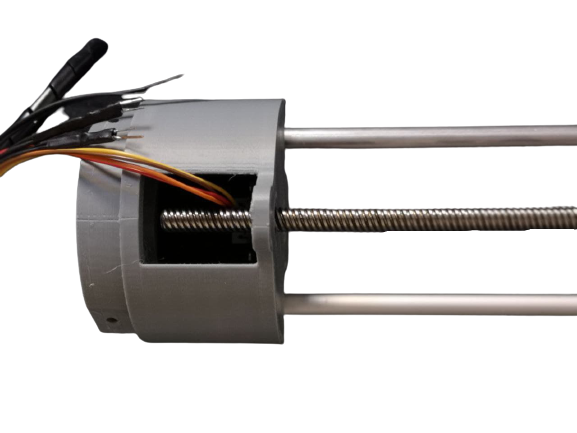
docs/Imagenes/results/NO_BG/esb3-removebg-preview.png
