juandiz/SCARMOV_1.0/docs/Imagenes/results/NO_BG/esb32-removebg-preview.png

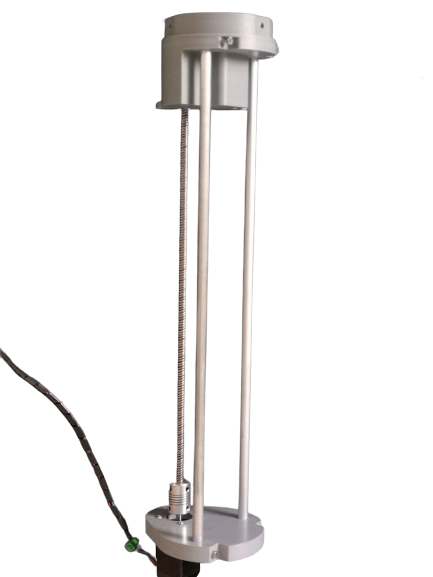
docs/Imagenes/results/NO_BG/esb32-removebg-preview.png
