juandiz/SCARMOV_1.0/docs/Imagenes/results/NO_BG/ESB__1-removebg-preview.png

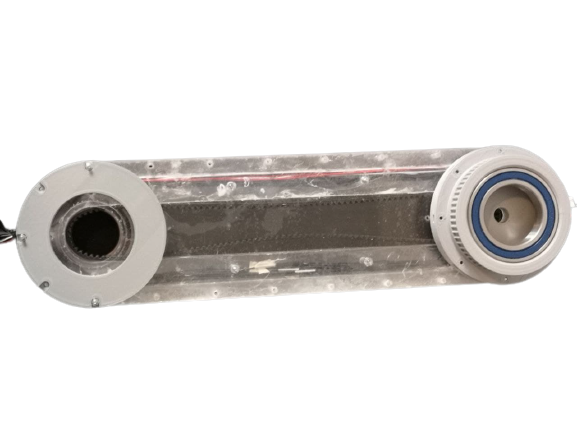
docs/Imagenes/results/NO_BG/ESB__1-removebg-preview.png
