juandiz/SCARMOV_1.0/docs/Imagenes/results/NO_BG/grippe-removebg-preview.png

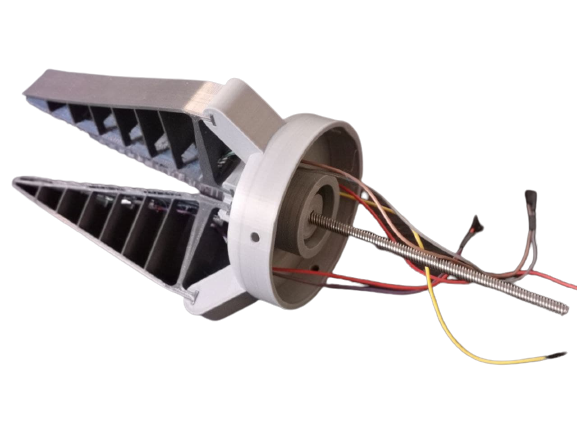
docs/Imagenes/results/NO_BG/grippe-removebg-preview.png
