juandiz/SCARMOV_1.0/docs/Imagenes/results/NO_BG/PCBOX_TOP-removebg-preview.png

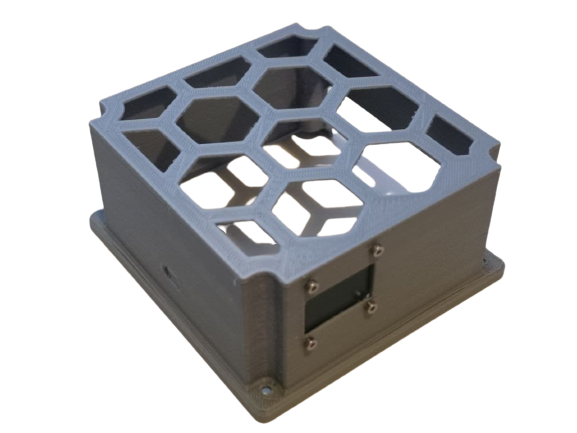
docs/Imagenes/results/NO_BG/PCBOX_TOP-removebg-preview.png
