juandiz/SCARMOV_1.0/docs/Imagenes/results/NO_BG/poleaesb2-removebg-preview.png

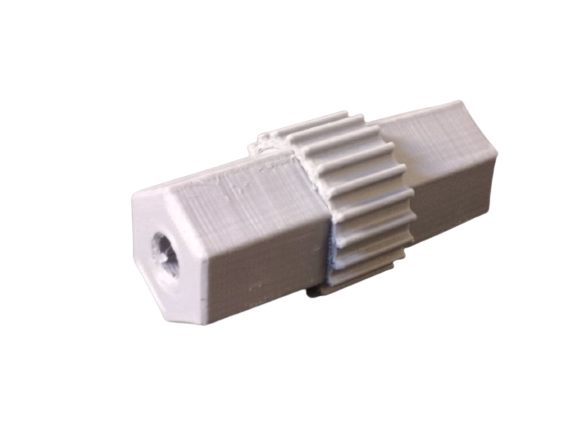
docs/Imagenes/results/NO_BG/poleaesb2-removebg-preview.png
