juandiz/SCARMOV_1.0/docs/Imagenes/results/NO_BG/poleas-removebg-preview.png

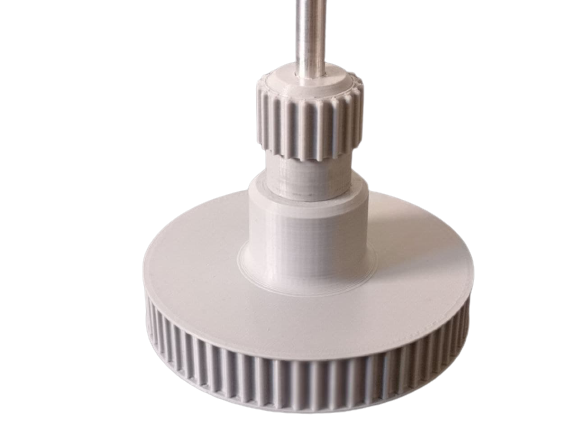
docs/Imagenes/results/NO_BG/poleas-removebg-preview.png
