juandiz/SCARMOV_1.0/docs/Imagenes/results/NO_BG/poleas_4-removebg-preview.png

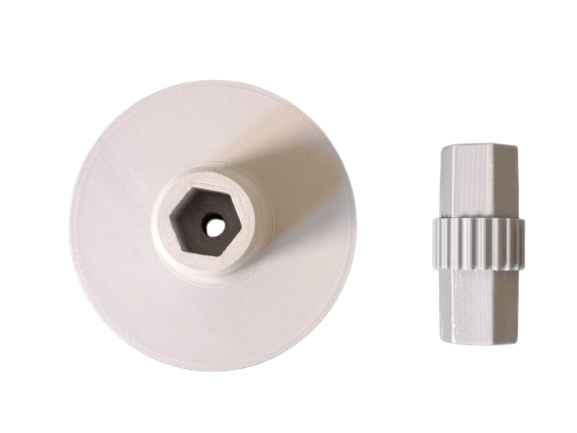
docs/Imagenes/results/NO_BG/poleas_4-removebg-preview.png
