juandiz/SCARMOV_1.0/docs/Imagenes/results/NO_BG/robotsinbase2-removebg-preview.png

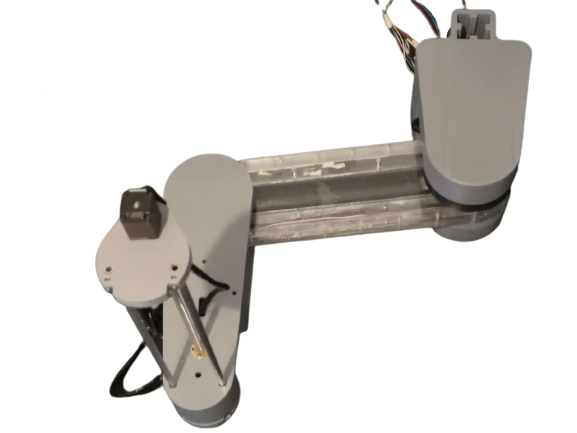
docs/Imagenes/results/NO_BG/robotsinbase2-removebg-preview.png
