juandiz/SCARMOV_1.0/docs/Imagenes/results/NO_BG/robotsinbase_top2-removebg-preview.png

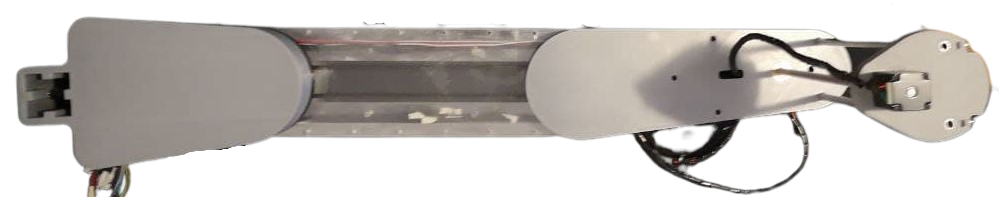
docs/Imagenes/results/NO_BG/robotsinbase_top2-removebg-preview.png
