juandiz/SCARMOV_1.0/docs/Imagenes/results/NO_BG/sgflex2-removebg-preview.png

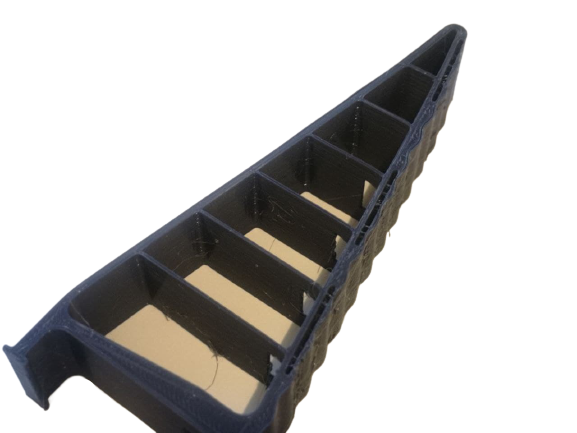
docs/Imagenes/results/NO_BG/sgflex2-removebg-preview.png
