juandiz/SCARMOV_1.0/docs/Imagenes/results/ole1.jpg

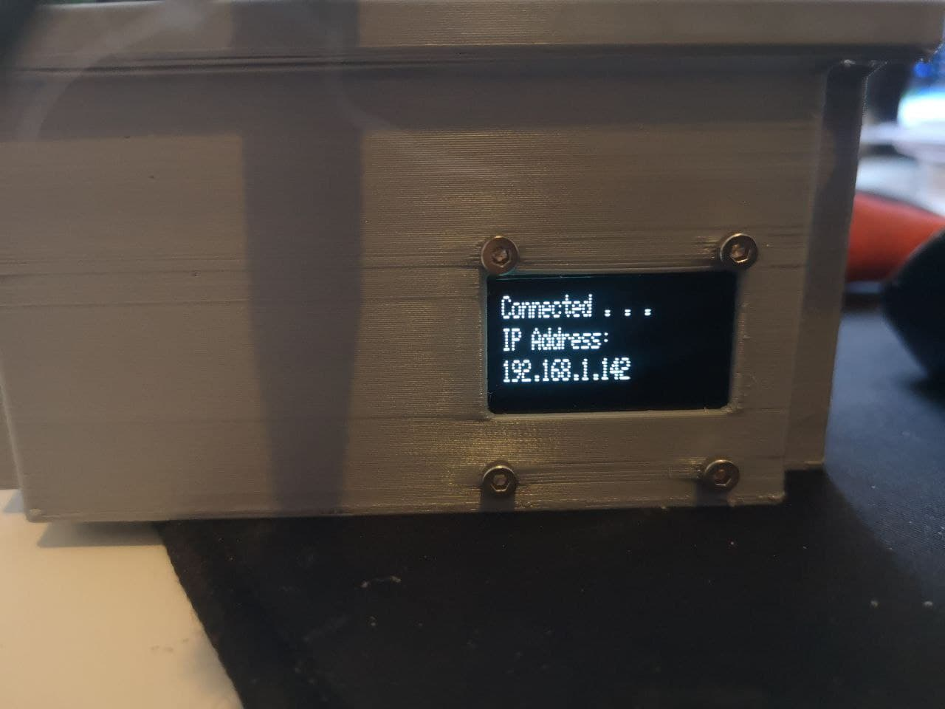
docs/Imagenes/results/ole1.jpg
