juandiz/SCARMOV_1.0/docs/Imagenes/results/ole2.jpg

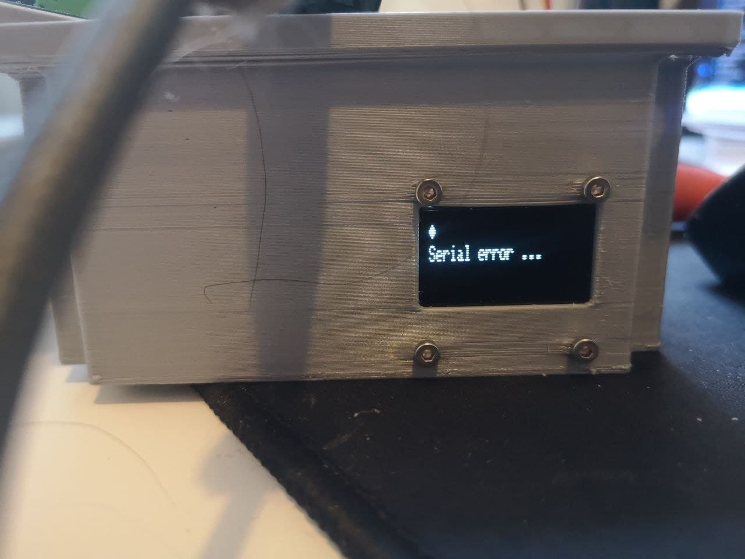
docs/Imagenes/results/ole2.jpg
