juandiz/SCARMOV_1.0/docs/Imagenes/results/PCBOX.jpg

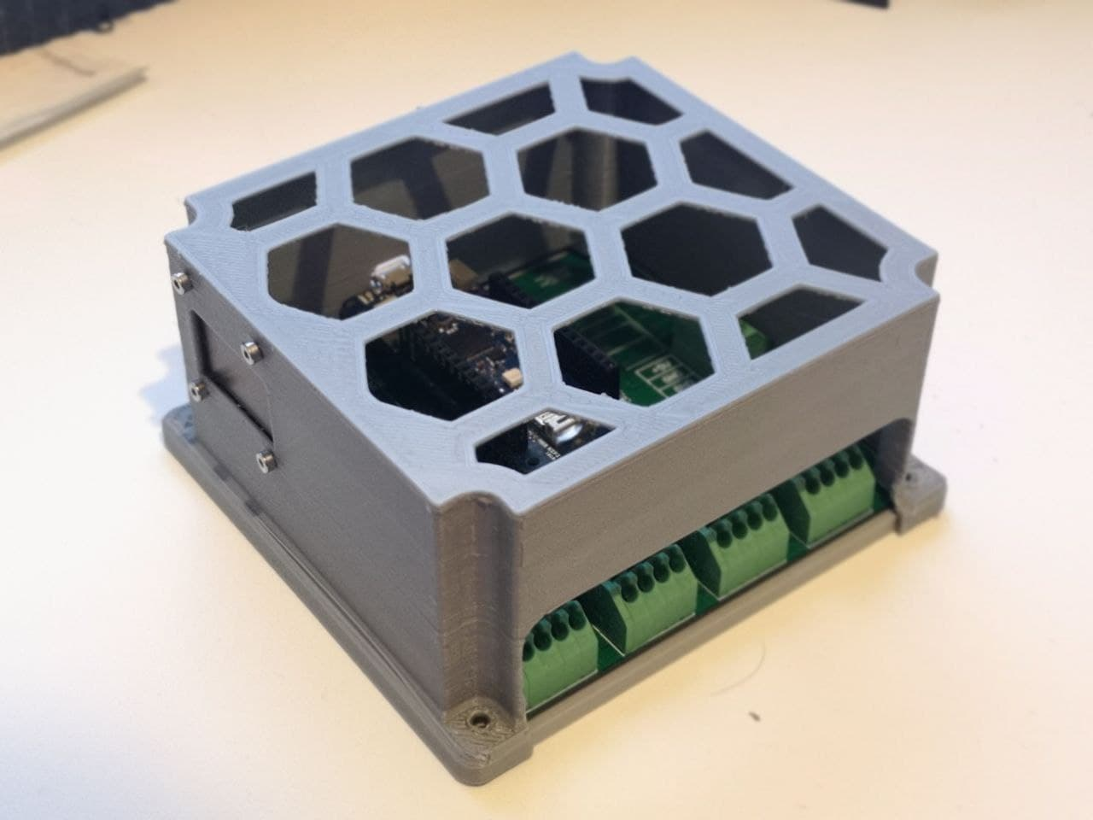
docs/Imagenes/results/PCBOX.jpg
