juandiz/SCARMOV_1.0/docs/Imagenes/results/PCBOX_bot.jpg

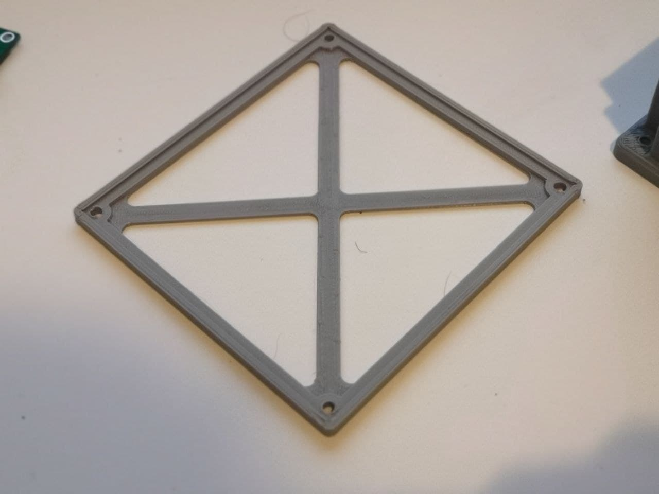
docs/Imagenes/results/PCBOX_bot.jpg
