juandiz/SCARMOV_1.0/docs/Imagenes/results/PCBOX_TOP.jpg

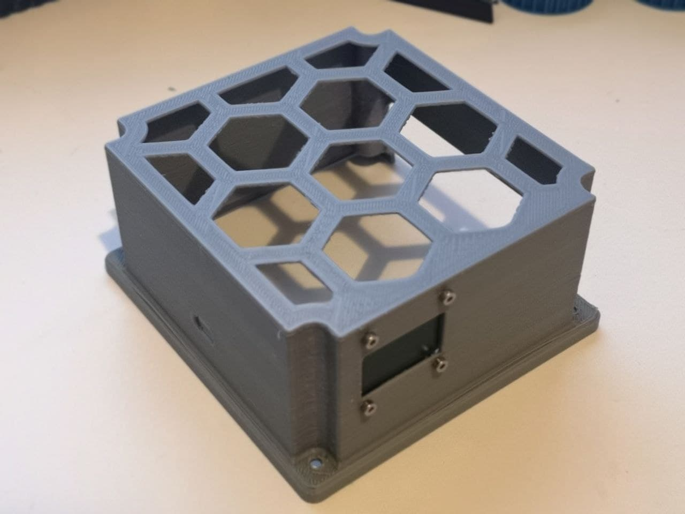
docs/Imagenes/results/PCBOX_TOP.jpg
