juandiz/SCARMOV_1.0/docs/Imagenes/results/Picture1.png

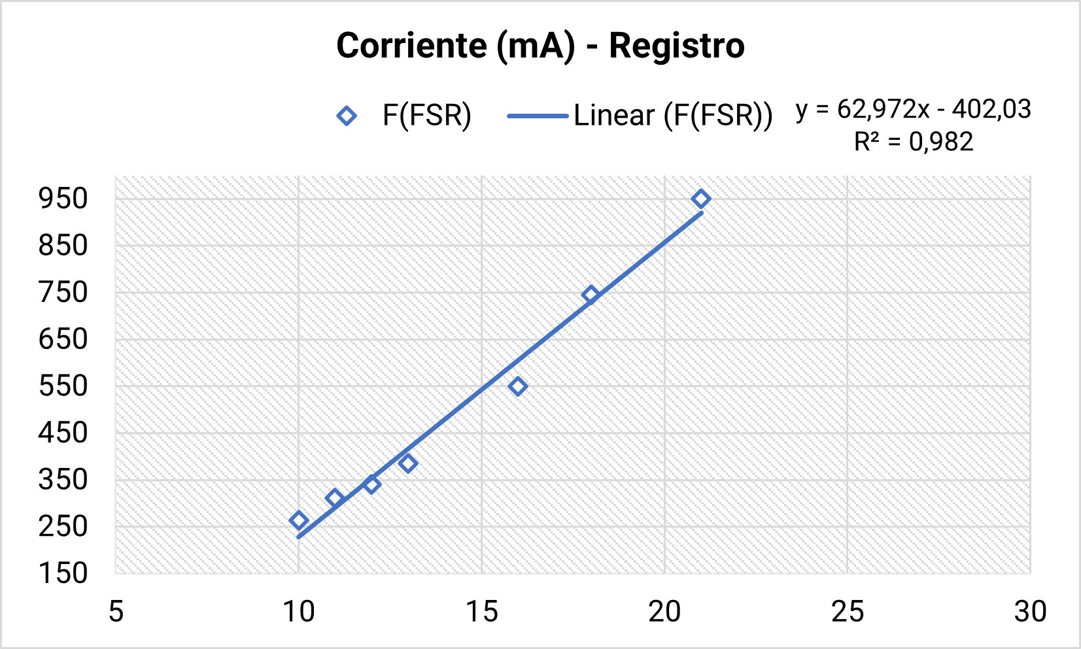
docs/Imagenes/results/Picture1.png
