juandiz/SCARMOV_1.0/docs/Imagenes/results/poleaesb2.jpg

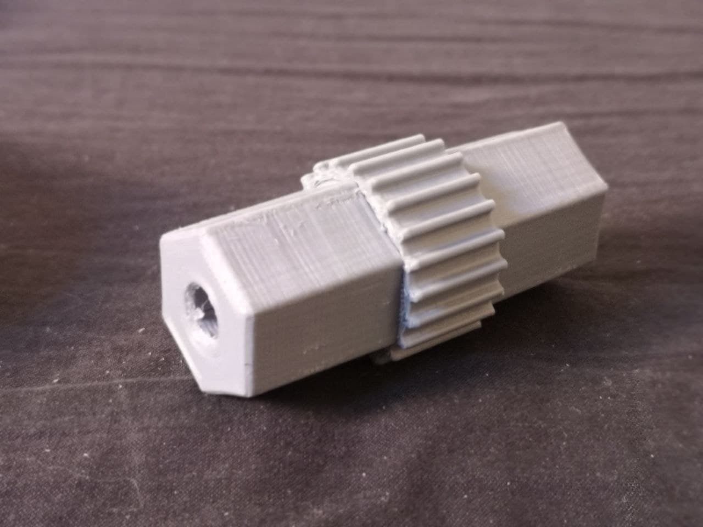
docs/Imagenes/results/poleaesb2.jpg
