juandiz/SCARMOV_1.0/docs/Imagenes/results/poleas2.jpg

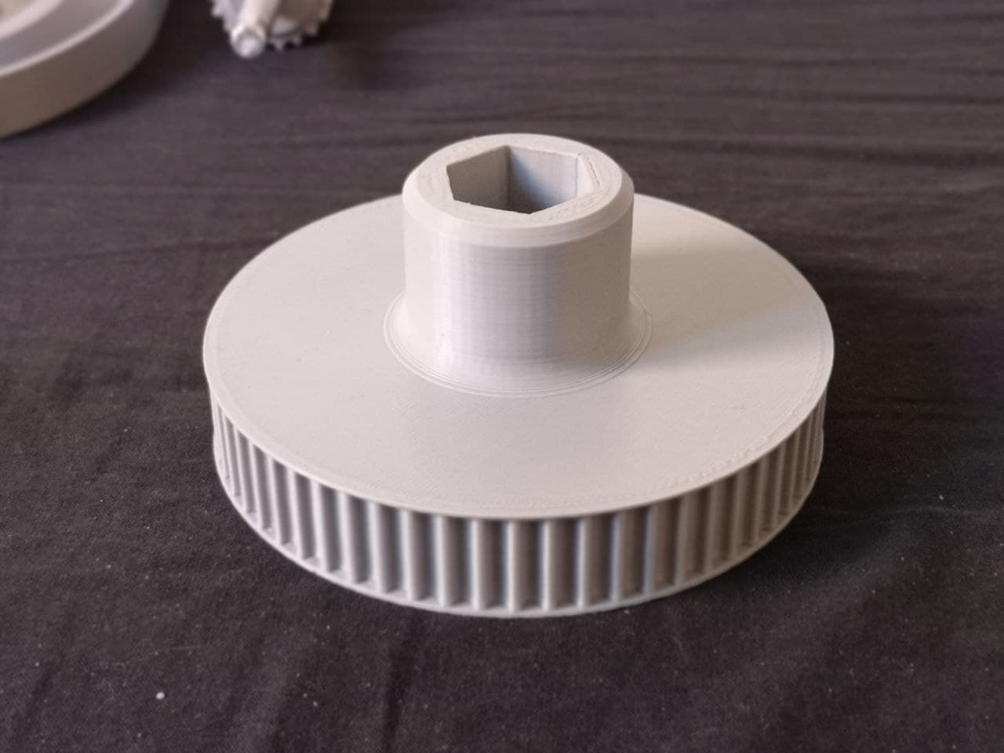
docs/Imagenes/results/poleas2.jpg
