juandiz/SCARMOV_1.0/docs/Imagenes/results/poleas3.jpg

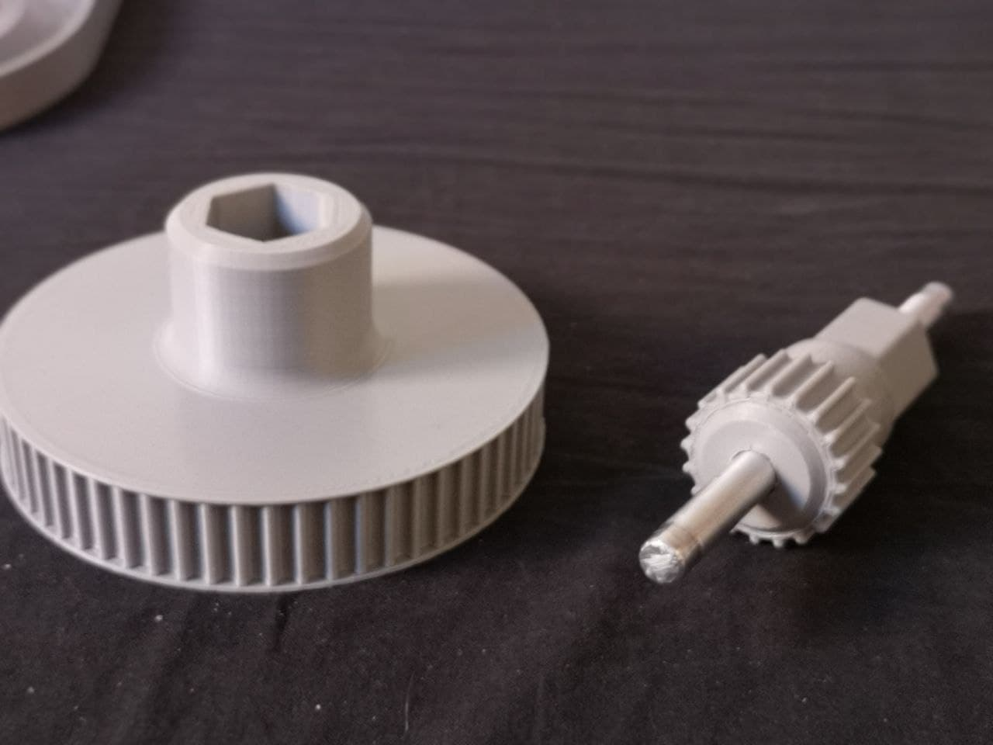
docs/Imagenes/results/poleas3.jpg
