juandiz/SCARMOV_1.0/docs/Imagenes/results/poleas 4.jpg

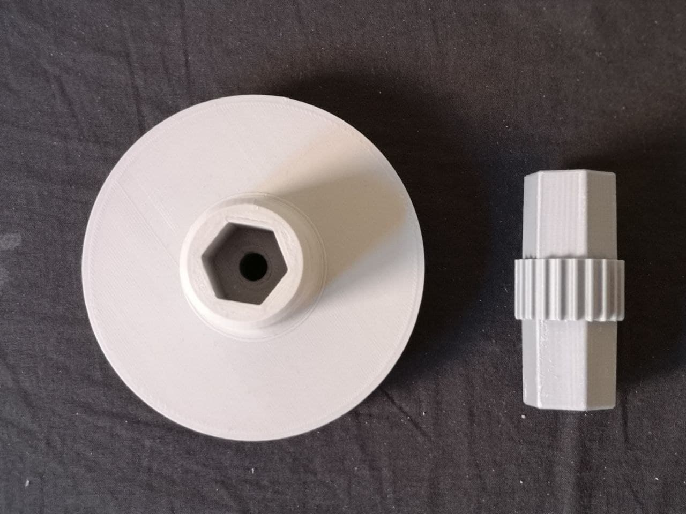
docs/Imagenes/results/poleas 4.jpg
