juandiz/SCARMOV_1.0/docs/Imagenes/results/poleas.jpg

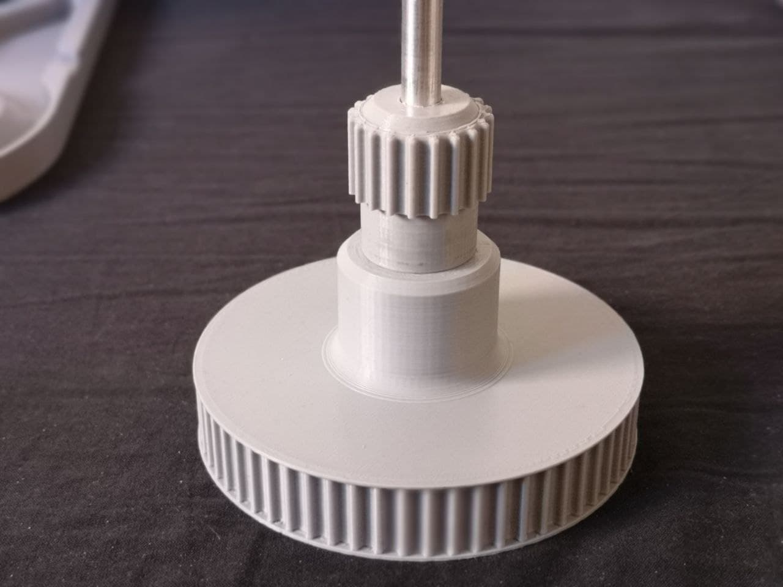
docs/Imagenes/results/poleas.jpg
