juandiz/SCARMOV_1.0/docs/Imagenes/results/PULT5.jpg

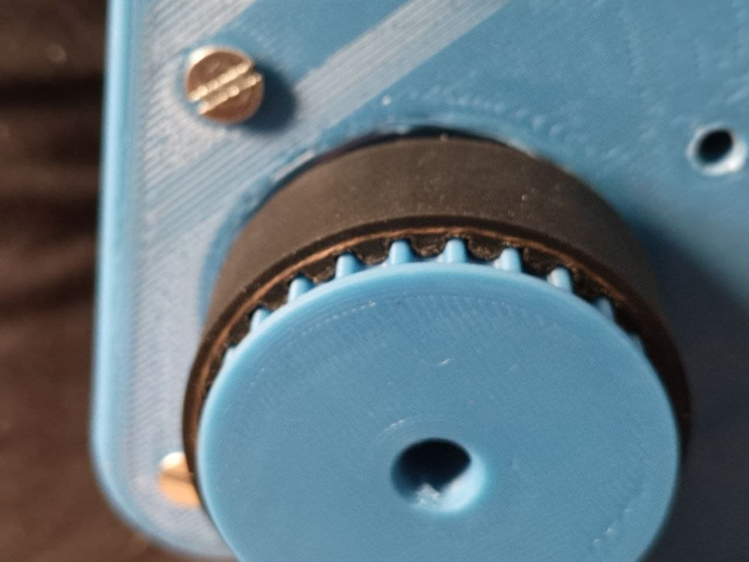
docs/Imagenes/results/PULT5.jpg
