juandiz/SCARMOV_1.0/docs/Imagenes/results/PulT5_2.jpg

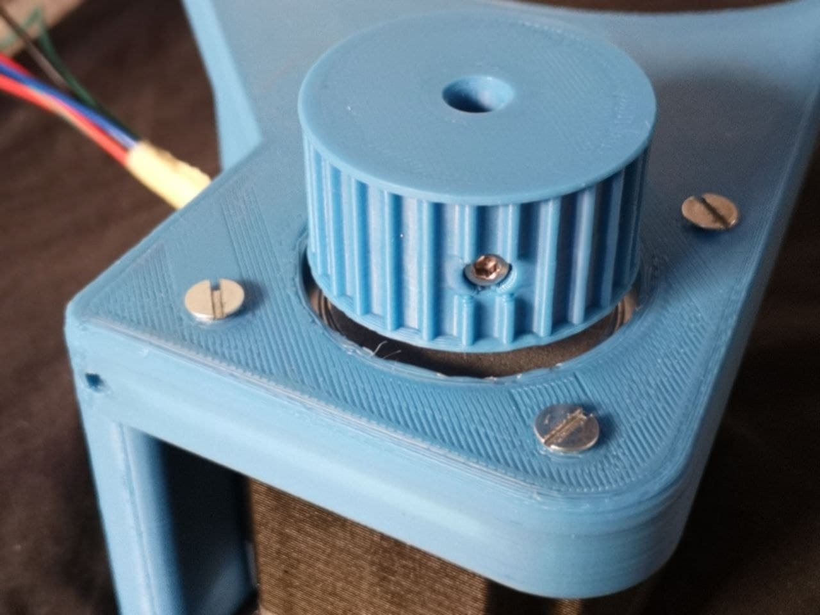
docs/Imagenes/results/PulT5_2.jpg
