juandiz/SCARMOV_1.0/docs/Imagenes/results/robotsinbase2.jpg

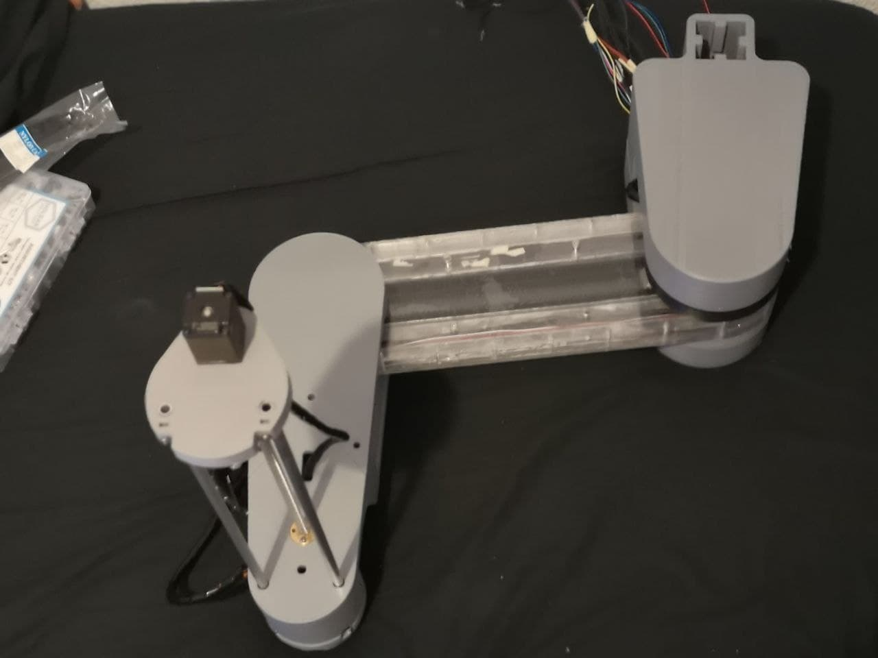
docs/Imagenes/results/robotsinbase2.jpg
