juandiz/SCARMOV_1.0/docs/Imagenes/results/robotsinbase.jpg

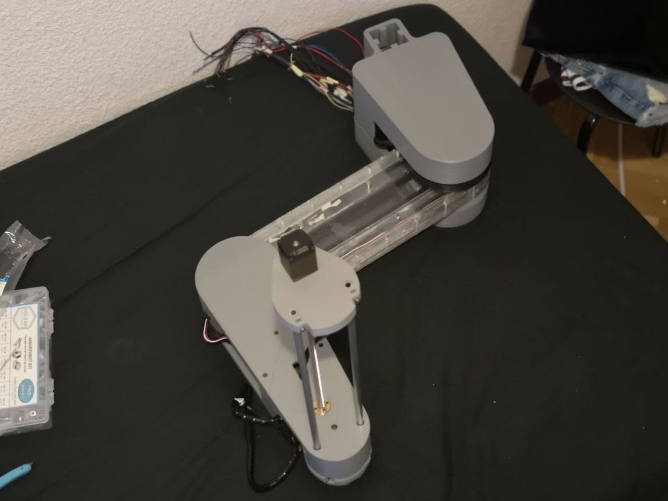
docs/Imagenes/results/robotsinbase.jpg
