juandiz/SCARMOV_1.0/docs/Imagenes/results/robotsinbase_top2.jpg

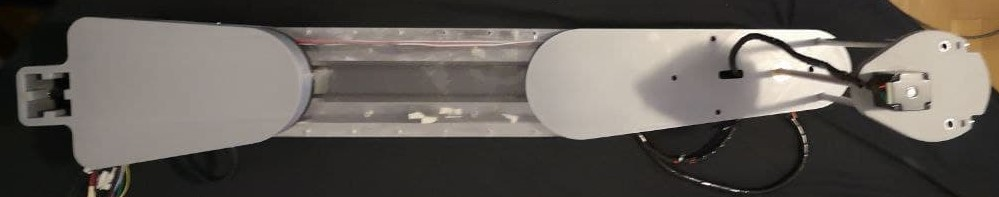
docs/Imagenes/results/robotsinbase_top2.jpg
