juandiz/SCARMOV_1.0/docs/Imagenes/results/robotsinbase_top.jpg

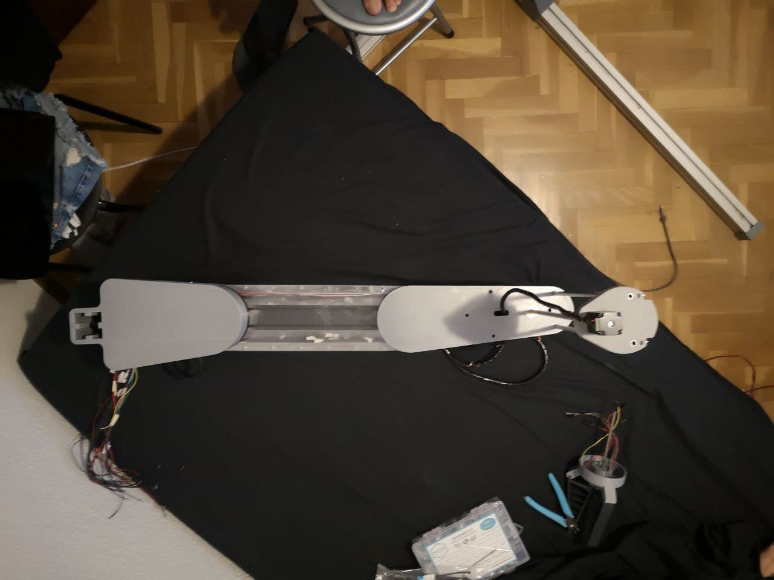
docs/Imagenes/results/robotsinbase_top.jpg
