juandiz/SCARMOV_1.0/docs/Imagenes/results/sg1.jpg

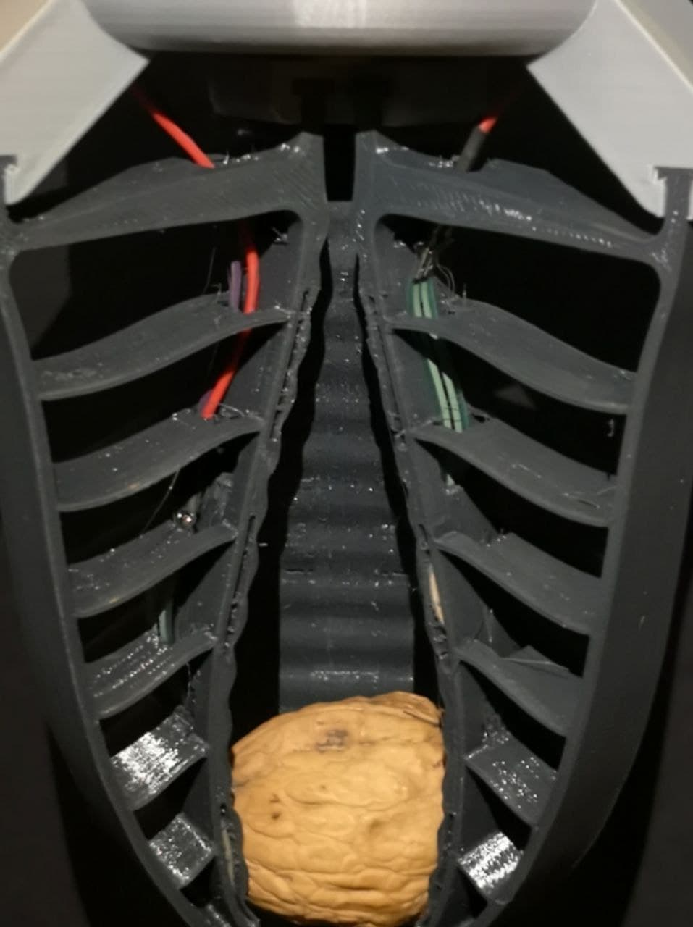
docs/Imagenes/results/sg1.jpg
