juandiz/SCARMOV_1.0/docs/Imagenes/results/sg2.jpg

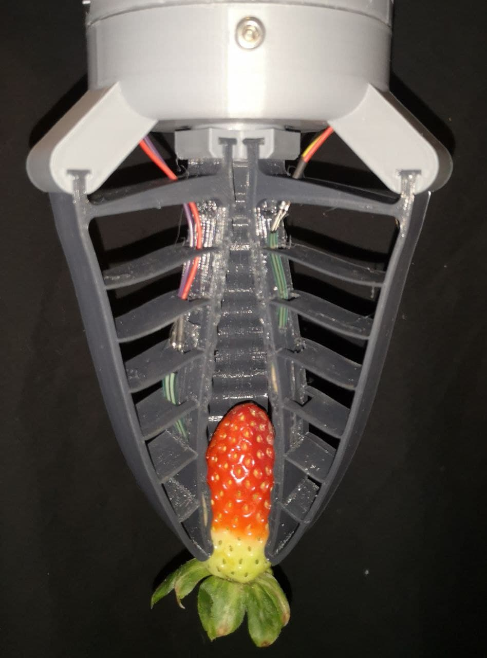
docs/Imagenes/results/sg2.jpg
