juandiz/SCARMOV_1.0/docs/Imagenes/results/sg3.jpg

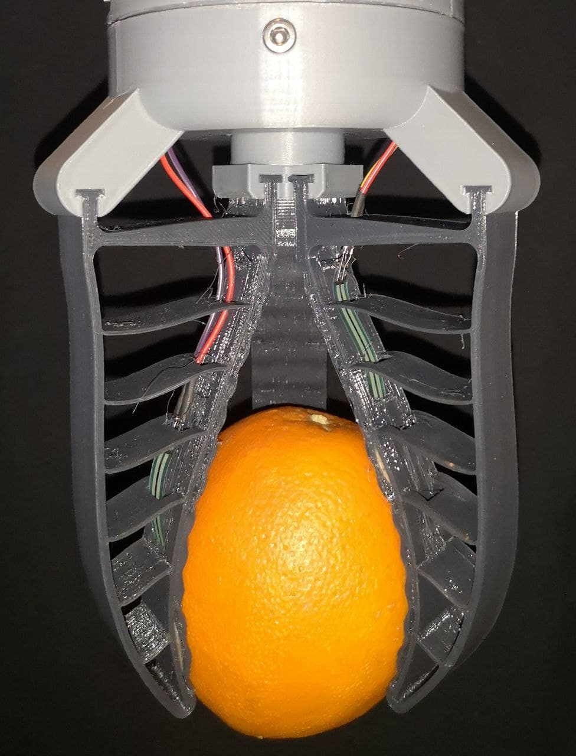
docs/Imagenes/results/sg3.jpg
