juandiz/SCARMOV_1.0/docs/Imagenes/results/sg4.jpg

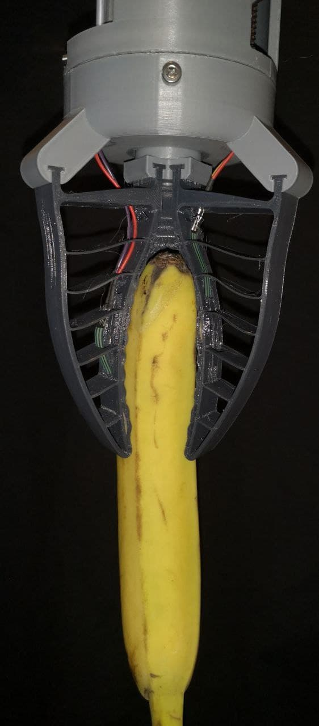
docs/Imagenes/results/sg4.jpg
