juandiz/SCARMOV_1.0/docs/Imagenes/results/sg5.jpg

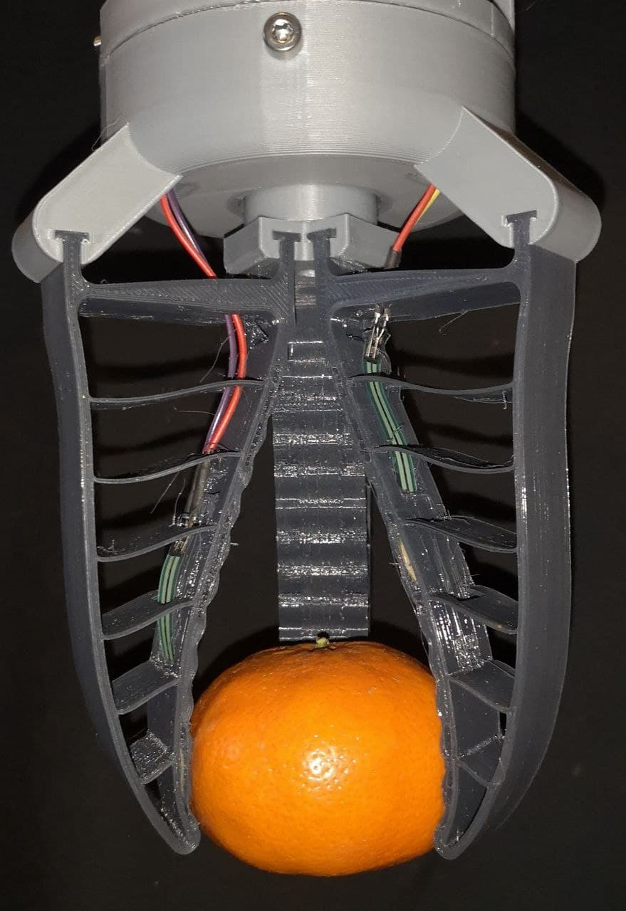
docs/Imagenes/results/sg5.jpg
