juandiz/SCARMOV_1.0/docs/Imagenes/results/sg6.jpg

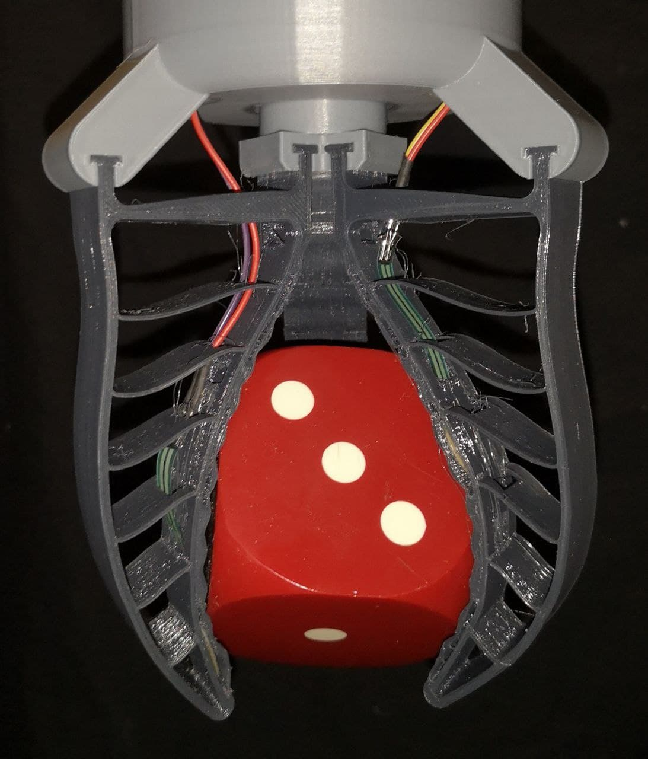
docs/Imagenes/results/sg6.jpg
