juandiz/SCARMOV_1.0/docs/Imagenes/results/sg7.jpg

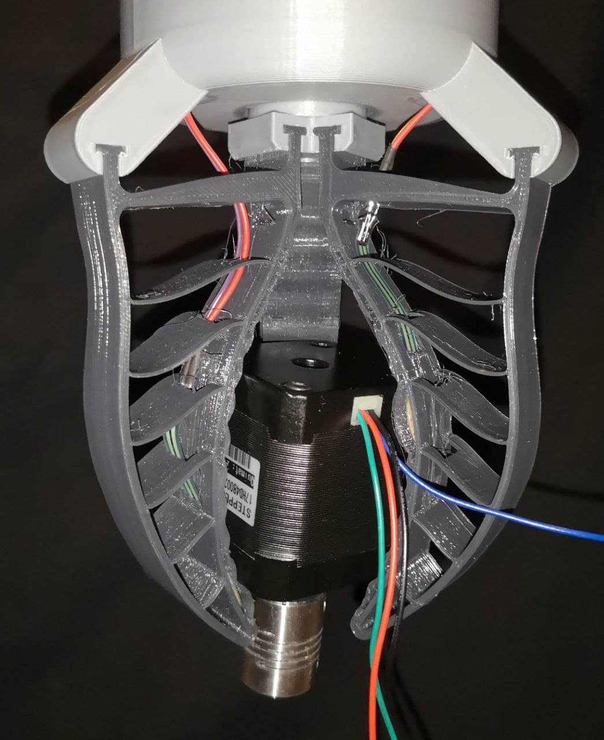
docs/Imagenes/results/sg7.jpg
