juandiz/SCARMOV_1.0/docs/Imagenes/results/sg8.jpg

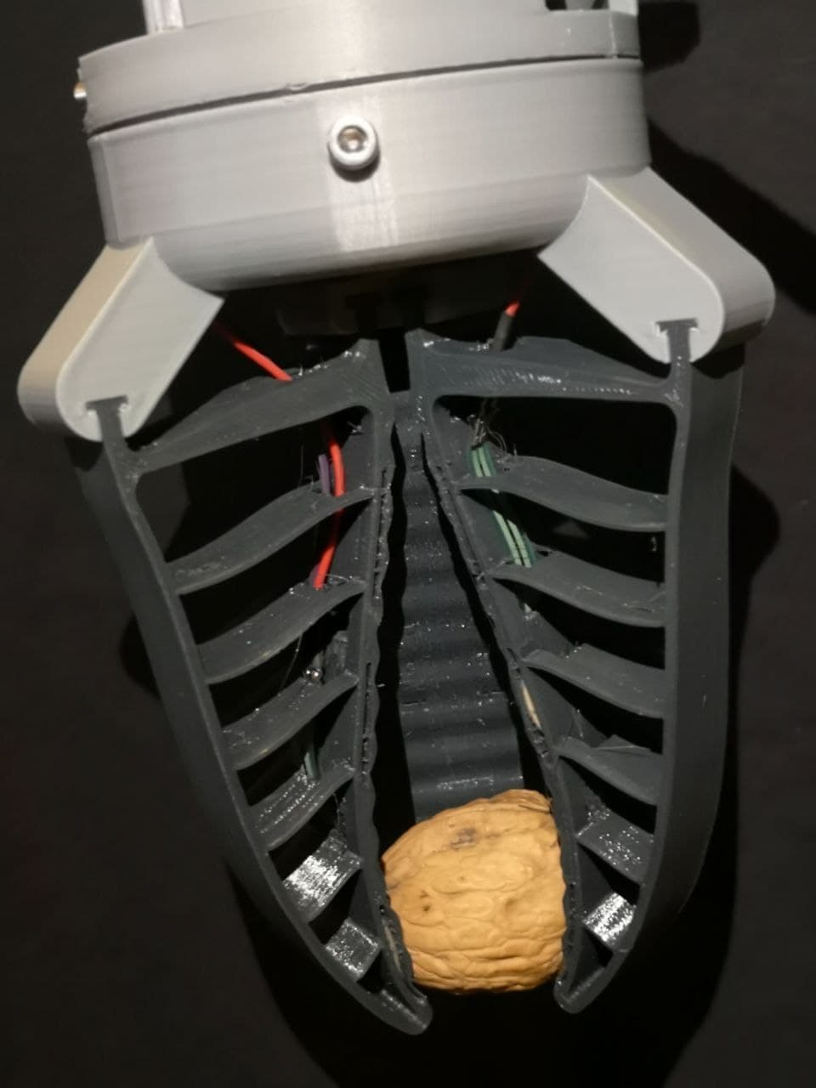
docs/Imagenes/results/sg8.jpg
