juandiz/SCARMOV_1.0/docs/Imagenes/results/SG.jpg

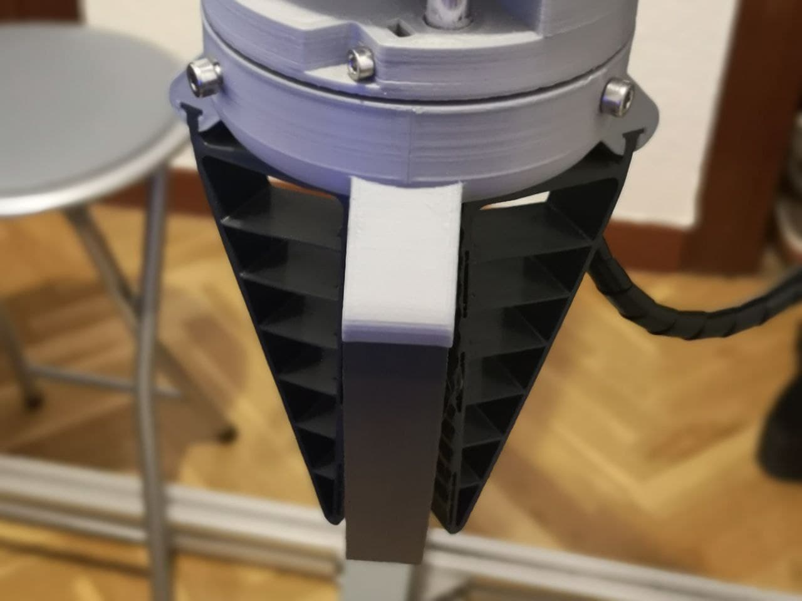
docs/Imagenes/results/SG.jpg
