juandiz/SCARMOV_1.0/docs/Imagenes/results/sgflex2.jpg

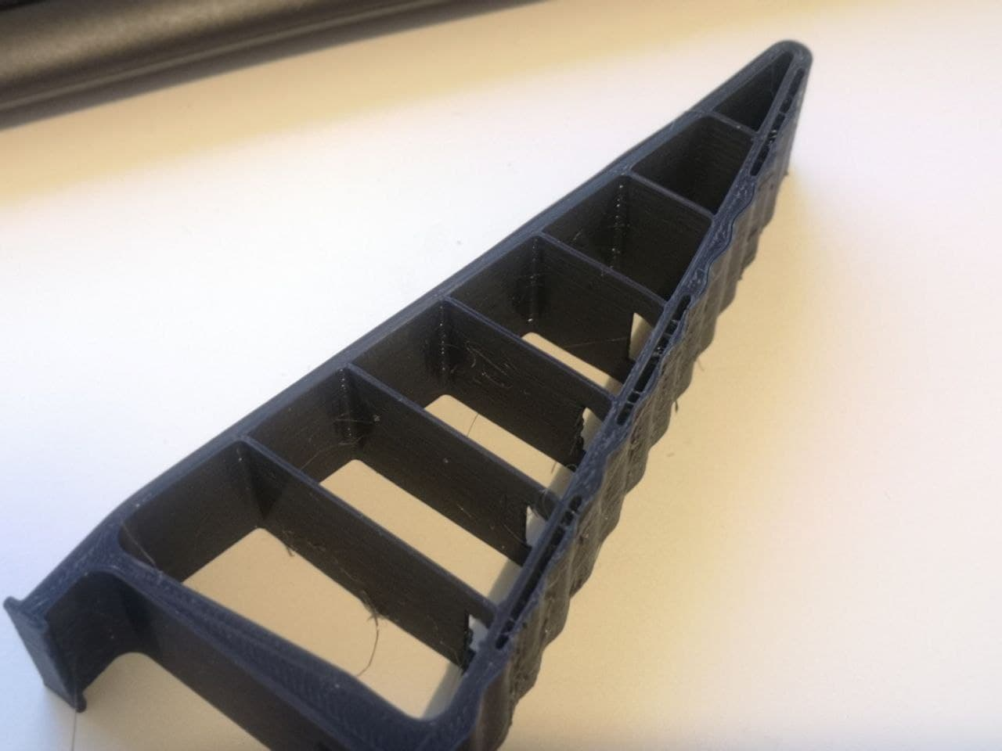
docs/Imagenes/results/sgflex2.jpg
