juandiz/SCARMOV_1.0/docs/Imagenes/results/sgflex.jpg

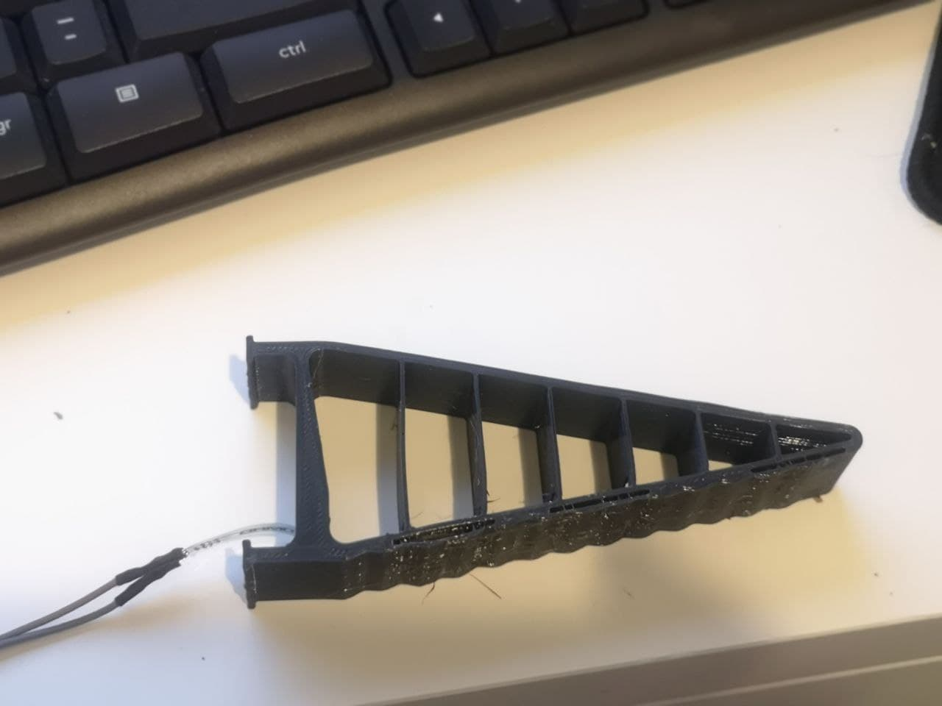
docs/Imagenes/results/sgflex.jpg
