juandiz/SCARMOV_1.0/docs/Imagenes/results/sujecionabase.jpg

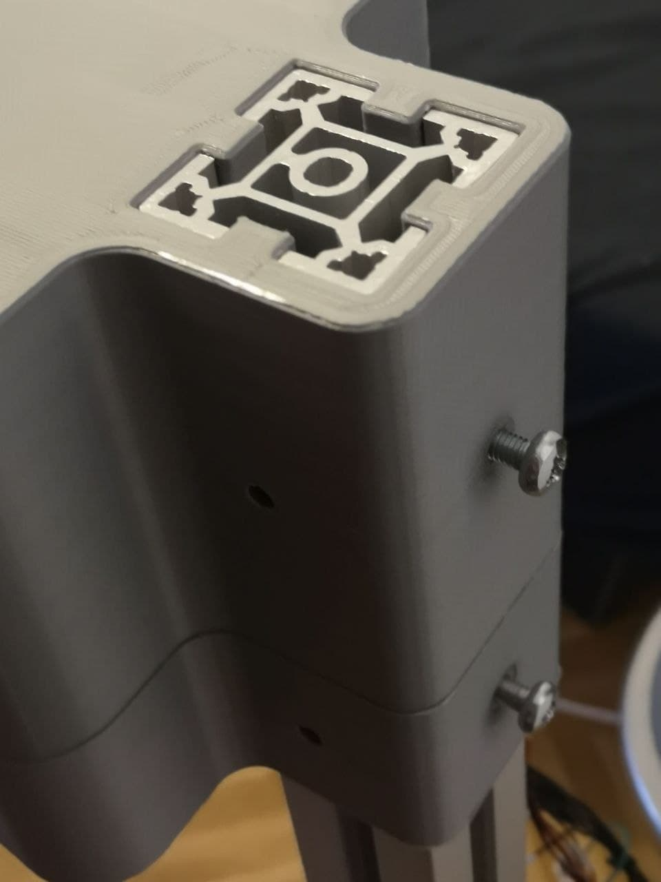
docs/Imagenes/results/sujecionabase.jpg
