juandiz/SCARMOV_1.0/docs/Imagenes/results/sujeción SG.jpg

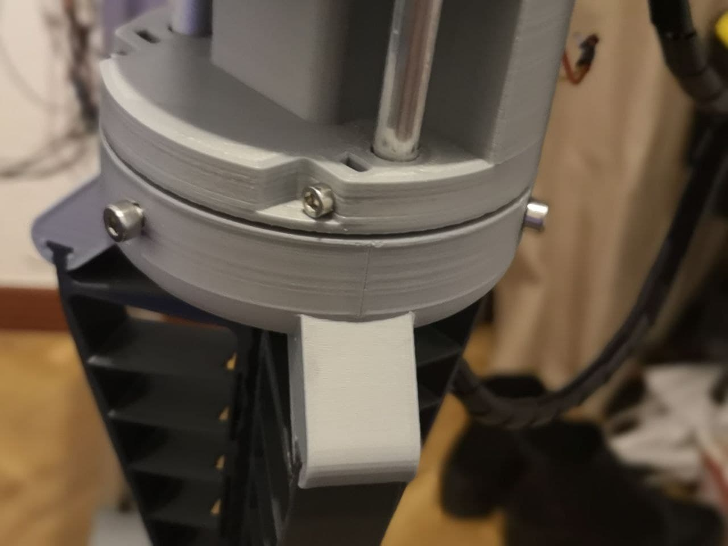
docs/Imagenes/results/sujeción SG.jpg
