juandiz/SCARMOV_1.0/docs/Imagenes/results/top_pefil.PNG

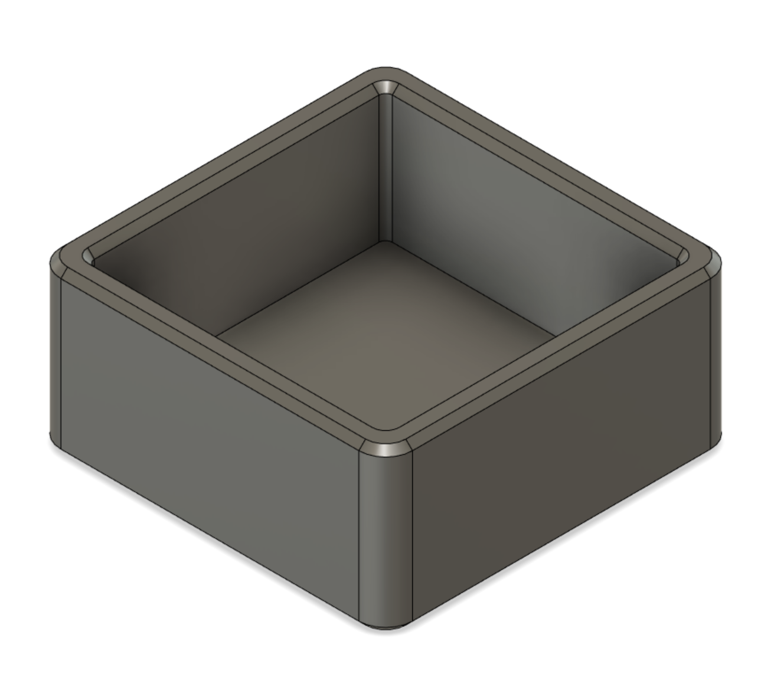
docs/Imagenes/results/top_pefil.PNG
