juandiz/SCARMOV_1.0/Desing/PCB/sqm1.pdf

## Encoder headers

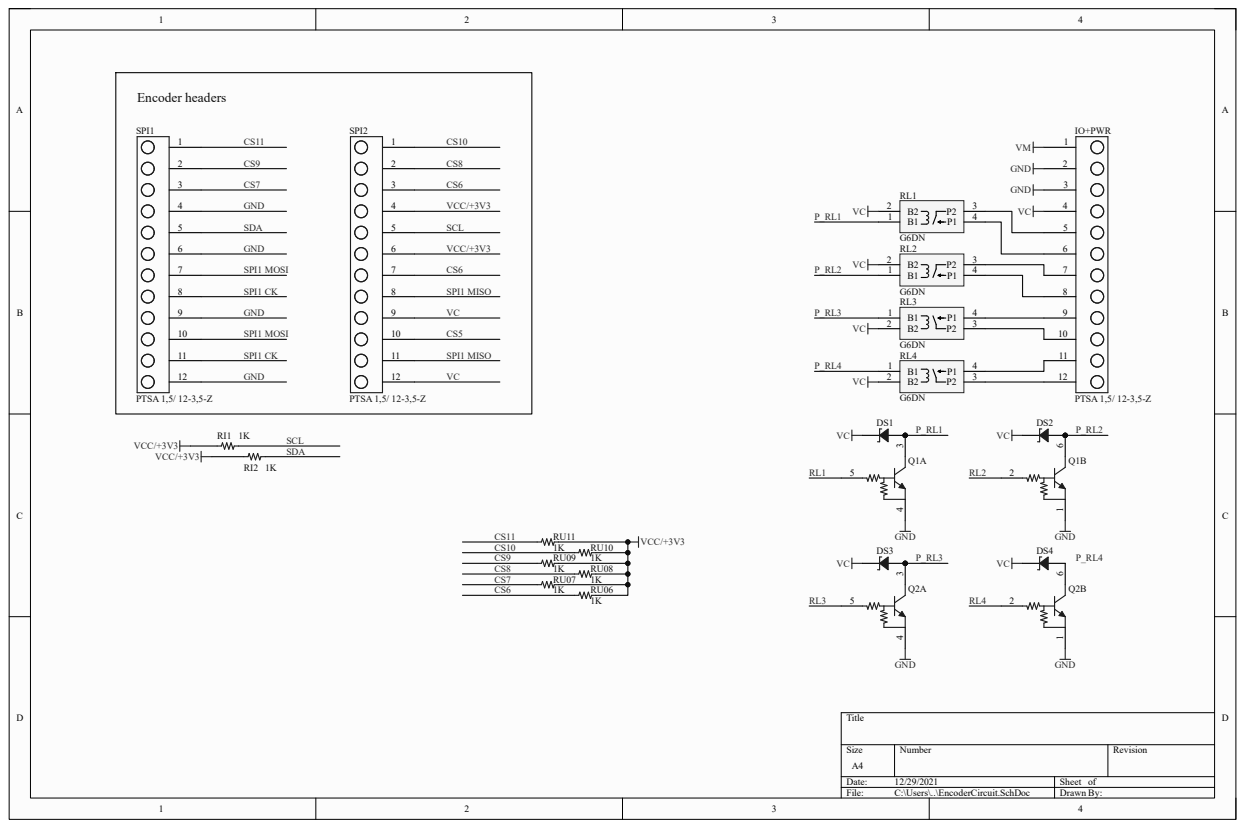
[picture p337: page 1]
Title; Size; Number; Revision; Date:; Sheet of; File:; C:\Users\..\EncoderCircuit.SchDoc; Drawn By:; SPI1; PTSA 1,5/ 12-3,5-Z; SPI2; GND; IO+PWR; SCL RI1 1K; VCC/+3V3; SDA; SPI1 MOSI; SPI1 MISO; SPI1 CK; SCL
