juandiz/SCARMOV_1.0/Desing/PCB/sqm2.pdf

## Motor drivers ARDUINO

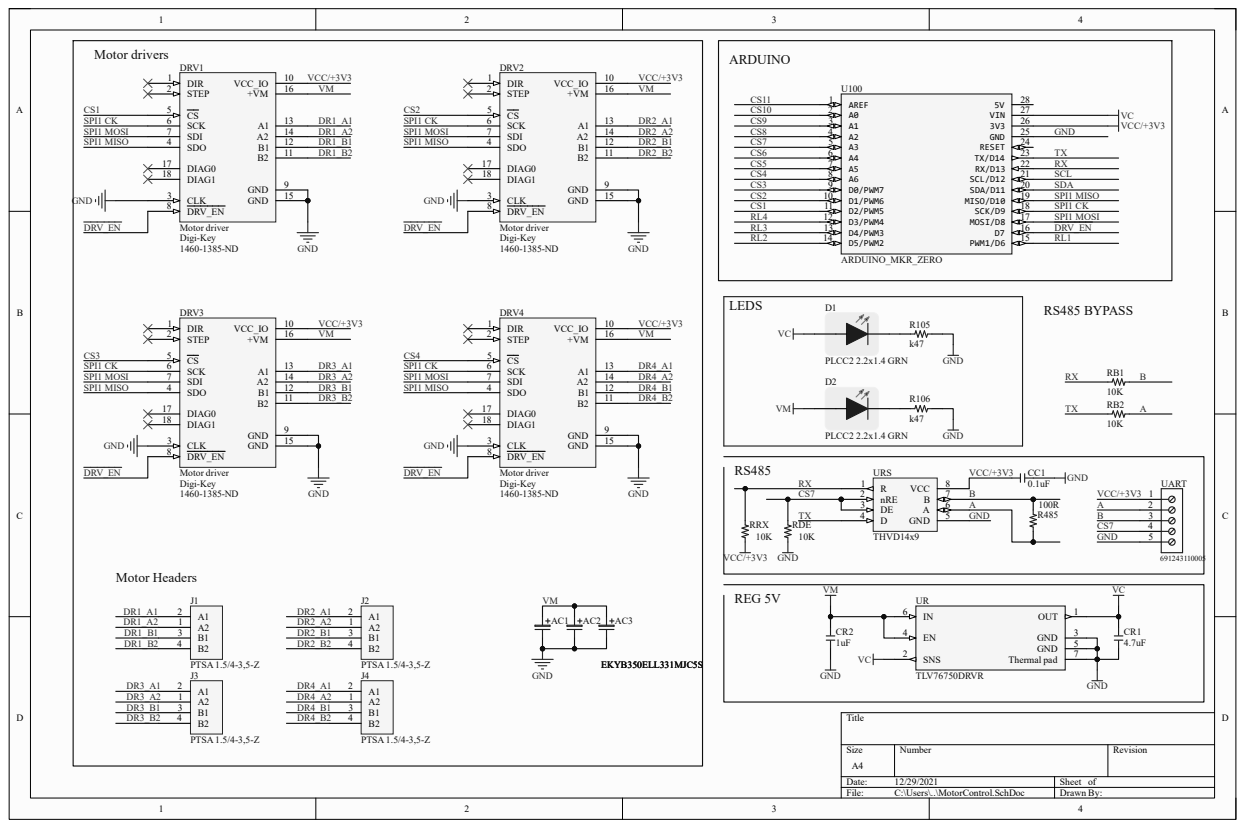
[picture p338: page 1]
