juandiz/SCARMOV_1.0/docs/Imagenes/anexos/holder.pdf

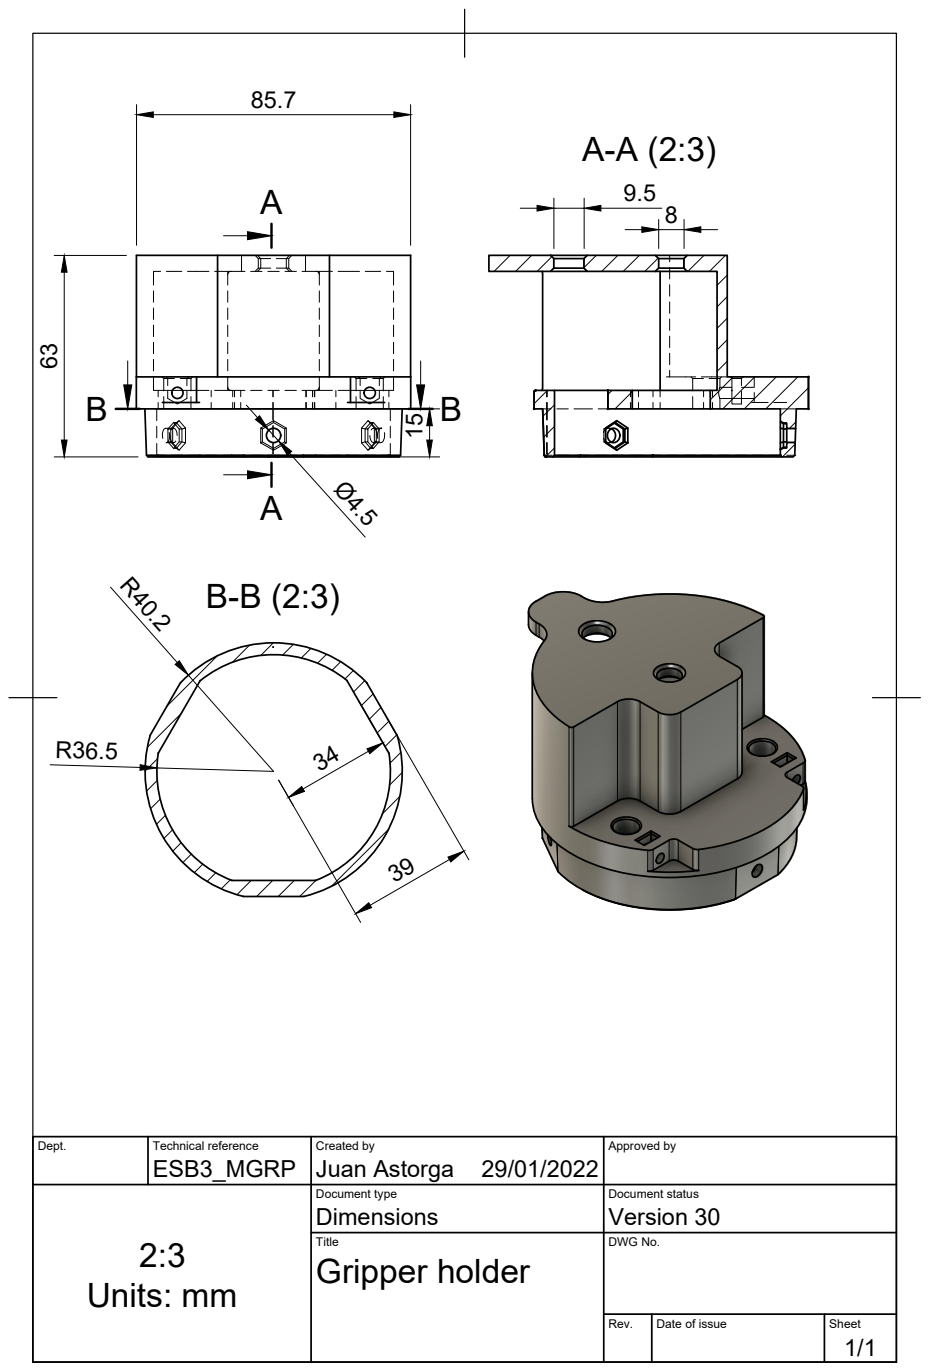
[picture p339: page 1]

Dept. | Technical reference ESB3_MGRP | Created by Juan Astorga 29/01/2022 | Approved by

2:3 Units: mm | | Document type Dimensions | Document status Version 30

Title Gripper holder | DWG No.

Rev. | Date of issue | Sheet 1/1
