juandiz/SCARMOV_1.0/docs/Imagenes/anexos/dimensions.pdf

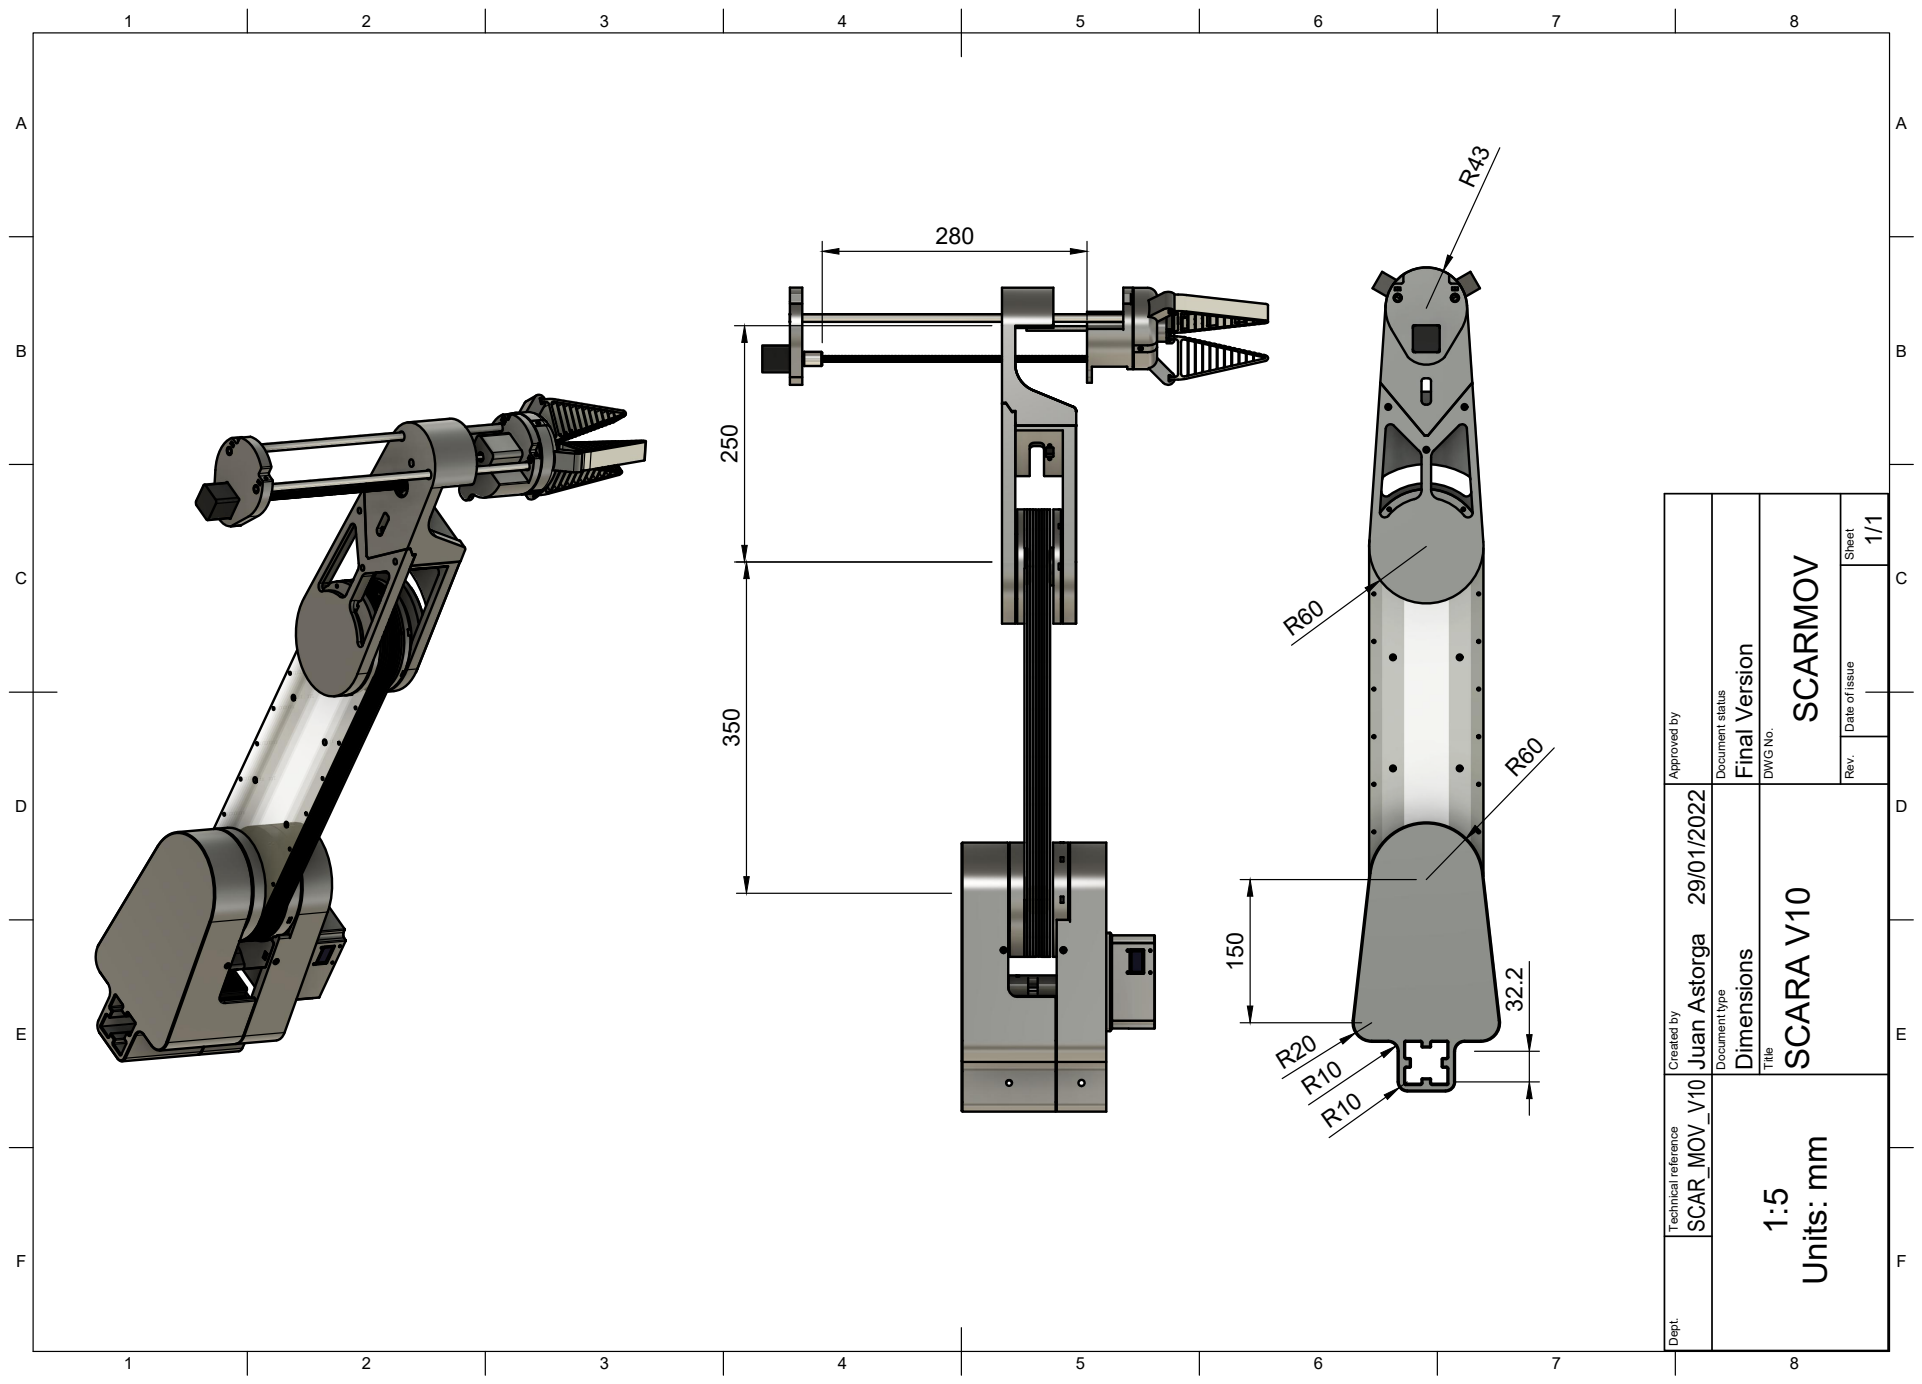
[picture p340: page 1]
8 BCDEF; ABCDEF Dept. Technical reference Created by Approved by; Document type Document status; Title DWG No.; Rev. Date of issue Sheet Final Version Dimensions 29/01/2022; 1/1 SCARMOV Juan Astorga; SCARA V10 SCAR_MOV_V10 350 250; 1:5 Units: mm
