juandiz/SCARMOV_1.0/code/ArduinoControl_TFG/TRINAMIC_PORTING.h

/*
 * TRINAMIC_PORTING.h
 *
 *  Created on: Nov 8, 2018
 *      Author: pasto
 */

#ifndef TRINAMIC_PORTING_H_
#define TRINAMIC_PORTING_H_

#include "helpers/API_Header.h"

void tcm5160_init();

// TMC5160 SPI wrapper
void tmc5160_writeDatagram(uint8 motor, uint8 address, uint8 x1, uint8 x2, uint8 x3, uint8 x4);
void tmc5160_writeInt(uint8 motor, uint8 address, int value);
int tmc5160_readInt(u8 motor, uint8 address);

// General SPI functions
void tmc40bit_writeInt(u8 motor, uint8 address, int value);
int tmc40bit_readInt(u8 motor, uint8 address);


#endif /* TRINAMIC_PORTING_H_ */
