juandiz/SCARMOV_1.0/code/GUI/V13/Commands.py

# Name of command 

GRIPPER_CONFIG = 1001
MSG_RECEIVED = 1002
SEND_VEL = 1003
SEND_POS = 1010
GO_HOME = 1004
NEW_POS = 1005
NEW_HOME = 1006
SAVE_POS = 1007
OPEN_GRIPPER = 1008
CLOSE_GRIPPER = 1009
SEND_PCKG   = 1010
TOGGLE_ROBOT_EN = 1012
CONNECT = 2001
CALCULATE_MOVE = 3001

KILL_THRD = 4001

# JSON commands

CMD_MOTOR_EN            = 5012
CMD_MOTOR_DIS           = 5011
CMD_RESET_MOTORS        = 5000
CMD_SETVELOCITIES       = 5004
CMD_SETPOSITIONS        = 5002
CMD_GRIPPER_OPEN        = 5007
CMD_GRIPPER_CLOSE       = 5003
CMD_STOP_EMERGENCY      = 5010
CMD_GO_HOME             = 5011
CMD_SET_ACTUAL_POS      = 5020
CMD_SET_CURRENT_REG     = 5030

# Data file

SAVE_NEW_IP                 = 6001
SET_ROBOT_PARAMS            = 6002
SET_CONNECTION_MODE         = 6003
SET_COMMUNICATION_SETTINGS  = 6004
